ssbingo/samba-solar-track/hardware/RearCircuitBoard_10/vorschau/RearCircuitBoard_10-schraeg.png

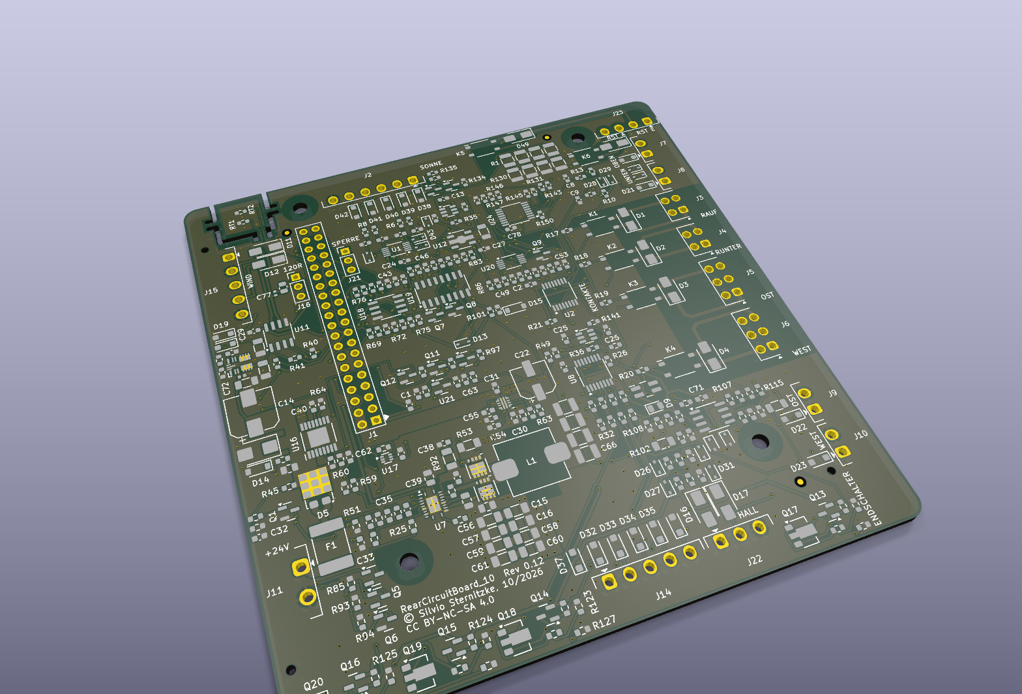
hardware/RearCircuitBoard_10/vorschau/RearCircuitBoard_10-schraeg.png
