ssbingo/samba-solar-track/hardware/HallTapBoard/vorschau/HallTapBoard-unten.png

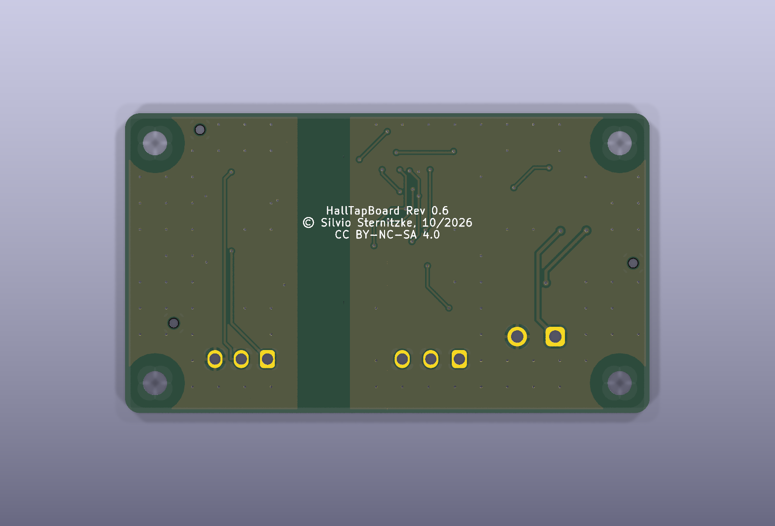
hardware/HallTapBoard/vorschau/HallTapBoard-unten.png
