ssbingo/samba-solar-track/hardware/RearCircuitBoard_10/fertigung/smd/RearCircuitBoard_10-selbst-bestellen.md

# RearCircuitBoard_10 - selbst zu bestellende Teile (Bestückungsvariante smd)

Platine Entwurf 0.12; erzeugt am 09.11.2026 20:07 mit tools/fertigung_export.py. Alles, was JLCPCB in der Variante smd nicht bestückt: Durchsteckteile (aus der Platine gezählt), die Stecker zu jeder Klemme, Steckbrücken, J1 und die Mechanik. JLCPCB liefert keine losen Teile mit; bei LCSC bestellen und mit dem JLCPCB-Auftrag zusammenlegen, oder bei einem Händler mit Lieferung an Privatkunden (Alternative je Zeile; deren Preise brutto, abgerufen am 7.10.2026, wenn nicht anders genannt). Mengen je Platine; bei LCSC gilt die Mindestmenge.

| Bezeichner | Menge je Platine | Typ | Hersteller-Nr. | LCSC-Nr. | Bezugsquelle und Preis | Hinweis |
|---|---|---|---|---|---|---|
| J2 | 1 | Grundleiste (Durchsteckteil) | KF2EDGR-3.5-6P | C441175 | LCSC/JLCPCB 0,1610 USD je Stück (JLCPCB-Teilebibliothek, abgefragt am 05.11.2026 05:26; Bestand 2487, Mindestmenge 2); Alternative: Reichelt MC 6 G 3,5 (Phoenix 1844252), 1,50 € | Nur Variante smd: von Hand einlöten (in der Variante voll lötet JLCPCB). |
| J3, J4 | 2 | Grundleiste (Durchsteckteil) | KF2EDGSR-3.5-2*2P | C2923260 | LCSC/JLCPCB 0,5806 USD je Stück (JLCPCB-Teilebibliothek, abgefragt am 05.11.2026 05:26; Bestand 773, Mindestmenge 2); Alternative: DigiKey DMC 1,5/2-G1-3,5 P20THR (Phoenix 1786837), 1,23 € netto | Nur Variante smd: von Hand einlöten (in der Variante voll lötet JLCPCB). |
| J5, J6 | 2 | Grundleiste (Durchsteckteil) | KF2EDGSR-3.5-2*3P | C2923261 | LCSC/JLCPCB 0,8390 USD je Stück (JLCPCB-Teilebibliothek, abgefragt am 05.11.2026 05:26; Bestand 1289, Mindestmenge 2); Alternative: DigiKey DMC 1,5/3-G1-3,5 P20THR (Phoenix 1786840), 1,91 € (Annahme netto); Bürklin 62P6910, 2,38 € | Nur Variante smd: von Hand einlöten (in der Variante voll lötet JLCPCB). |
| J7, J8, J9, J10 | 4 | Grundleiste (Durchsteckteil) | KF2EDGR-3.5-2P | C441171 | LCSC/JLCPCB 0,0501 USD je Stück (JLCPCB-Teilebibliothek, abgefragt am 05.11.2026 05:26; Bestand 6160, Mindestmenge 2); Alternative: Reichelt MC 2 G 3,5 (Phoenix 1844210), 0,58 € | Nur Variante smd: von Hand einlöten (in der Variante voll lötet JLCPCB). |
| J11 | 1 | Grundleiste (Durchsteckteil) | KF2EDGRC-5.08-2P | C441236 | LCSC/JLCPCB 0,0596 USD je Stück (JLCPCB-Teilebibliothek, abgefragt am 05.11.2026 05:26; Bestand 19010, Mindestmenge 2); Alternative: Reichelt MSTBA 2-G 5,08 (Phoenix 1757242), 0,60 € | Nur Variante smd: von Hand einlöten (in der Variante voll lötet JLCPCB). |
| J14 | 1 | Grundleiste (Durchsteckteil) | KF2EDGR-3.5-5P | C441174 | LCSC/JLCPCB 0,1263 USD je Stück (JLCPCB-Teilebibliothek, abgefragt am 05.11.2026 05:26; Bestand 3099, Mindestmenge 2); Alternative: Reichelt MC 5 G 3,5 (Phoenix 1844249), 1,25 € | Nur Variante smd: von Hand einlöten (in der Variante voll lötet JLCPCB). |
| J15 | 1 | Grundleiste (Durchsteckteil) | KF2EDGR-3.81-5P | C441185 | LCSC/JLCPCB 0,1469 USD je Stück (JLCPCB-Teilebibliothek, abgefragt am 05.11.2026 05:26; Bestand 4801, Mindestmenge 2); Alternative: Reichelt MC 5 G 3,81 (Phoenix MC 1,5/ 5-G-3,81), Preis offen | Nur Variante smd: von Hand einlöten (in der Variante voll lötet JLCPCB). |
| J16, J21 | 2 | Stiftleiste 1 x 3, Raster 2,54 mm | PZ254V-11-03P | C2937625 | LCSC/JLCPCB 0,0198 USD je Stück (JLCPCB-Teilebibliothek, abgefragt am 05.11.2026 05:26; Bestand 716137, Mindestmenge 2); Alternative: Reichelt MPE 087-1-003, 0,09 € | Nur Variante smd: von Hand einlöten (in der Variante voll lötet JLCPCB). |
| J22 | 1 | Grundleiste (Durchsteckteil) | KF2EDGR-3.5-3P | C441172 | LCSC/JLCPCB 0,0756 USD je Stück (LCSC-Produktseite, abgefragt am 09.11.2026 20:05; Bestand 10675, Mindestmenge 5); Alternative: Reichelt MC 3 G 3,5 (Phoenix 1844223), 0,87 € | Nur Variante smd: von Hand einlöten (in der Variante voll lötet JLCPCB). |
| J23 | 1 | Grundleiste (Durchsteckteil) | KF2EDGR-3.5-4P | C441173 | LCSC/JLCPCB 0,1110 USD je Stück (LCSC-Produktseite, abgefragt am 09.11.2026 20:05; Bestand 9055, Mindestmenge 5); Alternative: Reichelt MC 4 G 3,5 (Phoenix 1844236), 0,99 € (abgerufen 09.11.2026) | Nur Variante smd: von Hand einlöten (in der Variante voll lötet JLCPCB). |
| J7, J8, J9, J10 (Stecker) | 4 | Stecker mit Schraubanschluss | KF2EDGK-3.5-2P | C440847 | LCSC/JLCPCB 0,2136 USD je Stück (JLCPCB-Teilebibliothek, abgefragt am 05.11.2026 05:26; Bestand 10380, Mindestmenge 2); Alternative: Reichelt MC 2 ST 3,5 (Phoenix 1840366), 1,40 € | Lose zur Grundleiste KF2EDGR-3.5-2P. |
| J22 (Stecker) | 1 | Stecker mit Schraubanschluss | KF2EDGK-3.5-3P | C440848 | LCSC/JLCPCB 0,2877 USD je Stück (JLCPCB-Teilebibliothek, abgefragt am 05.11.2026 05:26; Bestand 7772, Mindestmenge 2); Alternative: Reichelt MC 3 ST 3,5 (Phoenix 1840379), 1,99 € | Lose zur Grundleiste KF2EDGR-3.5-3P. Gegenstück zum Kabel vom HallTapBoard; ohne Hall-Abgriff bleibt J22 frei. |
| J23 (Stecker) | 1 | Stecker mit Schraubanschluss | KF2EDGK-3.5-4P | C440849 | LCSC/JLCPCB 0,4128 USD je Stück (LCSC-Produktseite, abgefragt am 09.11.2026 20:05; Bestand 14175, Mindestmenge 1); Alternative: Reichelt MC 4 ST 3,5 (Phoenix 1840382), 2,65 € (abgerufen 09.11.2026) | Lose zur Grundleiste KF2EDGR-3.5-4P. |
| J14 (Stecker) | 1 | Stecker mit Schraubanschluss | KF2EDGK-3.5-5P | C440850 | LCSC/JLCPCB 0,4678 USD je Stück (JLCPCB-Teilebibliothek, abgefragt am 05.11.2026 05:26; Bestand 1174, Mindestmenge 5); Alternative: Reichelt MC 5 ST 3,5 (Phoenix 1840395), 3,45 € | Lose zur Grundleiste KF2EDGR-3.5-5P. |
| J2 (Stecker) | 1 | Stecker mit Schraubanschluss | KF2EDGK-3.5-6P | C440851 | LCSC/JLCPCB 0,5364 USD je Stück (JLCPCB-Teilebibliothek, abgefragt am 05.11.2026 05:26; Bestand 845, Mindestmenge 2); Alternative: Reichelt MC 6 ST 3,5 (Phoenix 1840405), 3,99 € | Lose zur Grundleiste KF2EDGR-3.5-6P. |
| J15 (Stecker) | 1 | Stecker mit Schraubanschluss | KF2EDGK-3.81-5P | C440861 | LCSC/JLCPCB 0,3459 USD je Stück (JLCPCB-Teilebibliothek, abgefragt am 05.11.2026 05:26; Bestand 5082, Mindestmenge 2); Alternative: Reichelt MC 5 ST 3,81 (Phoenix MC 1,5/ 5-ST-3,81), Preis offen | Lose zur Grundleiste KF2EDGR-3.81-5P. |
| J11 (Stecker) | 1 | Stecker mit Schraubanschluss | KF2EDGK-5.08-2P-AA | C440880 | LCSC/JLCPCB 0,1561 USD je Stück (JLCPCB-Teilebibliothek, abgefragt am 05.11.2026 05:26; Bestand 53206, Mindestmenge 2); Alternative: Reichelt MSTB 2-ST 5,08 (Phoenix 1757019), 1,40 € | Lose zur Grundleiste KF2EDGRC-5.08-2P. ANNAHME: Stecker KF2EDGK-5.08-2P-AA (C440880) zur Grundleiste KF2EDGRC-5.08-2P von J11 - Paarung laut Datenblatt nicht belegt, am Muster prüfen (P15). |
| J3, J4 (Stecker) | 2 | Stecker mit Federanschluss | KF2EDGKS-3.5-2*2P | C2923215 | LCSC/JLCPCB 0,7883 USD je Stück (JLCPCB-Teilebibliothek, abgefragt am 05.11.2026 05:26; Bestand 44, Mindestmenge 2); Alternative: DigiKey DFMC 1,5/2-ST-3,5 (Phoenix 1790108), 2,68 € (Annahme netto); Bürklin 62P6731, 3,43 € | Lose zur Grundleiste KF2EDGSR-3.5-2*2P. |
| J5, J6 (Stecker) | 2 | Stecker mit Federanschluss | KF2EDGKS-3.5-2*3P | C2923216 | LCSC/JLCPCB 1,1889 USD je Stück (JLCPCB-Teilebibliothek, abgefragt am 05.11.2026 05:26; Bestand 657); Alternative: DigiKey DFMC 1,5/3-ST-3,5 (Phoenix 1790111), 4,18 € (Annahme netto); Bürklin 62P6743, 5,13 € | Lose zur Grundleiste KF2EDGSR-3.5-2*3P. |
| J16, J21 | 2 | Steckbrücke 2,54 mm | – | C5305 | LCSC/JLCPCB 0,0098 USD je Stück (JLCPCB-Teilebibliothek, abgefragt am 05.11.2026 05:26; Bestand 906436, Mindestmenge 2); Alternative: Reichelt JUMPER 2,54 SW, 0,02 € | J16: 1-2 = Abschluss ein, 2-3 = aus; J21: 2-3 = Betrieb, 1-2 = Ladesperre erzwingen. |
| J1 | 1 | Stiftleiste 1 x 40, lange Stifte 21 mm (Steckseite 15,5 mm, Träger 2,5 mm) | BOOMELE 21 mm | C51353 | LCSC/JLCPCB 0,2893 USD je Stück (JLCPCB-Teilebibliothek, abgefragt am 05.11.2026 05:26; Bestand 2430, Mindestmenge 2); Alternative: Reichelt ECON SL40G1F (17,8 mm gesamt, Maß über der Platine nicht belegt), 0,85 € | In 2 x 1 x 20 schneiden. Einstecktiefe in J8 ohne Scheiben auf den Bolzen (13,9 mm) 3,0-3,2 mm, mit einer Scheibe je Bolzen 2,5-2,7 mm (Lage von J8 mit Passprobe geprüft am 06.11.2026, Rechnung; Tiefe von J8 Annahme). Erst nach der Prüfung beim ersten Aufbau einlöten (README). Alternativen 15 mm (C52461) und 17 mm (C44526) siehe README. |
| Wärmeweg NTC-Insel | 1 | Distanzbolzen Messing M3, SW 4,7, Innen-/Innengewinde, 13 mm | Shuntian 13 mm | C551333 | LCSC/JLCPCB 0,0478 USD je Stück (JLCPCB-Teilebibliothek, abgefragt am 05.11.2026 05:26; Bestand 718, Mindestmenge 5); Alternative: Reichelt ECON D3X08I5MT (8 mm, SW 5; für 13 mm kein Ersatz belegt), 0,11 € | Option (E31, Entscheidung beim ersten Aufbau): bei 13,9 mm Spalt mit zwei Pads 0,5 mm, Pressung 10 %; bei 14,9 mm (zwei Scheiben je Bolzen) mit Pads 1,0 + 1,5 mm, Pressung 24 %; bei 8,2-10 mm Spalt 6 mm (C551326) oder 8 mm (C551328). |
| Wärmeweg NTC-Insel (Option) | 1 | Distanzbolzen Messing M3, Innen-/Innengewinde, 12 mm (Annahme wie C551333) | Shuntian M3*12 | C551332 (nur LCSC; Option, nicht in der BOM-Datei für LCSC) | LCSC 0,0447 USD je Stück ab 10 Stück (LCSC-Produktseite, abgefragt am 06.11.2026 10:59 CET; Bestand 370, Mindestmenge 10; nicht in der JLCPCB-Teilebibliothek); Alternative: Reichelt ECON D3X12I5MT (12 mm, Innen/Innen, SW 5), 0,20 €, ab Lager (abgerufen 06.11.2026 11:00 CET) | Option (E31, Entscheidung beim ersten Aufbau): bei 13,9 mm Spalt mit Pads 1,0 + 1,5 mm, Pressung 24 %. Laut LCSC dieselbe Reihe wie C551333 (Hollow PCBA Hex Standoff, Messing); Schlüsselweite 4,7 mm Annahme. |
| Wärmeweg NTC-Insel (Option) | 2 | Wärmeleitpad 6 x 6 x 0,5 mm, Silikon, isolierend | Thermal Grizzly Minus Pad 8 TG-MP8-30-30-05-1R (30 x 30 x 0,5 mm, zuschneiden) | – | Reichelt Art.-Nr. TG-MP8-30-05-1 (Hersteller-Nr. TG-MP8-30-30-05-1R), 3,50 € je Pad 30 x 30 mm, ab Lager (abgerufen 06.11.2026; reicht für alle Platinen) | Kein JLCPCB-Teil (E31). Option: zwei Stück zum Bolzen 13 mm bei 13,9 mm Spalt (Entscheidung beim ersten Aufbau). |
| Wärmeweg NTC-Insel | 1 | Wärmeleitpad 6 x 6 x 1,0 mm, Silikon, isolierend | Thermal Grizzly Minus Pad 8 TG-MP8-30-30-10-1R (30 x 30 x 1,0 mm, zuschneiden) | – | Reichelt Art.-Nr. TG-MP8-30-1-1 (Hersteller-Nr. TG-MP8-30-30-10-1R), 3,35 € je Pad 30 x 30 mm, ab Lager (abgerufen 06.11.2026; reicht für alle Platinen); Alternate 2,90 € | Kein JLCPCB-Teil (E31). Option: zusammen mit dem Pad 1,5 mm zum Bolzen 12 mm bei 13,9 mm Spalt oder zum Bolzen 13 mm bei 14,9 mm (Entscheidung beim ersten Aufbau, README). |
| Wärmeweg NTC-Insel | 1 | Wärmeleitpad 6 x 6 x 1,5 mm, Silikon, isolierend | Thermal Grizzly Minus Pad 8 TG-MP8-30-30-15-1R (30 x 30 x 1,5 mm, zuschneiden) | – | Reichelt Art.-Nr. TG-MP8-30-15-1 (Hersteller-Nr. TG-MP8-30-30-15-1R), 3,45 € je Pad 30 x 30 mm, Lieferzeit 3-5 Werktage (abgerufen 06.11.2026; reicht für alle Platinen) | Kein JLCPCB-Teil (E31). Option: zusammen mit dem Pad 1,0 mm (Entscheidung beim ersten Aufbau, README). |
| Befestigung | 4 | Abstandsbolzen M2,5 Außen-/Innengewinde, Messing, SW 4,6, 12 + 6 mm | XHHD DTTZ4309 | C50377852 | LCSC/JLCPCB 0,0521 USD je Stück (JLCPCB-Teilebibliothek, abgefragt am 05.11.2026 05:26; Bestand 1513, Mindestmenge 2); Alternative: Amazon.de B0C1FY87PY (Messing-Sortiment, 14,99 € am 28.10.2026, Inhalt nicht geprüft) | Mit Mutter M2,5 ohne Scheibe auf dem Außengewinde voll eingedreht: gemessen 13,9 mm Rückwand (außen) bis Platinenunterseite (Nutzer, 05.11.2026); mit 1 bzw. 2 Scheiben 14,4 bzw. 14,9 mm (Entscheidung beim ersten Aufbau). Die Mutter gehört zur Montage am Board, nicht zur Platine (README). Gewindetiefe innen nicht belegt (Annahme: mindestens 3,2 mm; für M2,5 x 6 ohne Scheiben auf den Bolzen etwa 4,2 mm). |
| Befestigung | 4 | Schraube M2,5 x 6, Linsenkopf Kreuzschlitz, Kopf 4,5 mm, Stahl vernickelt | PM2.5X6nie | C357395 | LCSC 0,0022 USD je Stück (LCSC-Produktseite, abgefragt am 05.11.2026 17:22 CET; Bestand 12100, Mindestmenge 100; nicht in der JLCPCB-Teilebibliothek); Alternative: Kessler SZKM2,5X6MM (Beutel 100), 4,29 € (README) | Ersetzt M2,5 x 4 (C357536). Eingriff in den Bolzen 6 - 0,5 - 1,6 = 3,9 mm ohne Scheiben auf den Bolzen, 3,4 mm mit einer, 2,9 mm mit zwei je Bolzen; ohne Scheiben nur bei ausreichender Gewindetiefe (Annahme, beim ersten Aufbau messen), sonst M2,5 x 5 (Nummer offen). |
| Befestigung | 4 | Unterlegscheibe M2,5 DIN 433 (2,7 x 5 x 0,5 mm), unter dem Schraubenkopf | – | – | LCSC offen (in der JLCPCB-Teilebibliothek am 05.11.2026 17:49 CET keine DIN 433 M2,5); belegt nur für Geschäftskunden: Bürklin 16H912 (by.B BYB-3-16H912, DIN 433/ISO 7092, 2,7 x 5 x 0,5 mm, Stahl verzinkt), 0,0202 € netto je Stück, Bestand 5505 (05.11.2026; laut Bürklin nicht an Privatkunden); Alternative mit Lieferung an Privatkunden offen (keine mit Beleg gefunden) | Unter den Schraubenkopf auf der Platine (README, Befestigung); DIN 433 statt DIN 125 (Entscheidung 05.11.2026). |
| Befestigung | 8 | Unterlegscheibe M2,5 DIN 433 (2,7 x 5 x 0,5 mm), zwischen Bolzen und Platinenunterseite | – | – | LCSC offen (in der JLCPCB-Teilebibliothek am 05.11.2026 17:49 CET keine DIN 433 M2,5); belegt nur für Geschäftskunden: Bürklin 16H912 (by.B BYB-3-16H912, DIN 433/ISO 7092, 2,7 x 5 x 0,5 mm, Stahl verzinkt), 0,0202 € netto je Stück, Bestand 5505 (05.11.2026; laut Bürklin nicht an Privatkunden); Alternative mit Lieferung an Privatkunden offen (keine mit Beleg gefunden) | Nur falls nötig (Prüfung beim ersten Aufbau, README): je Bolzen 0, 1 oder 2 Stück oben auf den Bolzen, je Scheibe 0,5 mm höher (13,9 / 14,4 / 14,9 mm); Menge hier höchstens. DIN 433 (außen 5 mm) bleibt auch mit Lochspiel im kupferfreien Kreis 6,5 mm. |

Summe der Zeilen mit belegtem LCSC/JLCPCB-Preis: etwa 11,35 USD je Platine netto (ohne Mindestmengen, Versand und die Zeilen mit Preis „offen“; Schätzung).

Am sichersten passen Stecker und Grundleiste desselben Herstellers; dass Phoenix-Stecker in Kefa-Grundleisten passen, ist eine Annahme (hardware/RearCircuitBoard_10/STECKER-BESTELLLISTE.md, README).

© Silvio Sternitzke, 10/2026 - Samba Solar Track - Lizenz CC BY-NC-SA 4.0: keine kommerzielle Verwendung durch Dritte, privater Nachbau erlaubt
