ssbingo/samba-solar-track/handbuch/Samba-Solar-Track-Handbuch-10Zoll-FR.pdf

© Silvio Sternitzke, 10/2026 · Samba Solar Track · Licence CC BY-NC-SA 4.0 · aucune utilisation commerciale par des tiers

MANUEL · VERSION 10 POUCES · EN PRÉPARATION

# Samba Solar Track

## La commande qui fait suivre le soleil à votre module solaire et le met en sécurité en cas de

tempête.

Waveshare ESP32-P4-WIFI6-Touch-LCD-10.1 avec la carte RearCircuitBoard_10
La variante principale de Samba Solar Track. Ce manuel décrit le montage, la carte, les raccordements, la batterie, le premier chargement du firmware et le contrôle du matériel. Le firmware pour cette carte est commencé et chargé sur une carte de test (il démarre, le Wi-Fi fonctionne), mais n’est pas encore testé sur l’appareil par ailleurs ; la carte existe sous forme de projet 0.12 et n’est ni fabriquée ni mesurée.

© Silvio Sternitzke, 10/2026 · Licence CC BY-NC-SA 4.0 · aucune utilisation commerciale par des tiers

## Samba Solar Track

Manuel · version 10 pouces

DE | EN | FR | ES | NL | PT | PL

SOMMAIRE
1 | Qu’est-ce que Samba Solar Track ? | 2 | La sécurité d’abord
3 | Ce dont vous avez besoin | 4 | Le capteur solaire
5 | La carte RearCircuitBoard_10 | 6 | Raccordement et câblage
7 | La batterie et le blocage de charge | 8 | Logiciel et utilisation (en préparation)
9 | Première mise en service du matériel | 10 | Les termes expliqués simplement
11 | Annexe | 12 | Licence et copyright

### 13 Historique des modifications

En préparation : merci de ne pas encore la reproduire
Tout ce manuel est un projet. La carte RearCircuitBoard_10 (projet 0.12, état du 9 novembre 2026) n’a été vérifiée que sur ordinateur : les contrôles de règles de KiCad ne signalent aucune erreur, les données de fabrication pour JLCPCB sont prêtes. Rien n’a été fabriqué, monté ni mesuré ; toutes les valeurs sont calculées ou reprises des fiches techniques. Les dimensions de la paroi arrière sont des hypothèses tant que l’appareil n’a pas été mesuré. Avant toute commande, il faut effectuer des mesures sur la carte livrée (annexe 11 E). Il n’existe pas encore de firmware permettant à la carte 10,1 pouces de commander un tracker ; il est commencé (chapitre 8).

🧩

# 1 Qu’est-ce que Samba Solar Track ?

Un module solaire fournit le plus de courant lorsque le soleil l’éclaire perpendiculairement. Samba Solar Track fait pivoter et incline le module tout au long de la journée pour que ce soit le cas le plus souvent possible, et le met à plat en cas de tempête.

☀️

Suit le soleil

Un capteur à quatre
cellules de lumière
détecte la position du
soleil. Deux vérins
orientent le module en
conséquence.

️

Protège en cas
de tempête

Un anémomètre
surveille le vent. En
cas de tempête, le
module se met à plat
et y reste jusqu’au
retour du calme.

️

Grand écran

L’écran tactile de 10,1
pouces est l’appareil
principal. Une batterie
intégrée le maintient
en marche en cas de
coupure des 24 V.

️

Ménage la
mécanique

Des fins de course, des
pauses lors des
changements de sens
et une surveillance de
la durée de course
évitent les dommages.

## Les éléments du système

ESP32-P4-WIFI6-Touch-LCD-10.1
Écran, tactile, calculateur de commande, Wi-Fi Batterie 3,7 V avec chargeur sur la carte

Barrette J1 dans le connecteur J8 : I2C, 3,3 V, 5 V, UART

RearCircuitBoard_10

ADS1115
mesure lumière

PCA9538
Entrées/sorties

RS485
Anémomètre

Régulateur
24 V → 5 V

Arrêt charge
10–35 °C

Surveillance
ADS1115 0x49

### 4 contacts

secs (isolés)

Capteur solaire
4 cellules de lumière

### 4 fins de course

signalent la butée

Anémomètre
RS485, Modbus

Alimentation 24 V
Rack : deux séparées

Pilotage vérins
Contrôleur ou relais

Élévation
haut / bas

Azimut
Est / Ouest plus deux voyants : BEREIT (prêt) et FAIL

La carte est fixée à l’extérieur sur la paroi arrière du boîtier métallique ; il n’y a pas de câble vers la carte de l’écran.

Fig. 1 – Vue d’ensemble du système de la version 10 pouces. Jaune : capteurs. Bleu : le calculateur de commande. Vert : tout ce qui déplace le module. Sur le rack, deux alimentations séparées de 24 V alimentent la commande des vérins (HLG-600H-24 sur le rack près du coffret de commande, aussi pour le HallTapBoard) et la carte RearCircuitBoard_10 (petite alimentation près de la tablette) ; la carte alimente la carte de l’écran et sa batterie en 5 V. Une alimentation commune reste admise comme variante (chapitre 6, Fig. 6).

## Les deux axes

Le module se déplace dans deux directions. L’élévation est l’inclinaison : le matin et le soir, le soleil est bas, à midi il est haut. L’azimut est la rotation d’est en ouest, qui suit la course du soleil dans le ciel.

Vue de côté : élévation

Vérin linéaire

PLUS RAIDE

PLUS PLAT

Vue de dessus : azimut

OUEST | EST

Nord

Sud (le module regarde dans cette direction)

Fig. 2 – Schéma de principe des deux axes. Votre mécanique peut être différente. Seul compte : un vérin linéaire par axe, capable de se déplacer dans les deux sens.

# 2 La sécurité d’abord

La commande déplace des pièces lourdes avec des vérins puissants et possède une batterie. Lisez ces points avant de raccorder quoi que ce soit.

Un ou deux axes ?
Samba Solar Track existe en deux modes de fonctionnement : vertical uniquement (un axe, l’élévation) ou tracker complet avec élévation et azimut. Le mode est choisi sur l’écran lors de la première mise en marche (en préparation, voir chapitre 8).

ℹ️

Risque d’écrasement
Un vérin linéaire pousse avec plusieurs centaines de newtons et ne s’arrête pas si une main se trouve sur son chemin. Ne travaillez sur la mécanique que lorsque l’alimentation 24 V est coupée (avec deux alimentations : celle des vérins). L’automatique peut démarrer d’elle-même à tout moment.

⛔

À quoi sert la carte
La carte RearCircuitBoard_10 est une carte d’extension pour Samba Solar Track. Seule, elle n’a aucune fonction. Elle nécessite une carte Waveshare compatible avec écran (pour la carte RearCircuitBoard_10, l’ESP32-P4-WIFI6-Touch-LCD-10.1), une alimentation externe en courant continu 24 V ainsi que des capteurs et des vérins. Ceux-ci ne font pas partie de la carte (non fournis). La carte elle-même n’est alimentée qu’en 24 V. Les vérins peuvent fonctionner en 12 ou 24 V, tant que chaque contact de commutation ne reçoit pas plus de 30 V et 1 A (chapitre 6).

ℹ️

Uniquement très basse tension de sécurité, jamais la tension secteur
La carte RearCircuitBoard_10 est destinée exclusivement à la très basse tension de sécurité (TBTS/SELV) : aucune de ses bornes ne doit recevoir plus de 30 V en courant continu. La commande reçoit 24 V continu, les vérins fonctionnent typiquement en 12 ou 24 V. La tension secteur (230 V) ne doit jamais être reliée à la carte, à ses borniers ou à ses contacts de commutation. Les contacts de commutation (PhotoMOS) ne sont pas des relais secteur : ils commutent des signaux de commande et des bobines de relais jusqu’à 30 V et 1 A, mais aucun moteur ni appareil raccordé au réseau électrique. L’alimentation qui transforme le 230 V en 24 V est un appareil acheté tout fait, avec une sortie homologuée SELV (vérifier dans la fiche technique) ; avec deux alimentations, cela vaut pour les deux. Les travaux sur le 230 V sont réservés à un électricien qualifié.

⛔

Souder et raccorder soi-même : remarque sur la responsabilité
Dans la variante d’assemblage « smd », vous soudez vous-même les borniers, les barrettes J16 et J21 et la barrette J1 ; dans la variante « voll » (complète), seulement J1 (annexe 11 B). Vous raccordez ensuite vous-même l’alimentation, les capteurs et les vérins. Aucune responsabilité n’est assumée pour les dommages dus à un soudage incorrect, une inversion de polarité ou un mauvais raccordement de composants externes, dans la mesure permise par la loi. La responsabilité que la loi ne permet pas d’exclure (par exemple en cas de faute intentionnelle, de négligence grave ou en vertu de la loi sur la responsabilité du fait des produits) n’en est pas affectée. Ceci est une remarque, pas un conseil juridique.

⚠️

Installer un fusible
Placez dans le fil positif de chaque vérin un fusible adapté au vérin (valeur indiquée dans sa fiche technique). Un moteur bloqué consomme plusieurs fois son courant normal. Sur l’alimentation commune, chaque ligne reçoit son propre fusible directement à l’alimentation : 25 A pour les vérins, 2 A pour la commande (chapitre 6).

⚠️

La protection tempête ne remplace pas une construction solide
La commande met le module à plat, mais elle ne peut pas compenser une coupure de courant. Elle détecte un anémomètre qui ne répond plus du tout. Elle ne détecte pas un anémomètre qui fournit des valeurs fausses (par exemple une roue à coupelles bloquée). La mécanique doit résister à une tempête même dans une position défavorable.

⚠️

Ce que la commande sécurise pour vous
À chaque défaut, tous les contacts de commutation s’ouvrent, les vérins s’arrêtent. Un câble de fin de course rompu agit comme une butée atteinte. Si l’anémomètre ne répond plus, l’automatique met le module à plat par précaution. La tempête a priorité sur tout, même sur vos doigts sur l’écran. Le firmware pour la carte 10,1 pouces qui réalise cela est en préparation (chapitre 8).

💡

Batterie uniquement avec un firmware qui contrôle le blocage – à vos risques La carte 10,1 pouces possède une batterie (3,7 V). Son chargeur sur la carte ne contrôle pas la température. La carte RearCircuitBoard_10 bloque donc elle-même la charge lorsqu’il fait plus froid que 10 °C ou plus chaud que 35 °C au niveau de la paroi arrière (chapitre 7). Comme quelques rares défauts de soudure peuvent supprimer ce blocage sans que l’on s’en aperçoive, le firmware contrôle depuis le 3.11.2026 le blocage en permanence et avertit dans l'en-tête (chapitre 8). Avec ce firmware, vous pouvez brancher la batterie (décision du 3.11.2026) ; mais le blocage matériel n'a pas encore été mesuré sur un appareil fabriqué, et le firmware ne peut pas empêcher lui-même la charge. Le risque est le vôtre. Faites d'abord le test au froid et à la chaleur du chapitre 9.

⛔

Alimentation 24 V, jamais durablement au-dessus de 30 V
Utilisez une alimentation de 24 V continu avec un écart de 5 % au maximum (soit 22,8 à 25,2 V) ; réglez une alimentation réglable sur 24,0 V. La carte absorbe les brèves pointes de tension, mais pas une tension durable supérieure à 30 V : la diode de protection D6 conduit alors et est détruite au-delà d’environ 33 V, le plus souvent en court-circuit ; elle protège ainsi le reste de la carte. Le fusible F1 ne se déclenche pas de façon sûre avec une alimentation à limitation de courant. D6 doit ensuite être remplacée.

⚠️

Lieu d’installation sec, pas au-dessus de 3050 m
N’installez la commande que dans un endroit sec où aucune condensation ne peut se former sur la carte, et pas à plus de 3050 m d’altitude. La carte de l’écran elle-même est spécifiée de 0 à 60 °C. Le couvercle du boîtier doit être difficilement inflammable (UL94 V-0).

⚠️

# 3 Ce dont vous avez besoin

L’électronique se compose de la carte d’écran toute faite et de la carte maison RearCircuitBoard_10, fixée sur sa paroi arrière.

ÉLÉMENT | RÔLE | REMARQUE

Waveshare ESP32-P4-
WIFI6-Touch-LCD-10.1

Écran, tactile,
calculateur de
commande, Wi-Fi

Exactement ce modèle (1280 × 800, en boîtier métallique, avec batterie 3,7 V). Rien n’est modifié sur la carte ni sur la batterie.

RearCircuitBoard_10 Alimentation, mesure, sorties de
commutation,
raccordement de
l’anémomètre,
blocage de charge

Carte maison, fabriquée et assemblée par JLCPCB (chapitre 5, nomenclature en annexe).

Capteur solaire | Détecte la position du soleil | Imposé : détecteur de suiveur solaire acheté tout fait, avec quatre sorties analogiques et 3 m de câble. Pas de fabrication maison (chapitre 4).
Anémomètre avec sortie RS485 | Mesure le vent | Imposé : RS485 (Modbus-RTU), vitesse du vent seule ou vitesse et direction du vent. Les autres sorties (impulsion, 0–10 V, 4–20 mA) ne fonctionnent pas.
Vérins linéaires | Déplacent le module | Avec contrôleur et entrée pour boutons ou avec deux relais de puissance par axe (chapitre 6). Obligatoire : fins de course propres dans le circuit moteur.
4 fins de course | Signalent les butées | Avec contact à ouverture (NC)
Alimentations 24 V continu | Seule alimentation de la commande ; sur le rack, une seconde pour les vérins | 24 V ± 5 %. Sur le rack, deux alimentations séparées : Mean Well HLG-600H-24 (IP67, 600 W / 25 A) sur le rack pour la commande synchrone, les vérins et le HallTapBoard, et une petite alimentation (SELV, 2 A ou plus) près de la tablette uniquement pour la commande (chapitre 6). La carte en tire 5 V pour la carte de l’écran et la batterie ; vous n’avez pas besoin de bloc d’alimentation USB. Une alimentation commune pour tout reste autorisée comme variante.
Câbles et fusibles | De l’alimentation aux vérins, à la commande et au HallTapBoard | Pour chaque départ, une ligne propre avec son propre fusible à l’alimentation : vérins à partir de 4 mm² avec 25 A, commande 2 × 1,5 mm² jusqu’à 15 m avec 2 A.
2 voyants pour le boîtier (facultatif) | Indiquent de l’extérieur si tout fonctionne | Une LED verte et une LED RVB à anode commune, toutes deux sans résistance série intégrée.
Boîtier arrière imprimé en 3D | Couvre la carte | Conception maison dans le dossier cover/ du projet, pas plus grand que l’écran, profond de 50 mm ou 40 mm (au choix), avec 6 perçages pour presse-étoupes PG 11 sur la face inférieure.

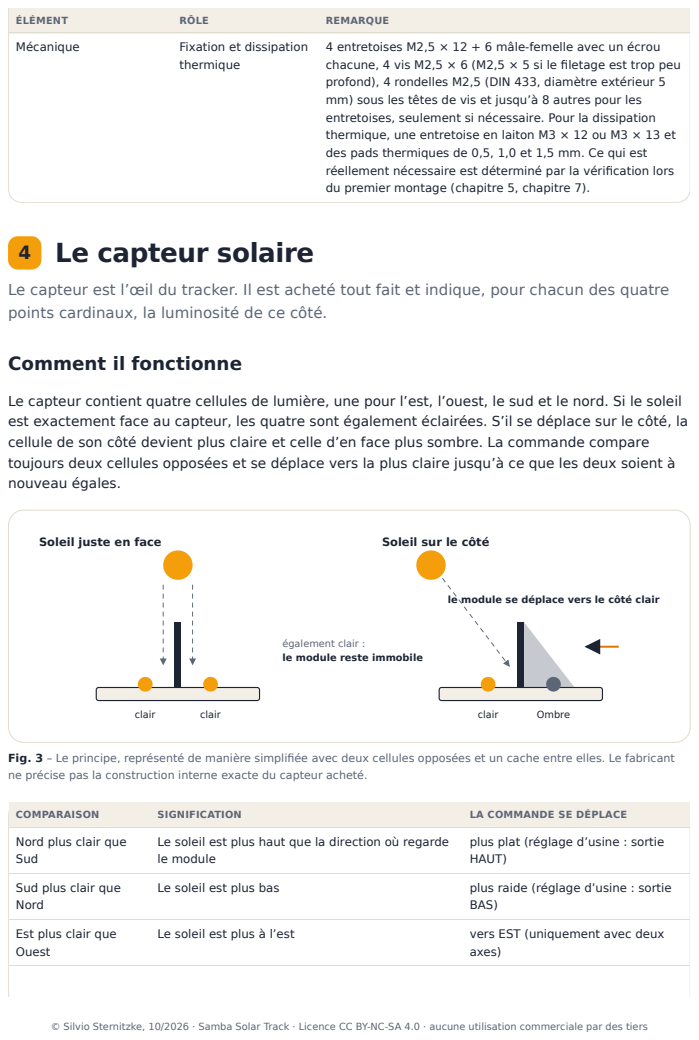
[picture p24: page 8]
ÉLÉMENT; RÔLE; REMARQUE; Mécanique; Fixation et dissipation; thermique; clair; Ombre; COMPARAISON; SIGNIFICATION; LA COMMANDE SE DÉPLACE; Le soleil est plus bas; plus raide (réglage d’usine : sortie; BAS); Le soleil est plus à l’est; vers EST (uniquement avec deux; axes)

4 entretoises M2,5 × 12 + 6 mâle-femelle avec un écrou
chacune, 4 vis M2,5 × 6 (M2,5 × 5 si le filetage est trop peu
profond), 4 rondelles M2,5 (DIN 433, diamètre extérieur 5
mm) sous les têtes de vis et jusqu’à 8 autres pour les
entretoises, seulement si nécessaire. Pour la dissipation
thermique, une entretoise en laiton M3 × 12 ou M3 × 13 et
des pads thermiques de 0,5, 1,0 et 1,5 mm. Ce qui est
réellement nécessaire est déterminé par la vérification lors
du premier montage (chapitre 5, chapitre 7).

4 Le capteur solaire

Le capteur est l’œil du tracker. Il est acheté tout fait et indique, pour chacun des quatre
points cardinaux, la luminosité de ce côté.

Comment il fonctionne

Le capteur contient quatre cellules de lumière, une pour l’est, l’ouest, le sud et le nord. Si le soleil
est exactement face au capteur, les quatre sont également éclairées. S’il se déplace sur le côté, la
cellule de son côté devient plus claire et celle d’en face plus sombre. La commande compare
toujours deux cellules opposées et se déplace vers la plus claire jusqu’à ce que les deux soient à
nouveau égales.

Soleil juste en face

Soleil sur le côté

le module se déplace vers le côté clair

également clair :
le module reste immobile

Fig. 3 – Le principe, représenté de manière simplifiée avec deux cellules opposées et un cache entre elles. Le fabricant
ne précise pas la construction interne exacte du capteur acheté.

Nord plus clair que
Sud

Le soleil est plus haut que la direction où regarde
le module

plus plat (réglage d’usine : sortie
HAUT)

Sud plus clair que
Nord

Est plus clair que
Ouest

Ouest plus clair que
Est
Le soleil est plus à l’ouest | vers OUEST (uniquement avec deux axes)

## Raccordement et couleurs des fils

Le capteur a un câble de trois mètres à cinq fils : un pour l’alimentation et quatre pour les signaux. Il n’y a pas de fil de masse séparé. Le circuit se referme par quatre petites résistances sur la carte RearCircuitBoard_10. L’alimentation passe par un limiteur de courant, afin qu’un court-circuit dans le long câble ne perturbe pas la commande.

Vue de face (comme le soleil voit le capteur)

NORD (haut)

SUD (bas)

OUEST | EST

Câble, 3 m

noir | Alimentation 3,3 V
rouge | EST → AIN0
blanc | OUEST → AIN1
jaune | SUD → AIN2
vert | NORD → AIN3

Fig. 4 – Le capteur solaire et ses cinq fils. AIN0 à AIN3 sont les entrées du composant de mesure sur la carte RearCircuitBoard_10.

## Montage

### Fixer sur le module

Le capteur est fixé solidement au module et regarde exactement dans la même direction que la surface du module. Il se déplace donc avec le module.

1

### Orienter

Le côté NORD est dirigé vers le bord supérieur du module, le côté EST vers l’est.

2

### Vue dégagée

Rien ne doit projeter d’ombre sur le capteur, pas même le cadre du module ou l’anémomètre.

3

### Poser le câble et raccorder

Amener le câble jusqu’à la commande et raccorder les cinq fils selon la Fig. 4 aux borniers de la carte RearCircuitBoard_10.

4

## Support pour profilé 40 × 40

Pour les bâtis en profilé aluminium 40 × 40, il existe un support adapté pour le capteur solaire. Il ne fait pas partie de Samba Solar Track ; il sera proposé plus tard en plusieurs versions dans la boutique, prochainement comme support fini (sans capteur) à 14,99 €. Sur le Samba-Solar-Rack, le capteur solaire se trouve sur le porte-capteur P15 au-dessus de la traverse centrale P11, au milieu du cadre basculant ; position et cheminement du câble : voir le manuel de câblage.

Fig. 4a – Photo : le capteur solaire sur son support.

Encore à vérifier sur l’appareil
Le fabricant ne fournit qu’un croquis de raccordement. Trois points sont donc des hypothèses : que la sortie d’une direction est la plus élevée lorsque le soleil se trouve dans cette direction ; que NORD correspond au bord supérieur du module ; et quel est le niveau des signaux en plein soleil. La mise en service vérifie ces trois points. Si une direction est incorrecte, elle peut être inversée dans les réglages, sans recâbler.

🧩

Prévu par le fabricant pour son propre contrôleur
Le fabricant indique que le capteur convient surtout à son propre contrôleur. Pour les autres systèmes, il indique exactement le câblage qu’utilise Samba Solar Track : alimentation 3,3 V et 200 Ω vers la masse pour chaque sortie.

ℹ️

# 5 La carte RearCircuitBoard_10

La carte 10,1 pouces est logée dans un boîtier métallique. La carte RearCircuitBoard_10 est fixée à l’extérieur sur sa paroi arrière et reliée à la carte de l’écran par une longue barrette à broches.

La barrette J1 à 40 broches se trouve sur la face inférieure de la carte. Elle passe par une fente de la paroi arrière et s’enfiche dans le connecteur femelle J8 de la carte de l’écran. Par elle passent les données (I2C), le 3,3 V venant de la carte de l’écran, le 5 V vers la carte de l’écran et la liaison vers l’anémomètre. Il n’y a pas de câble entre les deux cartes.

Blindage du câble du capteur
Sur la carte RearCircuitBoard_10, le bornier J2 a un sixième pôle pour le blindage du câble de capteur rallongé. Ne raccorder le blindage qu’à cet endroit, côté commande, pas côté capteur.

ℹ️

Fig. 5 – Ébauche 0.12 de la carte RearCircuitBoard_10 vue de dessus (image du projet KiCad, sans corps de composants). Tous les borniers sont au bord, les câbles partent vers l’extérieur : à droite les fins de course de l’élévation, les quatre sorties de commutation et en dessous les fins de course de l’azimut (plus en haut depuis le 3.11.2026), en haut le capteur solaire, en bas les voyants et à leur droite l’entrée d’impulsions HALL (J22, prévue), à gauche l’anémomètre et le 24 V. Depuis le 3.11.2026, la carte mesure 106 × 110 mm (auparavant 100 × 102 mm) : la marge supplémentaire à droite et en bas porte la protection des fins de course et des voyants contre 24 V ; sous le capteur solaire se trouvent ses diodes de protection, en haut à droite les huit résistances de mesure. Depuis l’ébauche 0.12 (9.11.2026), le bornier J23 pour les contacts de reset de la commande synchrone (« RST E », « RST A ») se trouve en haut à droite, à côté du perçage H2. À côté de chaque bornier sauf J14, la sérigraphie indique son rôle.

## Ce qui se trouve sur la carte

SOUS-ENSEMBLE | CE QU’IL FAIT
Entrée 24 V | Bornier J11, fusible réarmable F1, protection contre l’inversion de polarité D5, protection contre les surtensions D6 et un fusible électronique U16. Il coupe en cas de surcharge au bout de 4 ms et réessaie après environ une demi-seconde. Un interrupteur thermique U17 le coupe au-delà de 110 °C.
Convertisseur 5 V | Un convertisseur abaisseur (LM5146 avec deux transistors) transforme le 24 V en environ 5,05 V. Il fournit 4 A en continu, assez pour la carte de l’écran et la charge de la batterie. En cas de court-circuit, il se coupe et se rallume de façon cyclique (hiccup).
Fusible 5 V | Le fusible électronique U15 protège le 5 V vers la carte de l’écran (limite 4,4 à 5,3 A) et ne laisse passer aucun courant en sens inverse vers le convertisseur.
Coupure en cas de surtension | Si, à la suite d’un défaut, le 5 V dépasse environ 6 V, un maintien automatique coupe l’entrée 24 V et la maintient coupée jusqu’à ce que vous coupiez le 24 V pendant au moins 30 secondes.

SOUS-ENSEMBLE | CE QU’IL FAIT
Blocage de charge | Abaisse le 5 V à environ 4 V tant que la charge de la batterie n’est pas autorisée (chapitre 7). Cavalier J21 : 2-3 = fonctionnement, 1-2 = forcer le blocage.
Mesure de la lumière | Composant de mesure ADS1115 (adresse 0x48) avec résistances de mesure et protection contre les surtensions pour les quatre sorties du capteur solaire ; alimentation 3,3 V propre et limitée en courant pour le capteur.
Surveillance | Second ADS1115 (adresse 0x49) : température à la paroi arrière, le 5 V sur la carte de l’écran et l’autorisation ou non de la charge. En lecture seule, il ne commute rien.
Sorties de commutation et fins de course | PCA9538 (0x70) avec quatre contacts PhotoMOS libres de potentiel et quatre entrées de fin de course.
Voyants | Second PCA9538 (0x71) avec les voyants BEREIT et FAIL sur la carte et au bornier J14 ; en plus, les signalisations des limiteurs de courant et les entrées « 24 V présents » et « 5 V présents ».
Anémomètre | Bornier J15 pour les deux capteurs de vent avec les quatre fils : sur le pôle 1, une alimentation propre, limitée en courant, d’environ 11,5 V (régulateur U23 avec diodes de protection D18 et D19), sur les pôles 3 et 4 le composant RS485 THVD2410 avec diodes de protection ; résistance de terminaison via le cavalier J16.
Entrée d’impulsions HALL | Bornier J22 pour deux contacts libres de potentiel (canal A et B), prévu pour le futur HallTapBoard. Par canal : une résistance de pull-up vers 5 V, une diode de protection au bornier, un filtre et un comparateur (U22) avec hystérésis ; il transmet le signal en 3,3 V aux GPIO29 et GPIO30 de la carte de l’écran. Le firmware 10 pouces exploite cette entrée lorsque « Capteur Hall présent » est activé sous RÉGLAGES (chapitre 8 ; uniquement compilé et testé sur ordinateur).
Contacts de reset (à partir de l’ébauche 0.12) | Troisième PCA9538 (adresse 0x72) avec deux autres contacts PhotoMOS libres de potentiel, K5 et K6, sur le bornier J23 : RST élévation et RST azimut. Même construction que les sorties de commutation, avec une diode de protection aux bornes de chaque contact. Le firmware s’en sert pour réinitialiser la commande synchrone après une coupure de courant (chapitre 8).

## Ce que le firmware attend de la carte

Le firmware 10 pouces (en préparation) a besoin de ces indications. Elles figurent ici pour que la carte et le firmware soient compatibles (règle H7).

Sûr par conception
Après la mise sous tension et après chaque redémarrage, toutes les broches du PCA9538 sont un instant « ouvertes » (haute impédance). Tous les contacts sont alors ouverts (les quatre sorties de commutation et, à partir de l’ébauche 0.12, les deux contacts de reset sur J23) et les voyants éteints jusqu’à ce que le firmware les commute. Si la carte de l’écran est éteinte par son interrupteur à glissière, les contacts restent également ouverts.

💡

COMPOSANT | ADRESSE | ATTENDU
ADS1115 (capteur solaire) | 0x48 | AIN0 Est, AIN1 Ouest, AIN2 Sud, AIN3 Nord, chacun 200 Ω (2 × 100 Ω) vers GND, 22 kΩ en série, diode de protection au bornier et diode d’écrêtage à l’entrée.
ADS1115 (surveillance) | 0x49 | Alimenté par l’alimentation 3,3 V propre de la carte ; sans 5 V (par exemple en fonctionnement sur batterie), il n’est pas joignable, la commande émet alors seulement un avertissement. AIN0 sonde de température RT2, AIN1 moitié du 3,3 V, AIN2 moitié de la tension sur l’embase J8 de la carte de l’écran, AIN3 autorisation du blocage de charge. Le firmware mesure les quatre entrées l’une après l’autre, un cycle toutes les 0,8 secondes, et contrôle ainsi le blocage de charge (chapitre 8).
PCA9538 (sorties de commutation) | 0x70 | IO0–IO3 contacts HAUT, BAS, EST, OUEST (LOW = contact fermé), IO4–IO7 fins de course (LOW = fermé = déplacement autorisé). Après un reset, toutes les broches sont des entrées.
PCA9538 (voyants) | 0x71 | IO0 BEREIT, IO1–IO3 FAIL rouge, vert, bleu (LOW = allumé) ; IO4/IO5 défaut des limiteurs de courant (LOW = défaut) ; IO6 « 24 V présents » (LOW = présents), IO7 « 5 V présents » (HIGH = présents, même pendant le blocage de charge). Utiliser IO6 et IO7 uniquement en entrée, jamais en sortie HIGH.
PCA9538 (contacts de reset, à partir de l’ébauche 0.12) | 0x72 | IO0 contact RST élévation (J23 pôles 1–2), IO1 contact RST azimut (J23 pôles 3– 4), LOW = contact fermé. Après un reset ou la mise sous tension, toutes les broches sont des entrées, donc les deux contacts sont ouverts. IO2–IO7 ne sont pas utilisées, ont chacune 10 kΩ vers GND sur la carte, et le firmware les règle en sortie LOW. L’entrée RESET a sa propre résistance de 10 kΩ vers 3,3 V (R150). Si 0x72 ne répond pas (carte 0.11), seul le reset via J23 est « non disponible » ; ce n’est pas une erreur, tout le reste continue de fonctionner.
Entrée d’impulsions J22 (U22) | – (pas d’I2C) | GPIO29 = canal A (J1.19), GPIO30 = canal B (J1.21), comme entrées du compteur d’impulsions (PCNT) de l’ESP32-P4. Son pilote active la résistance de pull-up interne ; cela ne gêne pas, car la carte a 10 kΩ vers 3,3 V et le comparateur pilote la ligne. Contact fermé = HIGH (signal Hall HIGH), ouvert ou sans connecteur = LOW ; un niveau constant ne compte rien. Sans conséquence après un reset. Chaque front des deux canaux est compté (quadrature), filtre anti-parasites 5 µs, attendu 200 à 400, au maximum environ 1 000 impulsions par seconde et par canal (hypothèse). Exploité uniquement si « Capteur Hall présent » est activé.
Accès à distance | – | L’interrupteur « COMMANDE DISTANTE BLOQUÉE » fait partie du firmware (chapitre 8) ; la carte n’y change rien.

## Fixation

Monter avec précaution l’îlot de cuivre en haut à gauche
Le petit îlot de cuivre portant la sonde de température est séparé du reste de la carte par des fentes, afin que la chaleur de celle-ci l’atteigne à peine. Il est relié par un doigt (1,9 × 2,5 mm) et soutenu à gauche et à droite par une étroite languette de matériau de circuit imprimé (réalisé le 11.10.2026 : deux languettes). Malgré tout : tenir la carte par le bord, l’abaisser bien droite et ne pas appuyer sur l’îlot. Ne presser que légèrement les pads thermiques. Si l’îlot se casse malgré tout, la sonde ne mesure plus et le blocage de charge de la batterie n’agit pas comme prévu ; la carte ne doit alors pas être utilisée avec la batterie branchée.

⚠️

### Remplacer les vis

Dévisser l’une après l’autre les quatre vis qui maintiennent le circuit imprimé de la carte de l’écran depuis l’extérieur à travers la paroi arrière, et remplacer chacune par une entretoise M2,5 mâle-femelle. Le filetage mâle ne doit pas être plus long que l’ancienne vis. Pour l’entretoise M2,5 × 12 + 6, on met un écrou M2,5 sur le filetage mâle, sans rondelle : ainsi elle se visse à fond, et l’écrou repose sur la paroi arrière. Mesurer ensuite avec la jauge de profondeur du pied à coulisse la profondeur du filetage femelle d’une entretoise et noter la valeur (elle détermine la longueur des vis à la dernière étape). Résultat attendu : les quatre entretoises maintiennent le circuit imprimé aussi fermement que les vis auparavant. De l’extérieur de la paroi arrière au sommet des entretoises, il y a 13,9 mm (mesuré sur l’appareil, 05.11.2026).

1

### Vérification lors du premier montage : présenter d’abord J1 sans rondelles

Ne pas encore souder la barrette J1. L’enficher par le dessous dans la carte, de sorte que son support en plastique repose contre la face inférieure (la maintenir en haut, par exemple avec du ruban adhésif). Laisser de côté l’entretoise en laiton et les pads pour cette étape. Poser la carte sans rondelles sur les entretoises, en n’appuyant que directement au-dessus de J1, et ne visser que légèrement les vis, chacune avec une rondelle sous la tête. Mesurer ensuite la distance g entre la face inférieure du support et le bord supérieur de J8 ; les broches s’enfoncent de e = 15,5 mm − g dans J8. Résultat attendu : la carte repose à plat sur les quatre entretoises, J1 est enfichée bien droite et sans contrainte dans J8, et g vaut 12,3 à 12,5 mm, les broches s’enfoncent donc de 3,0 à 3,2 mm (calcul ; plage admise 2,5 à 4,0 mm, soit g de 11,5 à 13,0 mm).

2

### Rondelles sur les entretoises seulement si nécessaire

Si J1 bute contre le fond de J8 (la carte ne repose alors pas sur les entretoises) ou si les broches s’enfoncent de plus de 3,7 mm, poser sur chaque entretoise une rondelle M2,5 selon DIN 433 (0,5 mm d’épaisseur, 5 mm de diamètre extérieur) et répéter l’étape précédente. Deux rondelles par entretoise, c’est trop : les broches ne s’enfoncent alors que de 2,0 à 2,2 mm. La petite forme DIN 433 est choisie parce qu’elle reste, même déplacée, à l’intérieur de l’anneau sans cuivre autour du trou (6,5 mm) ; une rondelle ordinaire de 6 mm pourrait atteindre des pistes de la face inférieure. Résultat attendu : les broches s’enfoncent de 2,5 à 4,0 mm ; toutes les entretoises portent le même nombre de rondelles (aucune ou une).

3

### Souder J1

Ce n’est qu’alors que l’on retire la carte et que l’on soude J1 bien droite, le support reposant contre la face inférieure. Résultat attendu : toutes les broches dépassent d’autant sous la carte ; le support repose sans jeu.

4

### Poser le pad thermique et l’entretoise

Poser un pad thermique (6 × 6 mm) sur la paroi arrière sous l’îlot de cuivre en haut à gauche de la carte, poser dessus l’entretoise en laiton M3, puis le second pad. La combinaison retenue est elle aussi décidée lors du premier montage. Avec 13,9 mm entre la carte et la paroi arrière (boîtier 50 mm, sans rondelles sur les entretoises), conviennent soit l’entretoise de 12 mm avec un pad de 1,0 mm et un de 1,5 mm (les pads sont comprimés d’environ 24 %), soit l’entretoise de 13 mm avec deux pads de 0,5 mm (environ 10 %, à la limite inférieure). Avec une rondelle par entretoise (14,4 mm), conviennent par exemple l’entretoise de 12 mm avec deux pads de 1,5 mm (20 %) ou l’entretoise de 13 mm avec deux pads de 1,0 mm (30 %). Avec 9 mm (boîtier 40 mm), conviennent l’entretoise de 6 mm et deux pads de 1,5 mm ; pour une autre distance, le choix dépend de la distance mesurée (chapitre 7). Résultat attendu : l’entretoise est verticale sous les quatre traits de la sérigraphie de la face inférieure.

5

### Saisir la carte par le bord et l’aligner

Tenir la carte, composants vers l’extérieur, uniquement par le bord, pas dans la zone de l’îlot de cuivre en haut à gauche. La tenir au-dessus de la paroi arrière et vérifier de côté que l’entretoise se trouve exactement sous les quatre traits. Résultat attendu : aucun doigt ni outil ne touche l’îlot ; l’entretoise est sous les traits.

6

### Enficher la carte

Pousser la longue barrette J1 bien droite et sans la coincer à travers la fente de la paroi arrière dans le connecteur femelle J8 ; n’appuyer que directement au-dessus de J1, jamais sur l’îlot. Les pads ne sont alors que légèrement comprimés. Résultat attendu : les quatre trous de la carte sont au-dessus des entretoises, la carte repose sur les entretoises (ou les rondelles) et sur le pad ; aucune rondelle n’a glissé.

7

RONDELLES PAR
ENTRETOISE

DISTANCE PAROI
ARRIÈRE–CARTE

BROCHES
DANS J8

RÉSERVE
JUSQU’AU FOND
DE J8

PRISE DE LA
VIS M2,5 ×
6

ÉVALUATION

aucune | 13,9 mm (mesuré) | 3,0–3,2 mm 1,0–1,2 mm | 3,9 mm | probablement adapté d’après l’essai d’ajustement
une | 14,4 mm | 2,5–2,7 mm 1,5–1,7 mm | 3,4 mm | à la limite inférieure

### Visser

Visser la carte sur les entretoises avec quatre vis M2,5 × 6, chacune avec une rondelle sous la tête, sans forcer (le filetage des entretoises est en laiton). Sans rondelles sur les entretoises, la vis pénètre d’environ 3,9 mm dans l’entretoise, avec une rondelle par entretoise d’environ 3,4 mm. Cela ne convient que si le filetage femelle est assez profond (mesuré à la première étape : sans rondelles au moins environ 4,2 mm, avec une environ 3,7 mm ; hypothèse, la profondeur n’est indiquée nulle part). S’il est moins profond, prendre des vis M2,5 × 5 ; sans rondelles, elles pénètrent d’environ 2,9 mm. La tête de vis et la rondelle ne doivent pas dépasser 7 mm de diamètre ; on utilise ici aussi la rondelle M2,5 selon DIN 433 de 5 mm, sur laquelle la tête (4,5 mm) repose entièrement. Résultat attendu : la carte repose à plat sur les quatre entretoises et ne bouge pas ; la barrette est enfichée sans contrainte dans l’embase J8 de la carte de l’écran ; l’entretoise est bien serrée entre les pads et ne glisse pas.

8

À partir de l’ébauche 0.12 : perçage H2 seulement avec le connecteur J23 débranché
Le bornier J23 se trouve en haut à droite, tout près du perçage H2 ; ses pistes passent à un peu moins de 5 mm du centre du perçage. Ne vissez ou dévissez donc la vis de H2 que lorsque le connecteur de J23 est débranché.

⚠️

Mesuré, vérifié par essai d’ajustement et encore ouvert
Les broches de la barrette J1 doivent s’enfoncer de 2,5 à 4,0 mm dans le connecteur femelle J8. Mesuré sur l’appareil (05.11.2026) : les entretoises avec écrou, sans rondelle, donnent 13,9 mm de l’extérieur de la paroi arrière à la face inférieure de la carte. Position J1/J8 vérifiée sur l’appareil par essai d’ajustement (06.11.2026) : une maquette imprimée de la carte reposait sans rondelles sur les entretoises ; son bloc au-dessus de J1 se trouvait exactement au-dessus de J8. Il en est calculé (pas mesuré au pied à coulisse) : J8 se trouve environ 0,9 à 1,1 mm sous l’extérieur de la paroi arrière, à environ 0,2 mm près (précision dimensionnelle de l’impression). Les broches dépassent de 18 mm sous la carte. Hypothèses : la profondeur utile de J8 (environ 4,2 mm selon le modèle 3D de Waveshare) et la profondeur du filetage femelle des entretoises (à mesurer avant de visser). La pose de rondelles sur les entretoises et le choix de la dissipation thermique ne seront décidés que lors du premier montage sur la carte fabriquée. Les quatre trous préparés de la paroi arrière (« reserved mounting holes ») se trouvent sous la carte et restent libres.

🧩

RONDELLES PAR
ENTRETOISE

DISTANCE PAROI
ARRIÈRE–CARTE

BROCHES
DANS J8

RÉSERVE
JUSQU’AU FOND
DE J8

PRISE DE LA
VIS M2,5 ×
6

ÉVALUATION

deux | 14,9 mm | 2,0–2,2 mm 2,0–2,2 mm | 2,9 mm | trop juste, ne pas utiliser

Boîtier arrière
Le boîtier pour la face arrière est une conception maison pour l’impression 3D (dossier cover/ ) : aussi grand que la paroi arrière de l’écran (245,2 × 164 mm). Il existe deux profondeurs au choix ; chacune a ses propres fichiers avec _50mm ou _40mm dans le nom :

### 50 mm de profondeur : la carte se trouve à 13,9 à 14,9 mm au-dessus de la

paroi arrière de l’écran (barrette J1 21 mm, entretoises M2,5 × 12 + 6 avec écrou, rondelles dessus seulement si nécessaire) ; selon le calcul, il reste 9,6 à 10,6 mm d’air jusqu’au fond du boîtier ; dans cet espace passent les câbles vers les presse-étoupes. Les presse-étoupes sont placés au milieu de la face latérale.

### 40 mm de profondeur : la carte se trouve à 9 mm au-dessus de la paroi arrière

(barrette J1 15 mm, C52461). Il faut pour cela des entretoises M2,5 × 6 + 6 avec écrou et rondelle sur le filetage mâle (mesuré par l’utilisateur : 8,9 mm de distance) ; une référence JLCPCB pour ces entretoises est ouverte. Les presse-étoupes sont au milieu de la hauteur de la paroi. Avec 13,9 à 14,9 mm de distance, la carte n’entre pas dans ce boîtier (selon le calcul, il reste au plus 0,6 mm d’air jusqu’au fond ; à 14,9 mm, J11 y pénètre de 0,4 mm).

Attention, ne pas intervertir les barrettes : la longue barrette de 21 mm (C51353) ne va qu’avec la distance de 13,9 à 14,9 mm (boîtier 50 mm). À 9 mm de distance, ses broches entreraient d’environ 9 mm dans le connecteur femelle J8 au lieu de 3 mm (calculé avec une paroi arrière de 1,5 mm, hypothèse) et endommageraient J8 de la carte. Pour 9 mm, utiliser uniquement la barrette de 15 mm (C52461).
Les câbles entrent par le bas à travers six presse-étoupes PG 11 (perçage 18,9 mm). Le boîtier est conçu pour que l’image soit à l’endroit lorsque les presse-étoupes sont en bas et les trous de serrure en haut (état au 28.10.2026 ; avec le boîtier précédent, l’image était à l’envers ; hypothèse jusqu’au montage dans le nouveau boîtier). Il est fixé par des vis M2,5 aux huit trous de bordure de la paroi arrière ; au mur, il est suspendu par deux trous de serrure cachés (vis Ø 4 mm). Il s’imprime fond vers le bas. Pour la Creality K2 Plus avec Hyper PETG-CF, des projets d’impression prêts à l’emploi sont fournis, pour chaque profondeur un pour la buse de 0,4 mm et un pour celle de 0,6
mm (par exemple Rueckgehaeuse_ESP32-P4_10.1_50mm_K2Plus_HyperPETG-CF_0.4mm.3mf , de
même _40mm_… et …_0.6mm.3mf ) : 5 parois, 6 couches supérieures et 6 inférieures, remplissage gyroïde, supports uniquement à partir du plateau. Les trous de serrure s’impriment sans supports. Les perçages des presse-étoupes ne reçoivent pas de support et peuvent légèrement s’affaisser en haut ; les aléser alors. Avant l’impression, vérifier l’aperçu dans le logiciel d’impression (hypothèse : non vérifié dans le logiciel d’impression). D’après le calcul, la carte y trouve sa place ; seul un essai d’ajustement montrera si les écrous des presse-étoupes ont assez d’espace à l’intérieur par rapport aux connecteurs de la carte (hypothèse).

ℹ️

# 6 Raccordement et câblage

Tous les borniers de la carte sont enfichables : les fils vont dans un connecteur détachable, le connecteur sur la carte. On peut ainsi remplacer la carte sans détacher de fils.

Le câblage complet sur le Samba-Solar-Rack avec deux vérins, la commande synchrone BST-KZQ-15A-2 et le HallTapBoard est décrit pas à pas dans le manuel de câblage (verkabelung.html, PDF Samba-Solar-Track-Verkabelung-10Zoll.pdf ). Ce chapitre explique les borniers de la carte et les circuits qui se trouvent derrière.

## Les borniers de la carte

BORNIER | SÉRIGRAPHIE | AFFECTATION (POSITION DU PÔLE 1 POUR LA VUE DE LA CARTE COMME SUR LA
FIG. 5)
J2 | SONNE | Pôle 1 à droite. 1 = 3,3 V (noir), 2 = Est (rouge), 3 = Ouest (blanc), 4 = Sud (jaune), 5 = Nord (vert), 6 = blindage. Chaque conducteur supporte 12 V en permanence ; 24 V sur un conducteur de mesure (2 à 5) détruisent deux résistances de la carte (avertissement ci-dessous).
J3, J4 | RAUF, RUNTER | Sorties de commutation de l’élévation : deux rangées de 2 × 2 broches, un contact libre de potentiel entre deux broches diagonalement opposées (Fig. 12)
J5, J6 | OST, WEST | Sorties de commutation de l’azimut : deux rangées de 2 × 3 broches, contact entre les deux broches extérieures diagonalement opposées (Fig. 12)
J7, J8 | OBEN, UNTEN | Fins de course de l’élévation (bord droit, en haut) : 1 = signal, 2 = GND. Depuis le 3.11.2026, chaque conducteur supporte 24 V en permanence.
J9, J10 | OST, WEST | Fins de course de l’azimut (bord droit, en bas, sous la sortie de commutation WEST ; jusqu’au 3.11.2026 en haut à côté de J2) : 1 = signal, 2 = GND. Chaque conducteur supporte 24 V en permanence.
J11 | +24V | Pôle 1 en haut. 1 = +24 V, 2 = moins (connecteur plus grand, pas de 5,08 mm)
J14 | (pas de sérigraphie ; repère « J14 », à gauche de HALL) | Pôle 1 à gauche. 1 = plus des deux voyants, 2 = rouge, 3 = vert, 4 = bleu (FAIL), 5 = moins du voyant BEREIT. Depuis le 3.11.2026, chaque pôle supporte 24 V en permanence ; chaque voyant est commuté par un puits de courant (7 à 8 mA, aussi pour des voyants verts, bleus et blancs jusqu’à 3,3 V de tension directe).
J15 | WIND | Pôle 1 en haut. Capteurs de vent (pas de 3,81 mm) : 1 = +12 V (rouge, environ 11,5 V fournis par la carte), 2 = GND (noir), 3 = A (jaune), 4 = B (vert), 5 = blindage

Réglages à l’écran
Lorsque ce chapitre mentionne des réglages à l’écran (par exemple sous RÉGLAGES), ils sont présents dans le firmware pour la carte 10,1 pouces, mais pas encore testés sur l’appareil (chapitre 8).

🧩

BORNIER | SÉRIGRAPHIE | AFFECTATION (POSITION DU PÔLE 1 POUR LA VUE DE LA CARTE COMME SUR LA
FIG. 5)
J16 | 120R | Cavalier de résistance de terminaison : 1-2 = activée, 2-3 = désactivée
J21 | SPERRE | Cavalier du blocage de charge : 2-3 = fonctionnement, 1-2 = forcer le blocage (uniquement pour contrôle)
J22 | HALL | Pôle 1 à gauche. Entrée d’impulsions pour le HallTapBoard (voir ci-dessous) : 1 = canal A, 2 = canal B, 3 = GND et blindage ; uniquement des contacts libres de potentiel, pas d’alimentation
J23 | RST E, RST A | À partir de l’ébauche 0.12. Pôle 1 à droite. 1–2 = contact RST élévation, 3–4 = contact RST azimut ; chacun libre de potentiel, 30 V et 1 A au maximum. Vers les bornes RST et COM de la commande synchrone (voir ci-dessous). À équiper seulement si vous raccordez le reset via J23.

Enficher les connecteurs avec une précision extrême, sans décalage
Chaque connecteur va exactement sur son bornier, à fleur, avec toutes les broches dans le connecteur et sans décalage d’une broche. En particulier à l’extrémité supérieure de J7, à l’extrémité de J10 et aux deux extrémités de J14, un connecteur à plus de pôles peut dépasser du bornier sans que cela se remarque. Des fils se retrouvent alors sur de mauvaises broches : un connecteur à trois pôles sur J7 peut mettre une entrée de fin de course dans un état indéfini, le connecteur à six pôles du capteur à l’extrémité de J14 relie un fil du capteur au pôle positif des voyants. La carte n’a plus de protection propre contre cela ; seul votre soin compte.
Procédez donc toujours ainsi : mettre les vérins hors tension avant d’enficher ou de retirer un connecteur. Étiqueter chaque connecteur exactement comme son bornier. Enficher d’abord J2, J14 et J15, les connecteurs des sorties de commutation en dernier. Avant la première mise sous tension et après chaque changement de connecteur, effectuer l’étape de contrôle du chapitre 9 (étape 3).

⛔

Contre quoi les connecteurs sont tout de même protégés
Le connecteur du 24 V est plus grand (pas de 5,08 mm) et ne s’adapte à aucun autre bornier ; le bornier J11 a des parois d’extrémité, il ne peut donc pas non plus être enfiché décalé. Les connecteurs des sorties de commutation sont à deux rangées et ne s’adaptent à aucun bornier à une rangée. Si un connecteur à une rangée est enfiché dans une rangée de J3 à J6, il touche au plus une broche de contact et ne commute rien. Des connecteurs inversés de HAUT et BAS ou de EST et OUEST ne commutent rien non plus : le vérin ne bouge pas. Tout cela est déduit des dessins du fabricant et sera vérifié sur le prototype.

ℹ️

## Alimentation : deux alimentations sur le rack, une commune comme variante

La commande n’a besoin que d’une source de courant : 24 V continu au bornier J11. La carte en tire 5 V et les transmet à la carte de l’écran par la barrette J1. Vous n’avez pas besoin de câble vers la carte de l’écran.

Depuis le 3.11.2026, pour l’installation sur le Samba-Solar-Rack : deux alimentations séparées. Une Mean Well HLG-600H-24 (IP67, sortie fixe 24 V ± 1 %) est couchée sur le pied droit du rack, à l’intérieur, contre les supports du coffret de commande (E1) et du coffret 2 (E1b), et n’alimente que la commande synchrone BST-KZQ-15A-2, les vérins et le HallTapBoard. Avec deux vérins, le point étoile (bornes de répartition), les fusibles et le HallTapBoard se trouvent dans le coffret 2

Ces confusions restent possibles
Les connecteurs à deux pôles des fins de course (J7 à J10) sont identiques entre eux : s’ils sont inversés, un vérin dépasse la butée jusqu’à ce que la durée de course maximale l’arrête. Les connecteurs à deux pôles s’adaptent aussi sur J2, J14 et J15, le connecteur de l’anémomètre aussi sur J2 et J14, le connecteur des voyants aussi sur J2. Le capteur solaire fournit alors des valeurs fausses, les voyants affichent n’importe quoi ou l’anémomètre est considéré comme en panne. Le bornier J15 (WIND) est le seul au pas de 3,81 mm au lieu de 3,5 mm : son connecteur ne s’adapte sur aucun autre bornier, et aucun autre connecteur de la commande ne s’adapte sur J15. Ainsi, aucun capteur ni aucun voyant ne reçoit par erreur les 11,5 V de J15.1 (hypothèse jusqu’à l’essai d’enfichage sur le prototype). Les connecteurs à deux pôles s’adaptent aussi sur J22 (HALL).
J23 (à partir de l’ébauche 0.12) n’est pas protégé contre les inversions : c’est certes le seul bornier à quatre pôles, mais son connecteur s’enfiche en dépassant sur J2 et J14, et un connecteur à deux pôles des fins de course s’enfiche sur J23. Repérez donc clairement le connecteur avec « J23 RST » et vérifiez-le à l’aide de l’image avant la première mise sous tension.

⚠️

Capteur solaire J2 : jamais 24 V, câble posé à part
Depuis le 3.11.2026, les fins de course (J7 à J10), les voyants (J14), l’anémomètre (J15) et l’entrée d’impulsions (J22) supportent 24 V en permanence sur chaque conducteur, par exemple à cause d’un conducteur inversé dans le câble. Le capteur solaire sur J2 seulement en partie : chaque conducteur de J2 supporte en permanence 12 V, par exemple en cas de confusion avec l’alimentation des capteurs de vent sur J15. 24 V sur un conducteur de mesure (pôles 2 à 5) détruisent les deux résistances de mesure de ce conducteur sur la carte (R1 à R4 et R130 à R133), rien d’autre ; cette voie fournit alors des valeurs fausses jusqu’au remplacement des deux résistances. 24 V sur le pôle 1 (3,3 V) ou le pôle 6 (blindage) ne font pas de dégâts. Posez malgré tout le câble du capteur à l’écart de toutes les lignes 24 V (actionneurs, alimentation), ne raccordez jamais un conducteur 24 V sur J2 et vérifiez chaque conducteur sur J2 d’après le tableau ci-dessus avant la première mise sous tension.

⛔

(E1b), la commande synchrone dans le coffret de commande (E1) (manuel de montage Rack 2-E Plus à partir de V3.0.0). La ligne vers le HallTapBoard (L2) est protégée dans le coffret 2 par un fusible propre : borne porte-fusible Phoenix Contact UK 6-FSI/C-LED24 avec un fusible plat automobile de 1 A dans le fil positif, directement au point étoile (depuis V3.1.1, chapitre 13.3). Le fusible réarmable F1 sur le HallTapBoard ne protège que la carte, pas la ligne. Une petite alimentation 24 V (SELV, 2 A ou plus) près de la tablette n’alimente que le bornier J11. Les capteurs de vent sont alimentés par la carte elle-même via J15 (12 V du régulateur U23). Les pôles négatifs des deux alimentations ne sont jamais reliés : les impulsions Hall passent par des optocoupleurs, les contacts de commutation sont libres de potentiel. Le câblage complet sur le Samba-Solar-Rack avec deux vérins, la commande synchrone BST-KZQ-15A-2 et le HallTapBoard est décrit pas à pas dans le manuel de câblage (verkabelung.html, PDF Samba-Solar-
Track-Verkabelung-10Zoll.pdf ).

Variante avec alimentation commune (décision du 12.10.2026, toujours admise, Fig. 6) : une alimentation puissante de 24 V près des vérins, sur le rack au coffret de commande. De là, chaque consommateur reçoit sa propre ligne avec son propre fusible (câblage en étoile) : les vérins une ligne courte et épaisse, la commande une plus fine jusqu’à 15 m de long, le HallTapBoard une petite. Ainsi, le courant des moteurs ne passe jamais par la ligne de la commande, et sa tension reste stable au démarrage des vérins. Le fusible de 0,5 à 1 A pour le HallTapBoard n’appartient qu’à cette variante.

Variante : une alimentation commune

230 V : uniquement par un
électricien qualifié

Alimentation 24 V
600 W / 25 A, IP67
Sortie 24,0 V
près des vérins

### 25 A

(a) courte, à partir de 4 mm²

jusqu’à env. 24 A

Coffret de commande

BST-KZQ
Commande sync.

Vérins 1 + 2
typ. 12–14 A

### 2 A

(b) jusqu’à 15 m, 2 × 1,5 mm²

environ 1 A, perd 0,35 V

Commande, bornier J11
RearCircuitBoard_10 avec carte et batterie les capteurs de vent sont sur J15
et sont alimentés par la carte

0,5–1 A

(c) petite ligne propre

0,5–1,5 mm², au maximum 16 mA (calculé)

HallTapBoard
Bornier J1

A/B sur J22,
isolation
galvanique

Chaque trait est une ligne avec un fil positif et un fil négatif ; le fusible se trouve dans le fil positif, directement à l’alimentation. Tous les fils négatifs se rejoignent à la borne négative de l’alimentation. Les sections et valeurs sont calculées.

Fig. 6 – Variante avec alimentation commune (décision du 12.10.2026, toujours admise) : une alimentation de 24 V près des vérins, câblée en étoile. (a) vérins et commande synchrone par une ligne courte et épaisse, (b) la commande par une ligne propre jusqu’à 15 m, (c) le HallTapBoard par une petite ligne propre avec fusible de 0,5 à 1 A. L’installation sur le rack avec deux alimentations séparées (depuis le 3.11.2026) est dessinée dans le manuel de câblage.

### Tout laisser hors tension

Les alimentations restent éteintes jusqu’à ce que toutes les étapes suivantes soient terminées. Le côté 230 V est raccordé par un électricien qualifié. Résultat attendu : aucune tension à la sortie de l’alimentation.

1

POINT | CE QUI S’APPLIQUE
Alimentations | 24 V continu, sortie homologuée SELV. Sur le rack : pour les vérins la Mean Well HLG- 600H-24 (IP67, 600 W / 25 A, sortie fixe 24 V ± 1 %) sur le rack ; pour le Samba-Solar- Rack 2.0-E Plus avec la commande synchrone BST-KZQ-15A-2, les vérins consomment ensemble typiquement 12 à 14 A, au maximum environ 24 A (limite de surintensité de la commande synchrone réglée en usine, spécification de commande du rack ; jusqu’à 15 A par vérin). Pour la commande, une petite alimentation de 2 A ou plus près de la tablette ; elle consomme environ 1 A (avec charge de la batterie). Dans la variante avec alimentation commune, un appareil de 600 W / 25 A pour tout.

### Régler la tension de sortie

Après le raccordement par l’électricien qualifié, mettre l’alimentation une fois en marche sans consommateur et mesurer la tension de sortie au multimètre. Si elle a un réglage, la régler sur 24,0 V. Puis l’éteindre à nouveau. Résultat attendu : 22,8 à 25,2 V ; régler une alimentation réglable sur 24,0 V (une alimentation à sortie fixe comme la HLG-600H-24 fournit 24 V ± 1 % selon la fiche technique ; la carte est conçue pour 24 V ± 5 %).

2

### Mettre en place les fusibles

Sur le rack (deux alimentations) : directement à l’alimentation des vérins, insérer un porte-fusible de 25 A dans le fil positif vers la commande synchrone (pour les racks à un seul vérin, la valeur de son manuel de montage) ; la ligne vers le HallTapBoard reçoit au point étoile son propre fusible de 1 A (borne porte-fusible Phoenix Contact UK 6-FSI/C-LED24 avec fusible plat automobile de 1 A, manuel de montage Rack 2-E Plus V3.1.2, chapitre 13.3 ; F1 sur le HallTapBoard ne protège que la carte, pas la ligne). Sur le Samba-Solar-Rack 2-E Plus, le fusible de 25 A est lui aussi une telle borne porte-fusible dans le coffret 2 (E1b). Dans la variante avec alimentation commune, trois porte-fusibles dans les fils positifs : 25 A pour les vérins, 2 A pour la commande, 0,5 à 1 A (temporisé, proposition) pour le HallTapBoard. Résultat attendu : chaque ligne qui a besoin d’un fusible a le sien ; aucune ligne fine ne se trouve derrière le fusible de 25 A.

3

### Poser la ligne vers la commande

Deux fils de 1,5 mm² (0,75 mm² ou plus possible) de l’alimentation de la commande au bornier J11 : sur le rack depuis la petite alimentation près de la tablette (court), dans la variante avec alimentation commune jusqu’à 15 m. Repérer le plus et le moins aux deux extrémités. Ne pas dériver sur une borne commune avec la ligne des vérins. Résultat attendu : la ligne commence aux bornes de l’alimentation et se termine au connecteur de J11.

4

### Fils dans le connecteur de J11

Plus sur le contact 1, moins sur le contact 2. Visser les fils dans le connecteur retiré, puis seulement l’enficher. Résultat attendu : les deux fils sont bien serrés, aucun métal nu ne dépasse.

5

### Enficher le connecteur

Enfoncer le connecteur à fond dans J11. Résultat attendu : il est bien maintenu entre les parois d’extrémité.

6

POINT | CE QUI S’APPLIQUE
Comportement en surcharge | Variante avec alimentation commune : une alimentation de seulement 500 W n’entre en ligne de compte que si, en surcharge, elle limite le courant et continue de fournir (limitation de courant, CV+CC). Un appareil qui se coupe et redémarre en cas de surcharge (hiccup) coupe aussi le courant de la commande à chaque pointe de démarrage ; la carte de l’écran fonctionne alors sur batterie.
Tension | Sortie fixe 24 V ± 1 % (HLG-600H-24) ; ne régler sur 24,0 V qu’un appareil réglable. La carte est conçue pour 24 V ± 5 % (22,8 à 25,2 V) ; après 15 m de ligne, il arrive environ 23,65 V à J11, sans charge les 24,0 V complets. Jamais durablement au-dessus de 30
V. Avec seulement 20 V, le fusible F1 ne suffit pas, à chaud, pour le courant complet.
Lignes de détection | Si l’alimentation a des bornes pour lignes de détection (remote sense), elles restent à l’alimentation, comme décrit dans la fiche technique. Ne jamais les amener jusqu’aux vérins : l’alimentation compenserait alors la perte de la ligne moteur et ferait monter trop haut la tension à J11.
Lieu d’installation | À l’ombre. Pour le Samba-Solar-Rack 2-E Plus, couchée à l’intérieur contre les supports du coffret de commande (E1) et du coffret 2 (E1b) sur le pied droit, position et orientation selon son manuel de montage (à partir de V3.0.0) ; sinon à la verticale, câbles vers le bas. À la chaleur, une alimentation fournit moins (déclassement, courbe dans la fiche technique).
Fusible F1 | Se réarme tout seul. S’il a déclenché, couper le 24 V, supprimer la cause et attendre environ une minute.
Après une coupure pour surtension | Couper le 24 V pendant au moins 30 secondes, puis le rétablir. Si la carte se coupe à nouveau ensuite, elle est défectueuse.
PC sur la prise « UART » | Le PC alimente aussi la carte de l’écran par l’USB. En dessous de 10 °C, ne branchez pas de câble USB : la batterie serait alors chargée malgré le blocage de charge (chapitre 7).
Anémomètre | Ne se raccorde ni à l’alimentation ni à un bornier de répartition. Les deux capteurs de vent se raccordent avec les quatre fils à J15 de la commande ; la carte les alimente elle-même (Anémomètre sur RS485). Leur courant passe par la ligne vers la commande.
Vérins | Aucun courant moteur ne passe par la carte. Les vérins et la commande synchrone reçoivent leur propre ligne courte depuis l’alimentation, avec le fusible de 25 A : sur le rack depuis la HLG-600H-24 (point étoile et fusible de 25 A dans le coffret 2 (E1b)), dans la variante avec alimentation commune depuis celle-ci.

Chute de tension sur la ligne des vérins (calculée avec fil aller et retour, cuivre). À titre indicatif, il ne devrait pas se perdre plus d’environ 1 V à plein courant (hypothèse, le fabricant n’indique pas de valeur). C’est pourquoi l’alimentation est placée près des vérins : la longue ligne vers la commande ne transporte qu’environ 1 A.

SECTION ET LONGUEUR | À 14 A | À 20 A
4 mm², 2 m | 0,25 V | 0,35 V
4 mm², 3 m | 0,37 V | 0,53 V
4 mm², 5 m | 0,61 V | 0,88 V
6 mm², 5 m | 0,41 V | 0,58 V
6 mm², 10 m | 0,82 V | 1,17 V

SECTION ET LONGUEUR | À 14 A | À 20 A
4 mm², 15 m (pour comparaison : alimentation éloignée) | 1,84 V | 2,62 V

## Capteur solaire sur l’ADS1115

Chacune des quatre sorties du capteur solaire fournit un signal qui augmente avec la luminosité. Une résistance de 200 Ω vers la masse, imposée par le fabricant du capteur, le transforme en tension. Le composant de mesure ADS1115 la mesure : plus c’est clair, plus elle est élevée.

Deux alimentations, deux masses – le HallTapBoard reste toujours isolé
Sur le rack, les pôles négatifs des deux alimentations ne sont jamais reliés entre eux, pas même par un blindage de câble : les impulsions Hall passent par des optocoupleurs, les contacts de commutation sont libres de potentiel. Dans la variante avec alimentation commune, les fils négatifs de toutes les lignes se rejoignent à la borne négative de l’alimentation. Entre la masse de la commande et la masse de la commande synchrone, il n’y a alors qu’une faible différence : au maximum environ 0,2 V sur le fil négatif de la commande et environ 0,26 V sur le fil négatif des vérins (3 m, 4 mm², 20 A), valeurs calculées. Mais elle saute à chaque démarrage des moteurs. C’est pourquoi le HallTapBoard continue de séparer les deux côtés par des optocoupleurs. N’établissez pas de seconde liaison entre la masse de la commande et le coffret de commande, par exemple par un blindage de câble.

ℹ️

Ce que la commande sait des alimentations
L’entrée « 24 V présents » de la carte mesure la tension à J11. Sur le rack (deux alimentations), elle ne signale donc que l’alimentation de la commande. Si l’alimentation des vérins est en panne, si le fusible des vérins a déclenché ou si la ligne vers la commande synchrone est interrompue, elle ne l’indique pas ; c’est ce que doit détecter le capteur Hall (HallTapBoard sur J22, en cours). Dans la variante avec alimentation commune, elle indique aussi une panne de l’alimentation (ou de la ligne vers la commande ou de son fusible). Le firmware lit l’entrée, affiche une panne dans l’en-tête (« 24 V ABSENT / VÉRIFIER L’ALIM. », chapitre 8) et dans le navigateur et la signale dans le journal ; elle n’agit pas sur la commande.

⚠️

Si une alimentation tombe en panne
Si l’alimentation de la commande tombe en panne, la carte de l’écran continue de fonctionner sur sa batterie (chapitre 7) ; les vérins s’arrêtent si leur alimentation tombe en panne (dans la variante avec alimentation commune, les deux à la fois). Les contacts de commutation continuent de commuter et ne déplacent rien. Sans fins de course, le firmware peut alors mémoriser une fausse butée et une fausse inclinaison ; en cas de tempête, de panne de l’anémomètre et de stationnement, il se remet donc à plat (chapitre 8). Si l’alimentation tombe en panne pendant une tempête, le module reste là où il se trouve. Aucune commande ne peut compenser cela.

⚠️

3,3 V

noir

limité en courant Capteur solaire 1 des 4 sorties

2 × 100 Ω

### 22 kΩ

4,7 nF
GND

ADS1115
AIN0 … AIN3

Adresse 0x48

SDA → GPIO 7

SCL → GPIO 8

Ce circuit existe quatre fois, une fois par sortie.

Fig. 7 – Une sortie du capteur solaire sur le composant de mesure. Le petit condensateur lisse les perturbations sur le long câble. La Fig. 4 montre quel fil va sur quelle entrée.

## Les quatre sorties de commutation

La carte RearCircuitBoard_10 émet les ordres de déplacement par quatre contacts de commutation : HAUT, BAS, EST et OUEST. Chaque contact est libre de potentiel, c’est-à-dire un simple interrupteur à deux bornes, sans liaison avec le reste de l’électronique. Il supporte jusqu’à 30 V et 1 A ; au-dessus de 33 V, la diode de protection aux bornes du contact conduit. Cela suffit pour des signaux de commande et des bobines de relais, pas pour un moteur. Le courant moteur ne passe donc jamais par la carte.

Le raccordement des contacts dépend du vérin. Il existe deux variantes, et vous pouvez choisir séparément pour chaque axe celle que vous utilisez :

️

Variante A :
contrôleur avec
entrée pour
boutons

Le vérin a son propre
boîtier de commande
avec des bornes pour
deux boutons. Les
contacts de la carte
remplacent les
boutons. Exemple :
contrôleur de
synchronisation pour
deux vérins (Fig. 10).

🔁

Variante B :
relais de
puissance
externes

Le vérin n’a que deux
fils moteur. Les
contacts de la carte
commutent deux relais
de puissance qui
inversent la polarité du
moteur (Fig. 8).
AXE | CONTACTS DE LA
CARTE
VARIANTE A | VARIANTE B

Élévation HAUT (IO0), BAS
(IO1)

HAUT sur UP et COM, BAS sur
DOWN et COM

HAUT commute le relais 1, BAS commute le relais 2

💡

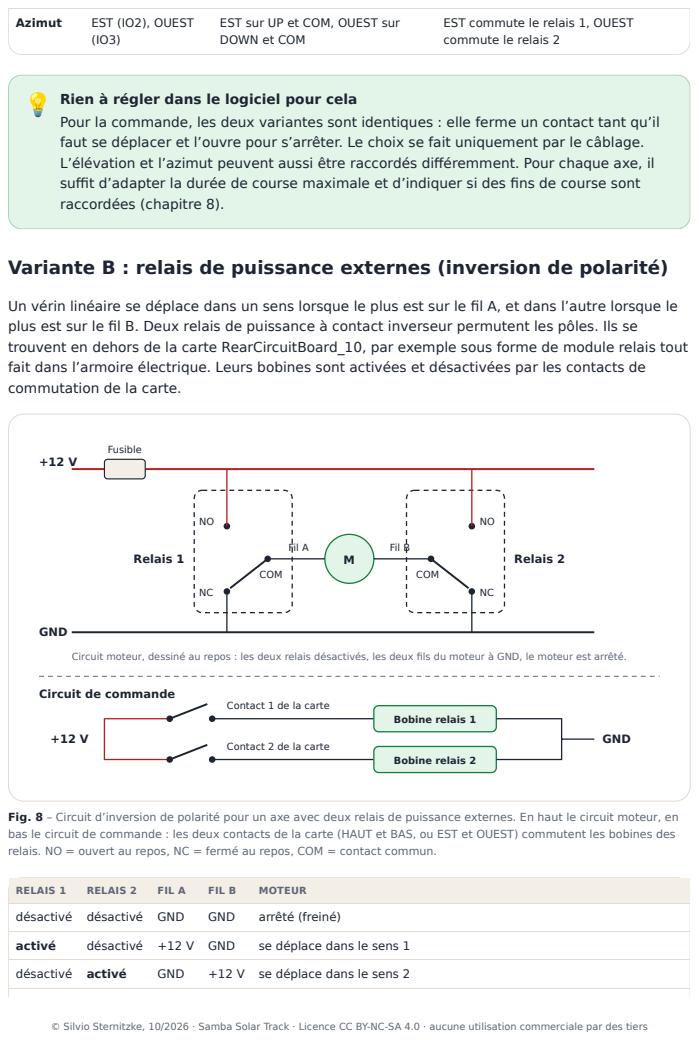
[picture p25: page 27]
Azimut; EST (IO2), OUEST; Fusible; GND; Relais 1; COM; Relais 2; Fil A; Fil B; Bobine relais 1; Bobine relais 2; RELAIS 1; RELAIS 2; FIL A; FIL B; MOTEUR; désactivé désactivé GND; arrêté (freiné); activé; désactivé +12 V GND; se déplace dans le sens 1; désactivé activé; +12 V se déplace dans le sens 2

EST sur UP et COM, OUEST sur
DOWN et COM

EST commute le relais 1, OUEST
commute le relais 2

Rien à régler dans le logiciel pour cela
Pour la commande, les deux variantes sont identiques : elle ferme un contact tant qu’il
faut se déplacer et l’ouvre pour s’arrêter. Le choix se fait uniquement par le câblage.
L’élévation et l’azimut peuvent aussi être raccordés différemment. Pour chaque axe, il
suffit d’adapter la durée de course maximale et d’indiquer si des fins de course sont
raccordées (chapitre 8).

Variante B : relais de puissance externes (inversion de polarité)

Un vérin linéaire se déplace dans un sens lorsque le plus est sur le fil A, et dans l’autre lorsque le
plus est sur le fil B. Deux relais de puissance à contact inverseur permutent les pôles. Ils se
trouvent en dehors de la carte RearCircuitBoard_10, par exemple sous forme de module relais tout
fait dans l’armoire électrique. Leurs bobines sont activées et désactivées par les contacts de
commutation de la carte.

Circuit moteur, dessiné au repos : les deux relais désactivés, les deux fils du moteur à GND, le moteur est arrêté.

Circuit de commande

Contact 1 de la carte

Contact 2 de la carte

Fig. 8 – Circuit d’inversion de polarité pour un axe avec deux relais de puissance externes. En haut le circuit moteur, en
bas le circuit de commande : les deux contacts de la carte (HAUT et BAS, ou EST et OUEST) commutent les bobines des
relais. NO = ouvert au repos, NC = fermé au repos, COM = contact commun.

💡

⚠️

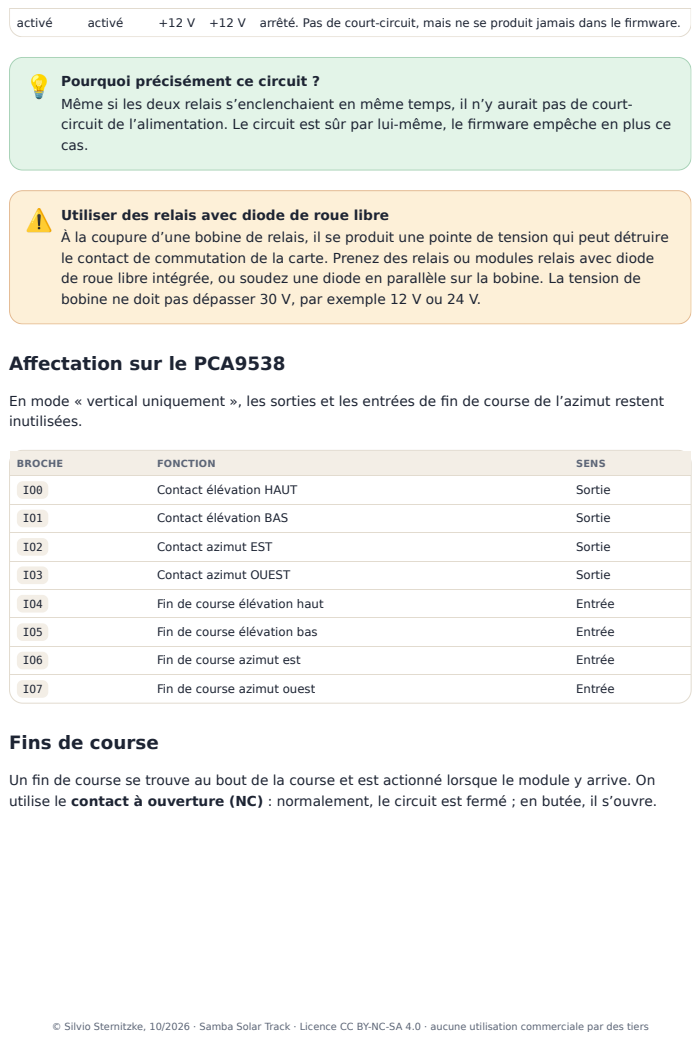
[picture p26: page 28]
activé; +12 V +12 V arrêté. Pas de court-circuit, mais ne se produit jamais dans le firmware.; BROCHE; FONCTION; SENS; Contact élévation HAUT; Sortie; Contact élévation BAS; Contact azimut EST; Contact azimut OUEST; Fin de course élévation haut; Entrée; Fin de course élévation bas; Fin de course azimut est; Fin de course azimut ouest

Pourquoi précisément ce circuit ?
Même si les deux relais s’enclenchaient en même temps, il n’y aurait pas de court-
circuit de l’alimentation. Le circuit est sûr par lui-même, le firmware empêche en plus ce
cas.

Utiliser des relais avec diode de roue libre
À la coupure d’une bobine de relais, il se produit une pointe de tension qui peut détruire
le contact de commutation de la carte. Prenez des relais ou modules relais avec diode
de roue libre intégrée, ou soudez une diode en parallèle sur la bobine. La tension de
bobine ne doit pas dépasser 30 V, par exemple 12 V ou 24 V.

Affectation sur le PCA9538

En mode « vertical uniquement », les sorties et les entrées de fin de course de l’azimut restent
inutilisées.

Fins de course

Un fin de course se trouve au bout de la course et est actionné lorsque le module y arrive. On
utilise le contact à ouverture (NC) : normalement, le circuit est fermé ; en butée, il s’ouvre.

3,3 V

2,2 kΩ via diode

### 22 kΩ

4,7 nF

PCA9538
IO4 … IO7

GND

Fins de course

Contact à ouverture (NC), ici fermé

Fig. 9 – Une entrée de fin de course. Fermée, l’entrée est à GND (LOW) : déplacement autorisé. Si l’interrupteur s’ouvre ou si le câble se rompt, la résistance tire l’entrée à HIGH : déplacement bloqué.

## Variante A : contrôleur avec entrée pour boutons

Certains vérins sont livrés avec leur propre boîtier de commande, auquel on peut raccorder deux boutons. L’exemple le plus important est le contrôleur de synchronisation. Un grand module est souvent soulevé par deux vérins linéaires à la fois. Pour qu’il ne se coince pas, les deux doivent avancer exactement à la même vitesse. C’est le rôle d’un contrôleur de synchronisation : il alimente les deux vérins et les ajuste en permanence. Pour l’élévation, un tel kit avec deux vérins de 3500 N est prévu selon toute vraisemblance.

Le contrôleur a une entrée pour deux boutons, MONTÉE et DESCENTE (bornier C1 avec les fils UP, DOWN et COM). Samba Solar Track « appuie » sur ces boutons avec deux contacts de commutation de la carte RearCircuitBoard_10. Le courant moteur ne passe alors que par le contrôleur.

Les parasites ne peuvent pas annuler une butée
Sur une longue ligne, un parasite peut faire paraître l’entrée « fermée » un court instant. La commande réagit donc de façon asymétrique : si l’interrupteur s’ouvre, elle bloque immédiatement. Le sens n’est à nouveau autorisé que lorsque l’interrupteur est resté fermé sans interruption pendant un dixième de seconde.

💡

Vérin avec fin de course intégré ?
De nombreux vérins linéaires s’arrêtent d’eux-mêmes en fin de course. Vous pouvez alors renoncer aux fins de course externes et régler, à l’écran sous RÉGLAGES, « Fin de course … installé » sur NON pour cet axe. La commande considère alors que la butée est atteinte une fois la durée de course maximale écoulée.

ℹ️

RearCircuitBoard_10

Contact HAUT (IO0)

Contact BAS (IO1)

Contact à fermeture,
ici ouvert

Contrôleur synchro

UP

DOWN

COM

Bornier C1

C2

C3

DC

Vérin 1

Vérin 2

Alimentation

UP

DOWN

COM

Contact HAUT fermé : les deux vérins sortent. Les deux contacts ouverts : arrêt.

Fig. 10 – Raccordement au contrôleur de synchronisation. Deux contacts de commutation de la carte remplacent les boutons MONTÉE et DESCENTE. Ils ne commutent qu’un signal de commande.

Le même câblage s’applique à l’azimut lorsqu’un contrôleur avec entrée pour boutons y est aussi utilisé : les contacts EST (IO2) et OUEST (IO3) vont alors sur son entrée pour boutons.

POINT | CE QU’IL FAUT FAIRE
Contacts | Les contacts de commutation de la carte sont déjà des contacts à fermeture libres de potentiel. Contact HAUT (IO0) sur UP et COM, contact BAS (IO1) sur DOWN et COM.
Durée de course | Recalculer la « Durée max. élévation » et la régler sous RÉGLAGES : course divisée par la vitesse, plus 20 %. Exemple : 300 mm de course à 5 mm/s font 60 secondes, on règle 72 secondes.
Fins de course | Les vérins s’arrêtent d’eux-mêmes en fin de course. Sans fins de course supplémentaires, réglez sous RÉGLAGES « Fin de course élévation installé » sur NON.
Sens de déplacement | Si le module descend avec HAUT, inverser les fils UP et DOWN.
Télécommande | La télécommande radio et la poignée de commande du contrôleur agissent en contournant Samba Solar Track. Les utiliser peut perturber la protection tempête. Il vaut mieux ne les utiliser que pour l’installation.

Commander uniquement en mode impulsionnel
Le contrôleur existe en deux versions. Pour Samba Solar Track, il doit s’agir du mode impulsionnel (mode momentané) : les vérins ne se déplacent que tant que le contact est fermé. En mode verrouillé (maintien automatique), une brève impulsion suffit et les vérins vont jusqu’au bout. Si la commande tombe alors en panne, plus personne ne les arrête. Le firmware ne prend pas en charge cette version. Cela vaut pour tout contrôleur avec entrée pour boutons, à l’élévation comme à l’azimut.

⛔

## Reset de la commande synchrone : J23 ou J5

La commande synchrone des Samba-Solar-Racks (BST-KZQ-15A-2) possède un bornier de commande à quatre bornes : COM · RST · DN · UP. UP et DN agissent comme les touches HAUT et BAS, RST comme la touche Reset. Chaque entrée est commutée contre COM, et uniquement avec des contacts libres de potentiel, sans tension extérieure. Il existe deux voies pour le reset :

VOIE | QUAND | CONTACT SUR RST ET COM | RÉGLAGE (CHAPITRE 8)
J23 | Carte à partir de l’ébauche 0.12 ;
en « vertical seul » et en « vertical
+ horizontal »

Élévation : J23 pôle 1 (RST) et pôle 2 (COM) ; azimut : J23 pôle 3 (RST) et pôle 4 (COM) sur la commande synchrone de l’azimut

Reset commande
synchrone élévation
ou azimut = J23

J5 seulement en « vertical seul » : la sortie EST de l’azimut est alors libre. J23 n’a pas besoin d’être équipé.

le contact de J5 (EST, les deux broches extérieures diagonalement opposées, Fig. 12)

Reset commande
synchrone élévation
= J5

Sur le rack avec quatre fils : le câble vers la commande synchrone n’a besoin que de quatre fils pour le déplacement et le reset : UP, DN, RST et COM. COM n’est amené qu’une fois et ponté côté commande sur J3, J4 et J23 pôle 2 ; les trois contacts sont libres de potentiel, ils peuvent donc avoir un côté en commun. Ainsi, HAUT (J3) va avec UP et COM, BAS (J4) avec DN et COM, RST E (J23 pôles 1 et 2) avec RST et COM. Sans J23, en « vertical seul », RST va sur J5 au lieu de J23, et le pont de COM se fait alors sur J5. Comment mettre les fils dans les connecteurs pas à pas est décrit dans le manuel de câblage (verkabelung.html, chapitre 9).

Encore à vérifier sur l’appareil
Trois points ne ressortent pas de la description du produit et sont donc des hypothèses : si le contrôleur a besoin, après une coupure de courant, d’une course de réinitialisation via la poignée de commande ; comment il réagit à deux contacts fermés simultanément (le firmware n’en ferme jamais deux) ; et quelle tension est présente au bornier C1.

🧩

Obligatoire : fins de course dans le circuit moteur
Un composant de la sortie de commutation peut vieillir au fil des années au point que le contact ne s’ouvre plus complètement. La commande ne s’en aperçoit pas. Les vérins doivent donc avoir leurs propres fins de course dans le circuit moteur, qui coupent eux-mêmes le courant moteur en fin de course. Avec la variante B, il faut en plus un fusible dans le circuit des bobines des relais.

⛔

RearCircuitBoard_10

J3 HAUT (IO0)

J4 BAS (IO1)

J23 RST E (0x72)

Pôle 2 | Pôle 1

COM ponté

UP

DN

RST

COM

Commande sync.
BST-KZQ-15A-2, bornier

UP

DN

RST

COM

Contacts ouverts : arrêt. RST relié brièvement à COM : reset, puis la commande se rentre.

Fig. 10a – Déplacement et reset avec quatre fils : J3 (HAUT) sur UP, J4 (BAS) sur DN, J23 pôle 1 (RST E) sur RST ; le second côté des trois contacts (au pôle 2 de J23) est ponté côté commande et va vers COM par un seul fil. En « vertical seul » sans J23, le contact J5 (EST) joue le rôle de J23.

## Anémomètre sur RS485

L’anémomètre se raccorde avec les quatre fils au bornier J15 de la carte (1 = +12 V, 2 = GND, 3 = A, 4 = B, 5 = blindage). C’est la carte qui porte le composant RS485, la carte de l’écran n’en a pas. La carte alimente aussi elle-même les capteurs : J15.1 fournit environ 11,5 V issus d’un régulateur propre, limité en courant (U23). Vous n’avez besoin ni d’une alimentation séparée ni d’une dérivation sur l’alimentation. Sont prévus les capteurs d’ACOVMELST : le capteur de vitesse du vent (adresse 3 en usine) et, pour le type avec direction du vent, en plus le capteur de direction du vent (adresse 4 en usine). Les deux sont raccordés côte à côte au même bornier.

Repérer le connecteur de J23
J23 n’est pas protégé contre les inversions (voir ci-dessus). Repérez le connecteur avec « J23 RST ». N’appliquez jamais de tension sur une borne RST : la commande synchrone attend un contact libre de potentiel, et le contact de la carte supporte au maximum 30 V.

⚠️

Encore à vérifier sur l’appareil
Le fabricant n’indique pas combien de temps RST doit être relié à COM. Le firmware ferme le contact pendant 5 secondes (hypothèse, à vérifier lors du premier montage sur le rack). La carte ébauche 0.12 n’est pas fabriquée ; J23 n’est vérifié que sur ordinateur.

🧩

POINT | CE QU’IL FAUT FAIRE
Fils | Selon la fiche technique : rouge = plus, noir = moins, jaune = A, vert = B.
Alimentation | Rouge (plus) sur J15.1, noir (moins) sur J15.2. La carte fournit sur J15.1 environ 11,5 V, limités en courant ; ensemble, les capteurs peuvent consommer en permanence 0,3 A au maximum (deux capteurs ont besoin d’environ 0,12 A, hypothèse). Un court-circuit dans le câble n’endommage rien ; l’anémomètre est alors considéré comme en panne.
A et B | Jaune (A) sur J15.3, vert (B) sur J15.4. Pour le type avec direction du vent, les fils des deux capteurs vont en parallèle sur les mêmes contacts : rouge avec rouge, noir avec noir, A avec A et B avec B. Une inversion n’endommage rien, l’anémomètre ne répond simplement pas. Même si, dans le câble, le 24 V ou les 11,5 V de J15.1 arrivent sur A ou B, le composant n’est pas endommagé.
Blindage | Le blindage du câble sur J15.5, uniquement côté commande.
Câbler le connecteur | Dénuder chaque fil sur 7 à 8 mm (fiche technique du connecteur KF2EDGK-3.81-5P, pas de 3,81 mm : conducteurs AWG 28 à 16, jusqu’à 1,5 mm², vis M2 avec 0,2 N·m au maximum). Pour le type avec direction du vent, deux fils vont dans le connecteur par contact, de préférence dans un embout de câblage double (hypothèse, non essayé). Résultat attendu : chaque fil tient fermement ; aucun fil nu ne dépasse d’un point de serrage.
Résistance de terminaison | Cavalier J16 sur 1-2 (activée) si la commande se trouve en bout de ligne, sinon 2-3. L’autre extrémité de la ligne reçoit, au dernier capteur, une résistance de 120 Ω entre A et B (recommandation du fabricant). Sur la carte, un condensateur est placé en série avec la résistance : si un fil 24 V arrive par erreur sur A ou B, la terminaison n’est pas endommagée. Un ohmmètre n’affiche donc pas 120 Ω entre A et B.
Montage | La flèche au pied du capteur de direction du vent pointe vers le nord.

## Support pendulaire pour l’anémomètre

Un anémomètre ne mesure correctement que s’il est vertical ; or, sur une table basculante, tout ce qui est fixé au support du module bouge avec. Il existe pour cela un support pendulaire qui maintient l’anémomètre vertical quelle que soit l’inclinaison de la table. Il ne fait pas partie de Samba Solar Track. Prochainement dans la boutique (pas encore disponible) : notice de construction en PDF pour l’autoconstruction 19,99 €, jeu de pièces imprimées 69,99 €, kit complet 129,99 €.

Sur le Samba-Solar-Rack, deux profilés de capteur de vent (40 × 40, 410 mm) se trouvent sur le côté gauche du rack, à 15 cm à gauche et à droite du P5 gauche ; ils butent contre la face arrière de P6, y sont vissés et affleurent en haut. Sur chaque profilé, un capteur de vent pend dans son pendule vers l’extérieur ; vous choisissez quel capteur va sur quel profilé. À 0°, il reste environ 3 cm jusqu’au sol, à 60° le rack mesure environ 2,2 m de haut, et il faut environ 0,63 m de place en plus derrière le rack. La boîte de raccordement E6 se trouve sous le P6 arrière du cadre basculant ;

Ne raccorder que hors tension
Le fabricant avertit : si l’anémomètre est câblé sous tension, il peut griller. Éteignez d’abord la commande (débranchez le connecteur J11), puis câblez et enfichez le connecteur de J15. Selon le fabricant, les capteurs supportent 5 à 12 V (dans son tableau, 5 à 24 V) ; la carte fournit environ 11,5 V.

⛔

E6 et tous les câbles passent uniquement par les faces inférieures. Chaque câble de capteur de vent doit mesurer au moins 1,9 m. Le cheminement des câbles est décrit dans le manuel de câblage.

Fig. 10a – Le principe, vu de côté dans la direction de l’axe de basculement (schématique, pas à l’échelle). À gauche la table à 0°, à droite basculée à 50° : le pendule avec l’anémomètre pend verticalement dans les deux cas.

## Voyants dans le boîtier

La carte porte les voyants BEREIT (vert) et FAIL (tricolore). Pour un second voyant à l’extérieur du boîtier, les deux sont reliés au bornier à cinq pôles J14 : le pôle 1 est le pôle positif commun des deux voyants (le plus simple est de les souder ensemble dans le boîtier et d’amener un fil au pôle 1), les pôles 2 à 4 sont le rouge, le vert et le bleu du voyant FAIL, le pôle 5 le pôle négatif du voyant BEREIT.

POINT | CE QU’IL FAUT FAIRE
Quels voyants | Des LED ordinaires sans résistance série intégrée ; pour FAIL, une LED RVB à anode commune. Les résistances série se trouvent sur la carte.
Longueur de câble | Uniquement des câbles courts dans le boîtier.
Court-circuit | Sans dommage : l’alimentation des voyants est limitée à environ 135 mA.
Pendant le blocage de charge | Il n’y a qu’environ 4 V ; les voyants peuvent alors être un peu plus sombres (hypothèse).

## Entrée d’impulsions HALL (J22)

Qu’est-ce que c’est ? J22 est un bornier enfichable à trois pôles sur le bord inférieur de la carte, à droite du bornier des voyants (J14, sans sérigraphie), sérigraphie « HALL ». Il reçoit deux contacts libres de potentiel : des interrupteurs sans tension propre, par exemple la sortie d’un optocoupleur. L’entrée est prévue pour le HallTapBoard planifié. Cette petite carte doit prélever sur la commande synchrone (BST-KZQ-15A-2) les impulsions du capteur Hall du vérin 1 et les transmettre par optocoupleurs, avec isolation galvanique, sous forme de deux contacts (canaux A et B). La commande compte combien de fois ces contacts se ferment et s’ouvrent et en déduit si et de combien le vérin se déplace (chapitre 8).

Ce que la carte fait pour cela : elle applique elle-même à chaque fil une petite tension de contrôle (5 V à travers 4,7 kΩ) et détecte si le contact est ouvert ou fermé. Une diode de protection au bornier, un filtre et un comparateur avec hystérésis rendent l’entrée insensible aux perturbations sur les longues lignes. Elle est conçue pour 15 m de câble et jusqu’à 5 000 impulsions par seconde et par canal (hypothèse, la fréquence d’impulsions des vérins n’est pas encore mesurée).

PÔLE DE
J22
| SIGNAL | VA VERS
1 | Canal A (contact par rapport au pôle 3) | GPIO29 de la carte de l’écran (J1 broche 19)
2 | Canal B (contact par rapport au pôle 3) | GPIO30 de la carte de l’écran (J1 broche 21)
3 | GND : retour commun des deux contacts et blindage | Masse de la carte

Projet, uniquement vérifié sur ordinateur
Le firmware 10 pouces exploite J22 lorsque « Capteur Hall présent » est activé sous RÉGLAGES (inclinaison avec capteur Hall) ; cela n’est que compilé et testé sur ordinateur. Le HallTapBoard prévu à cet effet n’est encore qu’un projet (voir ci-dessous). Sans HallTapBoard, J22 reste libre et le capteur Hall désactivé. Le circuit n’est vérifié que sur ordinateur, ni fabriqué ni mesuré.

🧩

Ne jamais raccorder directement les capteurs Hall à J22
Ne jamais relier directement les signaux Hall des vérins de la commande synchrone à J22. La ligne de capteur des vérins n’est prévue que pour 4 m, sa masse est reliée au fil négatif des vérins et saute avec le courant moteur (décalage de masse, même avec l’alimentation commune), et un comptage erroné pourrait plus tard entraîner une torsion du cadre. La liaison se fait uniquement par le HallTapBoard et ses optocoupleurs.

⛔

Voici comment raccorder le câble du HallTapBoard à J22, dès que le HallTapBoard existera :

Pas de tension sur J22
J22 ne doit recevoir aucune tension d’alimentation ni aucun capteur qui attend du courant de cette borne ; la carte n’y fournit pas d’alimentation. Si, par erreur, un fil à 24 V arrive sur le pôle 1 ou 2, la carte le supporte même durablement, à condition que la carte de l'écran soit branchée et allumée. Sur le pôle 3 (retour), en revanche, elle court-circuite la source de tension étrangère.

⚠️

### Mettre la commande hors tension

Couper l’alimentation 24 V (ou retirer le fusible de la ligne vers la commande). Résultat attendu : le voyant BEREIT est éteint, l’écran est sombre ou en fonctionnement sur batterie. Même en fonctionnement sur batterie, vous pouvez continuer à travailler sans danger, car J22 ne reçoit pas plus de 5 V.

1

### Préparer le câble

Prendre un câble blindé à trois fils (par exemple LiYCY 3 × 0,25 mm²), de 15 m au maximum. Dénuder les fils de façon que l’extrémité nue disparaisse entièrement dans la borne du connecteur (environ 6 à 7 mm, hypothèse, à vérifier sur le connecteur), torsader le blindage. Résultat attendu : trois extrémités de fil nues et une extrémité de blindage torsadée, aucun fil entaillé.

2

### Câbler le connecteur

Connecteur KF2EDGK-3.5-3P : pôle 1 = canal A, pôle 2 = canal B, pôle 3 = retour commun et blindage. Le pôle 1 est marqué d’un triangle sur la carte ; dans la vue de la fig. 5, il est à gauche ; sur l’appareil installé (tourné de 180°, presse-étoupes en bas), vu de l’arrière, à droite. Serrer fermement chaque vis et étiqueter le connecteur « J22 HALL ». Résultat attendu : chaque fil est bien serré, aucun brin de cuivre ne dépasse.

3

### Raccorder l’autre extrémité

Sur le HallTapBoard, même affectation : A, B et le retour commun. Ne pas y raccorder le blindage. Résultat attendu : le blindage n’est relié qu’à J22 pôle 3.

4

### Enficher le connecteur dans J22

Dans le bornier portant la sérigraphie « HALL » ; c’est le seul bornier à trois pôles. Résultat attendu : le connecteur est à fleur sur l’embase, aucune broche n’est libre.

5

### Exclure un court-circuit

Toujours sans tension, mesurer au multimètre (résistance) entre le pôle 1 et le pôle 3 ainsi qu’entre le pôle 2 et le pôle 3. Résultat attendu : pas de court-circuit (aucune valeur proche de 0 Ω). Un optocoupleur ne conduit que si le HallTapBoard est lui-même alimenté ; sans tension, le multimètre affiche donc généralement une résistance élevée.

6

### Mettre sous tension et mesurer

Remettre l’alimentation 24 V en marche, les vérins sont à l’arrêt. Mesurer la tension continue entre le pôle 1 et le pôle 3, puis entre le pôle 2 et le pôle 3. Résultat attendu : environ 5 V contact ouvert, environ 1 V contact fermé (le HallTapBoard a 1 kΩ en série avec le contact). Selon la position du vérin, chacune des deux valeurs peut apparaître. Pendant un déplacement, la valeur change trop vite pour le multimètre ; il affiche alors une valeur quelconque entre les deux.

7

Pas de montage d’essai sans carte de l’écran avec 24 V sur l’entrée d’impulsions
Si la carte est posée sur la table sans la carte de l’écran enfichée et qu’un fil de J22 reçoit 24 V (par exemple un raccordement inversé au HallTapBoard), un courant passe par les résistances de rappel R102/R103 dans le rail 5 V de la carte. Sans la carte de l’écran comme charge, il monte d’après le calcul à environ 11 V. Cela met en danger les régulateurs U12, U5 et U9. Ne raccorder donc l’entrée d’impulsions au HallTapBoard qu’avec la carte de l’écran enfichée.

⚠️

Faire passer le câble séparément
Ne pas faire passer le câble avec les lignes moteur dans un même câble, là où on peut les séparer. Ne relier le blindage qu’à J22 pôle 3.

ℹ️

Encore ouvert
La fréquence d’impulsions des vérins, le temps de commutation des optocoupleurs du HallTapBoard et la capacité du câble sont des hypothèses jusqu’à ce qu’ils soient mesurés. Avec les optocoupleurs du HallTapBoard (projet 0.6), le calcul montre que cela suffit sûrement pour quelques centaines d’impulsions par seconde ; 1 000 ne sont garanties qu’une fois le temps de commutation mesuré sur le prototype, et les 5 000 pour lesquelles J22 lui-même est conçu ne sont pas atteintes. Le prototype permettra de vérifier si le connecteur et la sortie du câble en bas à côté de J14 entrent dans le boîtier (il reste environ 9 mm en bas).

🧩

## Le HallTapBoard sur le rack (projet 0.6, en préparation)

Qu’est-ce que c’est ? Une petite carte (70 × 40 mm) pour un coffret sur le rack, près de la commande synchrone BST-KZQ-15A-2 ; sur le Samba-Solar-Rack 2-E Plus, elle se trouve dans le coffret 2 (E1b), à côté du coffret de commande (E1). Elle « écoute » les fils Hall du vérin 1, juste avant son connecteur CH1, sans les perturber, et les transmet par deux optocoupleurs sous forme de deux contacts libres de potentiel (A et B) à J22 de la carte RearCircuitBoard_10. Les deux côtés de la carte sont isolés galvaniquement : à gauche se trouve tout ce qui appartient à la commande synchrone et au côté 24 V des vérins, à droite uniquement les deux contacts vers la commande. Entre les deux se trouve une bande de 7 mm sans cuivre, la distance d’isolement (sérigraphie « TRENNUNG »). Les trois borniers sont sur un seul bord, le bord inférieur ; c’est là que les trois câbles entrent dans le boîtier par trois presse-étoupes. En haut à gauche se trouvent deux LED côte à côte : à gauche la jaune D9 avec la sérigraphie « 24V », à droite la verte D4 avec « 5V OK ». La jaune s’allume dès que le 24 V arrive sur la carte avec la bonne polarité. La verte ne s’allume que si, en plus, le régulateur de tension de la carte fournit son 5 V ; ce n’est qu’alors que le prélèvement fonctionne. Si seule la jaune s’allume, le 24 V est présent, mais quelque chose ne va pas sur la carte (tableau « Ce que montrent les voyants » ci-dessous). Depuis le projet 0.6, les deux brillent à peu près autant (calculé ; auparavant, la jaune était environ dix fois plus sombre).

Sûr en cas de défaut : depuis le projet 0.4, l’alimentation est conçue de sorte qu’un seul composant défectueux ou une alimentation mal raccordée (jusqu’à 30 V en permanence, brèves pointes de tension) ne surcharge aucun autre composant. Soit la carte continue de fonctionner, soit le fusible réarmable F1 la coupe. Pour cela, elle a un régulateur de tension qui supporte jusqu’à 40 V, une diode de protection sur le 5 V et deux résistances en série devant chaque voyant. Depuis le projet 0.5, il y a en outre deux résistances (20 kΩ au total) devant chacune des deux diodes de protection sur J2 : si l’une de ces diodes claque, le signal Hall est conservé sur la commande synchrone au lieu d’être court-circuité. Nouveau dans le projet 0.6 : un second fusible réarmable F2 se trouve entre le pôle 3 de J2 (GND de la commande synchrone) et la masse de la carte. Jusqu’au projet 0.5, les deux étaient reliés directement : si J1 était raccordé avec la polarité inversée alors que J2 était enfiché, le 24 V arrivait sur le GND de J2, ou, si le fil négatif de la commande synchrone se détachait, le courant de l’alimentation (jusqu’à environ 25 A) passait sans fusible par la carte et le fin fil Hall. Désormais, F2 limite le courant et coupe. Autre nouveauté

Projet : ne pas encore construire
Le HallTapBoard existe sous forme de projet 0.6 du 11 novembre 2026 (révisé après un contrôle le même jour), avec un boîtier imprimé en 3D. Le schéma, la carte, les données de fabrication et le boîtier n’ont été vérifiés que sur ordinateur : les contrôles de règles de KiCad ne signalent aucune erreur, l’outil du boîtier vérifie ses dimensions. Rien n’a été fabriqué, imprimé, mesuré ni essayé sur le rack ; toutes les valeurs sont calculées ou lues dans les fiches techniques. Avant la commande viennent les points 1 à 4 du plan de contrôle dans le README : mesures sur le rack à la commande synchrone BST-KZQ-15A-2 (tension et niveau de son raccordement Hall, vitesse d’arrivée des impulsions, tolérance du prélèvement, pointes de tension et tension minimale de l’alimentation). C’est l’utilisateur qui décide si un prototype est commandé sans ces mesures. Le firmware 10 pouces exploite J22 (chapitre 8), mais cela aussi n’est que compilé et testé sur ordinateur.

🧩

: si J2 est débranché ou si un fil Hall est rompu, le canal signale à coup sûr « contact ouvert » au lieu d’une valeur aléatoire. Tout cela est calculé, pas éprouvé (tableau des défauts dans le README).

Fig. 11 – Projet 0.6 du HallTapBoard vu de dessus (image du projet KiCad, sans corps des borniers). En bas, de gauche à droite : J1 pour le 24 V (+24V, 0V), J2 pour les signaux Hall du vérin 1 (H1, H2, GND) et à droite, derrière la distance d’isolement, J3 vers le câble allant à J22 (A, B, GND). En haut à gauche les deux voyants « 24V » (à gauche) et « 5V OK » (à droite), au milieu les deux optocoupleurs au-dessus de la distance d’isolement.

Tension entre les deux masses (à mesurer sur le rack)
F2 se trouve entre la masse de la carte (négatif sur J1, depuis le point en étoile) et le GND de la commande synchrone (pôle 3 de J2). À l’extérieur de la carte, les deux se rejoignent par les fils négatifs au point en étoile. Si une petite tension chute sur le fil négatif de la commande synchrone pendant la course, un faible courant traverse donc F2 : en dessous d’environ 0,18 V, rien de notable ; à partir d’environ 0,54 V, F2 coupe pendant la course et se réenclenche à l’arrêt (calculé). Ce n’est pas dommageable ; la différence se trouve alors sur l’entrée Hall, et le prélèvement continue de fonctionner tant qu’elle reste en dessous d’environ 1,7 à 2,0 V (calculé, hypothèse jusqu’à la mesure). Raccordez donc le fil négatif de la ligne vers J1 au point en étoile, et non derrière la commande synchrone. La mesure se fait sur le rack : tension continue entre J2 pôle 3 et J1 pôle 2 pendant que les deux vérins sont en course ; objectif nettement inférieur à 1 V (plan de contrôle du README, point 7).

⚠️

BORNIER | PÔLE | SÉRIGRAPHIE | RACCORDER À

J1 (pas de
5,08 mm)
| 1 | +24V | +24 V par une petite ligne propre depuis l’alimentation des vérins (sur le
rack HLG-600H-24, via la borne porte-fusible de 1 A au point étoile dans le coffret 2 (E1b) – F1 sur le HallTapBoard ne protège que la carte, pas la ligne ; dans la variante avec alimentation commune, avec son propre fusible de 0,5 à 1 A). Vérifier la polarité au multimètre avant d’enficher J2.
| 2 | 0V | Moins de l’alimentation

J2 (pas de
3,81 mm)
| 1 | H1 | Hall1 (Ch.A), fil jaune, par une borne de connexion à levier avant le
connecteur CH1 (vérin 1)
| 2 | H2 | Hall2, fil vert, de même
| 3 | GND | GND, fil noir, de même (relié à la masse sur la carte par le fusible F2)

J3 (pas de
3,5 mm)
| 1 | A | Câble vers J22 pôle 1 de la carte RearCircuitBoard_10
| 2 | B | Câble vers J22 pôle 2
| 3 | GND | Câble vers J22 pôle 3 (retour commun ; le blindage uniquement à J22)

Le boîtier

Le HallTapBoard reçoit son propre petit boîtier imprimé en 3D (boîtier version 0.6 du 12.11.2026, modifié après une impression d’essai de la version 0.5 ; il convient sans modification à la carte projet 0.6, car les perçages, borniers et voyants sont au même endroit) : 104 × 82 × 44 mm à l’extérieur sans les pattes ; avec les quatre pattes de fixation, le fond mesure 128 mm de large. Il a la forme d’un boîtier industriel courant : à l’extérieur un rectangle aux arêtes uniformément arrondies, sans colonnes rapportées, et le couvercle a exactement la même taille que le fond. Il se compose de deux parties, le fond et le couvercle. Dans le fond se trouvent huit inserts filetés en laiton : quatre dans les dômes sur lesquels repose la carte, et quatre dans les coins renforcés pour les vis du couvercle : à l’intérieur, les coins sont largement arrondis, et la matière entre cet arrondi et le coin extérieur porte la vis. À l’intérieur, il n’y a pas de colonnes. Dans la paroi avant se trouvent trois presse-étoupes PG 11, un pour la ligne 24 V, un pour la ligne Hall du vérin 1 et un pour le câble vers la commande. Au-dessus des deux voyants, le couvercle a chacun un petit trou avec un puits de lumière ; à côté, leur signification figure en relief sur le couvercle : « 24V » sous le gauche, « 5V OK » à droite du droit. Dans chaque puits, vous insérez un guide de lumière : un morceau de tige ronde en verre acrylique (PMMA) de 3 mm de diamètre et 30 mm de long. Il affleure en haut avec le couvercle et se termine en bas environ 1,5 mm au-dessus du voyant ; la lumière est ainsi bien visible sur le dessus du couvercle, et le puits est fermé. Vous voyez ainsi, couvercle fermé, si la carte est alimentée et si son régulateur fonctionne. Entre le fond et le couvercle se trouve un cordon rond Ø 1,5 mm servant de joint : le bord supérieur du fond porte à l’intérieur une collerette avec une rainure dans laquelle vient le cordon ; le couvercle le comprime. La rainure fait le tour de l’intérieur en une boucle lisse avec quatre angles largement arrondis, en passant à l’intérieur des vis, de sorte que le cordon n’a nulle part à suivre une courbe serrée. En haut, la rainure est plus étroite que le cordon : vous enfoncez le cordon par l’ouverture étroite, derrière la rainure est plus large, et le cordon ne retombe pas. Les vis du couvercle se trouvent dans les coins, à l’extérieur du joint. La fermeture se fait avec quatre vis à tête fraisée M3 × 10, dont les têtes affleurent dans les quatre coins du couvercle. Les fichiers d’impression se trouvent dans hardware/HallTapBoard/gehaeuse/ : trois projets d’impression prêts à l’emploi (3MF)

pour la Creality K2 Plus avec Hyper PETG-CF – un avec les deux pièces, un avec le fond seul et un avec le couvercle seul –, ainsi que des STL pour imprimer avec d’autres imprimantes et des STEP pour modifier.

Fig. 11a – Le boîtier fermé (image de l’outil tools/halltap_gehaeuse.py , non imprimé). À l’avant les trois presse-étoupes ; sur le couvercle, au-dessus d’eux, figurent en relief « 24V », « HALL » et « J22 », à l’arrière à gauche les deux trous des voyants avec « 24V » et « 5V OK ». Le fond et le couvercle ont la même taille et les mêmes arêtes arrondies sur tout le pourtour ; dans les quatre coins du couvercle, les vis à tête fraisée affleurent. À gauche et à droite en bas, les pattes avec trou oblong pour la fixation.

Fig. 11b – Le boîtier ouvert avec la carte en place. La carte, les connecteurs, les composants, les presse-étoupes et les câbles ne sont dessinés que sous forme de volumes simples. Les connecteurs sont tournés vers la paroi des presse-étoupes ; dans les quatre coins renforcés, en haut, les trous pour les vis du couvercle. En haut du bord, à l’intérieur, la collerette étroite avec la rainure du cordon d’étanchéité ; elle fait le tour en une boucle lisse avec quatre angles largement arrondis, en passant à l’intérieur des vis. À l’intérieur, rien ne gêne, la carte se pose verticalement.

Fig. 11c – Coupe du boîtier au niveau du voyant « 24V » (à gauche la paroi des câbles ; le voyant « 5V OK » a le même puits 8 mm à côté). La carte repose sur les dômes à 7 mm au-dessus du fond ; le puits de lumière descend du couvercle jusqu’à 2,4 mm au-dessus de la carte, avec à l’intérieur le guide de lumière (bleu clair, 30 mm) jusqu’à environ 1,5 mm au-dessus du voyant. Le connecteur de J1 (vert) est la partie la plus haute ; au-dessus, il reste environ 10 mm jusqu’au couvercle (calculé). En haut à droite et à gauche, la collerette avec la rainure pour le cordon d’étanchéité (1,2 mm de profondeur, 1,9 mm de large en bas, plus étroite que le cordon en haut) et, en dessous, le chanfrein qui permet d’imprimer la collerette sans supports.

Voici à quoi ressemblait le premier prototype imprimé (photos du 15.10.2026, filament noir, encore sans carte). C’est la version antérieure au 11.11.2026 : encore sans joint, 4 mm moins haute, avec texte gravé, vis à tête cylindrique au couvercle et les quatre colonnes à l’intérieur des coins (depuis la version 0.6, les vis se trouvent dans les coins renforcés). Il n’est pas encore mesuré ni éprouvé.

Fig. 11d – Photo : à gauche le fond avec les huit inserts filetés et les trois presse-étoupes PG 11, à droite les pattes de fixation ; à côté, le couvercle vu de l’intérieur avec les deux guides de lumière en haut à droite.

Fig. 11e – Photo : le fond vu de dessus (ancienne version). À l’intérieur des coins les quatre colonnes pour les vis du couvercle (depuis la version 0.6, des coins renforcés au lieu des colonnes), à l’intérieur les quatre dômes bas pour la carte, à l’avant les contre-écrous des presse-étoupes.

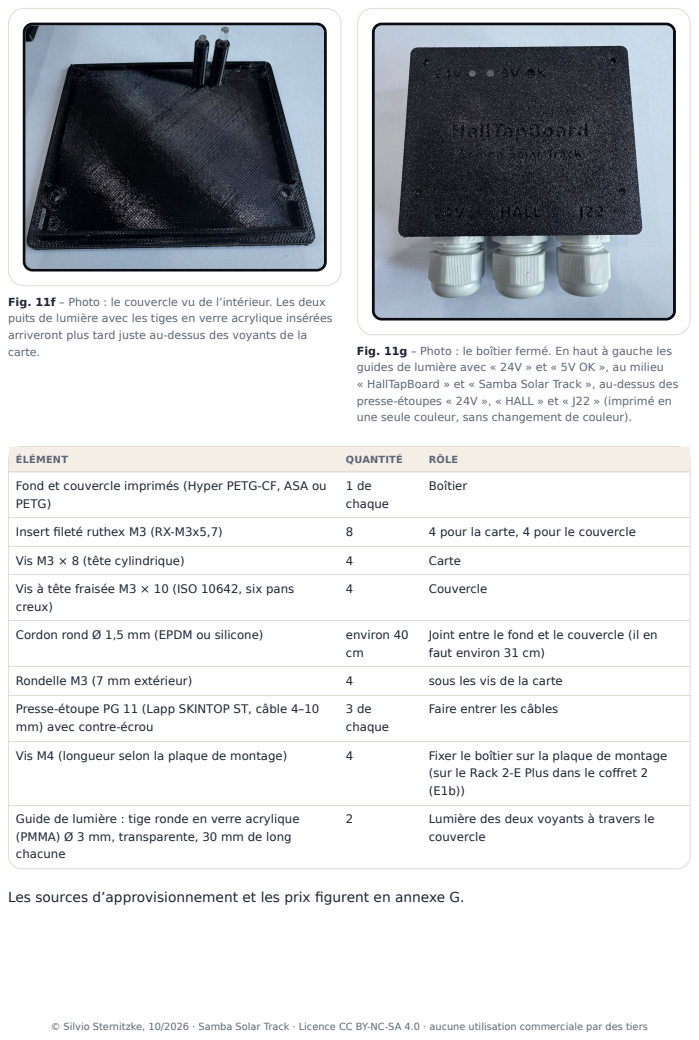
[picture p27: page 44]
carte.; Fig. 11g – Photo : le boîtier fermé. En haut à gauche les; ÉLÉMENT; QUANTITÉ; RÔLE; 1 de chaque; Boîtier; Insert fileté ruthex M3 (RX-M3x5,7); 4 pour la carte, 4 pour le couvercle; Vis M3 × 8 (tête cylindrique); Carte; Couvercle; Cordon rond Ø 1,5 mm (EPDM ou silicone); environ 40; Rondelle M3 (7 mm extérieur); sous les vis de la carte; 3 de chaque; Vis M4 (longueur selon la plaque de montage); Fixer le boîtier sur la plaque de montage; Lumière des deux voyants à travers le; couvercle

Fig. 11f – Photo : le couvercle vu de l’intérieur. Les deux
puits de lumière avec les tiges en verre acrylique insérées
arriveront plus tard juste au-dessus des voyants de la

guides de lumière avec « 24V » et « 5V OK », au milieu
« HallTapBoard » et « Samba Solar Track », au-dessus des
presse-étoupes « 24V », « HALL » et « J22 » (imprimé en
une seule couleur, sans changement de couleur).

Fond et couvercle imprimés (Hyper PETG-CF, ASA ou
PETG)

Vis à tête fraisée M3 × 10 (ISO 10642, six pans
creux)

Joint entre le fond et le couvercle (il en
faut environ 31 cm)

Presse-étoupe PG 11 (Lapp SKINTOP ST, câble 4–10
mm) avec contre-écrou

Faire entrer les câbles

(sur le Rack 2-E Plus dans le coffret 2

Guide de lumière : tige ronde en verre acrylique
(PMMA) Ø 3 mm, transparente, 30 mm de long
chacune

Les sources d’approvisionnement et les prix figurent en annexe G.

Contrôler la carte sur table (contrôle de réception)

Avant d’installer une carte livrée, vous la contrôlez sur table, sans rack et sans commande synchrone. Un composant monté à l’envers est ainsi repéré avant d’être relié à la ligne Hall des vérins ou à la commande. Il vous faut un multimètre, une alimentation de laboratoire avec limitation de courant réglable (24 V), une seconde source de tension de 5 V (par exemple un bloc secteur 5 V aux fils dénudés) et une résistance de 1 kΩ. Les valeurs attendues sont calculées, pas mesurées sur un prototype.

Câble pas trop fin
Un presse-étoupe PG 11 assure l’étanchéité pour des câbles de 4 à 10 mm de diamètre extérieur. Il ne maintient pas des fils isolés ou des câbles très fins (par exemple 3 × 0,14 mm²). Pour la ligne Hall, prenez un câble gainé, par exemple LiYY 3 × 0,25 mm² ou 3 × 0,5 mm², et mesurez le diamètre extérieur avant l’achat (les diamètres de câble indiqués ici sont des hypothèses).

⚠️

Ne remplace pas le coffret sur le rack
Le boîtier imprimé protège la carte contre le contact, la poussière et les projections dans le coffret. Le cordon d’étanchéité arrête en plus l’humidité et la poussière ; le boîtier n’a toutefois pas été testé pour un indice de protection. Il doit donc être placé dans un coffret fermé (sur le Rack 2-E Plus le coffret 2 (E1b)), pas en plein air.

ℹ️

Ne jamais raccorder J1 avec la polarité inversée lorsque J2 est enfiché
La carte ne supporte une inversion de polarité sur J1 que tant que rien n’est enfiché sur J2 et J3. Si J2 est enfiché sur la commande synchrone, une inversion de J1 met le 24 V, par la masse de la carte, sur le GND de la commande synchrone ; le fusible F2 doit alors couper. Vous ne faites donc l’essai d’inversion de polarité qu’ici, sur table, et avant le montage vous vérifiez toujours la polarité de J1 au multimètre avant d’enficher J2.

⛔

### Examiner

Examiner la carte à la loupe et comparer l’orientation des composants polarisés avec la
liste dans hardware/HallTapBoard/fertigung/smd/HINWEIS.txt (section « Vor dem Bezahlen
prüfen », c’est-à-dire « à vérifier avant de payer ») : D2 et D10 avec le trait côté cathode comme sur la sérigraphie, U1 avec la large languette de refroidissement vers le bord des voyants, U2 avec le repère sur la broche 1, U3 et U4 avec l’encoche au milieu du bord supérieur (broche 1 à sa gauche), D4 et D9 avec la cathode à l’angle de la sérigraphie. Résultat attendu : toutes les pièces sont placées comme sur la sérigraphie, aucun pont de soudure, aucune pièce manquante ou de travers.

1

### Mesurer la résistance hors tension

Multimètre en position résistance. Mesurer entre J1 pôle 1 et J1 pôle 2. Résultat attendu : aucune valeur proche de 0 Ω ; la valeur augmente lentement, car un condensateur se charge. Mesurer ensuite chaque pôle de J3 par rapport à J1 pôle 2 et à J2 pôle 3. Résultat attendu : ouvert (plus de 20 MΩ ou « OL »), car la distance d’isolement se trouve entre eux. Enfin J2 pôle 3 par rapport à J1 pôle 2. Résultat attendu : quelques ohms (le fusible F2, environ 3,6 Ω à froid selon la description du composant ; soustraire la valeur des pointes de mesure tenues ensemble).

2

### Mettre sous 24 V

Régler l’alimentation de laboratoire sur 24 V et une limitation de courant de 50 mA, sortie coupée. Plus sur J1 pôle 1, moins sur J1 pôle 2 (rien n’est enfiché sur J2 et J3). Activer la sortie. Résultat attendu : les deux voyants s’allument, « 24V » en jaune et « 5V OK » en vert, à peu près aussi lumineux. L’alimentation affiche un courant de quelques mA à environ 16 mA (calculé sans signal Hall : environ 4 à 6 mA). Entre le condensateur C2 (ou la cathode de D10) et J1 pôle 2, vous mesurez 4,85 à 5,15 V. Si l’alimentation limite immédiatement à 50 mA ou si rien ne s’allume : couper, ne pas installer la carte.

3

### Contrôler le canal A

Le 24 V reste appliqué. Appliquer la source 5 V via la résistance de 1 kΩ sur J2 pôle 1 (H1), son moins sur J2 pôle 3. Régler le multimètre sur test de diode (la position avec le symbole d’une diode), pointe rouge sur J3 pôle 1, noire sur J3 pôle 3. Résultat attendu : avec 5 V sur H1, le multimètre affiche une valeur (le contact est fermé) ; sans le 5 V, il affiche « OL » (le contact est ouvert). La valeur exacte affichée dépend du multimètre (hypothèse).

4

### Contrôler le canal B

De même avec J2 pôle 2 (H2) et J3 pôle 2. Résultat attendu : comme pour le canal A. Si c’est le mauvais canal qui réagit ou aucun, la carte est mal équipée : ne pas l’installer.

5

### Essai d’inversion de polarité (uniquement ici)

Sortie coupée, retirer la source 5 V ; rien n’est enfiché sur J2 et J3. Inverser plus et moins sur J1 (plus sur le pôle 2), limitation de courant toujours à 50 mA, sortie activée. Résultat attendu : les deux voyants restent éteints, l’alimentation n’affiche que quelques µA (presque 0 mA). Ensuite, couper la sortie et rebrancher dans le bon sens. Résultat attendu : les deux voyants se rallument.

6

Imprimer et préparer le boîtier

### Choisir le matériau

Pour le projet d’impression prêt à l’emploi, Creality Hyper PETG-CF. Le filament à fibres de carbone use la buse ; l’imprimante a besoin d’une buse trempée. Possible aussi : l’ASA, qui reste indéformable même par forte chaleur dans le coffret, ou le PETG, si la température dans le coffret reste sûrement inférieure à environ 60 °C (hypothèse ; valeurs des matériaux non vérifiées). Résultat attendu : vous avez assez de matériau pour environ 115 g (estimation).

1

### Ouvrir le projet d’impression

Avec la Creality K2 Plus et une buse de 0,4 mm, ouvrir dans Creality Print le fichier
HallTapBoard-gehaeuse_K2Plus_HyperPETG-CF_0.4mm.3mf . Les deux pièces y sont correctement
orientées sur un même plateau. Pour imprimer les pièces séparément, prenez
HallTapBoard-gehaeuse-unterteil_K2Plus_HyperPETG-CF_0.4mm.3mf (le fond seul) et HallTapBoard-gehaeuse-deckel_K2Plus_HyperPETG-CF_0.4mm.3mf (le couvercle seul) ; la pièce y
est chaque fois au centre du plateau, les réglages sont les mêmes. L’orientation : le fond sur sa base, ouverture vers le haut, le couvercle avec la face extérieure vers le haut (texte en haut). Sont réglés l’imprimante, le filament Hyper PETG-CF et le processus « 0.20mm Standard », ainsi que, sur l’objet, 5 lignes de paroi, 6 couches inférieures et 6 supérieures, remplissage gyroïde 30 % et supports arborescents : pour le fond, supports aussi sur le modèle (ils n’apparaissent que dans les trois grands trous ronds de la paroi, car ils y reposent sur le bord inférieur du trou), pour le couvercle, supports
uniquement depuis le plateau. Avec une autre imprimante, charger les deux fichiers STL ; ils sont déjà dans cette position. Réglez alors les supports de la même manière : avec « supports uniquement depuis le plateau » pour le fond, les trois trous ne reçoivent pas de supports. Résultat attendu : l’aperçu ne montre des supports pour le fond que dans les trois grands trous ronds de la paroi ; pour le couvercle, des supports partent du plateau sous toute la face intérieure, seuls les deux puits de lumière reposent eux-mêmes sur le plateau.

2

### Texte

Le texte du couvercle est en gras et en relief de 0,8 mm ; comme le couvercle est posé face extérieure vers le haut, il est imprimé librement en dernières couches et reste net. Pour un texte bicolore, régler dans le logiciel d’impression, pour le couvercle, un changement de couleur au niveau de la face supérieure de la plaque du couvercle (là où commencent les lettres) et changer de filament. Résultat attendu : les lettres se détachent nettement de la surface et sont lisibles à un mètre de distance.

3

### Face inférieure du couvercle

La face intérieure du couvercle est imprimée sur des supports. C’est là que le couvercle reposera plus tard sur le cordon d’étanchéité. Retirer les supports avec précaution et entièrement, puis poncer à plat avec du papier abrasif (grain 240) la surface au-dessus de la rainure, c’est-à-dire le bord sur tout le pourtour. Résultat attendu : le bord est sans restes de supports et repose sans jour sur un support plan. On n’a pas encore vérifié si la surface ainsi obtenue est vraiment étanche (voir « Encore ouvert » ci-dessous).

4

### Imprimer et contrôler

Imprimer les deux pièces et les laisser refroidir. Casser les supports des trois grands trous et lisser le bord avec un ébavureur ou un couteau. Poser le couvercle à l’essai sans cordon d’étanchéité. Résultat attendu : le bord de guidage du couvercle glisse avec un léger jeu à l’intérieur contre la collerette du fond, le couvercle et le fond affleurent sur tout le pourtour, les quatre fraisures sont exactement au-dessus des trous dans les coins. Le presse-étoupe s’insère de l’extérieur dans son trou ; s’il entre trop difficilement, retoucher prudemment le trou avec un foret étagé (cote nominale 18,9 mm).

5

Fer à souder chaud
Pour poser les inserts filetés, le fer à souder devient aussi chaud que pour souder, et l’insert reste chaud encore un moment après. Ne pas toucher la panne ni l’insert avec les doigts, poser le fond sur un support stable et résistant à la chaleur, et toujours reposer le fer à souder dans son support.

⛔

### Poser les inserts filetés

Régler le fer à souder, muni d’une panne d’insertion, à peu près à la température d’impression du matériau (hypothèse, aucune indication du fabricant consultée). Placer un insert, côté étroit vers le bas, sur un trou, y introduire le fer à souder et laisser l’insert s’enfoncer verticalement sans pression jusqu’à ce qu’il affleure avec le bord supérieur. Retirer ensuite le fer bien droit. Procéder ainsi pour les huit : quatre dans les dômes au fond, quatre en haut dans les coins renforcés. Résultat attendu : chaque insert est droit et à fleur ; une vis M3 se visse facilement à la main après refroidissement.

6

### Poser les presse-étoupes

Commencer par le presse-étoupe du milieu : entre deux presse-étoupes déjà posés, il reste à peine de place à l’extérieur pour la clé. Passer le presse-étoupe de l’extérieur dans son trou, visser le contre-écrou à la main à l’intérieur. Puis maintenir le contre-écrou à l’intérieur et serrer le presse-étoupe à l’extérieur avec une clé de 22 (Lapp indique 4,0 Nm, donc fermement à la main, sans forcer). Une clé plate de 24 se place difficilement à l’intérieur sous le bord et à côté des voisins ; maintenez alors le contre-écrou avec une pince ou avec les doigts. Ensuite, les deux presse-étoupes extérieurs de la même manière. Laisser encore l’écrou chapeau extérieur desserré. Résultat attendu : les trois presse-étoupes sont bien fixés et ne tournent plus.

7

### Contrôler la carte avant de la monter

Contrôlez d’abord sur table chaque carte livrée, comme décrit plus haut sous « Contrôler la carte sur table ». Résultat attendu : toutes les étapes de contrôle de cette section sont réussies.

8
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
