ssbingo/samba-solar-track/handbuch/Samba-Solar-Track-Handbuch-10Zoll-NL.pdf

© Silvio Sternitzke, 10/2026 · Samba Solar Track · Licentie CC BY-NC-SA 4.0 · geen commercieel gebruik door derden

HANDLEIDING · 10-INCH-VERSIE · IN VOORBEREIDING

# Samba Solar Track

## De besturing die je zonnepaneel de zon laat

volgen en het bij storm in veiligheid brengt.

Waveshare ESP32-P4-WIFI6-Touch-LCD-10.1 met de printplaat RearCircuitBoard_10
De hoofdvariant van Samba Solar Track. Deze handleiding beschrijft de opbouw, de printplaat, de aansluitingen, de accu, het eerste flashen van de firmware en de controle van de hardware. De firmware voor dit board is begonnen en op een testboard geflasht (ze start, de wifi werkt), maar verder nog niet op het apparaat getest; de printplaat bestaat als ontwerp 0.12 en is nog niet gefabriceerd of
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
