ssbingo/samba-solar-track/handbuch/img/HallTapBoard-gehaeuse-foto-4.jpg

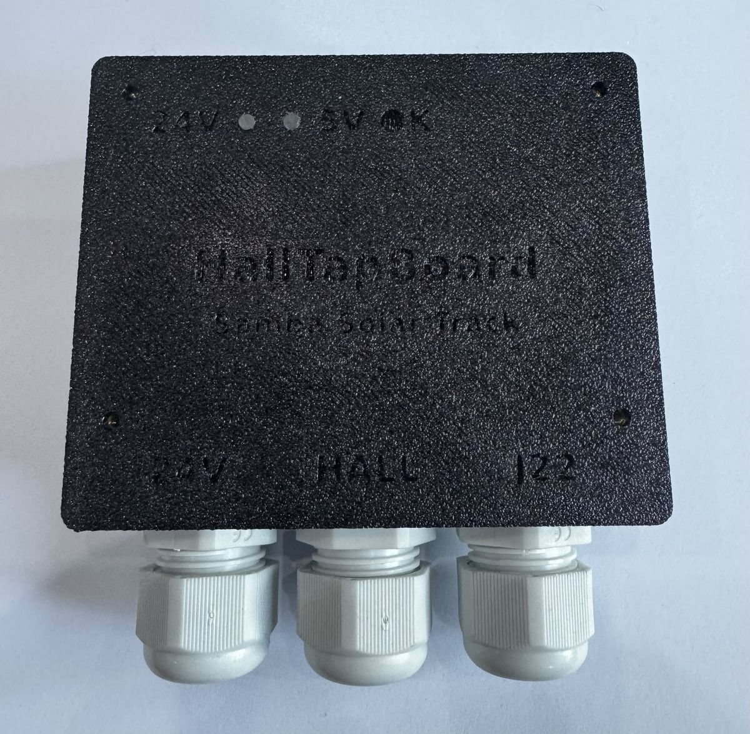
handbuch/img/HallTapBoard-gehaeuse-foto-4.jpg
