ssbingo/samba-solar-track/handbuch/img/HallTapBoard-gehaeuse-schnitt.png

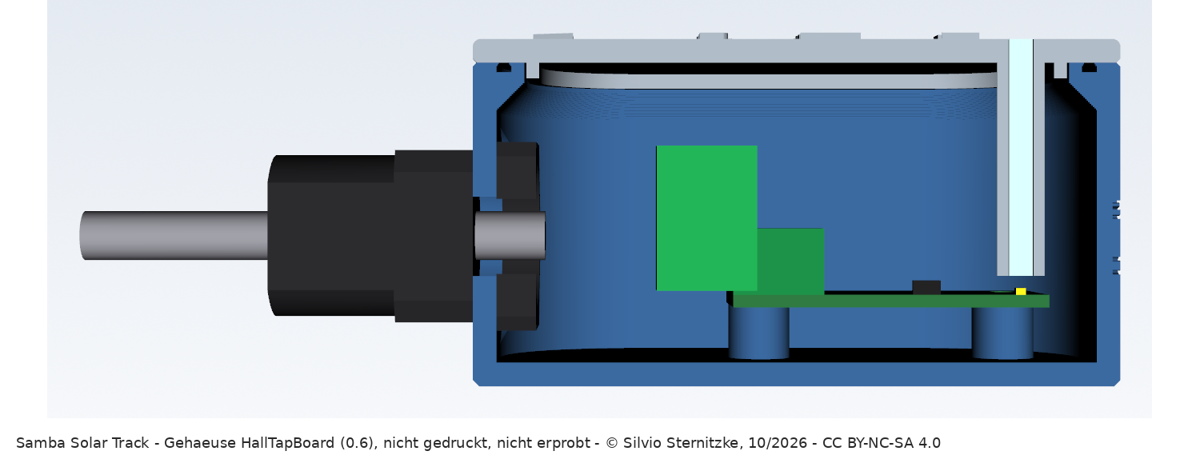
handbuch/img/HallTapBoard-gehaeuse-schnitt.png
