ssbingo/samba-solar-track/handbuch/img/screens10/b02_akku_laedt.png

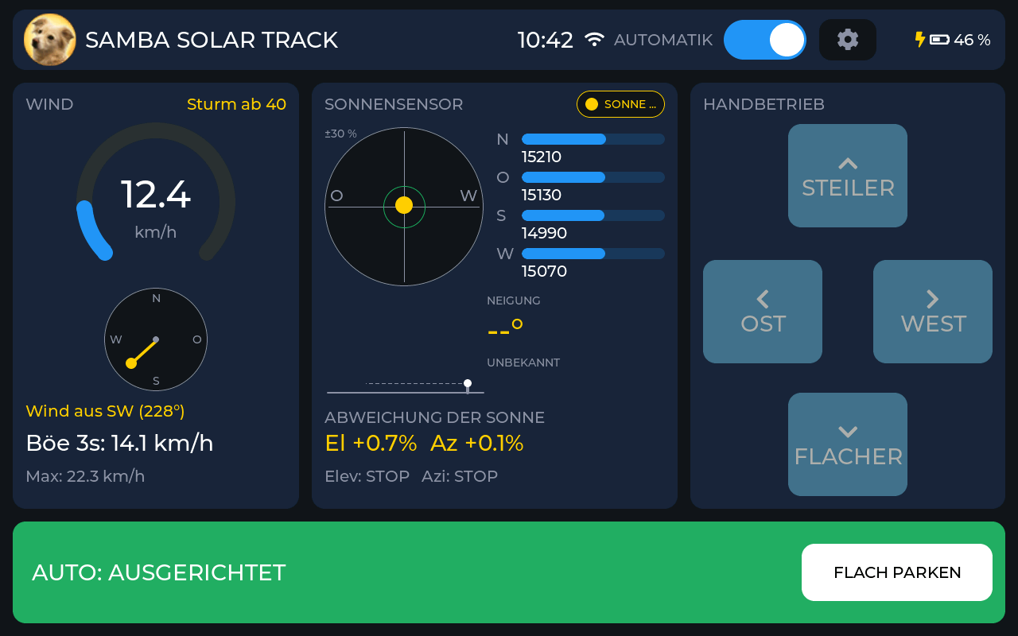
handbuch/img/screens10/b02_akku_laedt.png
