ssbingo/samba-solar-track/handbuch/img/screens10/n01_neigung_karte_unbekannt.png

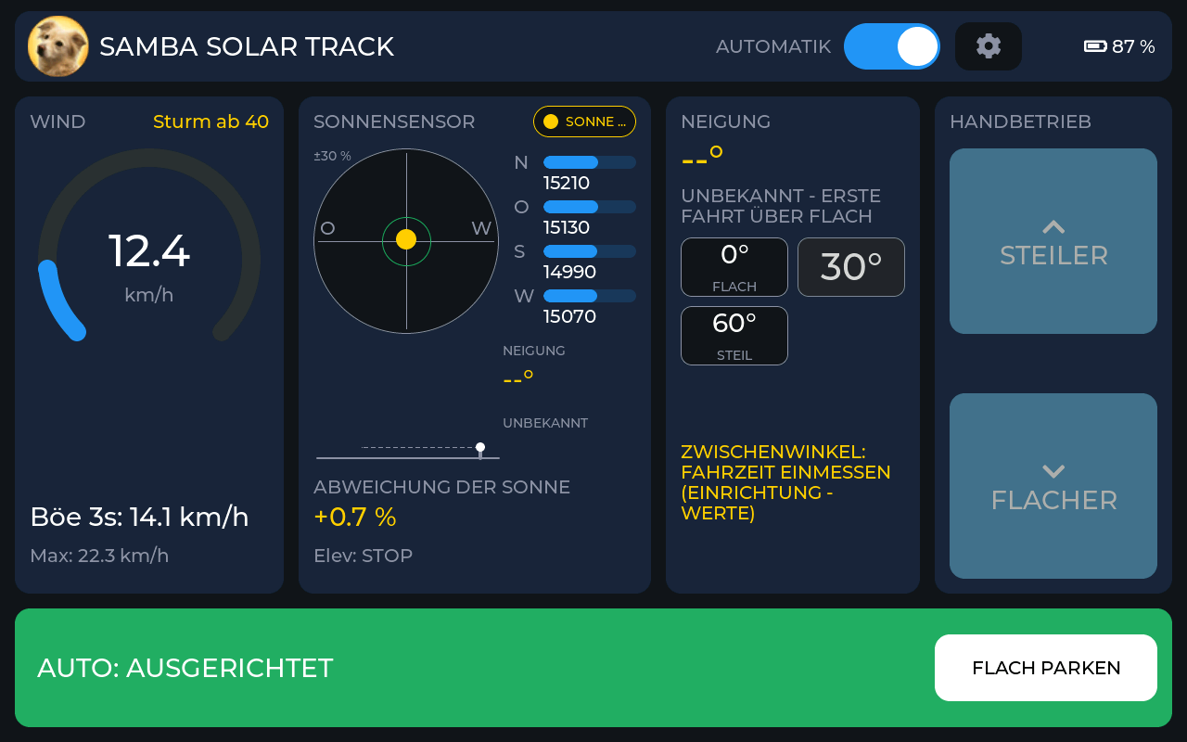
handbuch/img/screens10/n01_neigung_karte_unbekannt.png
