ssbingo/samba-solar-track/handbuch/img/screens10/n07_neigung_pause_einschaltdauer.png

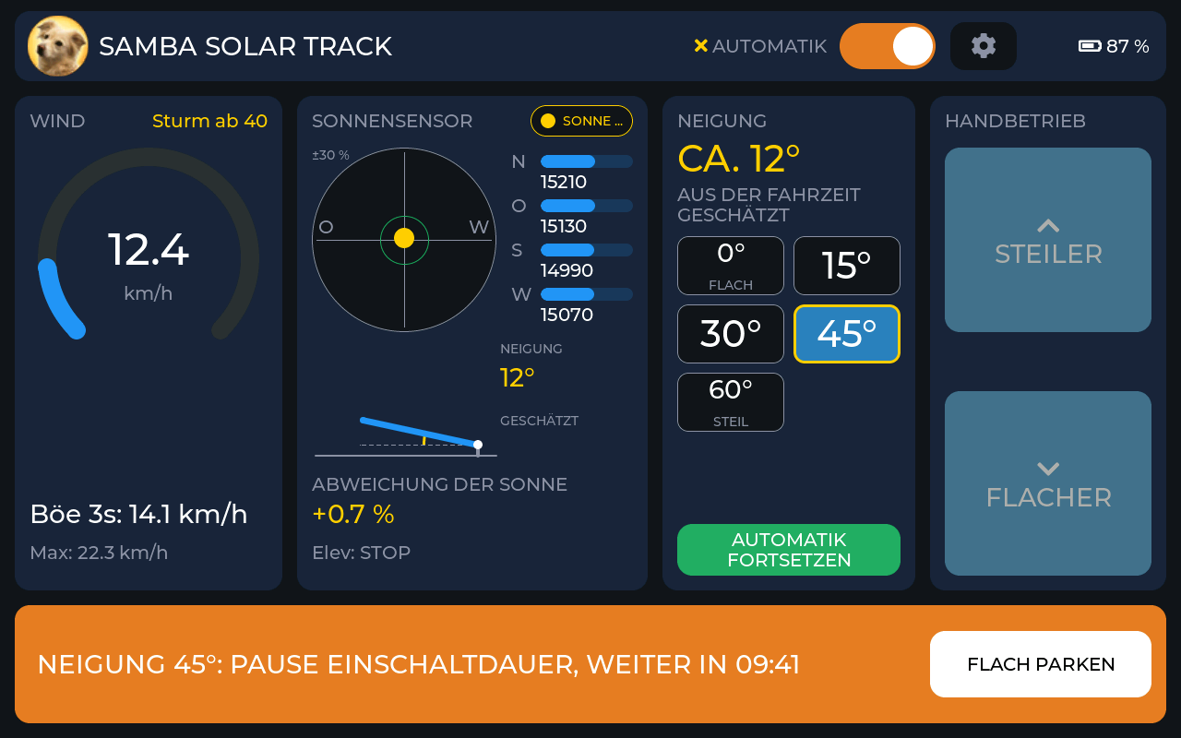
handbuch/img/screens10/n07_neigung_pause_einschaltdauer.png
