ssbingo/samba-solar-track/handbuch/img/screens10/n25_einmessen_misst_auf.png

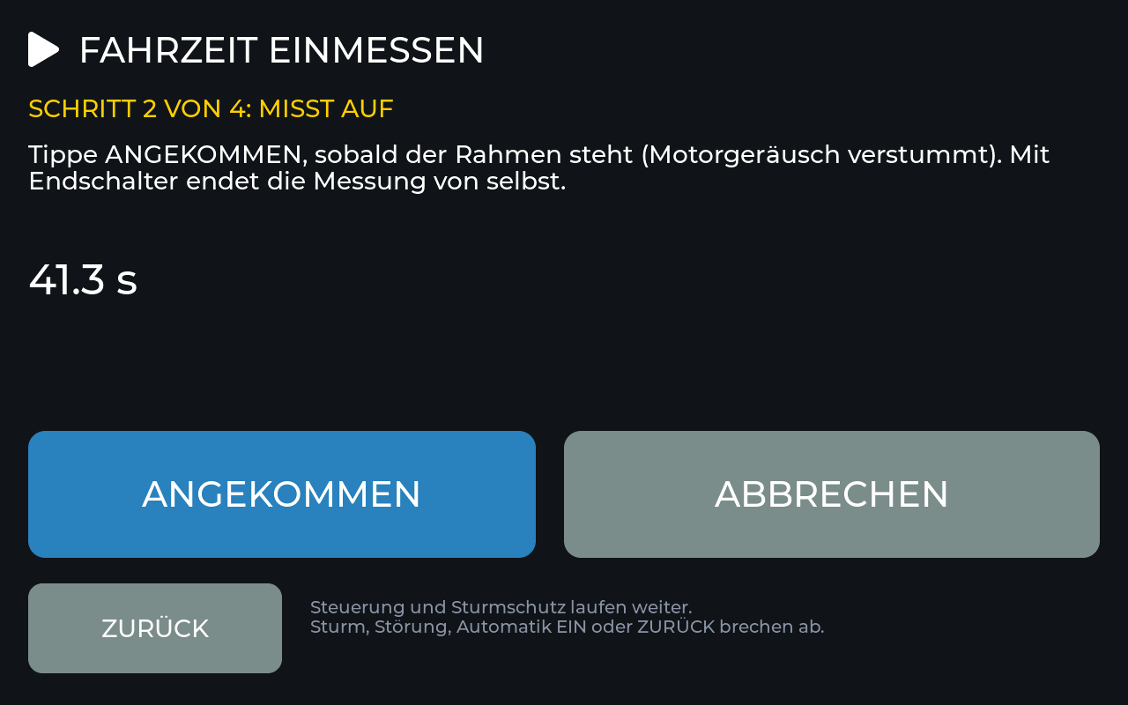
handbuch/img/screens10/n25_einmessen_misst_auf.png
