ssbingo/samba-solar-track/handbuch/img/screens10/n26_einmessen_auf_gemessen.png

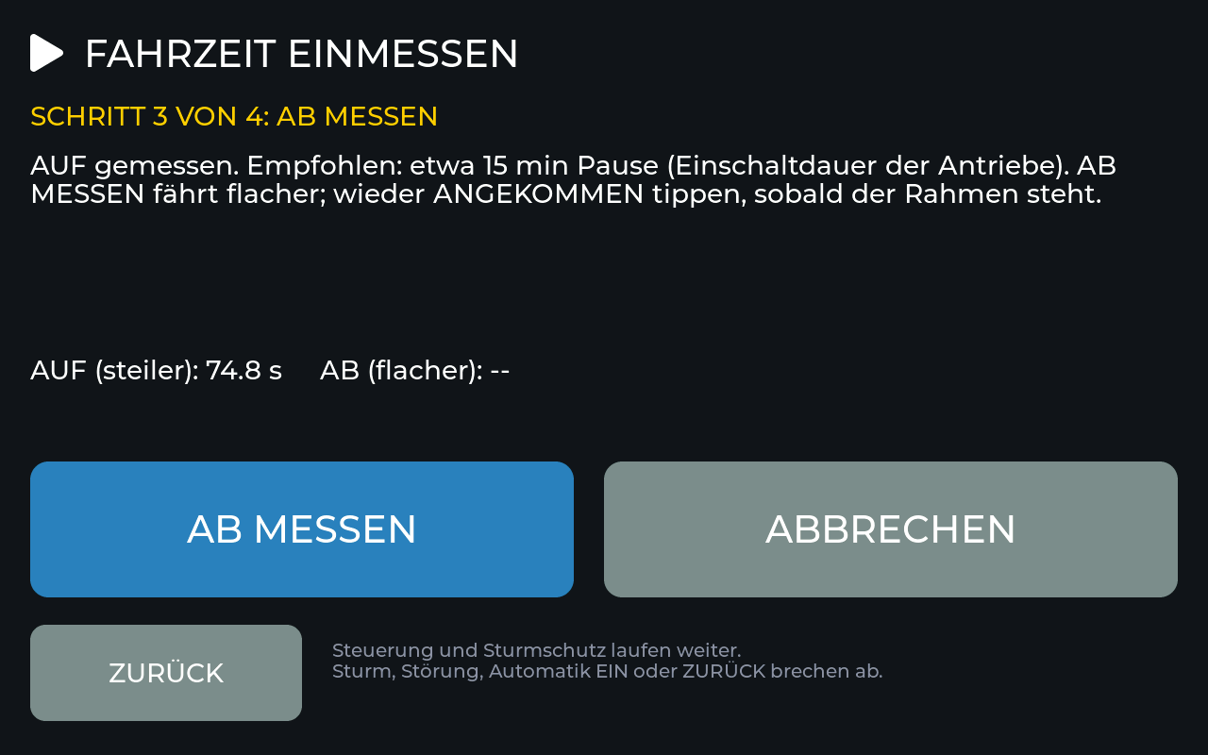
handbuch/img/screens10/n26_einmessen_auf_gemessen.png
