ssbingo/samba-solar-track/handbuch/img/screens10/p05_werte.png

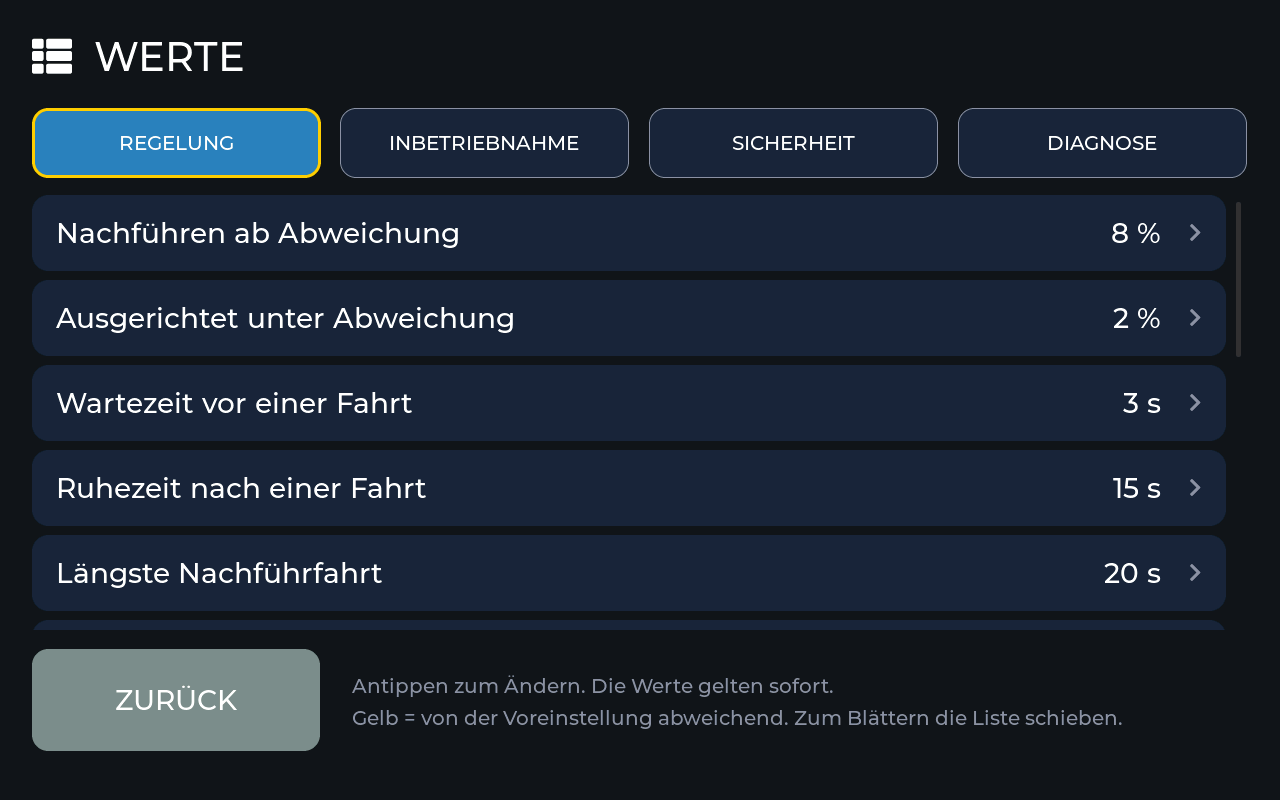
handbuch/img/screens10/p05_werte.png
