ssbingo/samba-solar-track/handbuch/img/screens10/p06_design.png

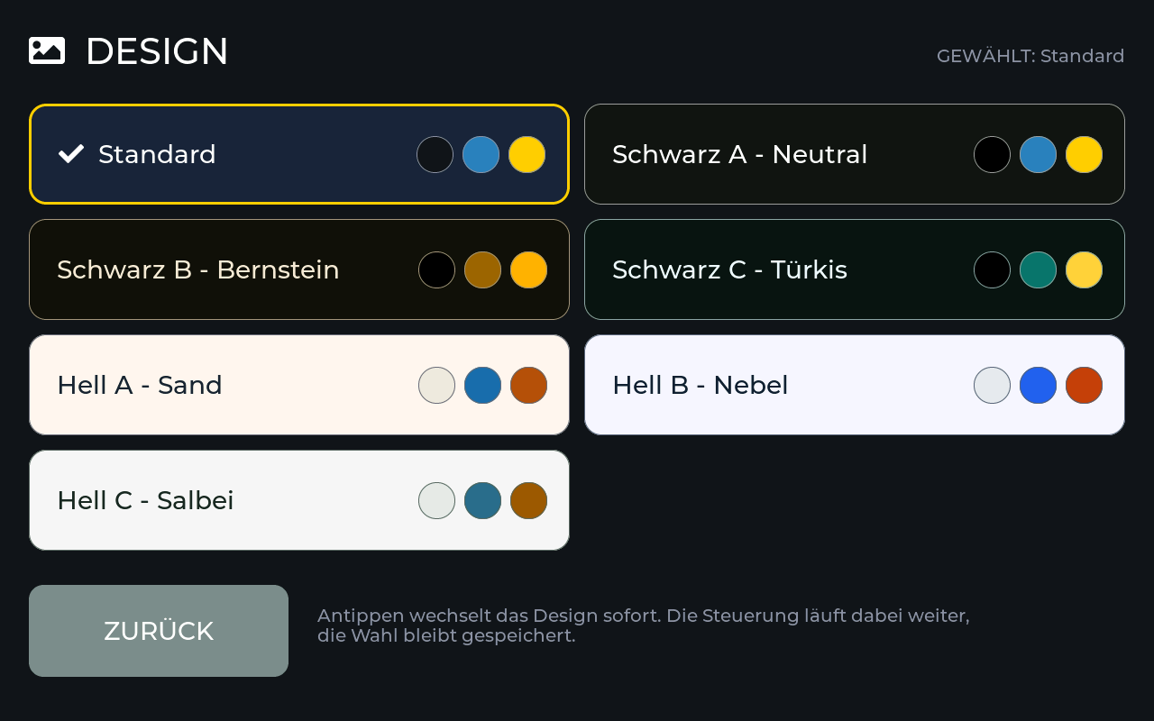
handbuch/img/screens10/p06_design.png
