ssbingo/samba-solar-track/handbuch/img/screens10/p07_firmware.png

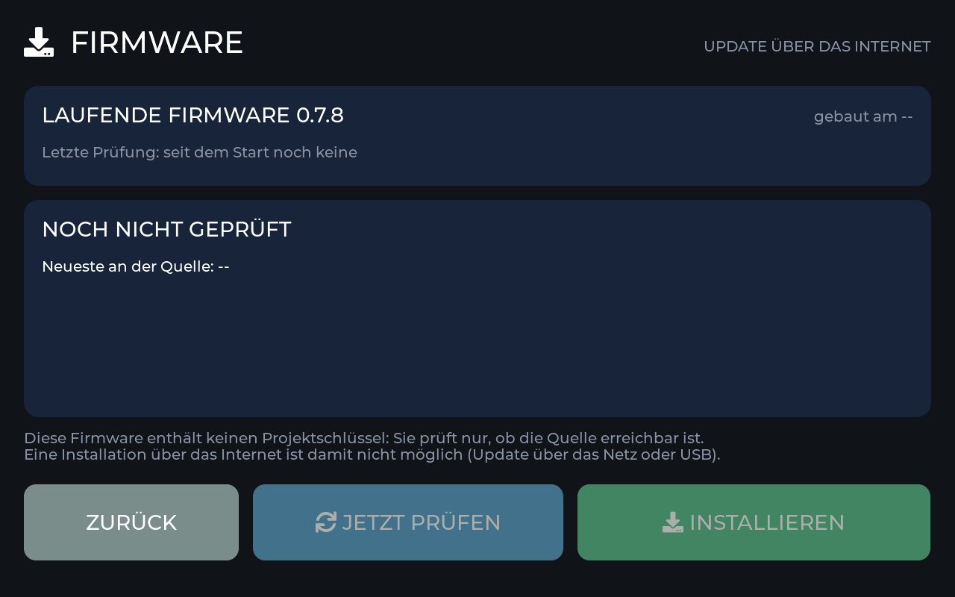
handbuch/img/screens10/p07_firmware.png
