ssbingo/samba-solar-track/handbuch/img/screens10/p08_ton.png

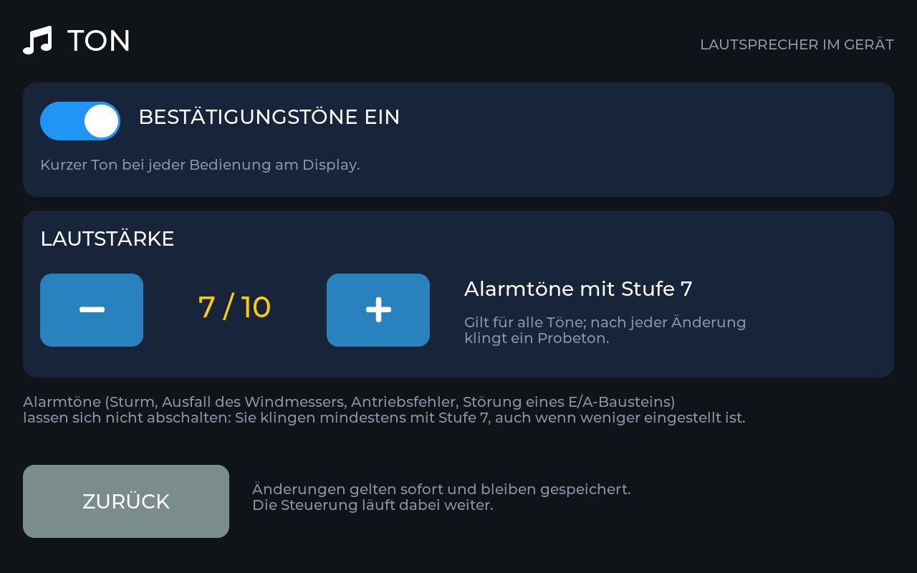
handbuch/img/screens10/p08_ton.png
