ssbingo/samba-solar-track/handbuch/img/screens10/p11_bildschirm.png

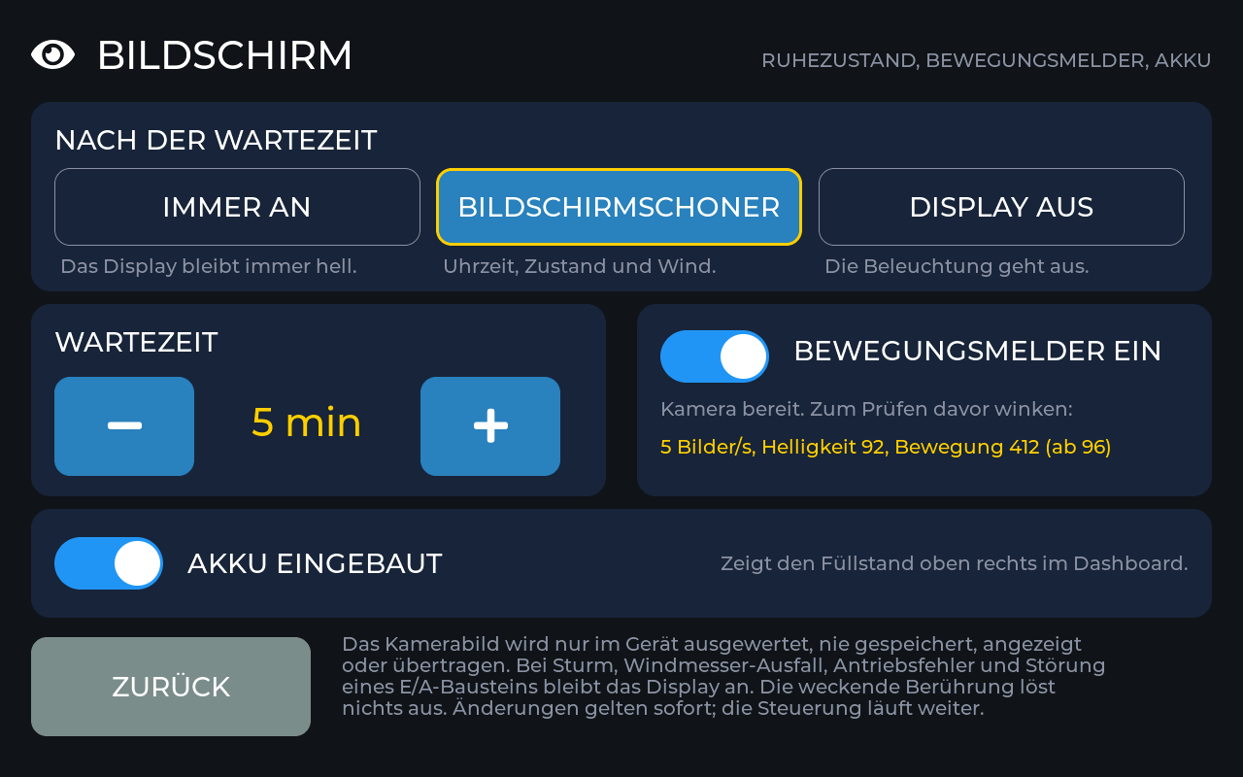
handbuch/img/screens10/p11_bildschirm.png
