ssbingo/samba-solar-track/handbuch/img/screens10/r01_werte_reset_zeile.png

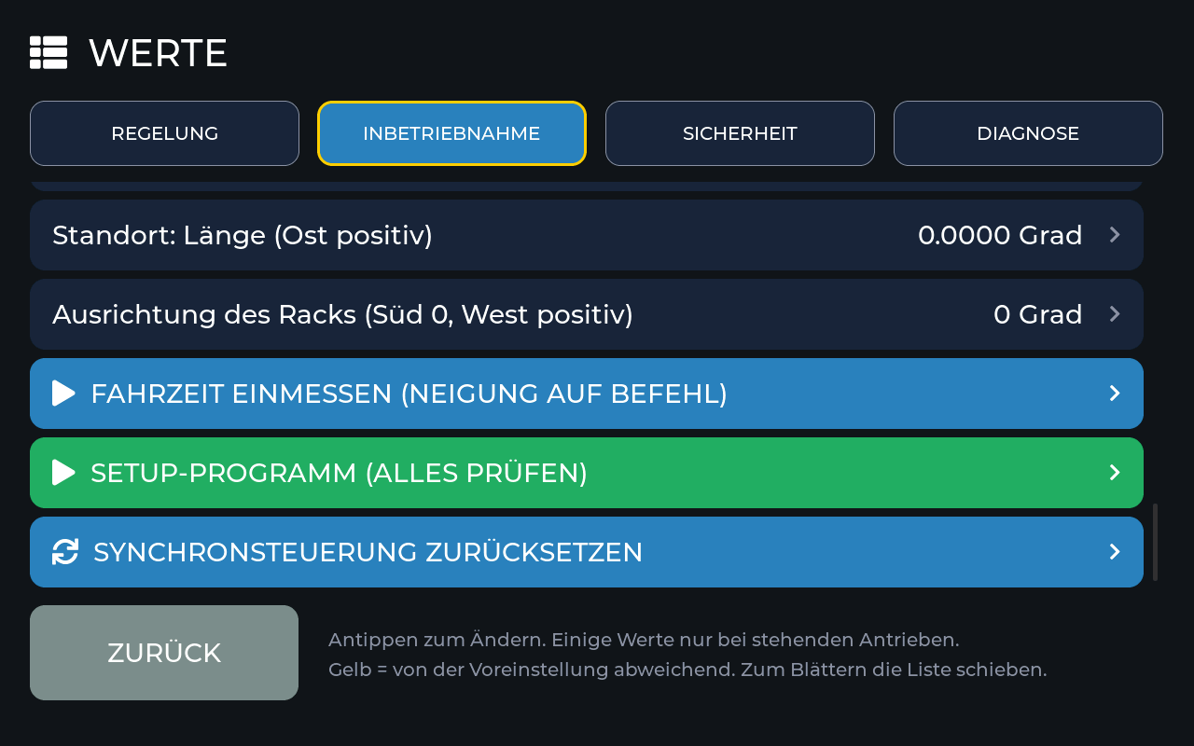
handbuch/img/screens10/r01_werte_reset_zeile.png
