ssbingo/samba-solar-track/handbuch/img/screens10/r06_reset_rueckfrage_2achsen.png

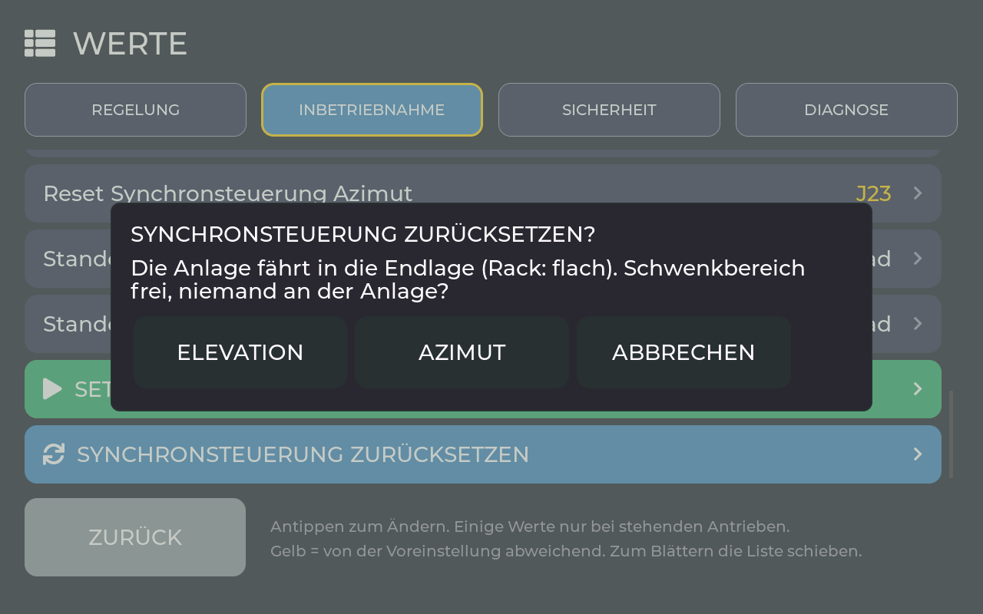
handbuch/img/screens10/r06_reset_rueckfrage_2achsen.png
