ssbingo/samba-solar-track/handbuch/img/screens10/r12_band_phase3_einfahren.png

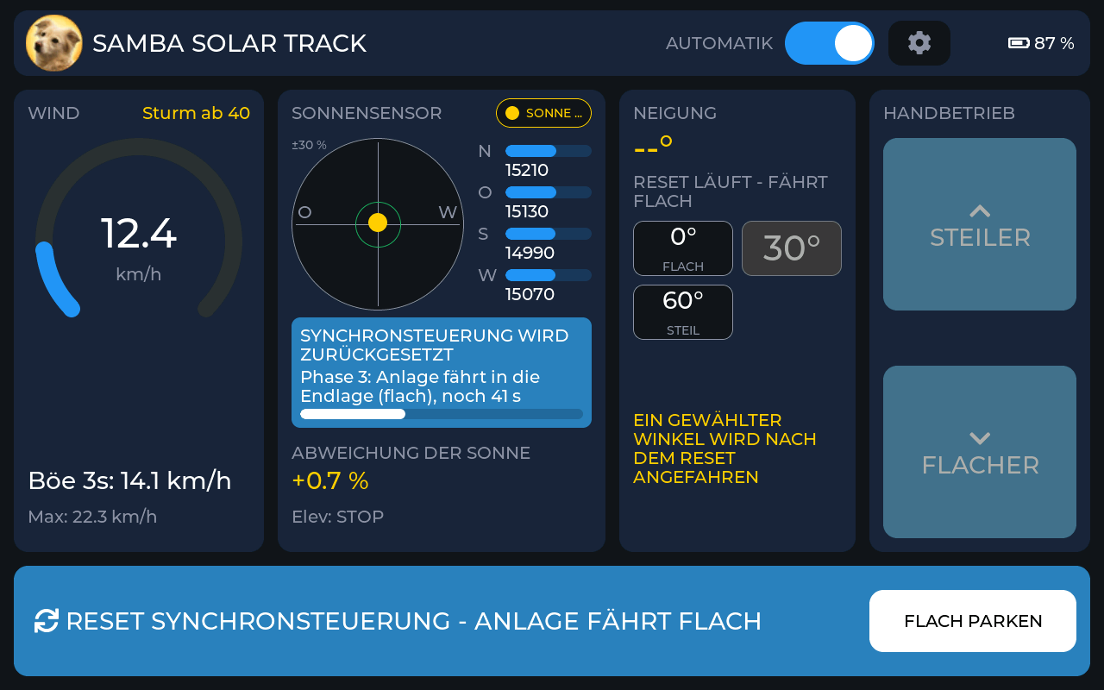
handbuch/img/screens10/r12_band_phase3_einfahren.png
