ssbingo/samba-solar-track/handbuch/img/screens10/v05_wandler_aus.png

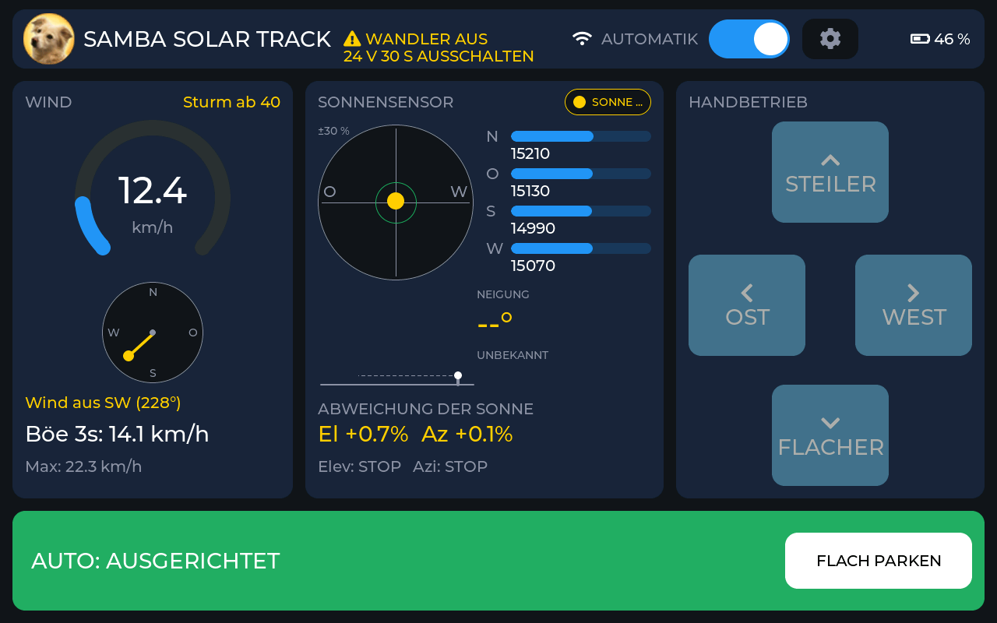
handbuch/img/screens10/v05_wandler_aus.png
