ssbingo/samba-solar-track/handbuch/img/screens10/x08_ausrichtung.png

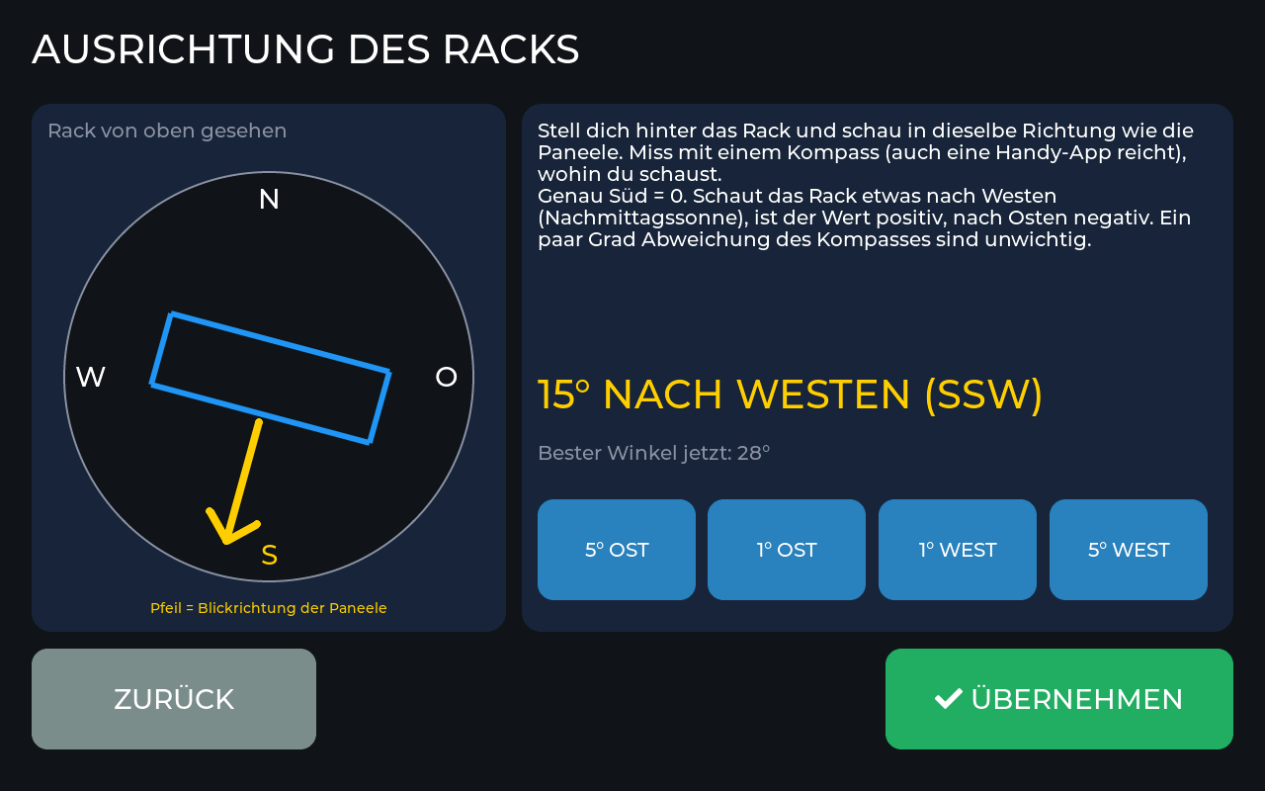
handbuch/img/screens10/x08_ausrichtung.png
