ssbingo/samba-solar-track/handbuch/img/screens10/x09_dashboard_sonne_fehlt.png

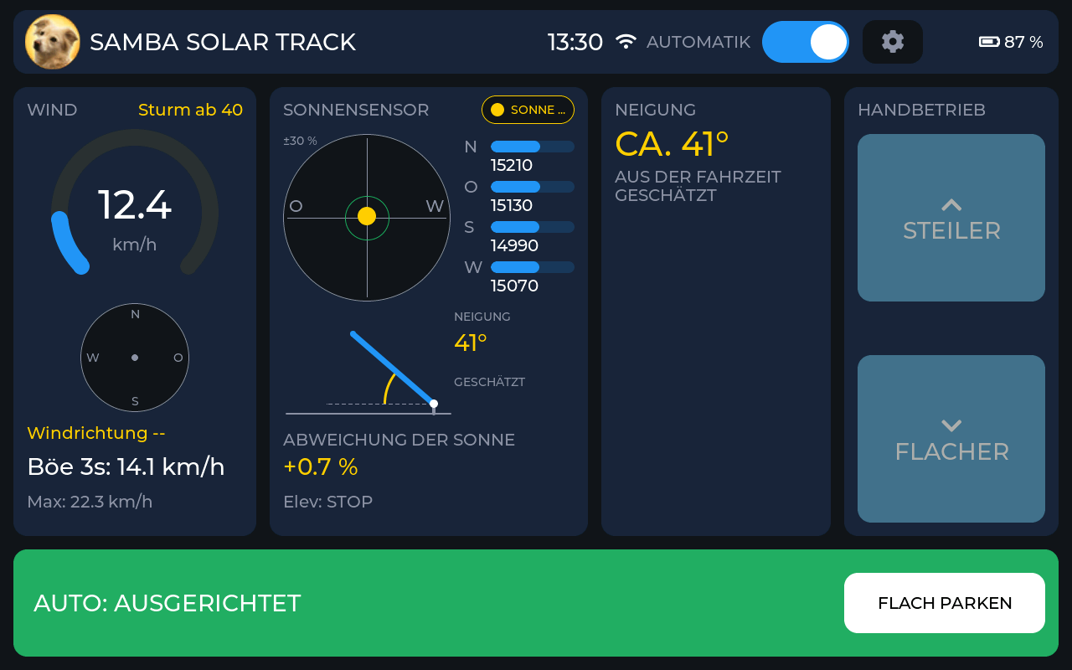
handbuch/img/screens10/x09_dashboard_sonne_fehlt.png
