ssbingo/samba-solar-track/handbuch/img/screens10/y1_03_platine_fehler.png

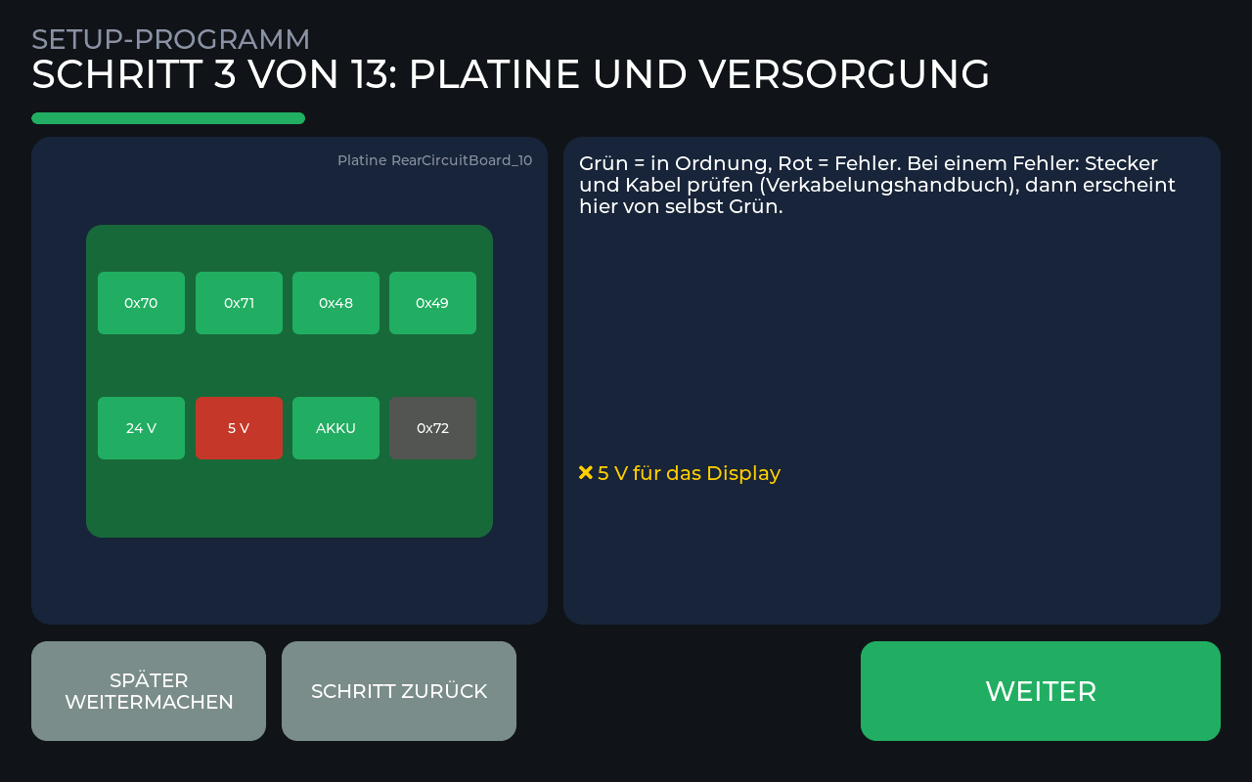
handbuch/img/screens10/y1_03_platine_fehler.png
