ssbingo/samba-solar-track/handbuch/img/screens10/y1_05_windmesser.png

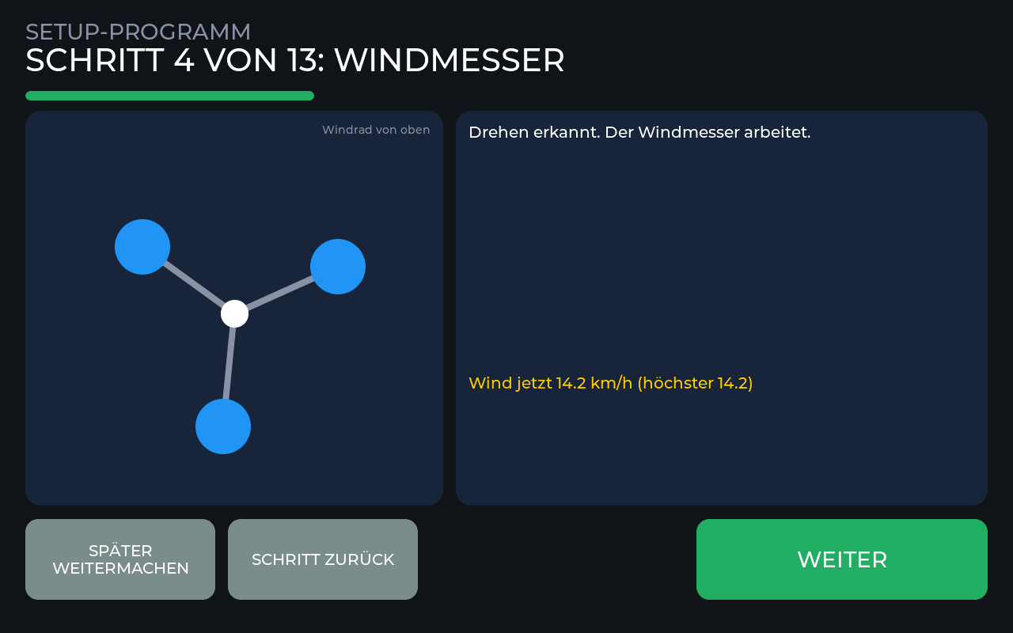
handbuch/img/screens10/y1_05_windmesser.png
