ssbingo/samba-solar-track/handbuch/img/screens10/y1_07_flach_probefahrt.png

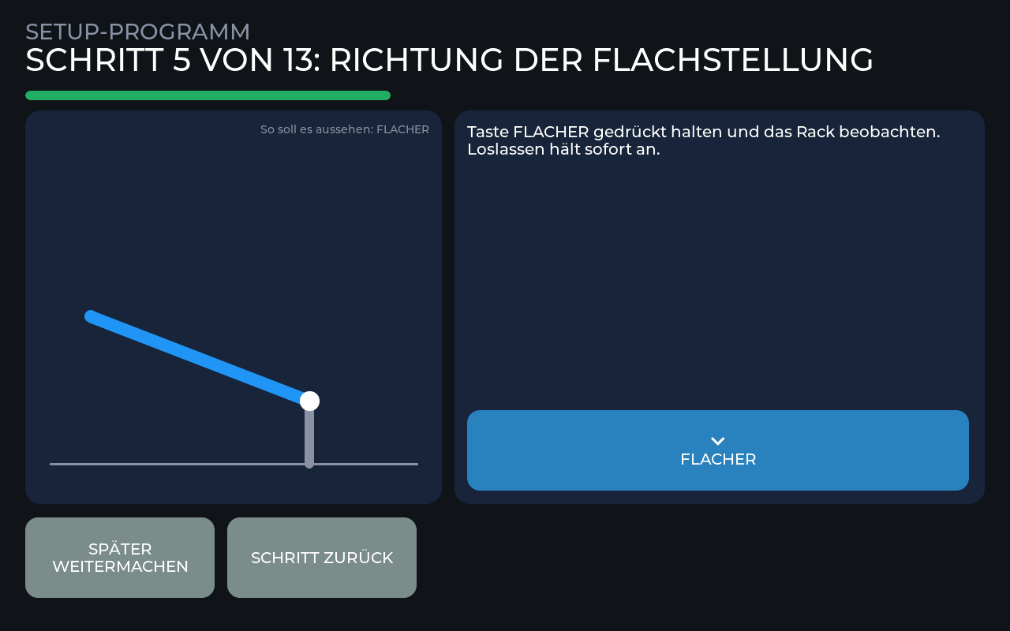
handbuch/img/screens10/y1_07_flach_probefahrt.png
