ssbingo/samba-solar-track/handbuch/img/screens10/y1_08_flach_frage.png

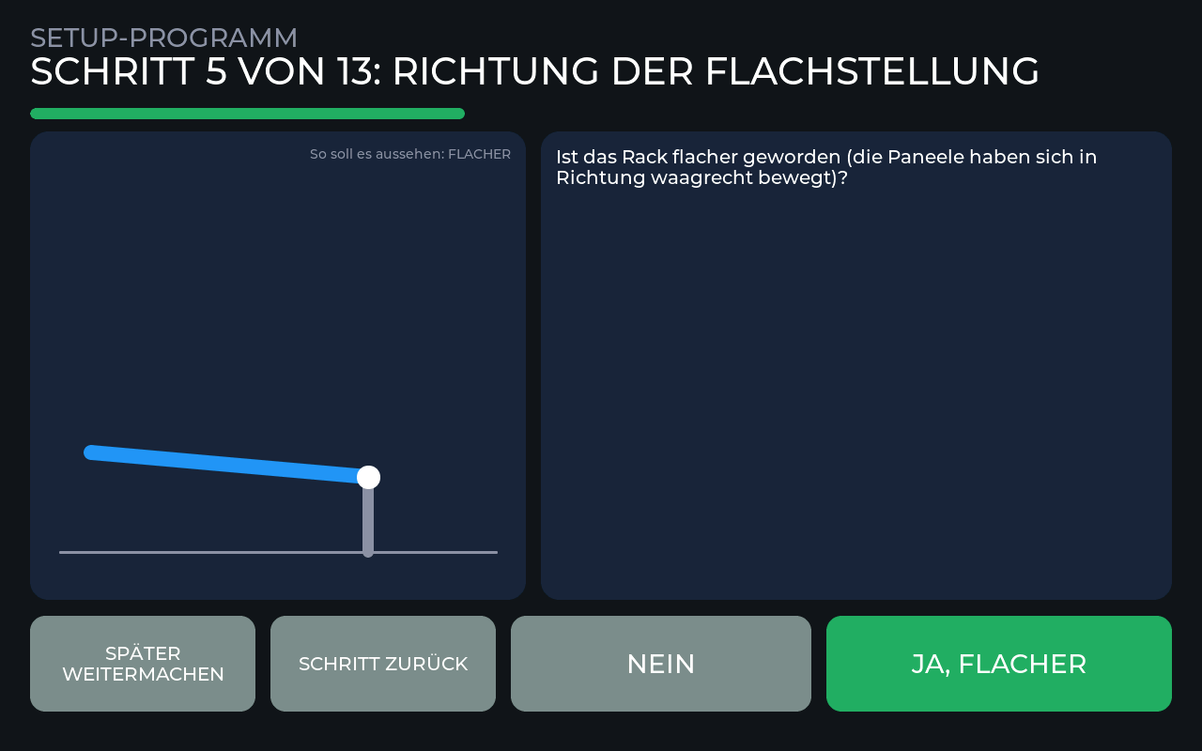
handbuch/img/screens10/y1_08_flach_frage.png
