ssbingo/samba-solar-track/handbuch/img/screens10/y1_09_flach_fahrt.png

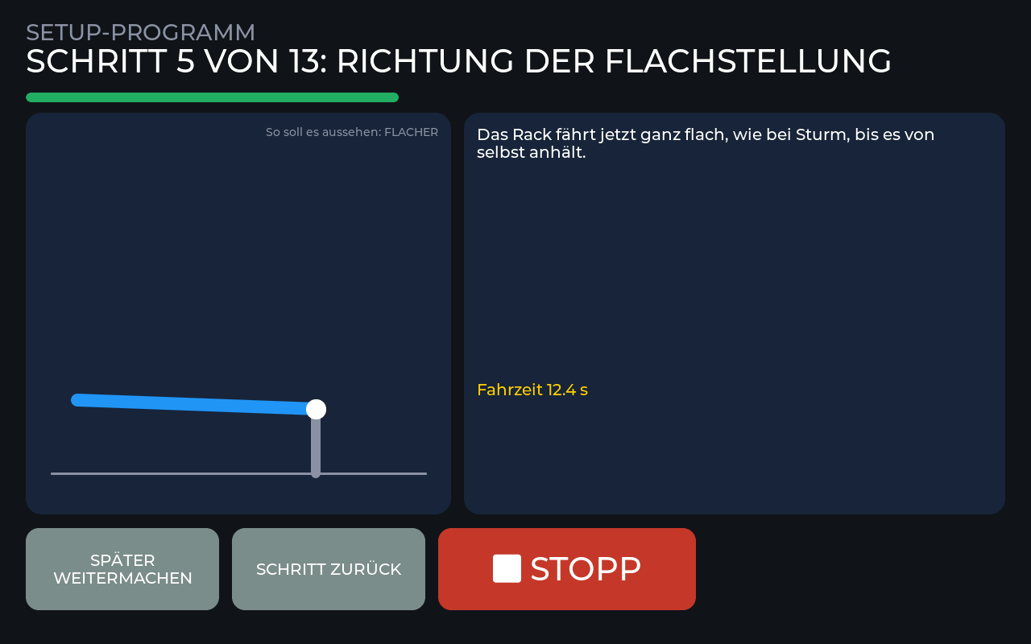
handbuch/img/screens10/y1_09_flach_fahrt.png
