ssbingo/samba-solar-track/handbuch/img/screens10/y1_12_winkel_ablesen.png

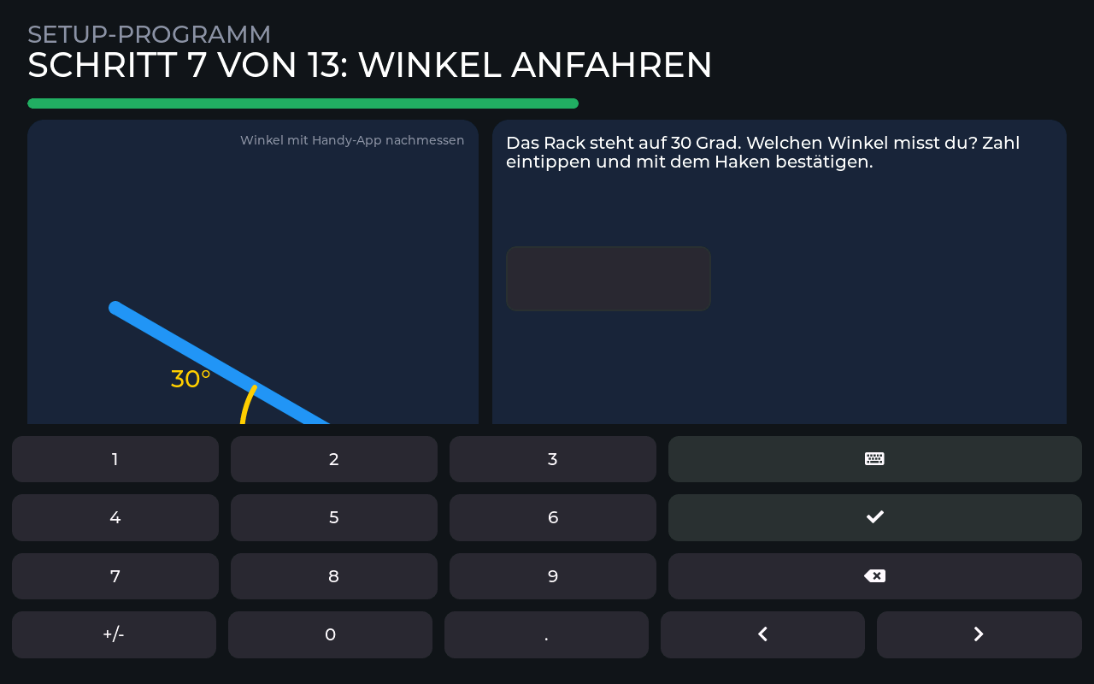
handbuch/img/screens10/y1_12_winkel_ablesen.png
