ssbingo/samba-solar-track/handbuch/img/screens10/y1_22_bewegung.png

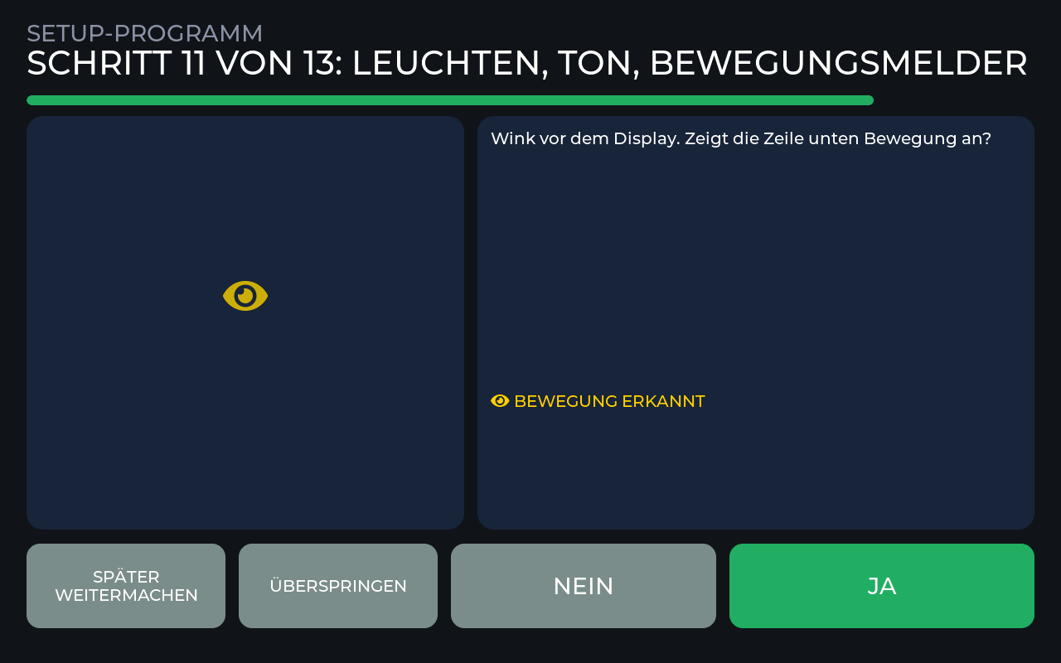
handbuch/img/screens10/y1_22_bewegung.png
