ssbingo/samba-solar-track/handbuch/img/screens10/y1_23_probelauf.png

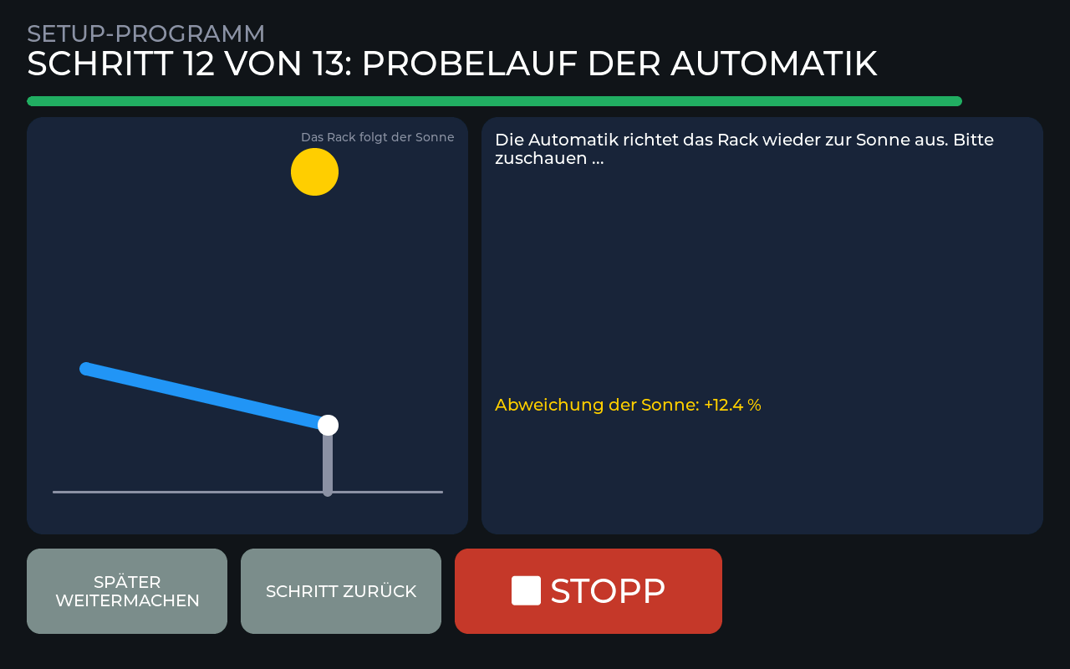
handbuch/img/screens10/y1_23_probelauf.png
