ssbingo/samba-solar-track/handbuch/img/screens10_en/n08_neigung_45_gehalten.png

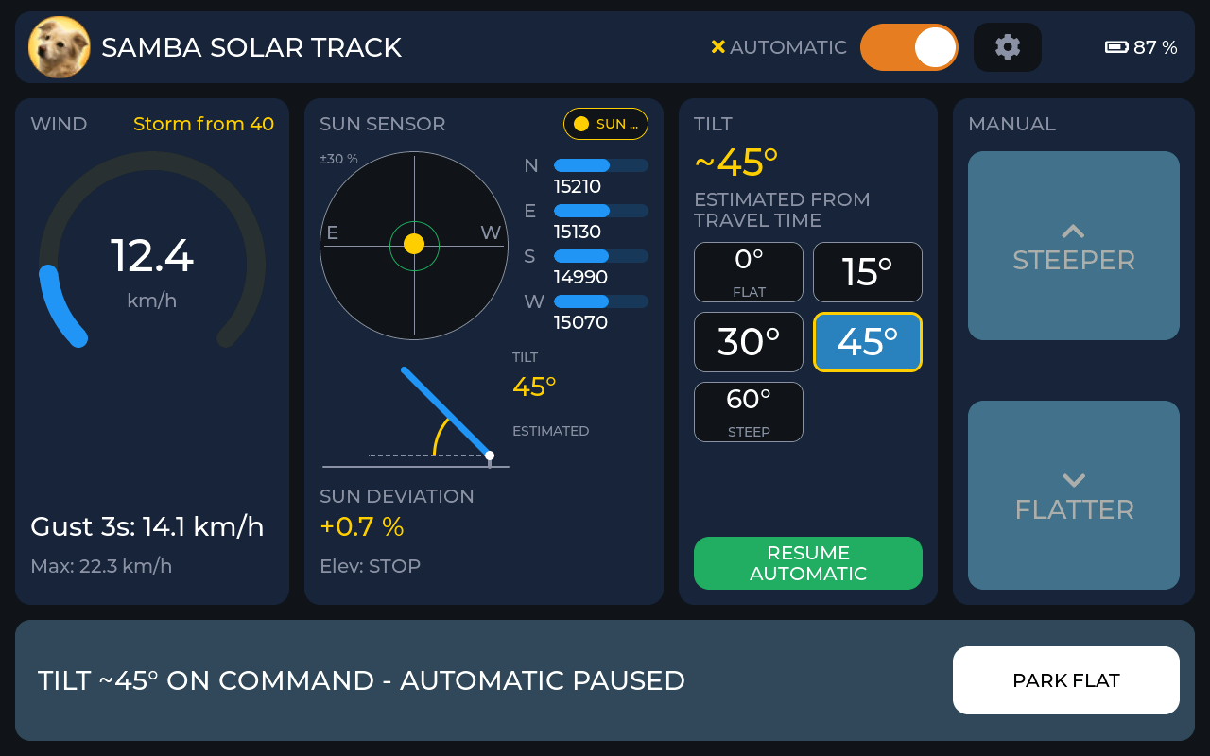
handbuch/img/screens10_en/n08_neigung_45_gehalten.png
