ssbingo/samba-solar-track/handbuch/img/screens10_en/n11_neigung_nicht_eingemessen.png

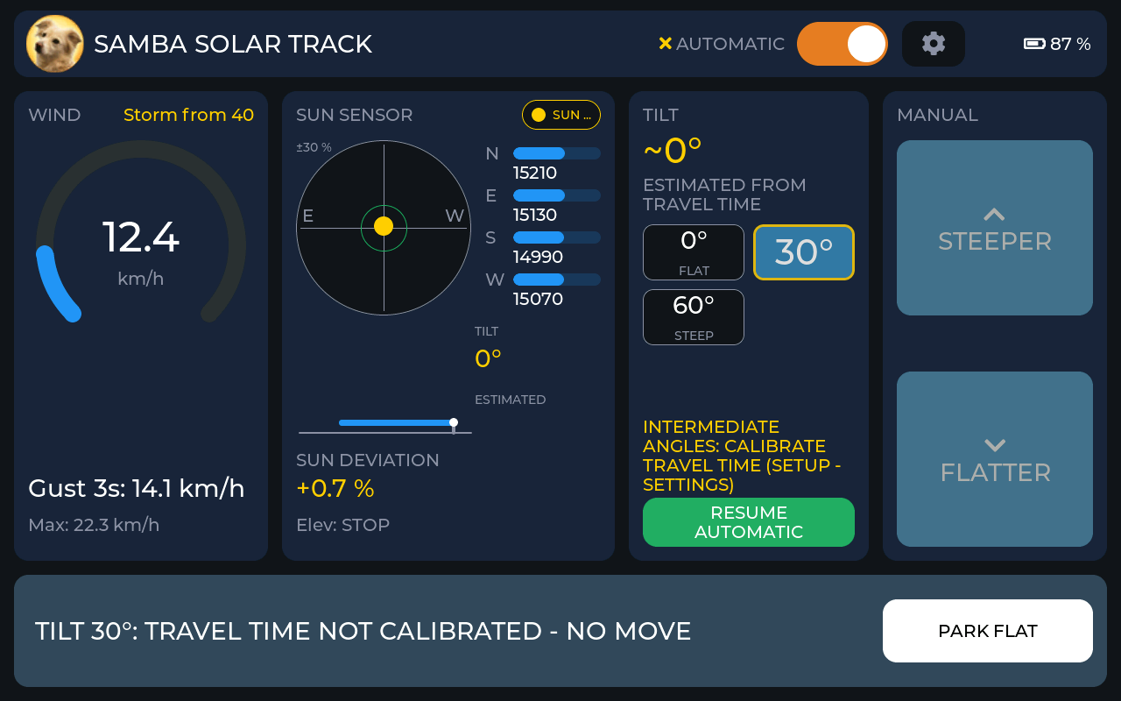
handbuch/img/screens10_en/n11_neigung_nicht_eingemessen.png
