ssbingo/samba-solar-track/handbuch/img/screens10_en/n21_werte_fahrzeiten.png

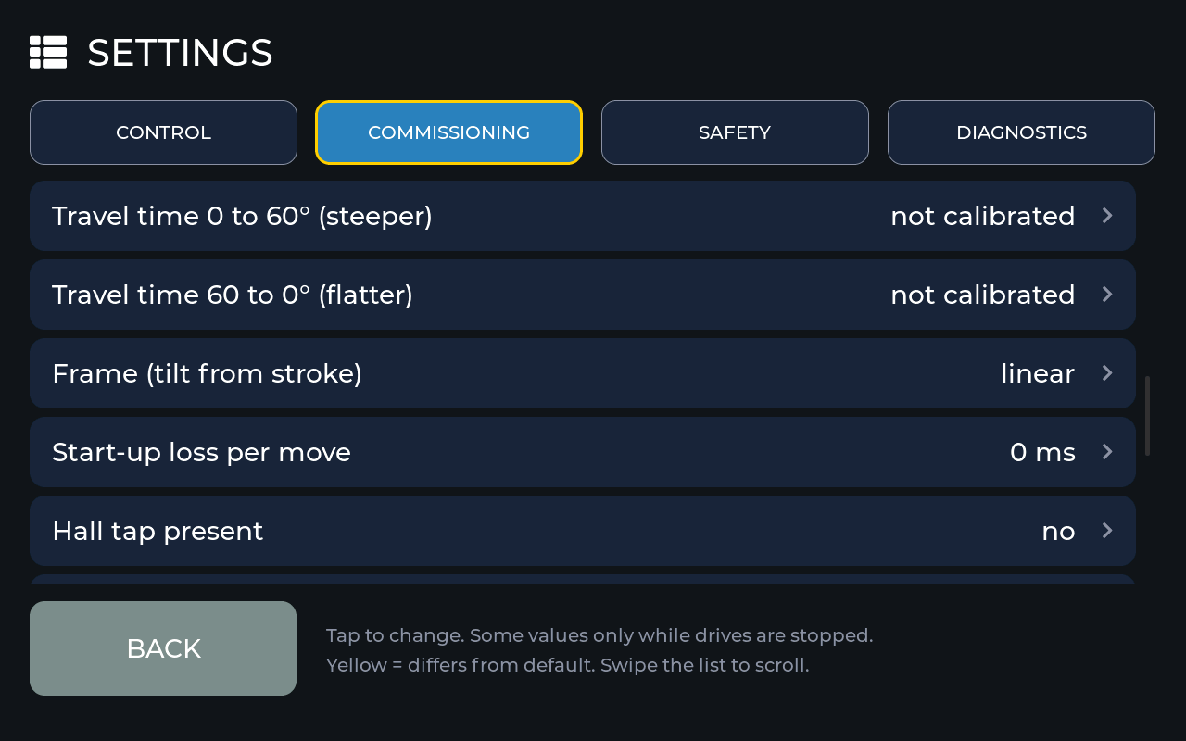
handbuch/img/screens10_en/n21_werte_fahrzeiten.png
