ssbingo/samba-solar-track/handbuch/img/screens10_en/n28_einmessen_ergebnis.png

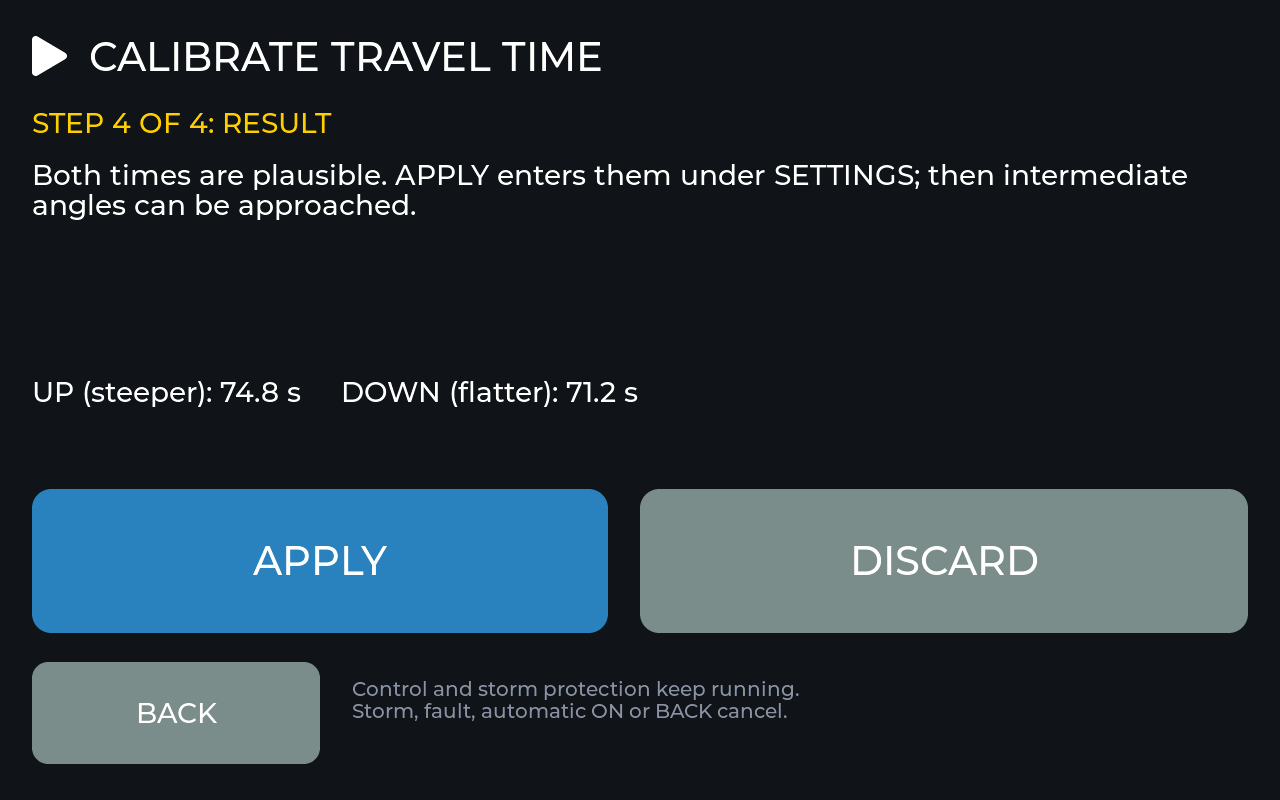
handbuch/img/screens10_en/n28_einmessen_ergebnis.png
