ssbingo/samba-solar-track/handbuch/img/screens10_en/p12_sprache.png

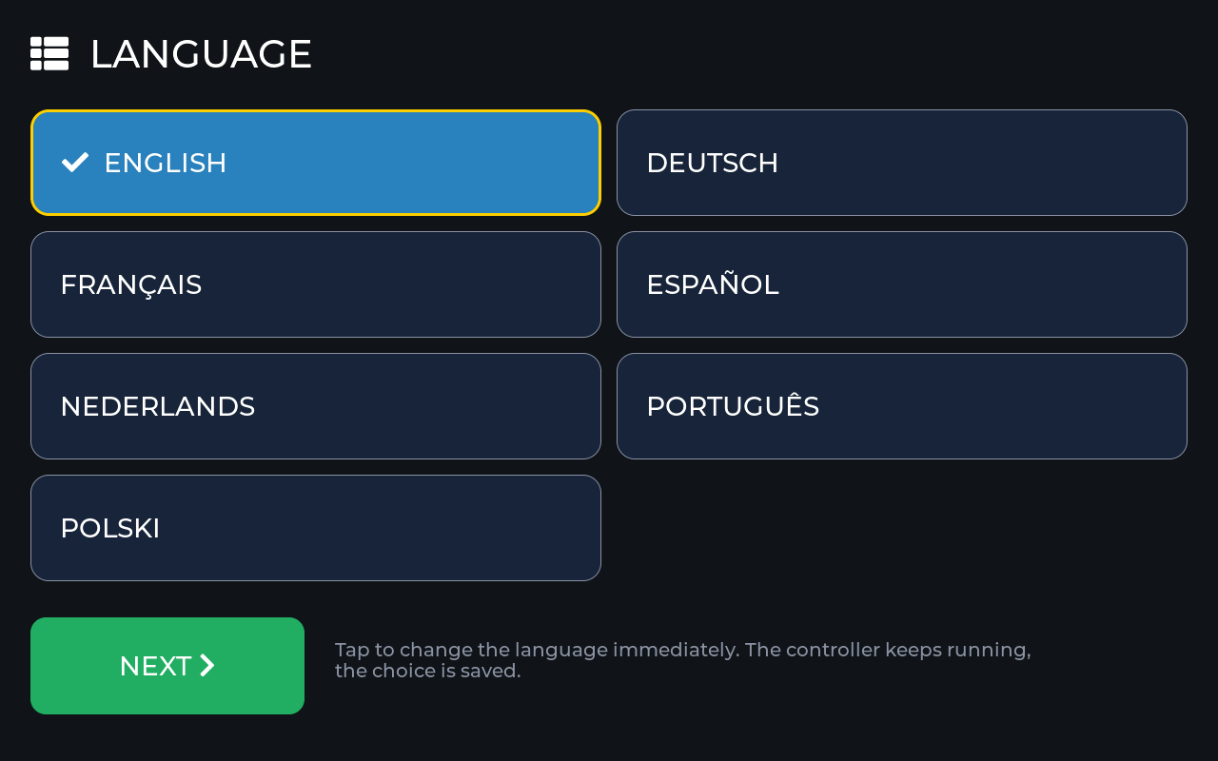
handbuch/img/screens10_en/p12_sprache.png
