ssbingo/samba-solar-track/handbuch/img/screens10_en/x03_sonne_animation.png

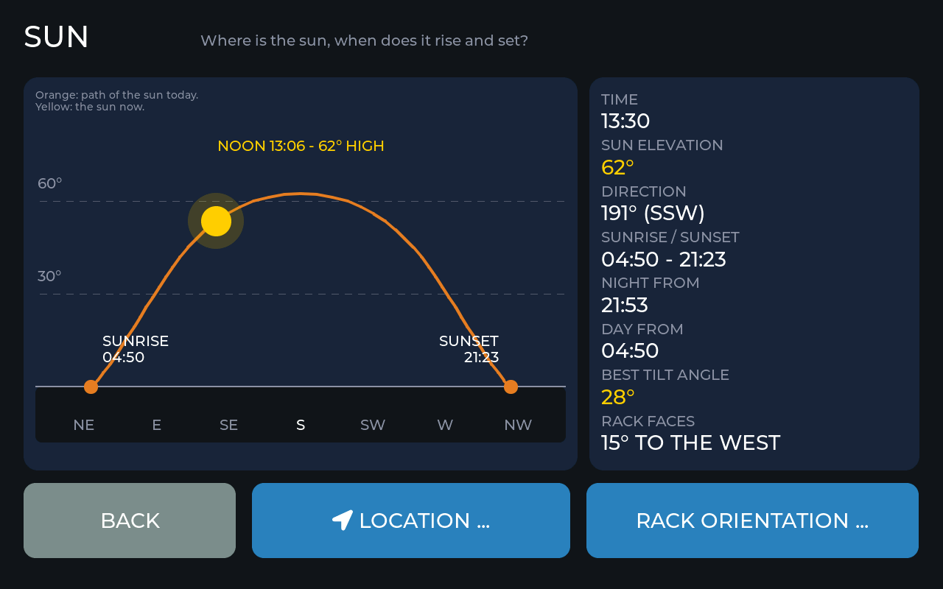
handbuch/img/screens10_en/x03_sonne_animation.png
