ssbingo/samba-solar-track/handbuch/img/screens10_en/x04_sonne_fehlt.png

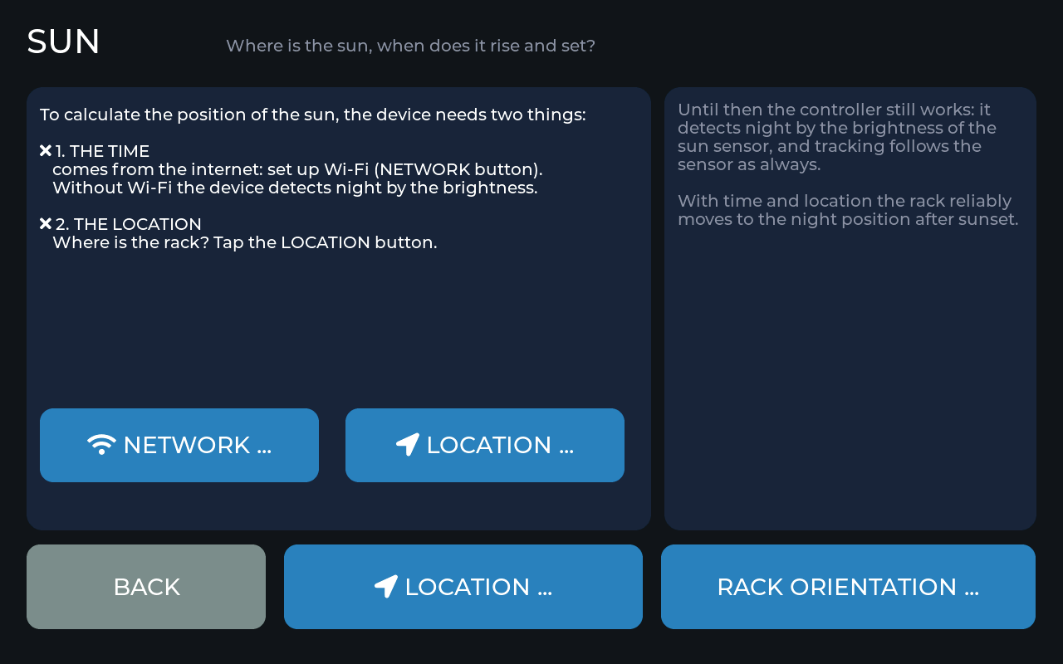
handbuch/img/screens10_en/x04_sonne_fehlt.png
