ssbingo/samba-solar-track/handbuch/img/screens10_en/x11_dashboard_sonne_2achsen.png

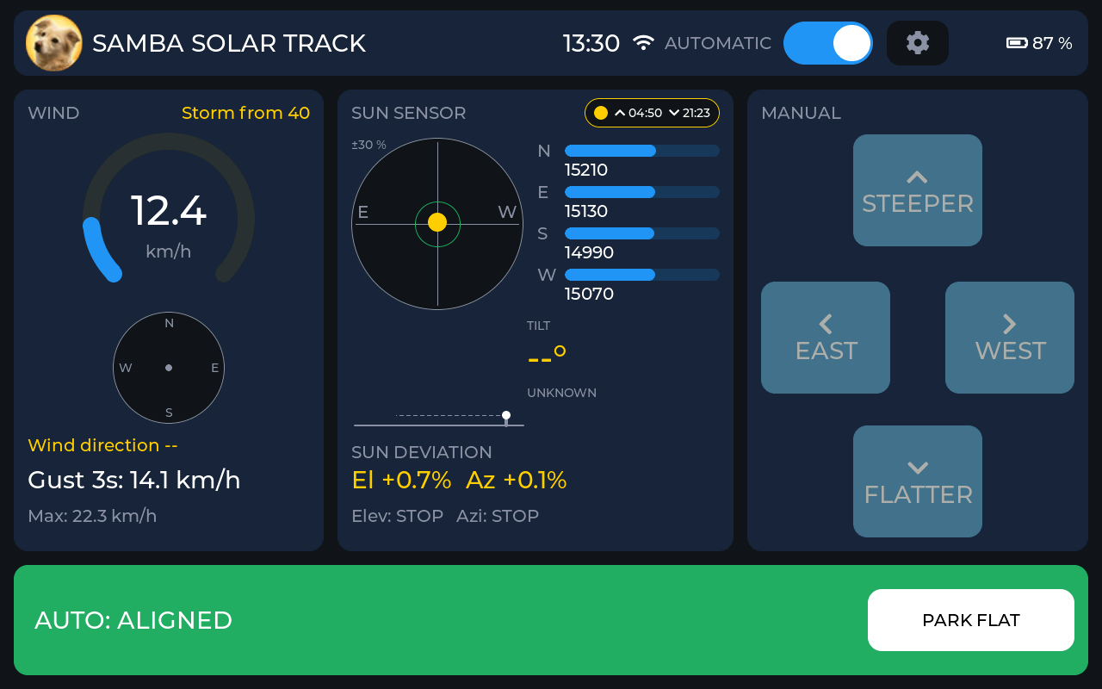
handbuch/img/screens10_en/x11_dashboard_sonne_2achsen.png
