ssbingo/samba-solar-track/handbuch/img/screens10_en/y1_10_fahrzeit_einmessen.png

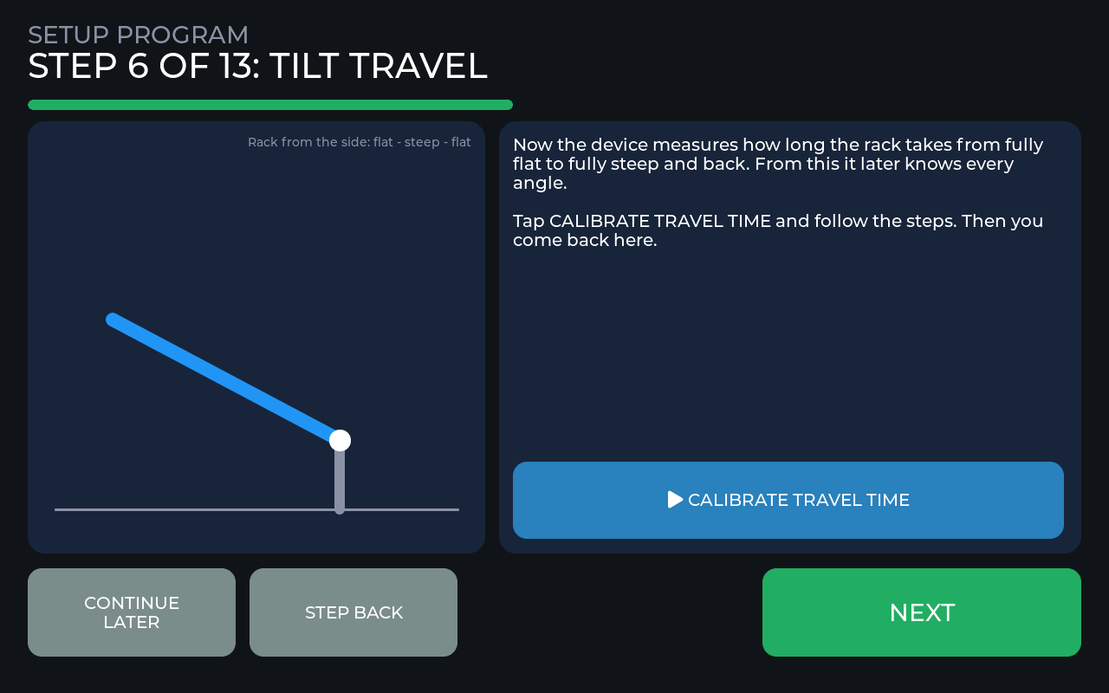
handbuch/img/screens10_en/y1_10_fahrzeit_einmessen.png
