ssbingo/samba-solar-track/handbuch/img/screens10_en/y1_19_standort.png

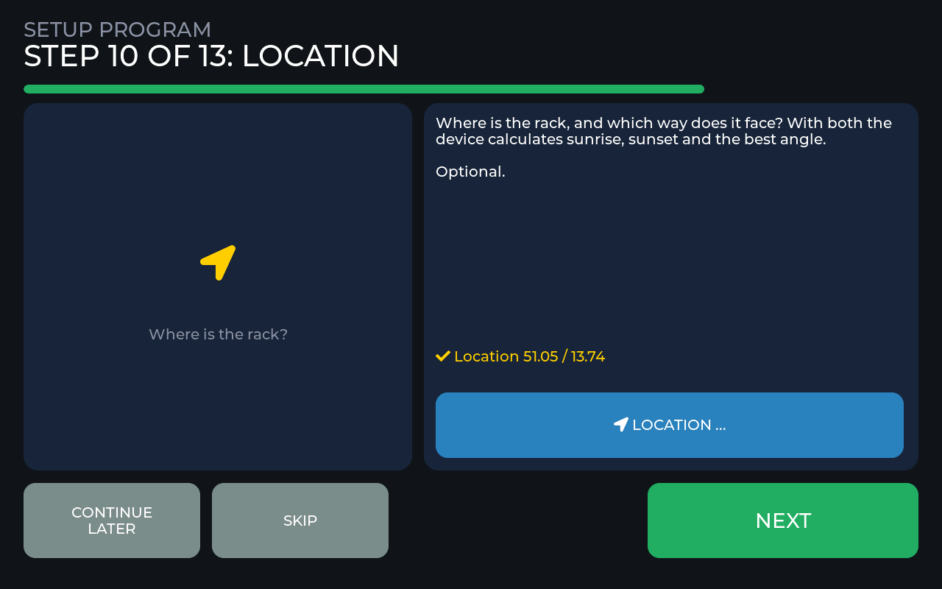
handbuch/img/screens10_en/y1_19_standort.png
