ssbingo/samba-solar-track/handbuch/img/screens10_en/y1_20_leuchten.png

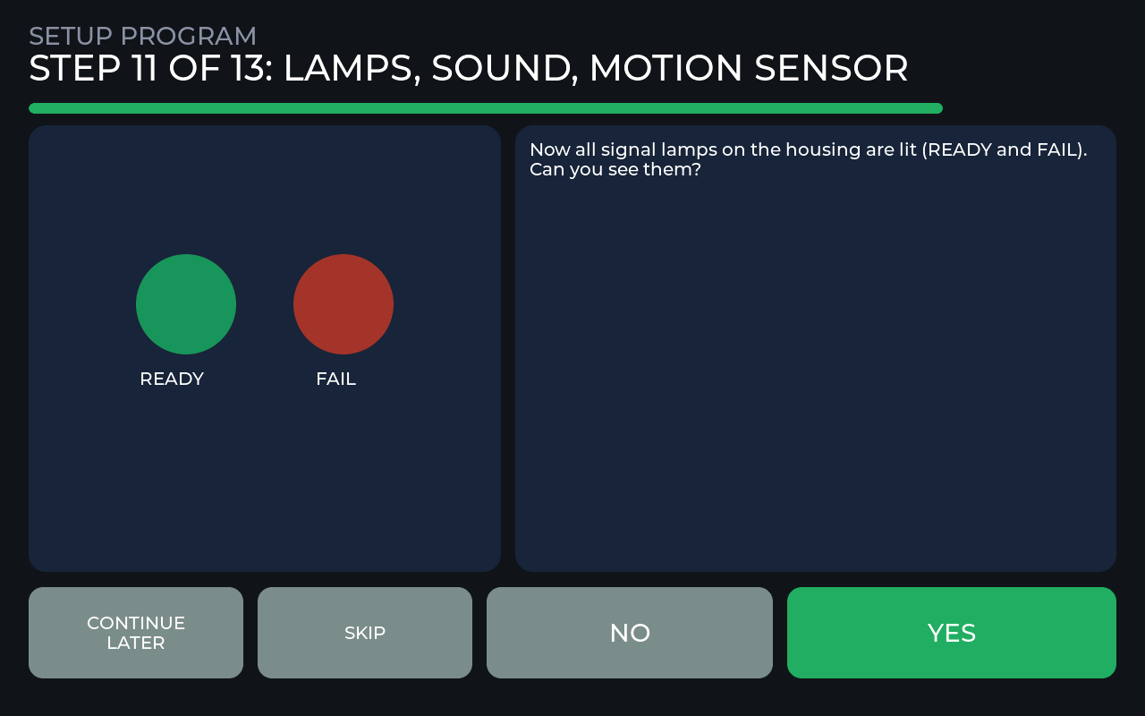
handbuch/img/screens10_en/y1_20_leuchten.png
