ssbingo/samba-solar-track/handbuch/img/screens10_en/y1_21_ton.png

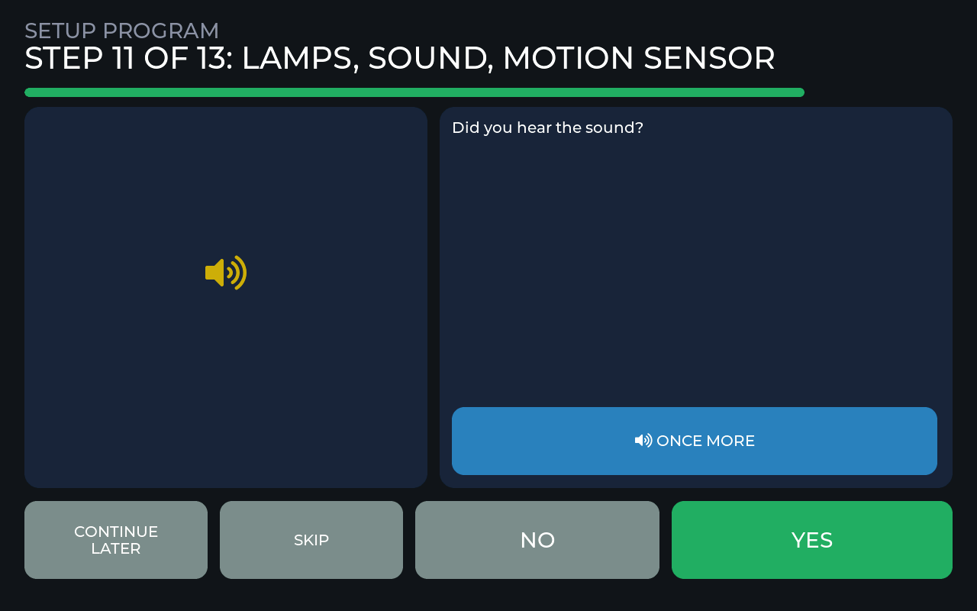
handbuch/img/screens10_en/y1_21_ton.png
