ssbingo/samba-solar-track/handbuch/img/screens10_en/y1_26_fertig.png

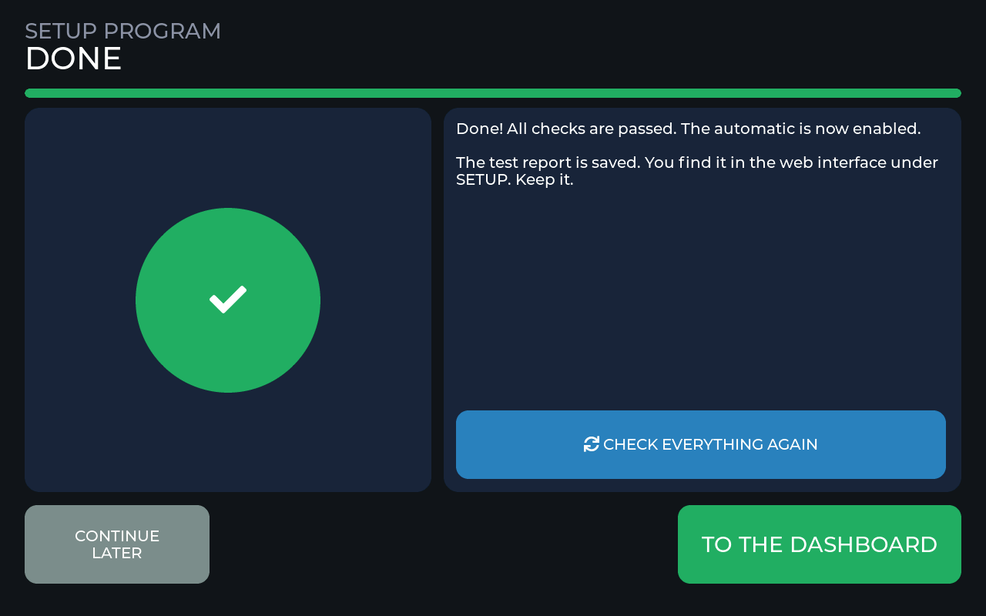
handbuch/img/screens10_en/y1_26_fertig.png
