ssbingo/samba-solar-track/handbuch/img/screens10_en/y2_02_anlage.png

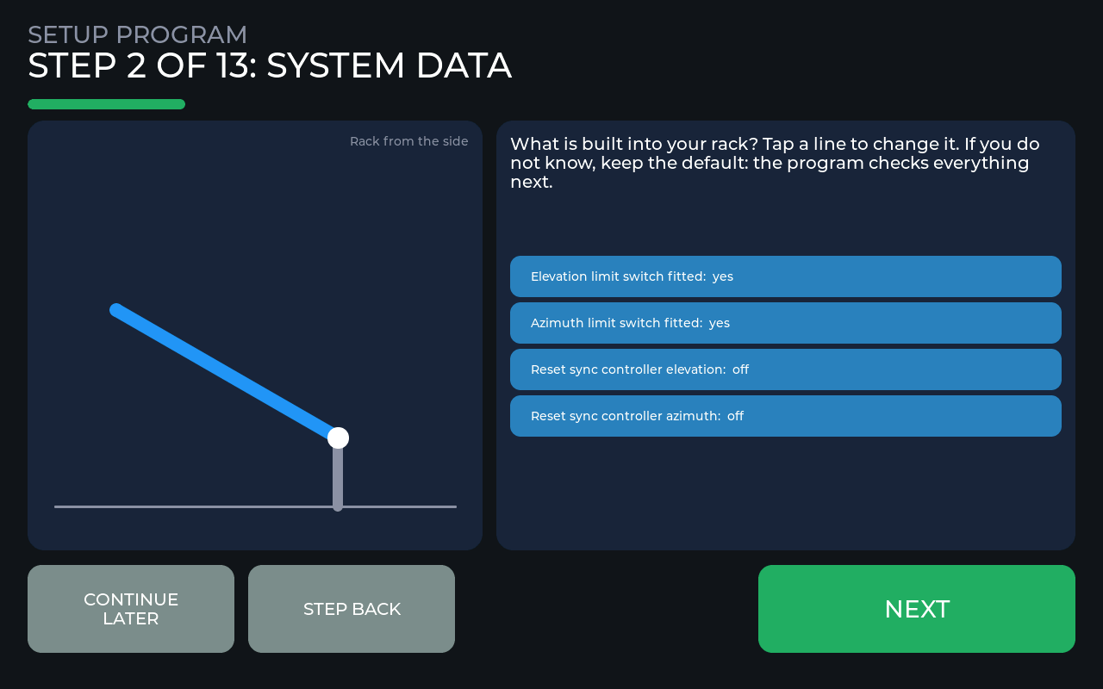
handbuch/img/screens10_en/y2_02_anlage.png
