ssbingo/samba-solar-track/handbuch/img/screens10_en/y2_16_sensor_start.png

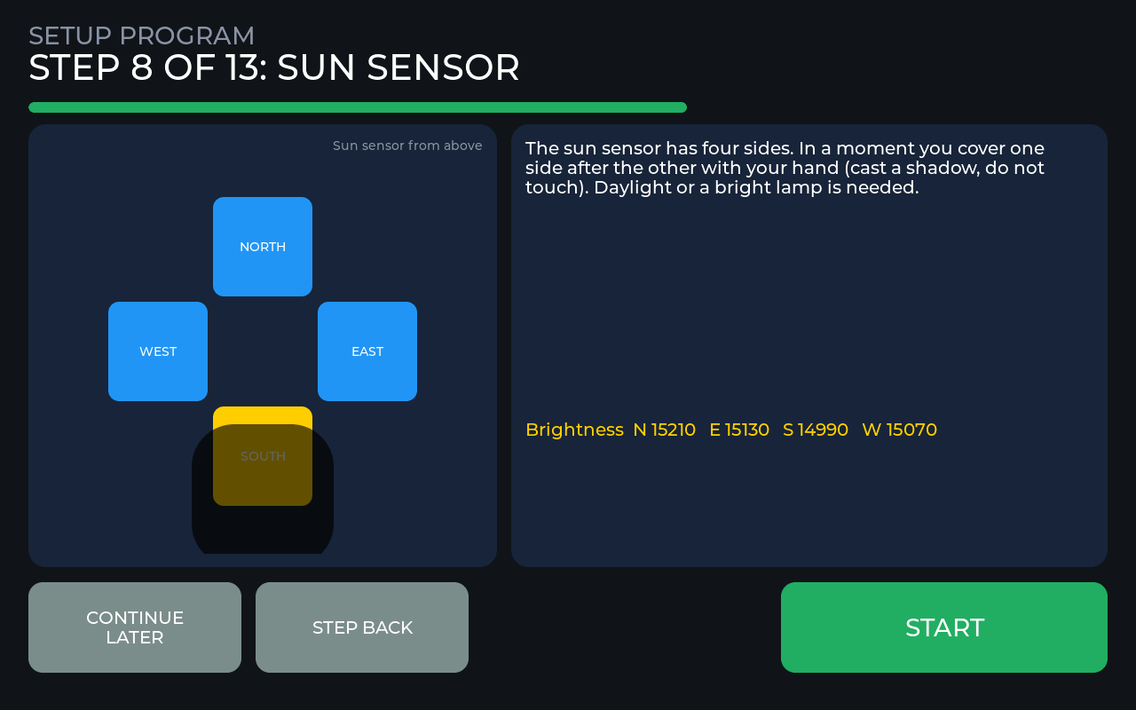
handbuch/img/screens10_en/y2_16_sensor_start.png
