ssbingo/samba-solar-track/handbuch/img/screens10_es/n22_werte_gestell.png

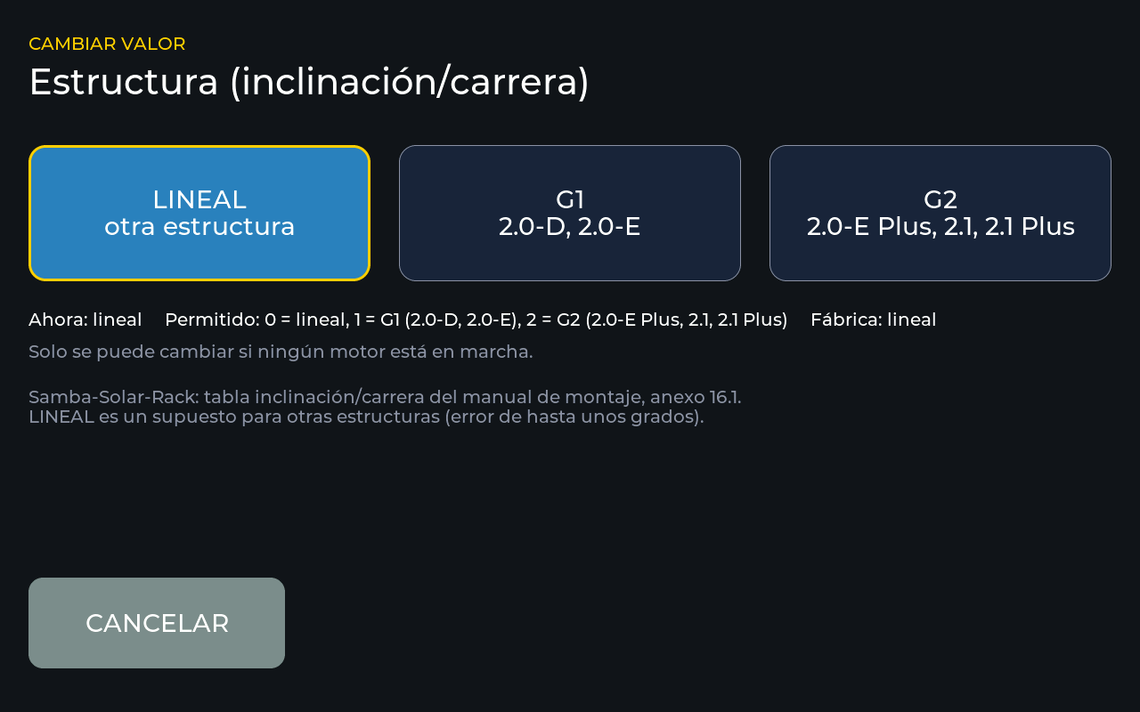
handbuch/img/screens10_es/n22_werte_gestell.png
