ssbingo/samba-solar-track/handbuch/img/screens10_es/p03_uhrzeit.png

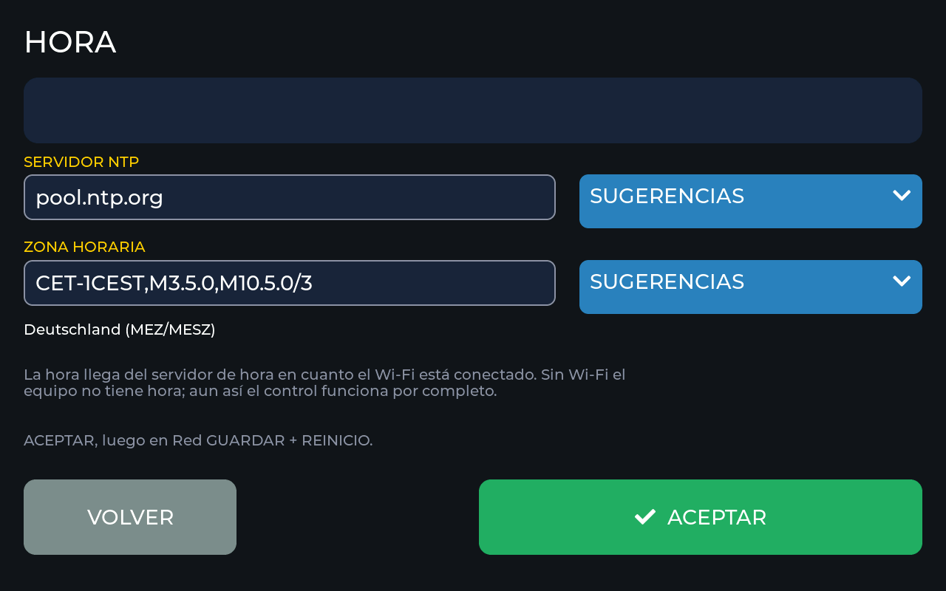
handbuch/img/screens10_es/p03_uhrzeit.png
