ssbingo/samba-solar-track/handbuch/img/screens10_es/p08_ton.png

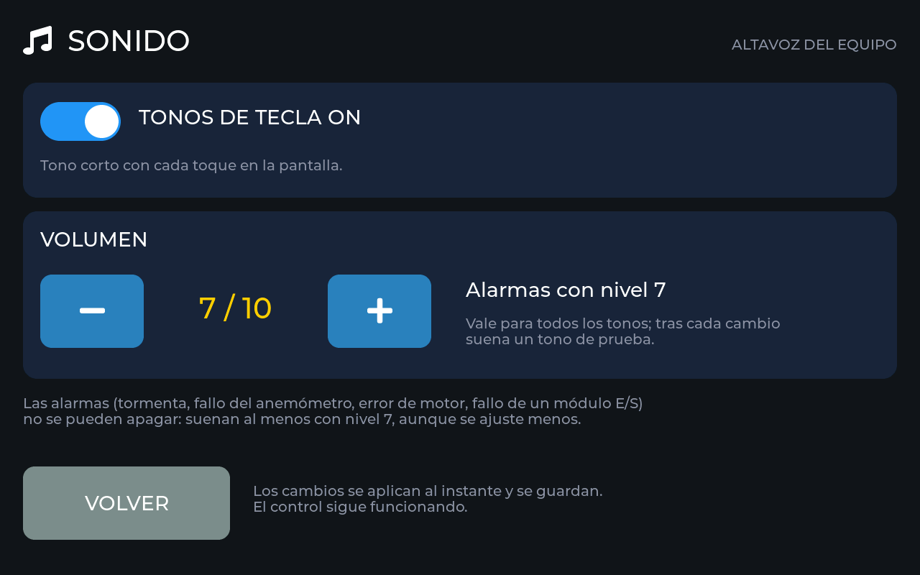
handbuch/img/screens10_es/p08_ton.png
