ssbingo/samba-solar-track/handbuch/img/screens10_es/r05_reset_nicht_verfuegbar.png

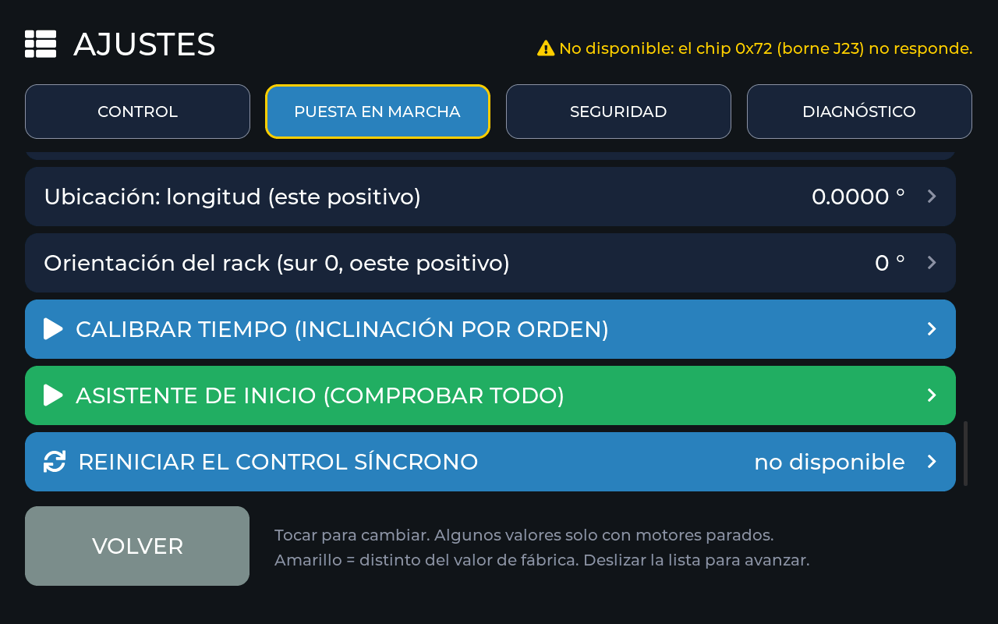
handbuch/img/screens10_es/r05_reset_nicht_verfuegbar.png
