ssbingo/samba-solar-track/handbuch/img/screens10_es/x02_sonne_1achse.png

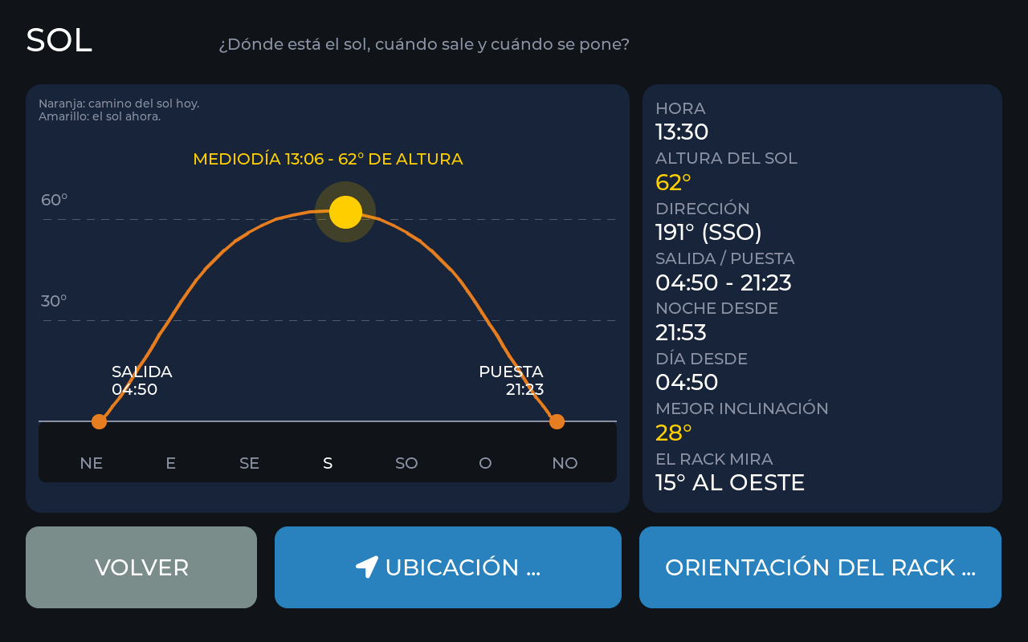
handbuch/img/screens10_es/x02_sonne_1achse.png
