ssbingo/samba-solar-track/handbuch/img/screens10_es/x06_standort_suche.png

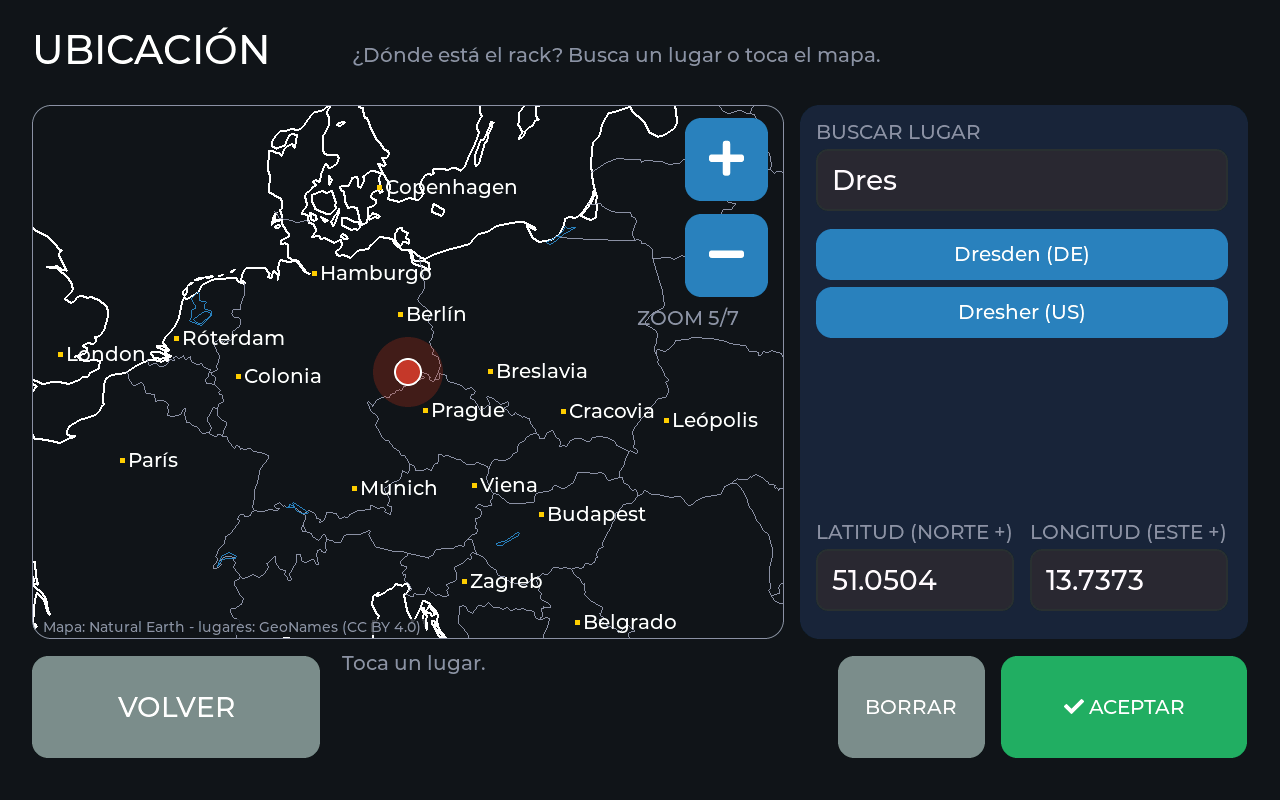
handbuch/img/screens10_es/x06_standort_suche.png
