ssbingo/samba-solar-track/handbuch/img/screens10_es/y1_05_windmesser.png

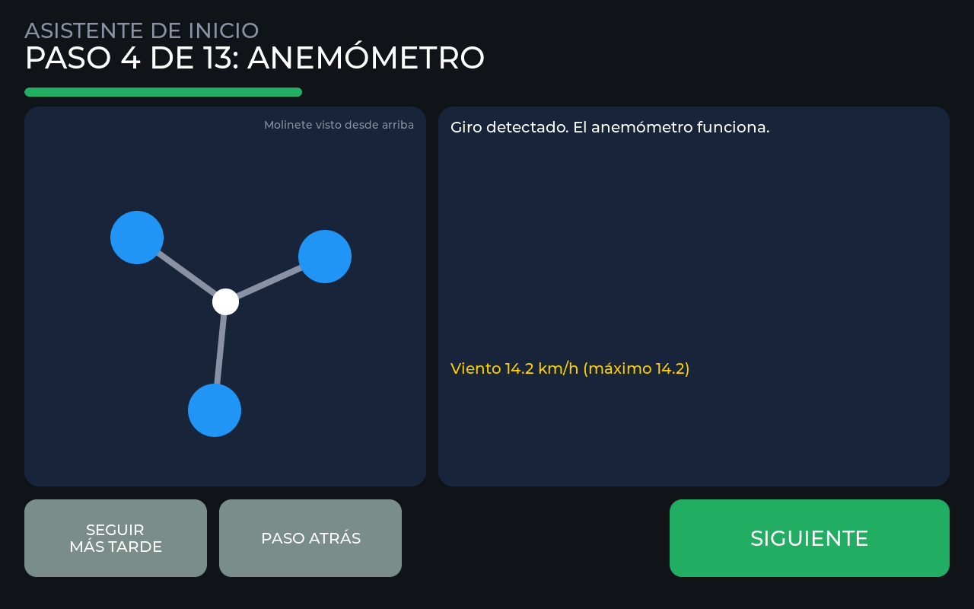
handbuch/img/screens10_es/y1_05_windmesser.png
