ssbingo/samba-solar-track/handbuch/img/screens10_es/y1_22_bewegung.png

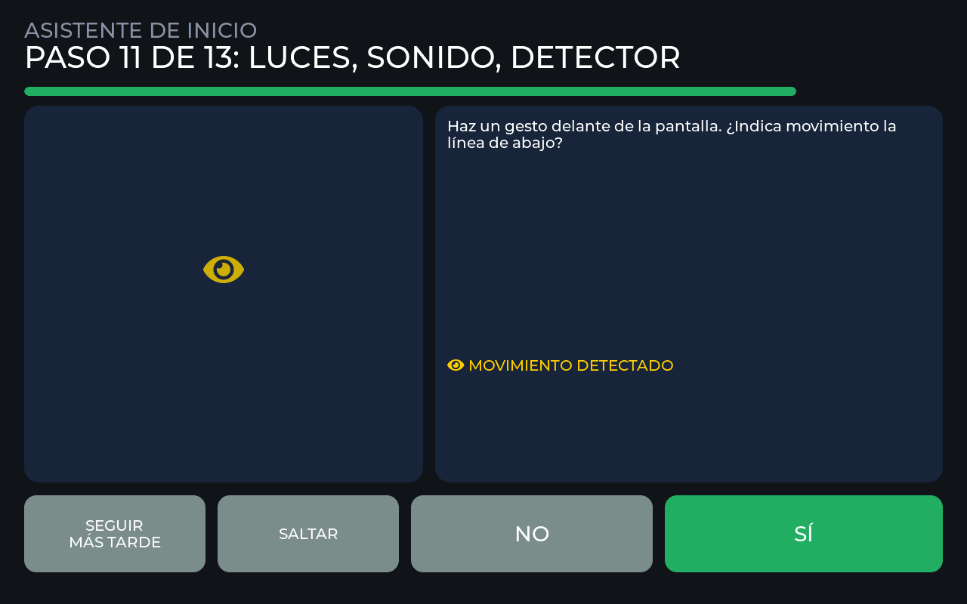
handbuch/img/screens10_es/y1_22_bewegung.png
