ssbingo/samba-solar-track/handbuch/img/screens10_es/y2_11_fahrweg_frage.png

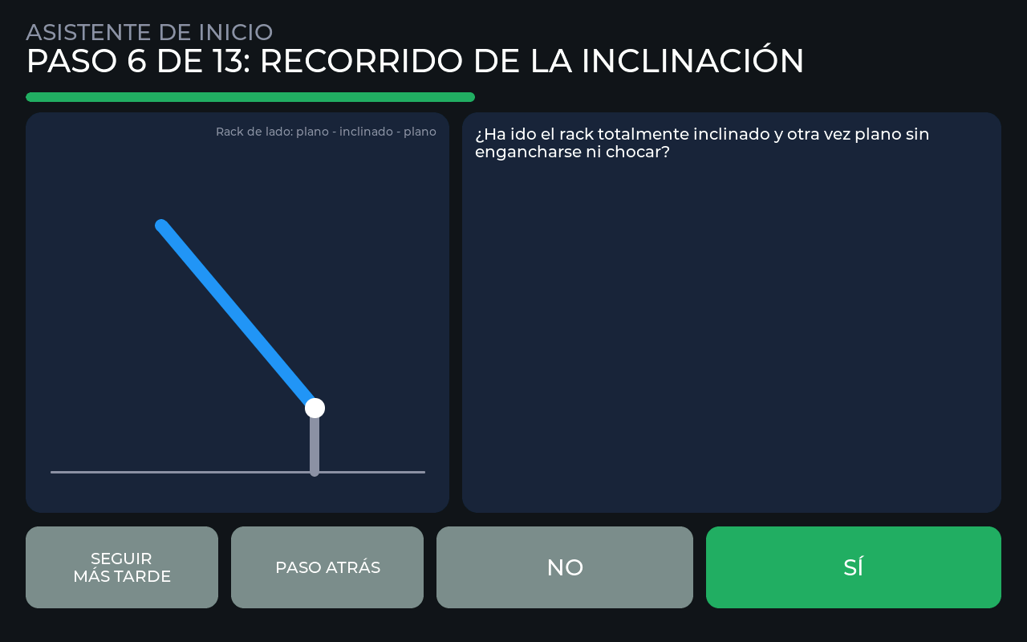
handbuch/img/screens10_es/y2_11_fahrweg_frage.png
