ssbingo/samba-solar-track/handbuch/img/screens10_es/y2_13_azimut_frage.png

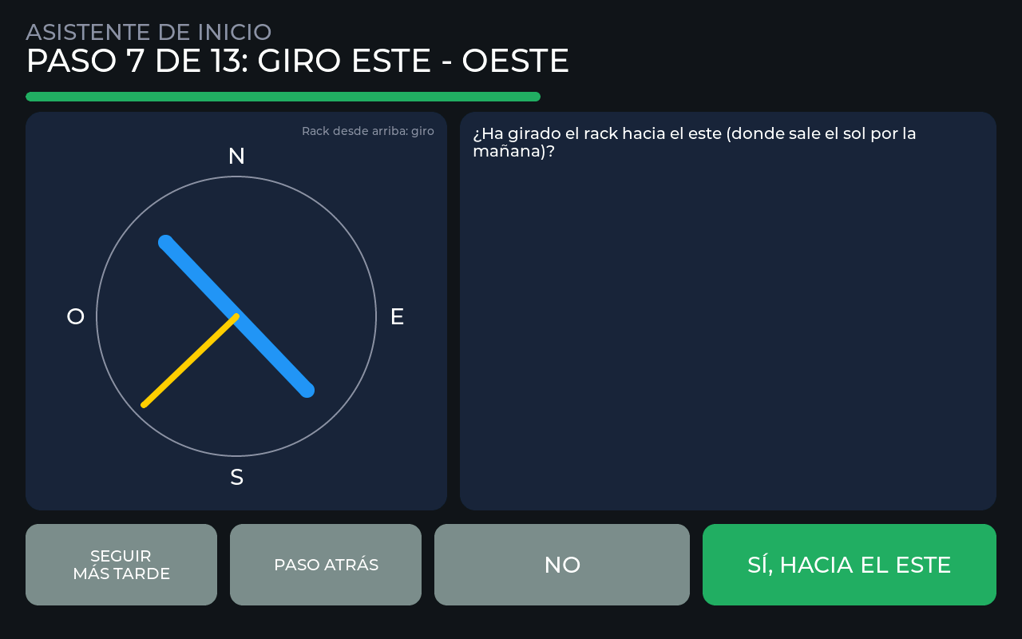
handbuch/img/screens10_es/y2_13_azimut_frage.png
