ssbingo/samba-solar-track/handbuch/img/screens10_es/y2_17_sensor_sued.png

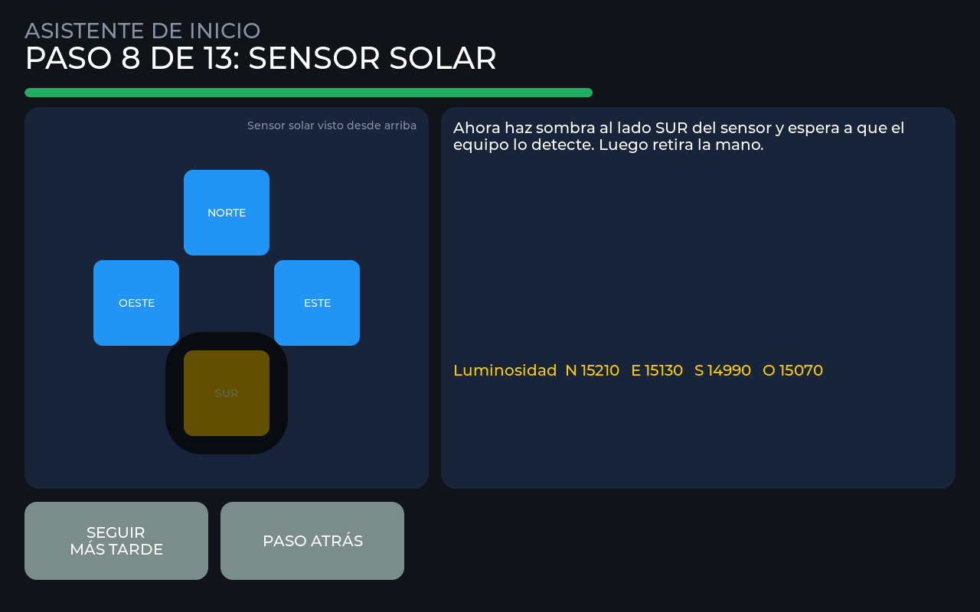
handbuch/img/screens10_es/y2_17_sensor_sued.png
