ssbingo/samba-solar-track/handbuch/img/screens10_fr/n12_neigung_sturm_hat_vorrang.png

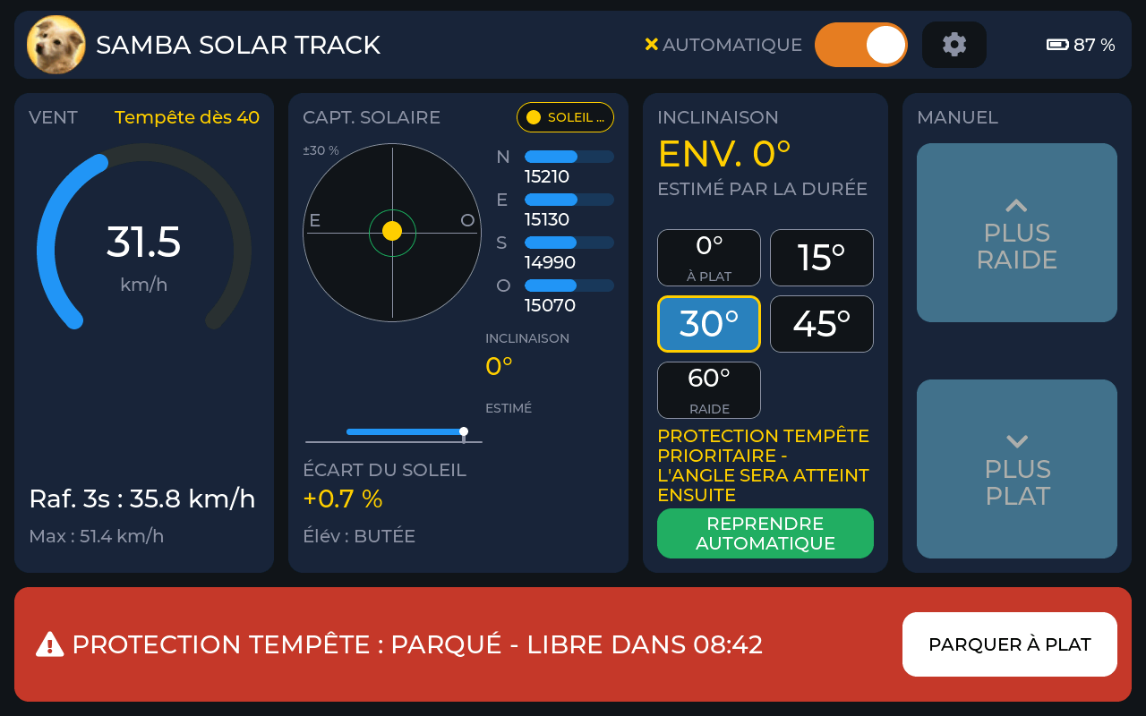
handbuch/img/screens10_fr/n12_neigung_sturm_hat_vorrang.png
