ssbingo/samba-solar-track/handbuch/img/screens10_fr/n14_neigung_hall_karte.png

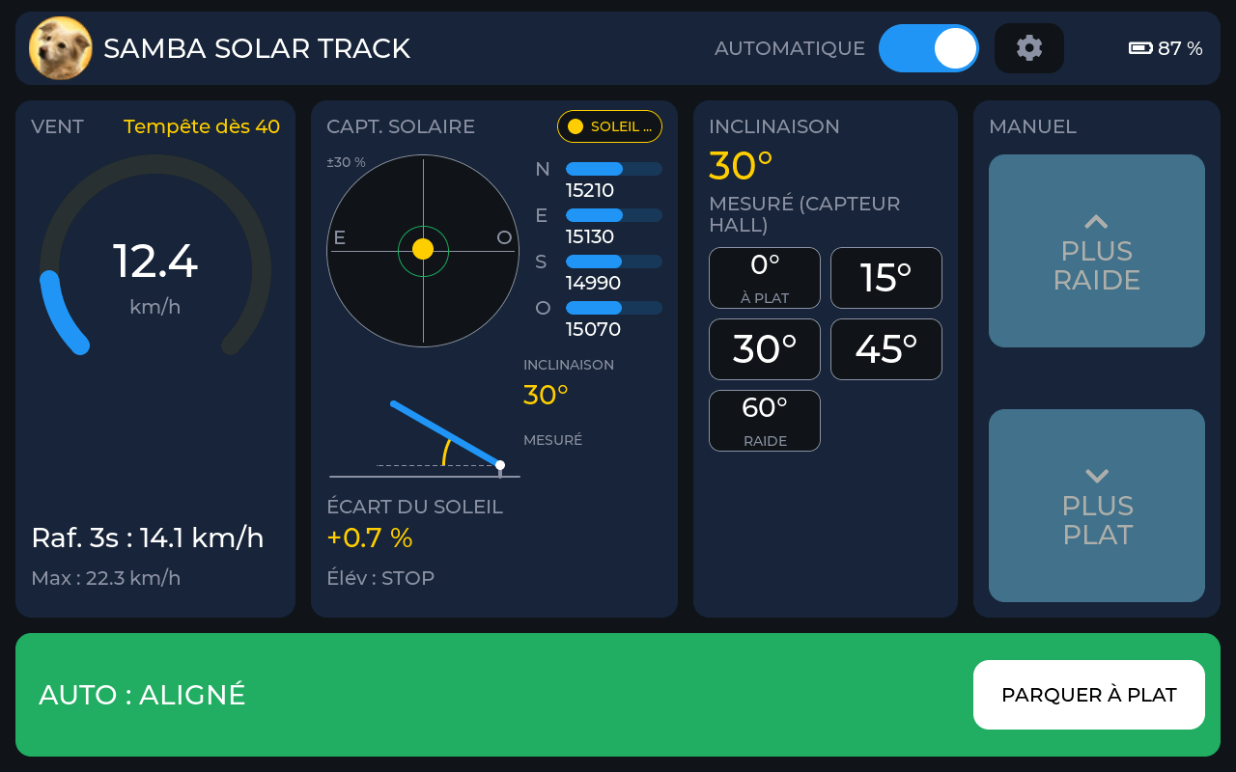
handbuch/img/screens10_fr/n14_neigung_hall_karte.png
