ssbingo/samba-solar-track/handbuch/img/screens10_fr/n27_einmessen_pause.png

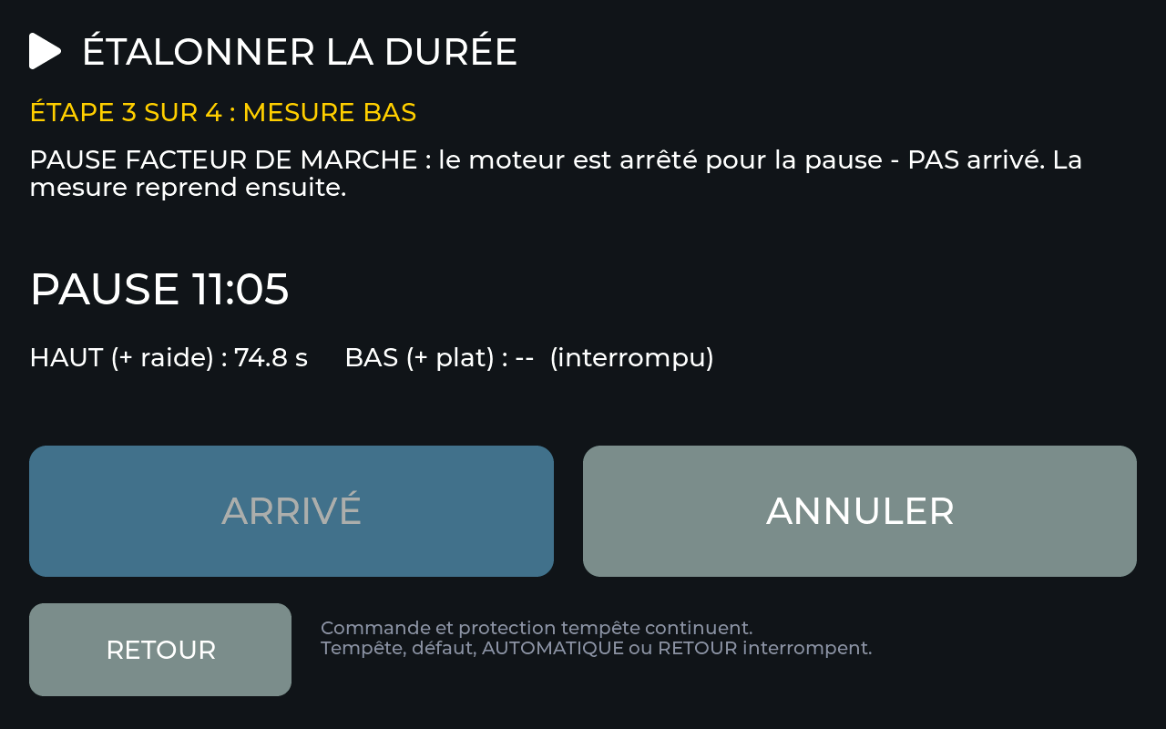
handbuch/img/screens10_fr/n27_einmessen_pause.png
