ssbingo/samba-solar-track/handbuch/img/screens10_fr/n32_einmessen_hall_ergebnis.png

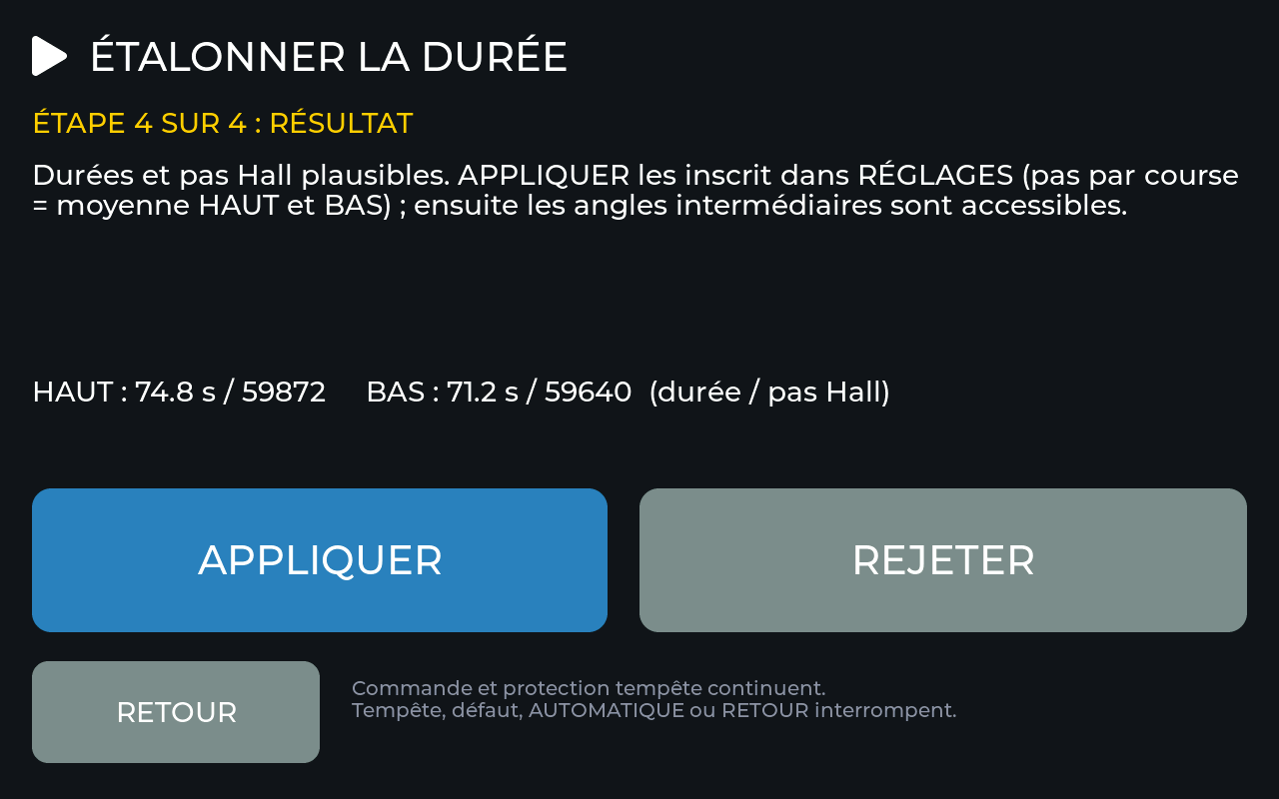
handbuch/img/screens10_fr/n32_einmessen_hall_ergebnis.png
