ssbingo/samba-solar-track/handbuch/img/screens10_fr/p05_werte.png

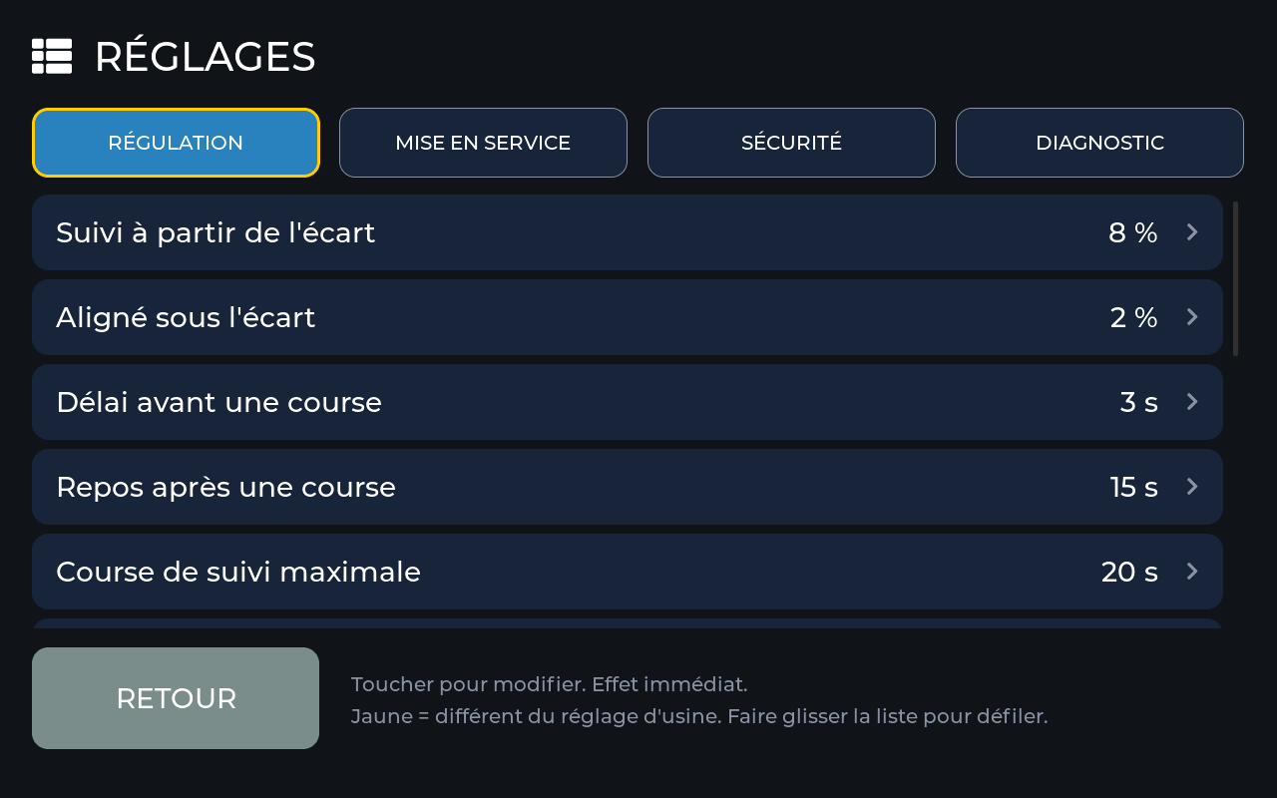
handbuch/img/screens10_fr/p05_werte.png
