ssbingo/samba-solar-track/handbuch/img/screens10_fr/r20_rueckfrage_auswahl_nicht_gespeichert.png

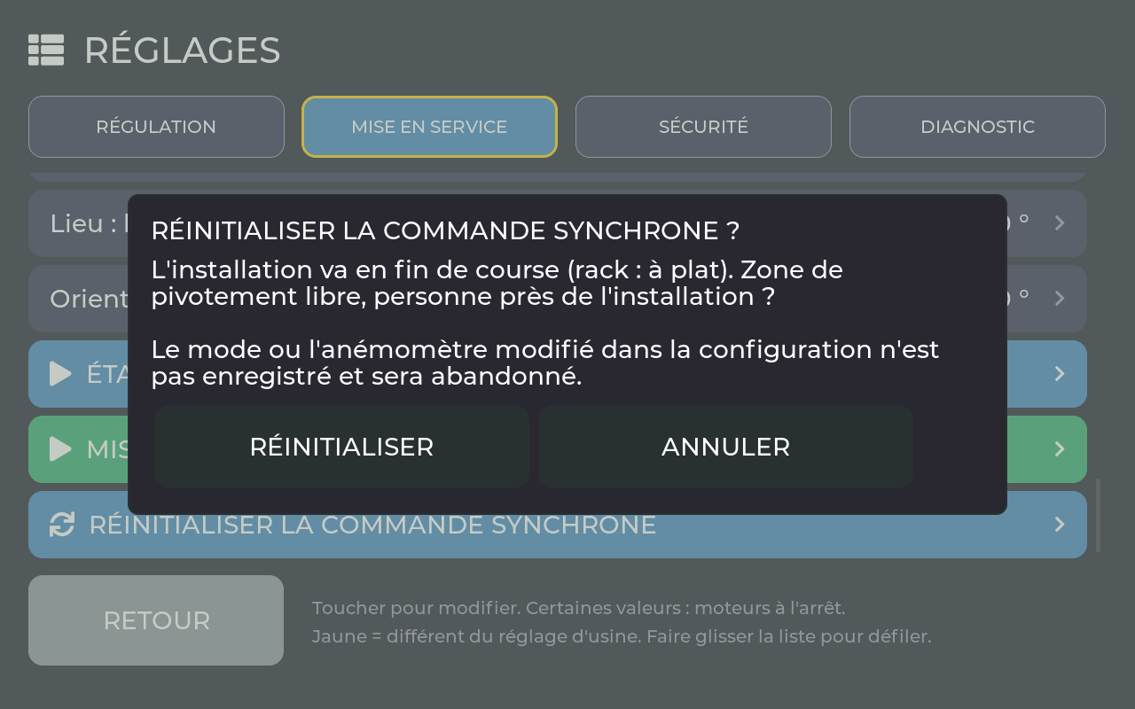
handbuch/img/screens10_fr/r20_rueckfrage_auswahl_nicht_gespeichert.png
