ssbingo/samba-solar-track/handbuch/img/screens10_fr/s01_bildschirmschoner.png

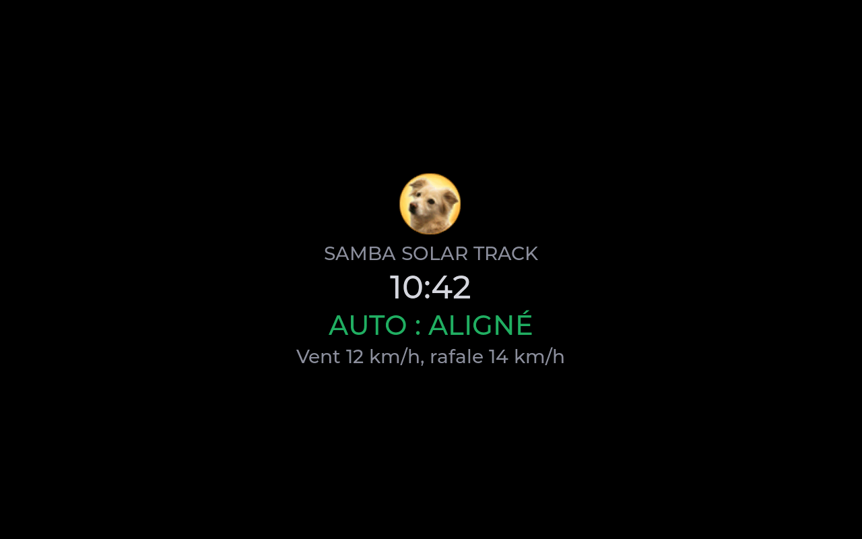
handbuch/img/screens10_fr/s01_bildschirmschoner.png
