ssbingo/samba-solar-track/handbuch/img/screens10_fr/y1_18_wlan.png

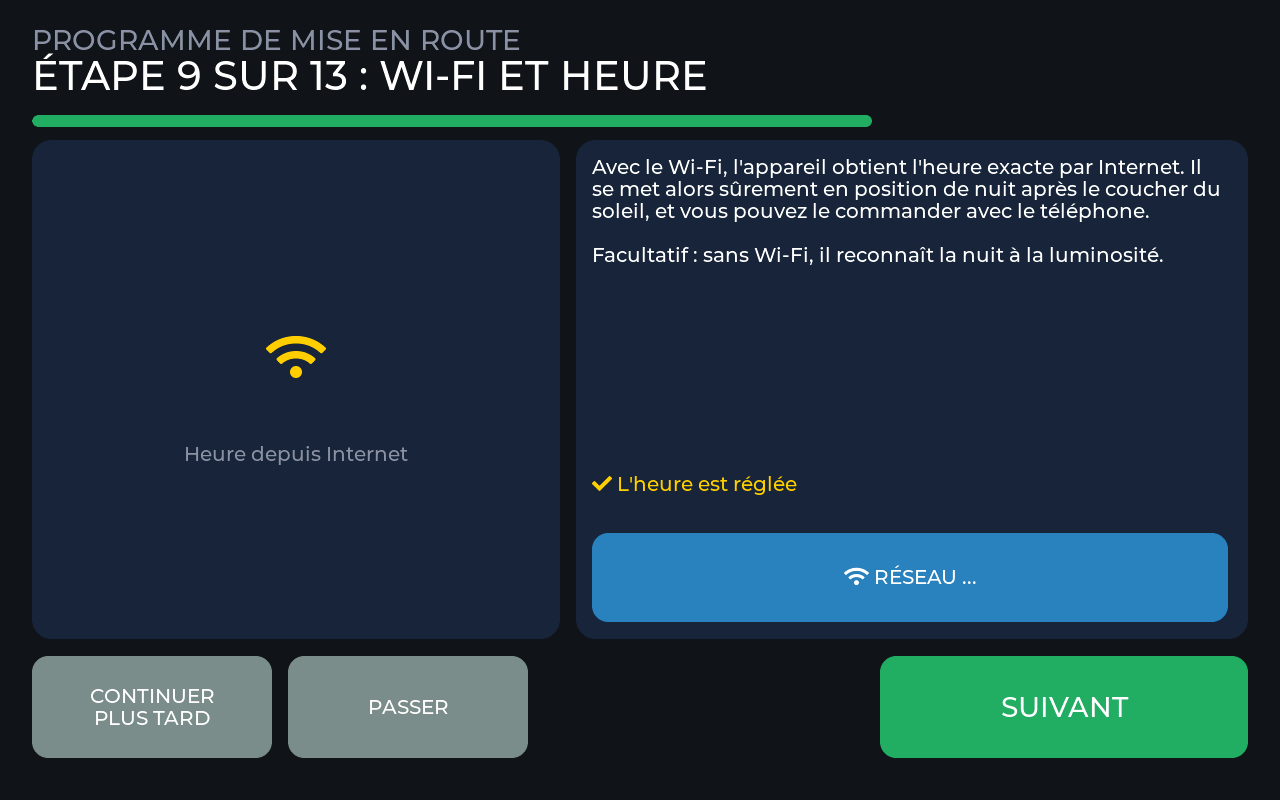
handbuch/img/screens10_fr/y1_18_wlan.png
