ssbingo/samba-solar-track/handbuch/img/screens10_nl/n23_einmessen_automatik_ein.png

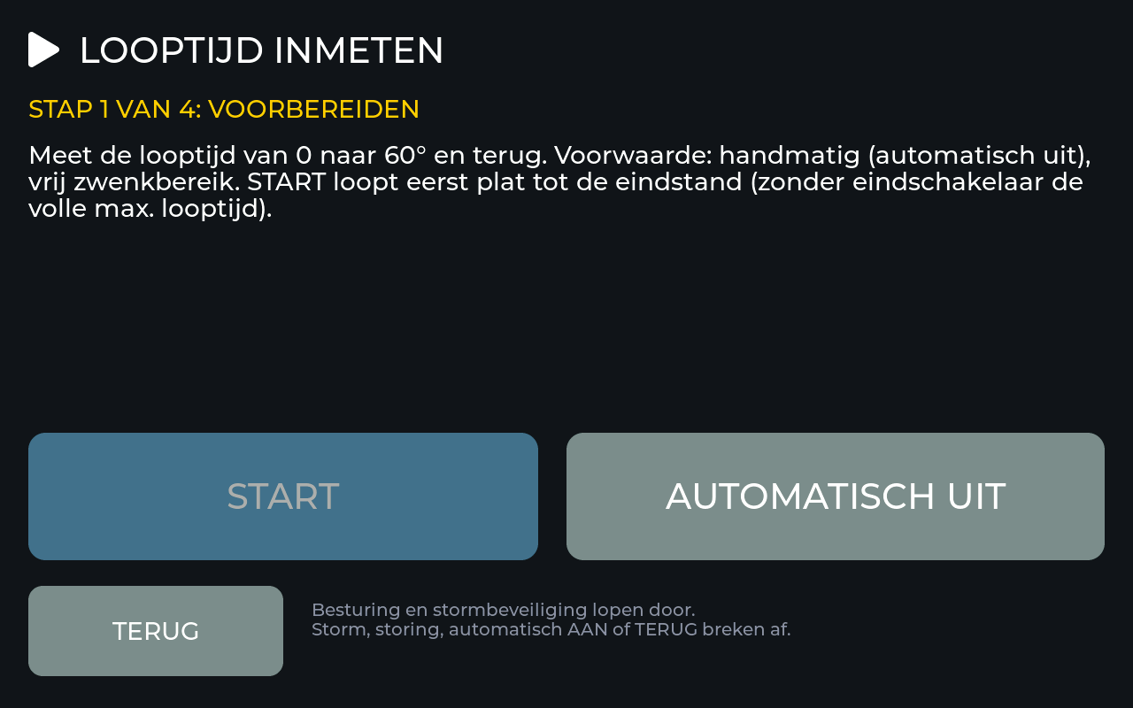
handbuch/img/screens10_nl/n23_einmessen_automatik_ein.png
