ssbingo/samba-solar-track/handbuch/img/screens10_nl/n29_einmessen_abgebrochen.png

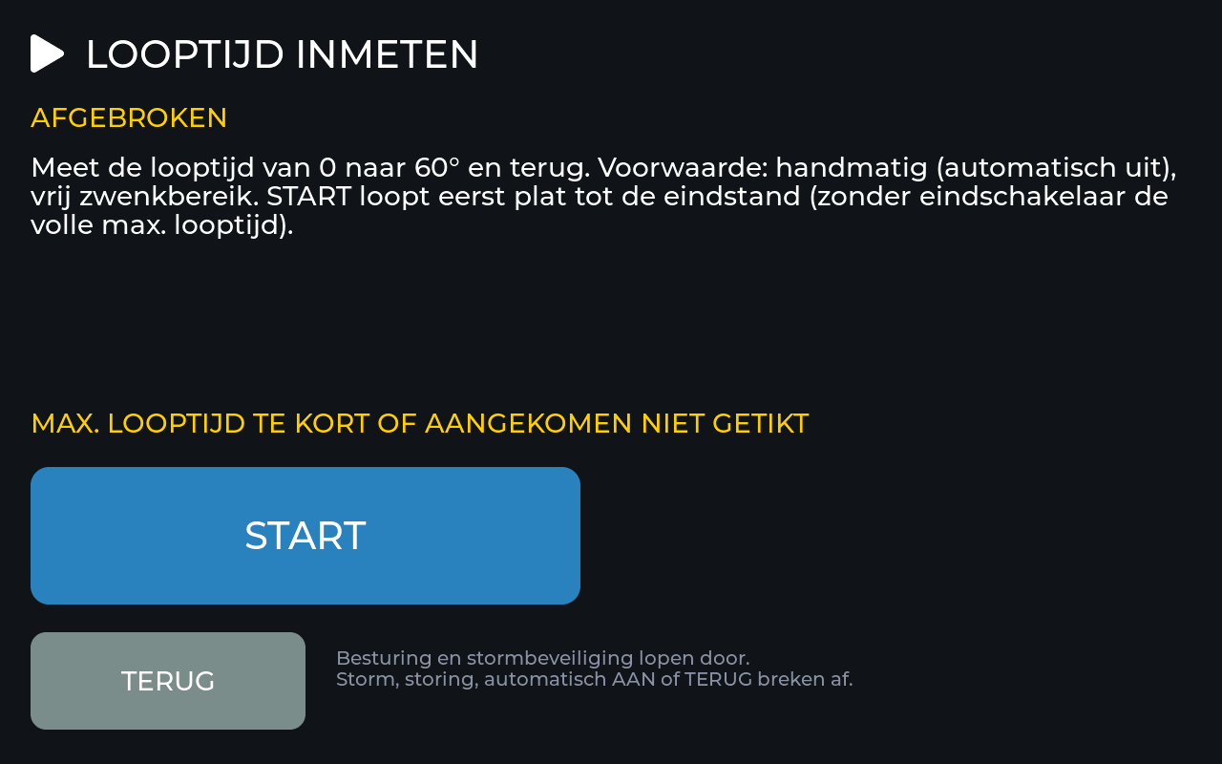
handbuch/img/screens10_nl/n29_einmessen_abgebrochen.png
