ssbingo/samba-solar-track/handbuch/img/screens10_nl/n31_einmessen_hall_misst_auf.png

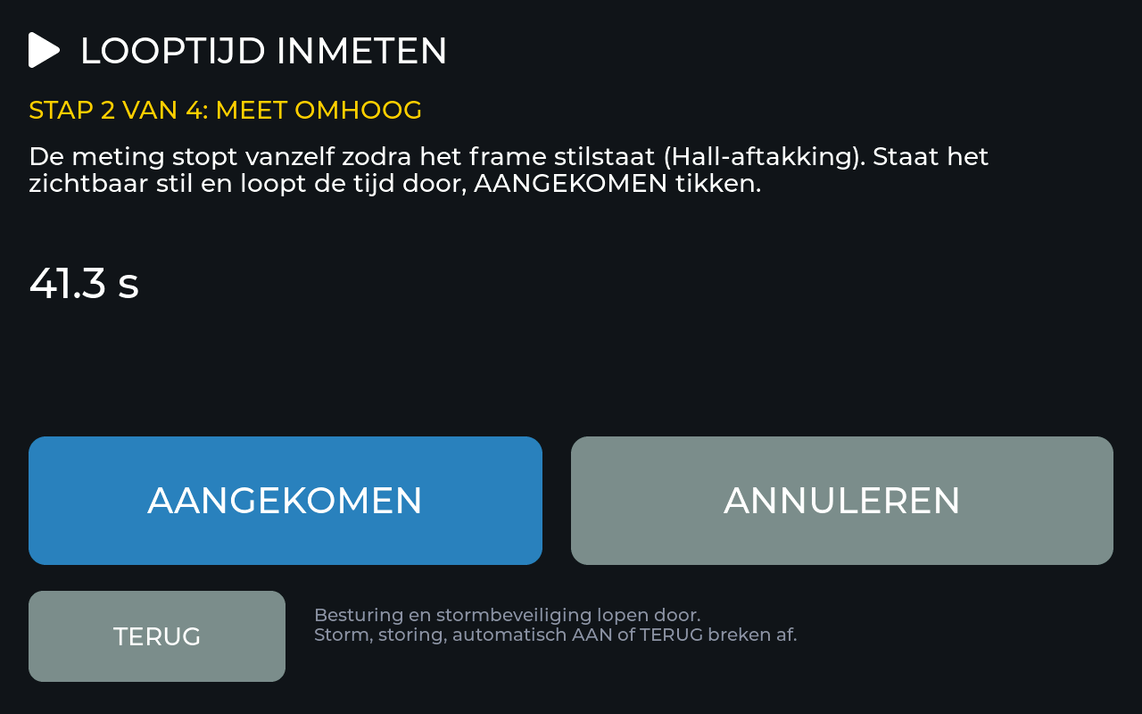
handbuch/img/screens10_nl/n31_einmessen_hall_misst_auf.png
