ssbingo/samba-solar-track/handbuch/img/screens10_nl/p02_netzwerk.png

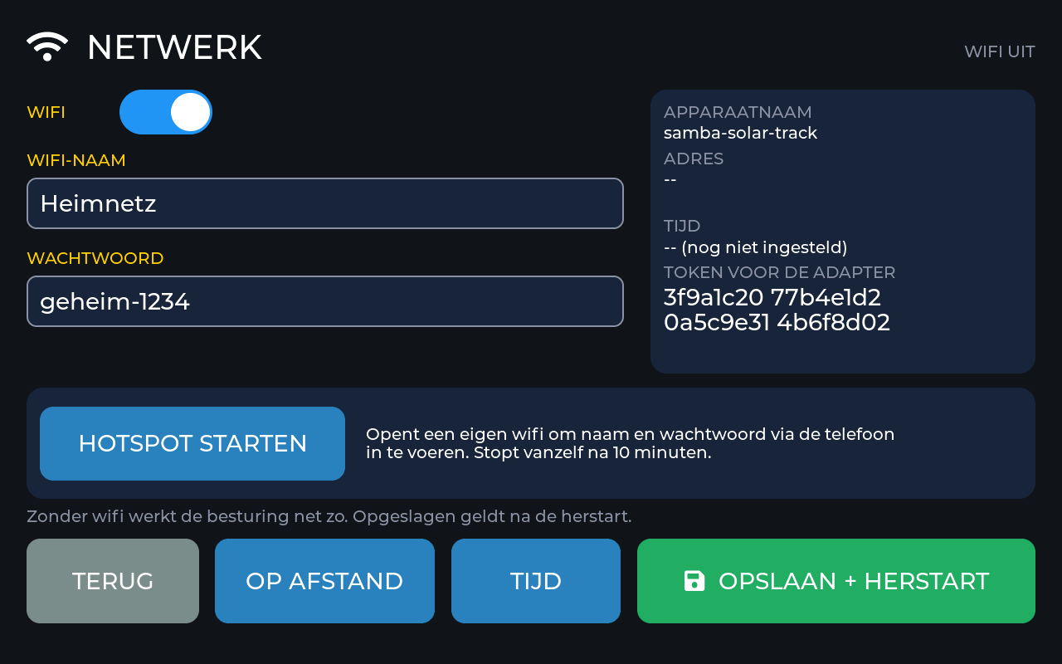
handbuch/img/screens10_nl/p02_netzwerk.png
