ssbingo/samba-solar-track/handbuch/img/screens10_nl/r16_band_2achsen.png

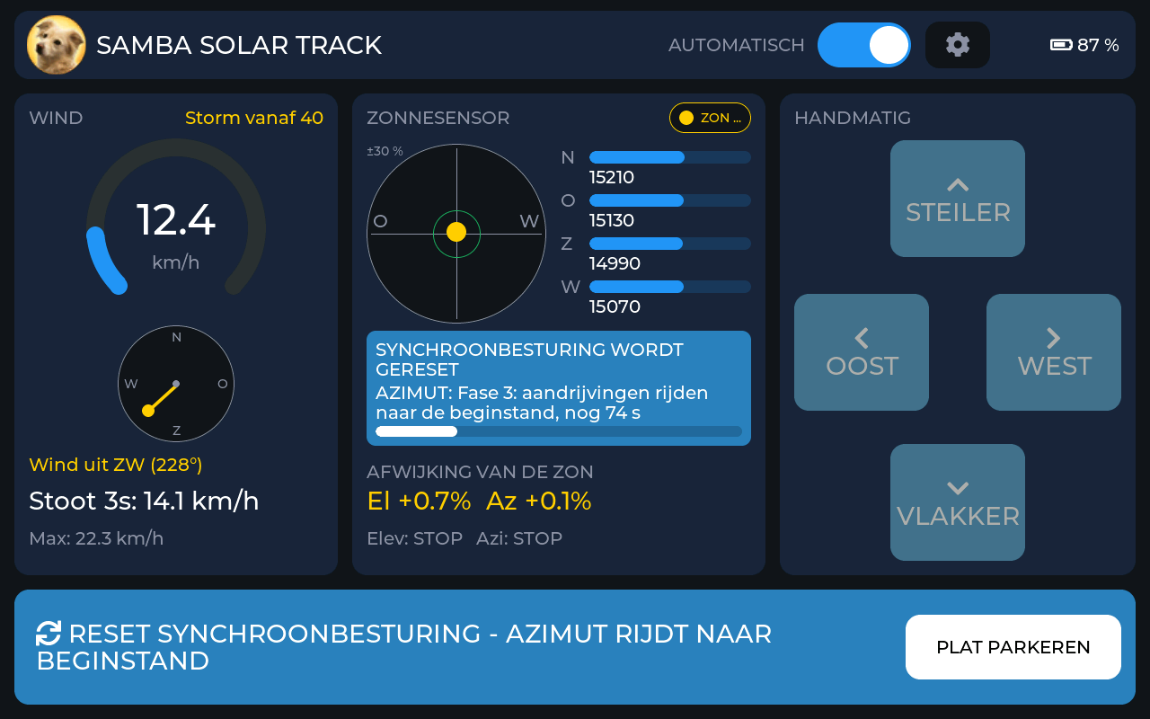
handbuch/img/screens10_nl/r16_band_2achsen.png
