ssbingo/samba-solar-track/handbuch/img/screens10_nl/y1_11_winkel_30.png

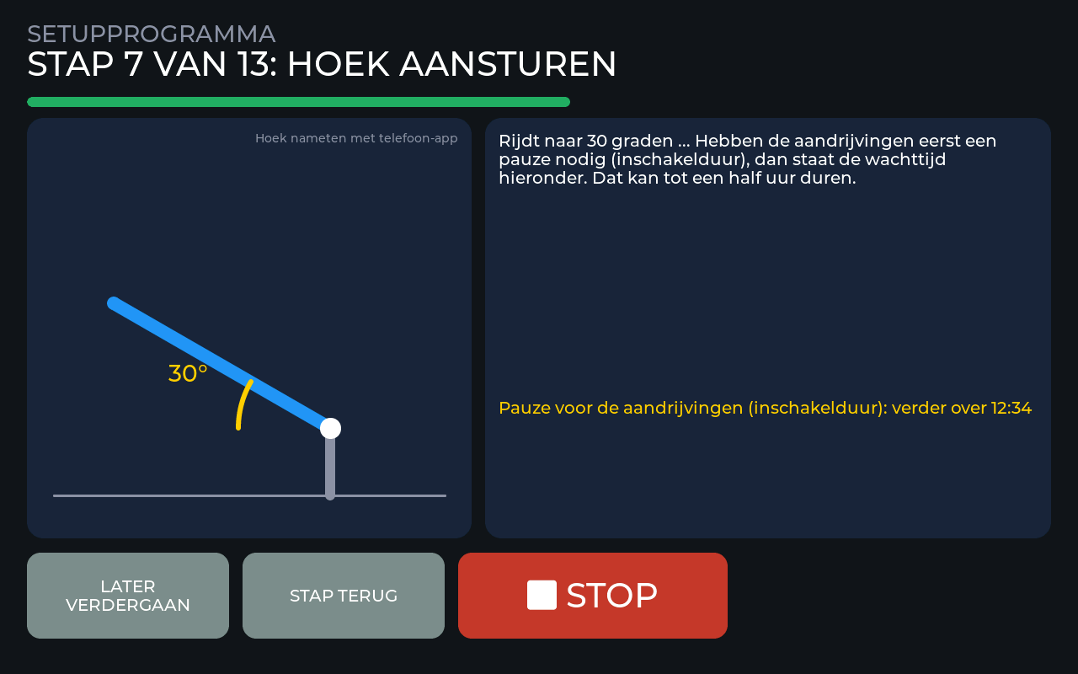
handbuch/img/screens10_nl/y1_11_winkel_30.png
