ssbingo/samba-solar-track/handbuch/img/screens10_nl/y1_21_ton.png

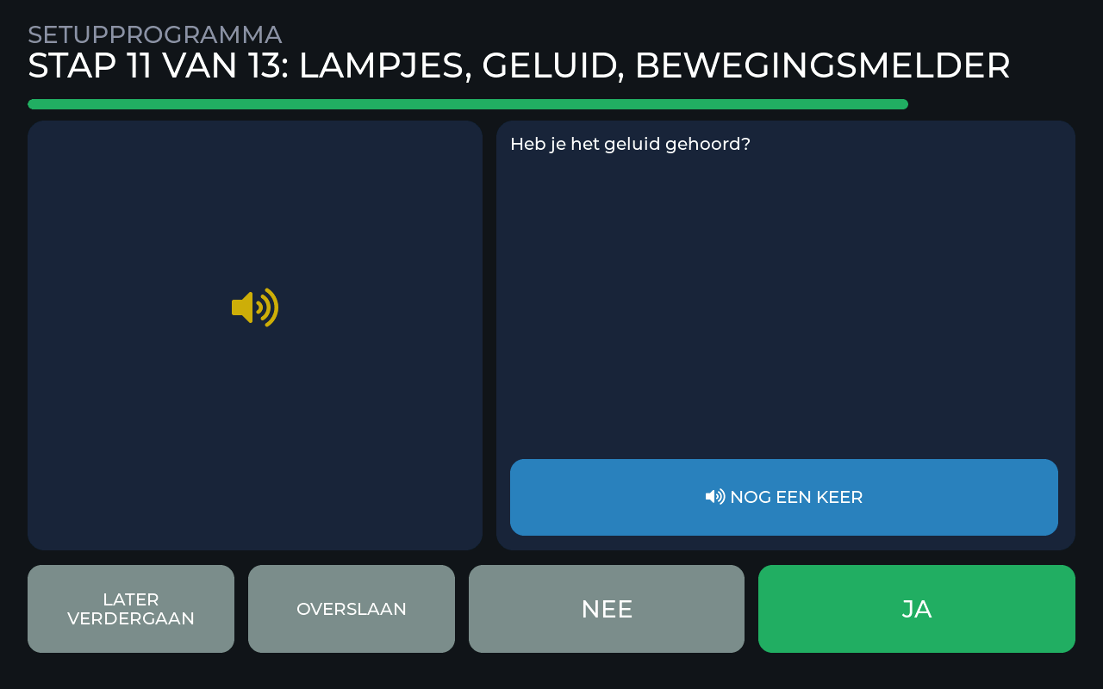
handbuch/img/screens10_nl/y1_21_ton.png
