ssbingo/samba-solar-track/handbuch/img/screens10_nl/y2_12_azimut_probefahrt.png

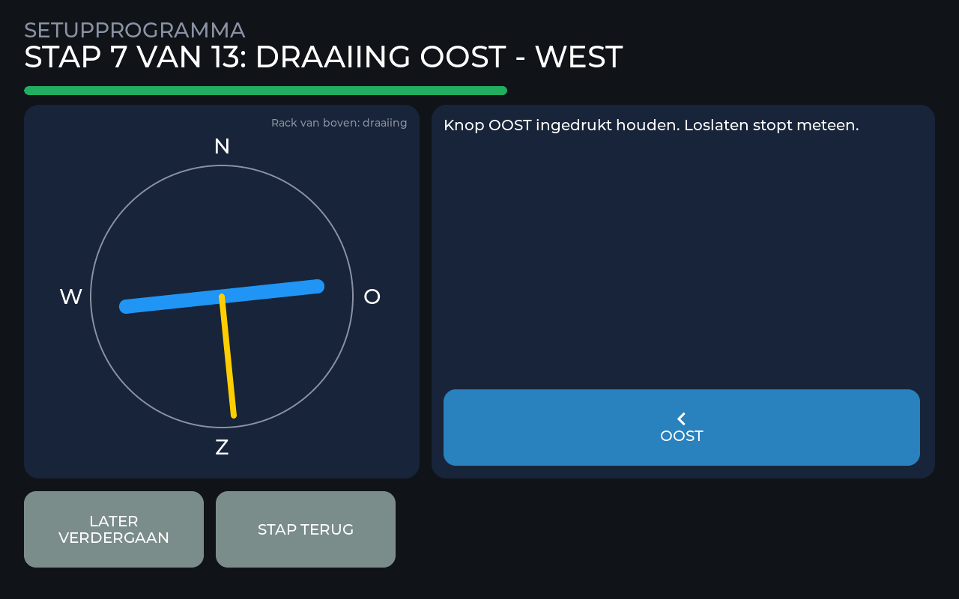
handbuch/img/screens10_nl/y2_12_azimut_probefahrt.png
