ssbingo/samba-solar-track/handbuch/img/screens10_pl/n11_neigung_nicht_eingemessen.png

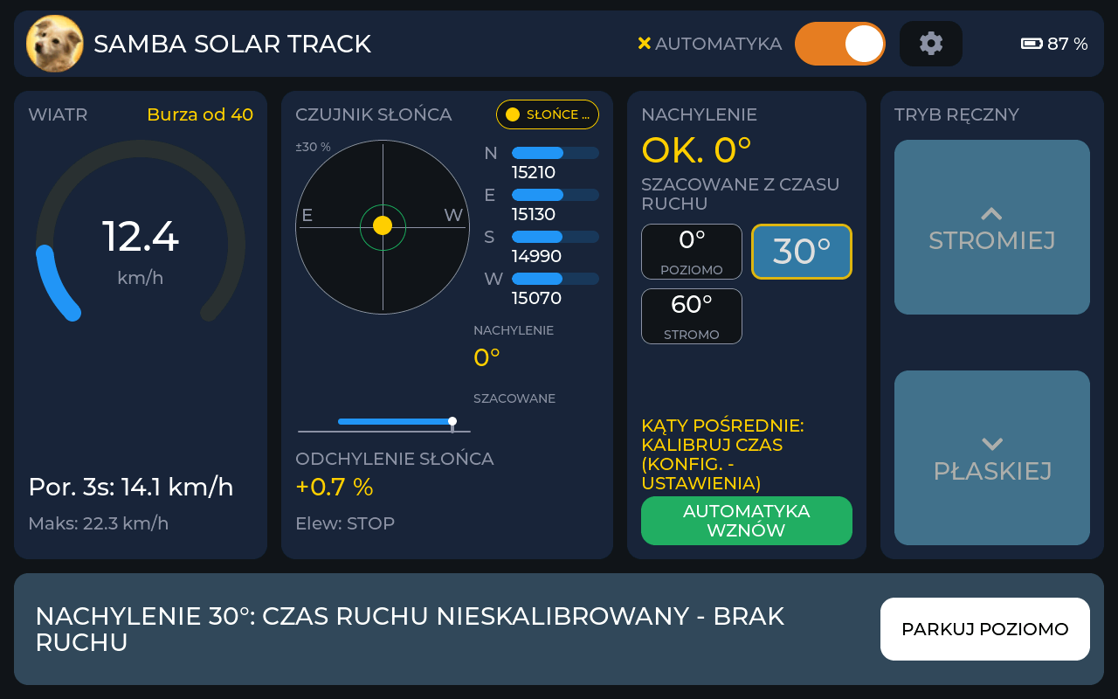
handbuch/img/screens10_pl/n11_neigung_nicht_eingemessen.png
