ssbingo/samba-solar-track/handbuch/img/screens10_pl/n12_neigung_sturm_hat_vorrang.png

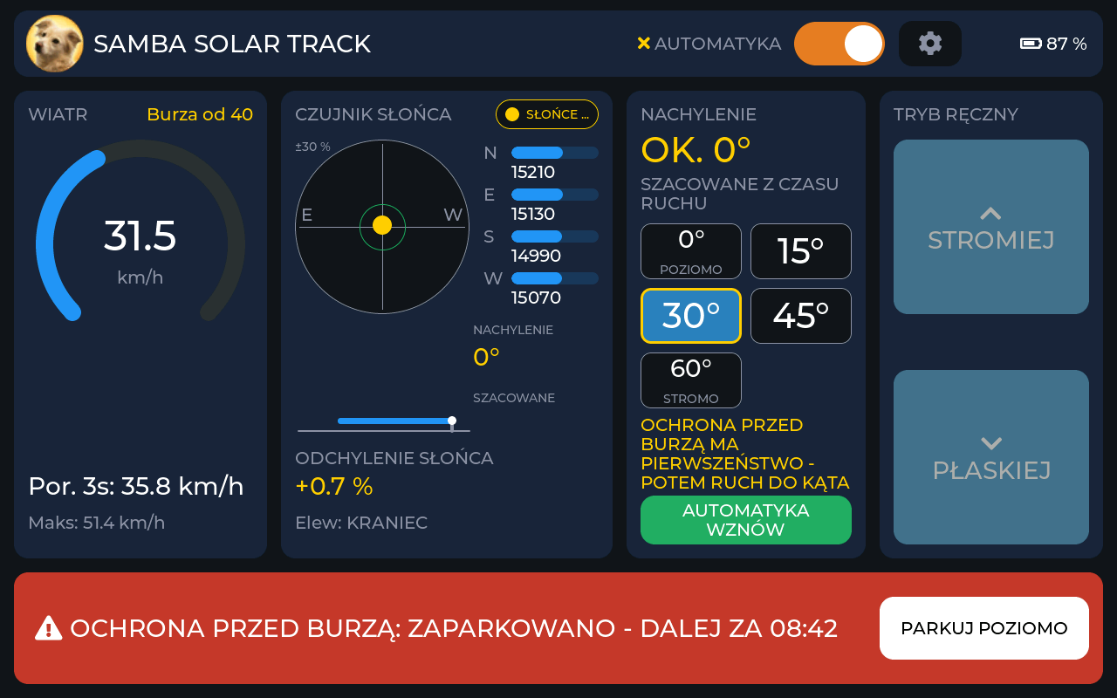
handbuch/img/screens10_pl/n12_neigung_sturm_hat_vorrang.png
