ssbingo/samba-solar-track/handbuch/img/screens10_pl/n21_werte_fahrzeiten.png

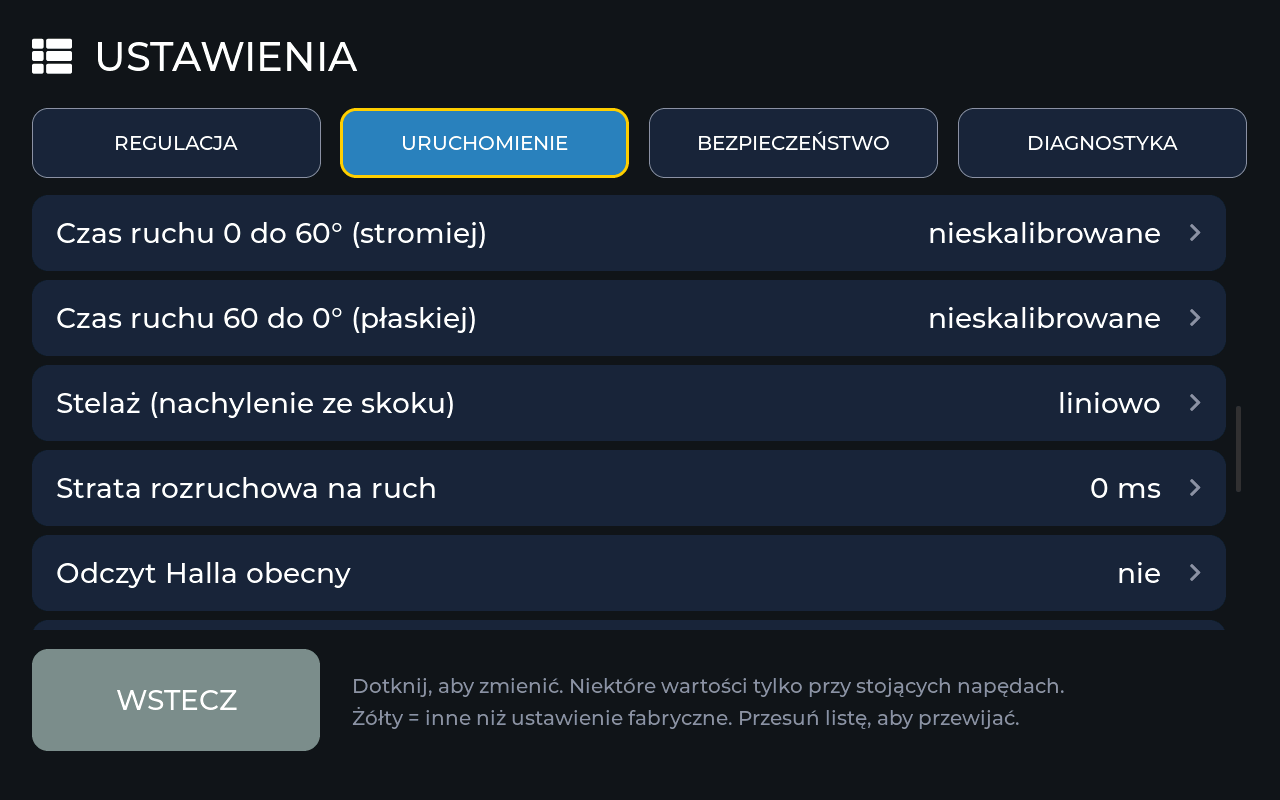
handbuch/img/screens10_pl/n21_werte_fahrzeiten.png
