ssbingo/samba-solar-track/handbuch/img/screens10_pl/n24_einmessen_bezugsfahrt.png

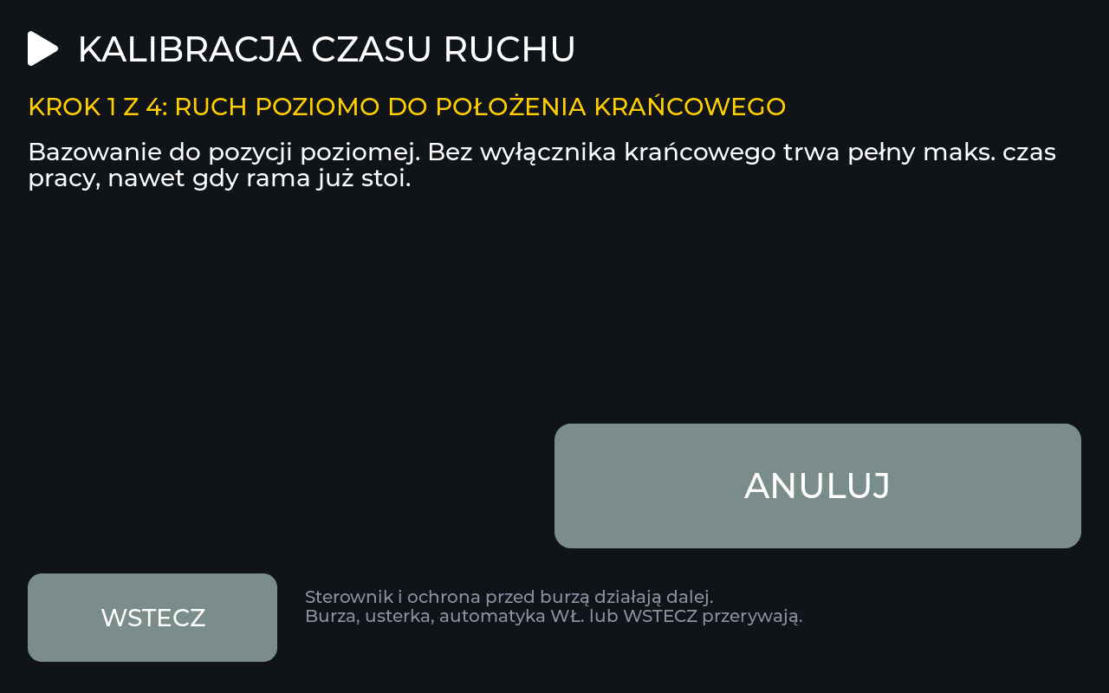
handbuch/img/screens10_pl/n24_einmessen_bezugsfahrt.png
