ssbingo/samba-solar-track/handbuch/img/screens10_pl/n28_einmessen_ergebnis.png

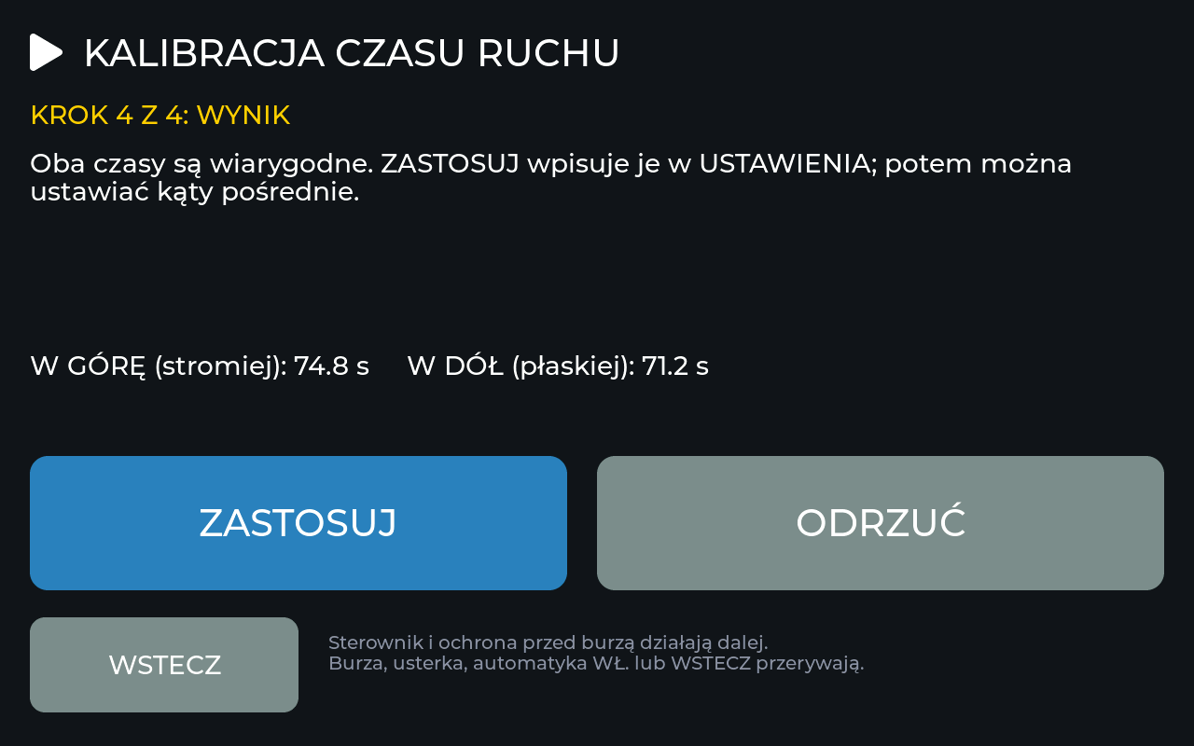
handbuch/img/screens10_pl/n28_einmessen_ergebnis.png
