ssbingo/samba-solar-track/handbuch/img/screens10_pl/p01_einrichtung.png

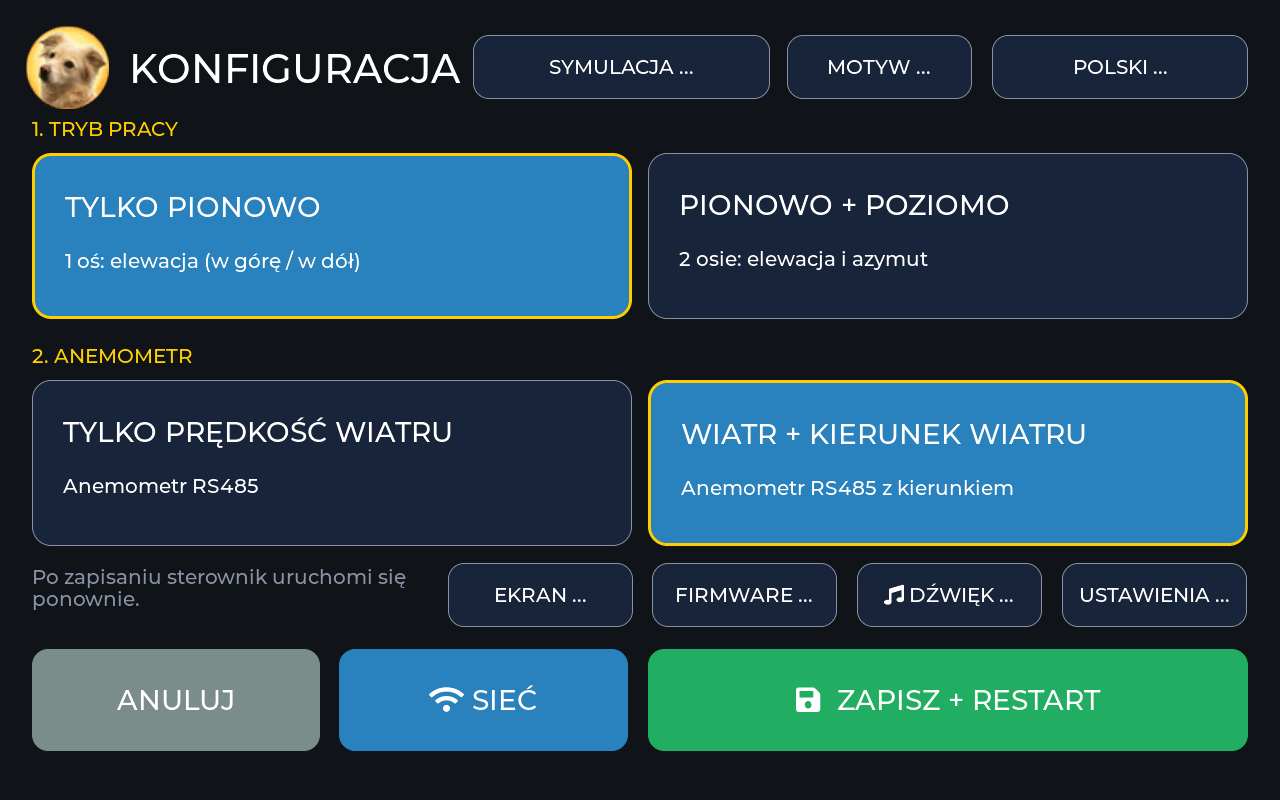
handbuch/img/screens10_pl/p01_einrichtung.png
