ssbingo/samba-solar-track/handbuch/img/screens10_pl/p08_ton.png

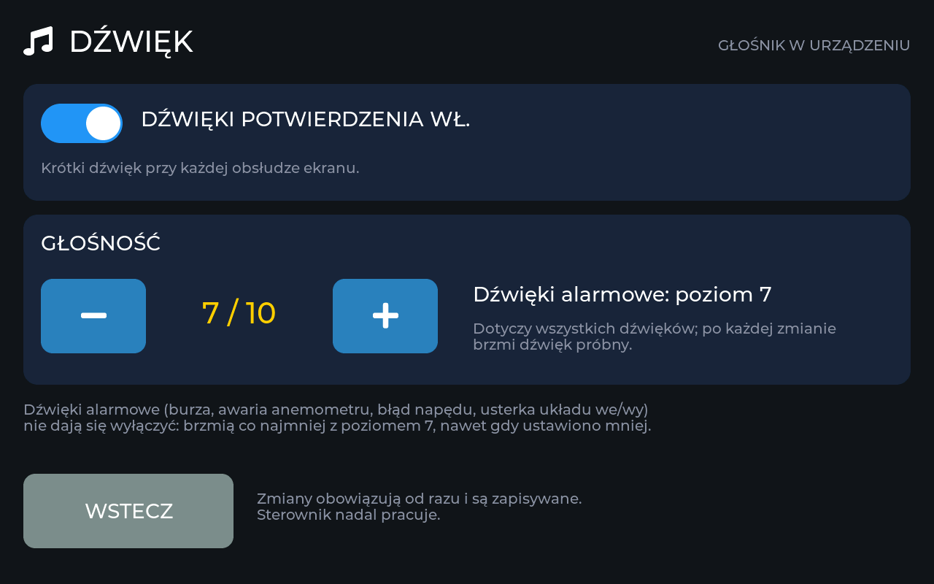
handbuch/img/screens10_pl/p08_ton.png
