ssbingo/samba-solar-track/handbuch/img/screens10_pl/p11_bildschirm.png

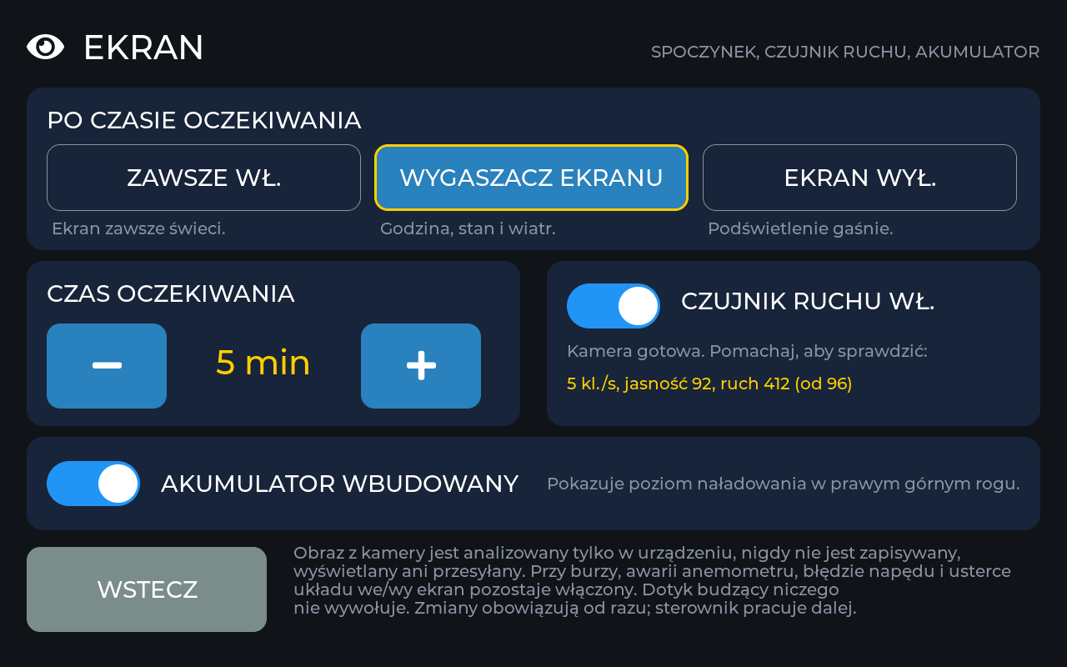
handbuch/img/screens10_pl/p11_bildschirm.png
