ssbingo/samba-solar-track/handbuch/img/screens10_pl/y1_06_windrichtung.png

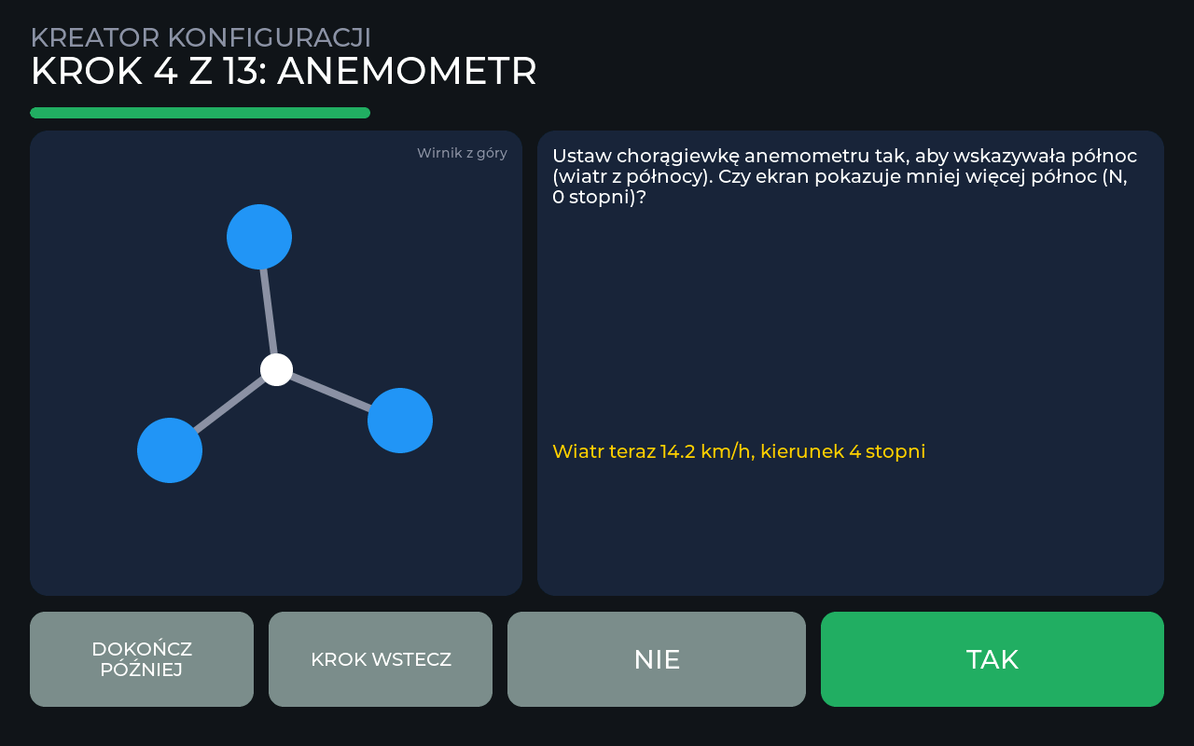
handbuch/img/screens10_pl/y1_06_windrichtung.png
