ssbingo/samba-solar-track/handbuch/img/screens10_pl/y1_24_probelauf_frage.png

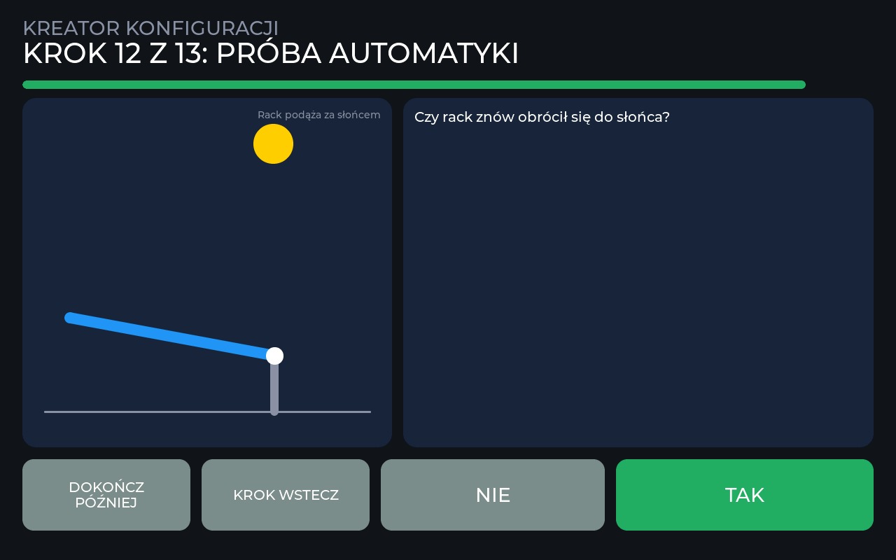
handbuch/img/screens10_pl/y1_24_probelauf_frage.png
