ssbingo/samba-solar-track/handbuch/img/screens10_pl/y1_25_abbruch_sturm.png

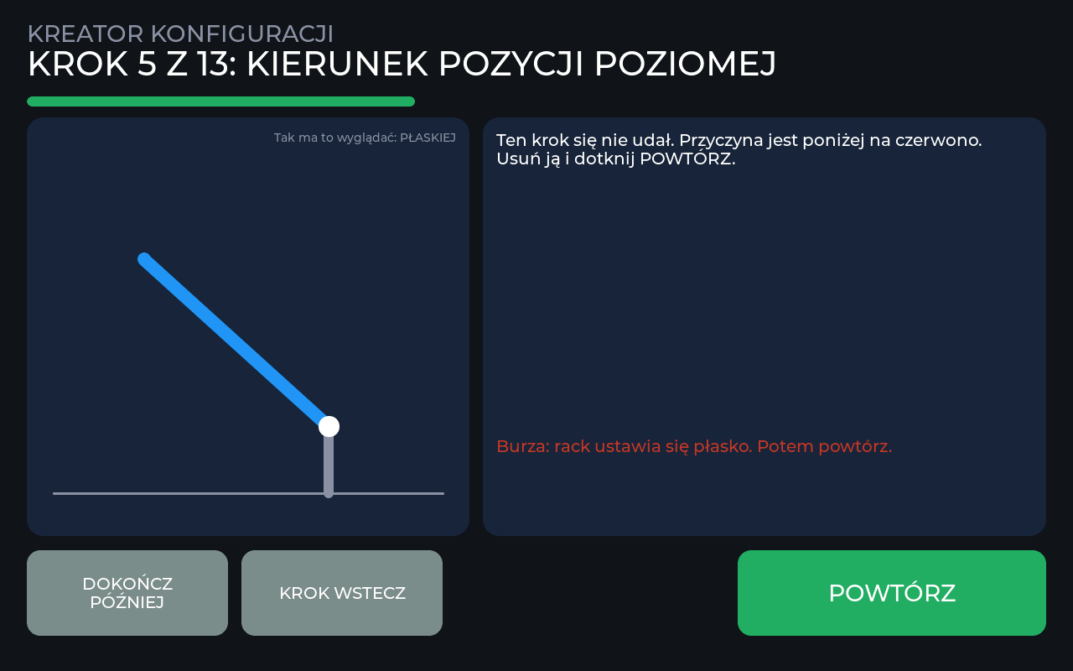
handbuch/img/screens10_pl/y1_25_abbruch_sturm.png
