ssbingo/samba-solar-track/handbuch/img/screens10_pl/y2_11_fahrweg_frage.png

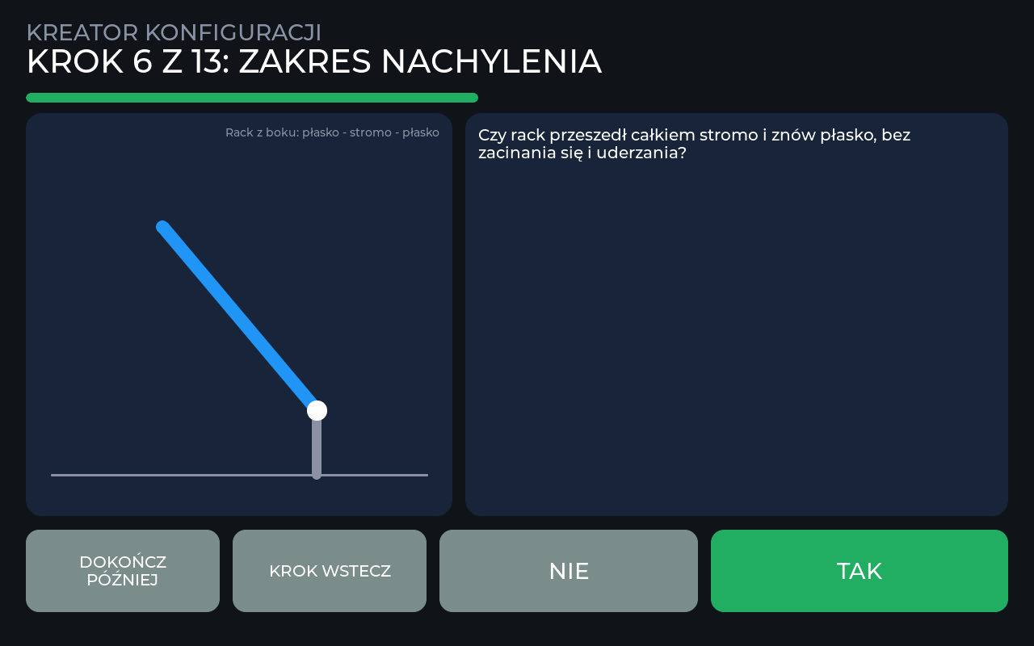
handbuch/img/screens10_pl/y2_11_fahrweg_frage.png
