ssbingo/samba-solar-track/handbuch/img/screens10_pl/y2_14_azimut_tauschen.png

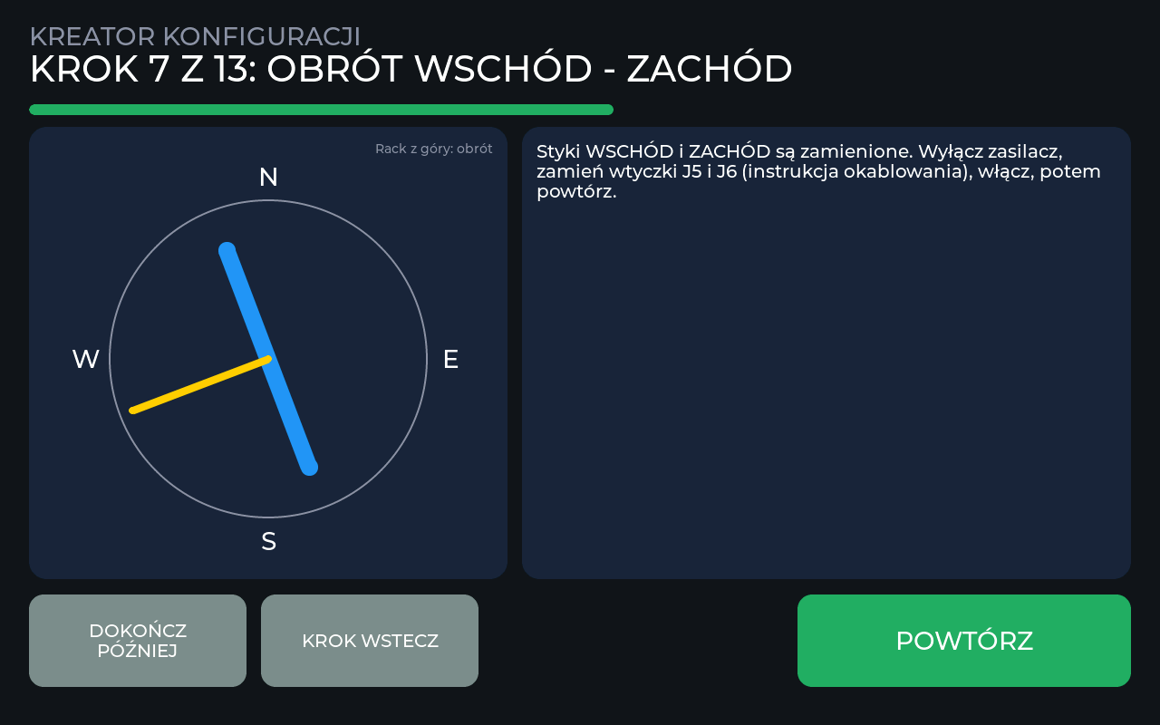
handbuch/img/screens10_pl/y2_14_azimut_tauschen.png
