ssbingo/samba-solar-track/handbuch/img/screens10_pt/n03_neigung_30_gehalten.png

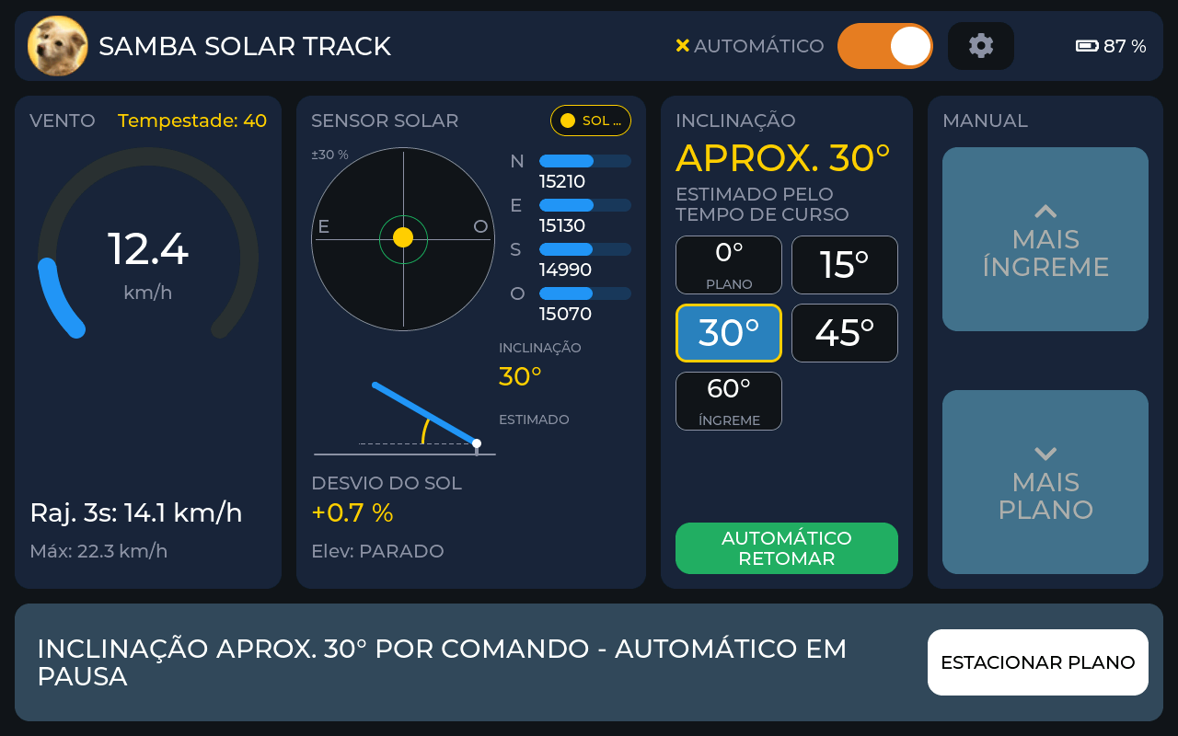
handbuch/img/screens10_pt/n03_neigung_30_gehalten.png
