ssbingo/samba-solar-track/handbuch/img/screens10_pt/n06_neigung_fahrt_steiler.png

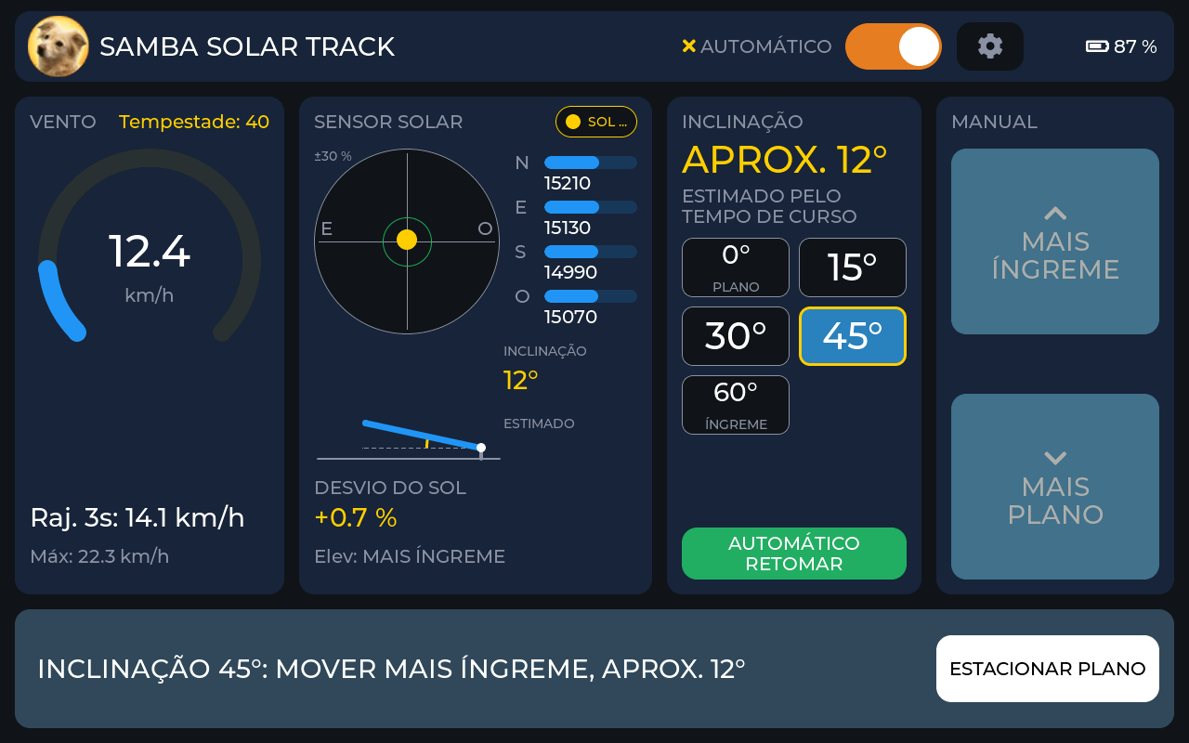
handbuch/img/screens10_pt/n06_neigung_fahrt_steiler.png
