ssbingo/samba-solar-track/handbuch/img/screens10_pt/n16_neigung_hall_gestoert.png

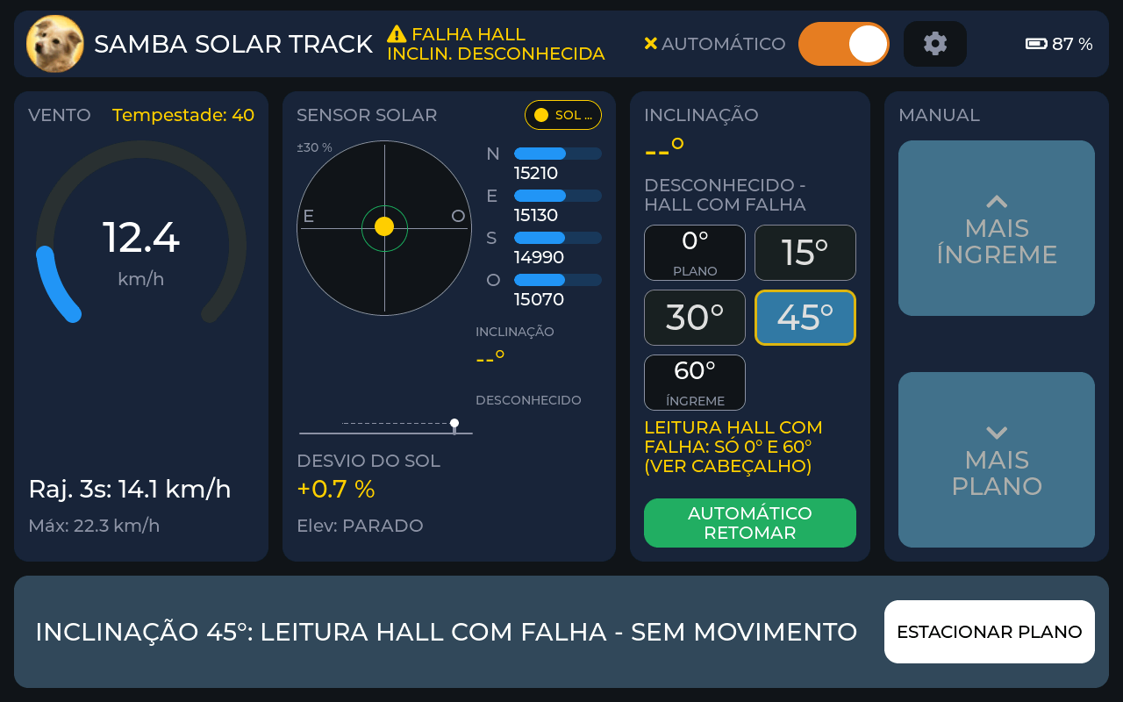
handbuch/img/screens10_pt/n16_neigung_hall_gestoert.png
