ssbingo/samba-solar-track/handbuch/img/screens10_pt/n28_einmessen_ergebnis.png

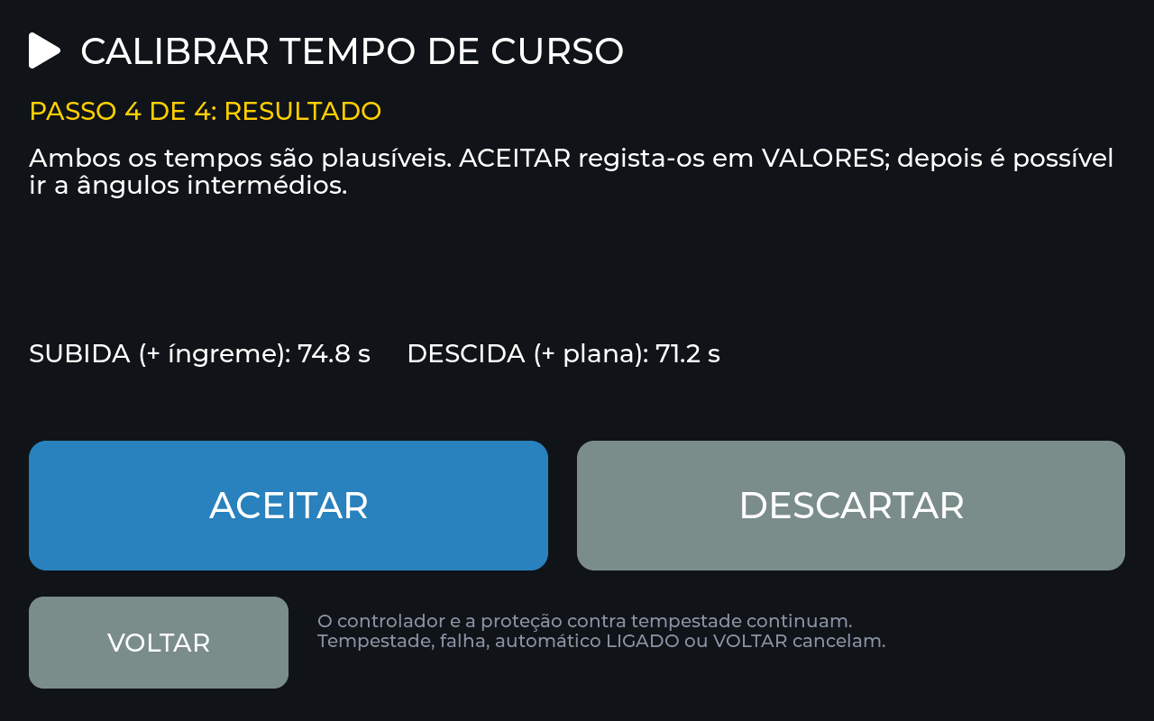
handbuch/img/screens10_pt/n28_einmessen_ergebnis.png
