ssbingo/samba-solar-track/handbuch/img/screens10_pt/p11_bildschirm.png

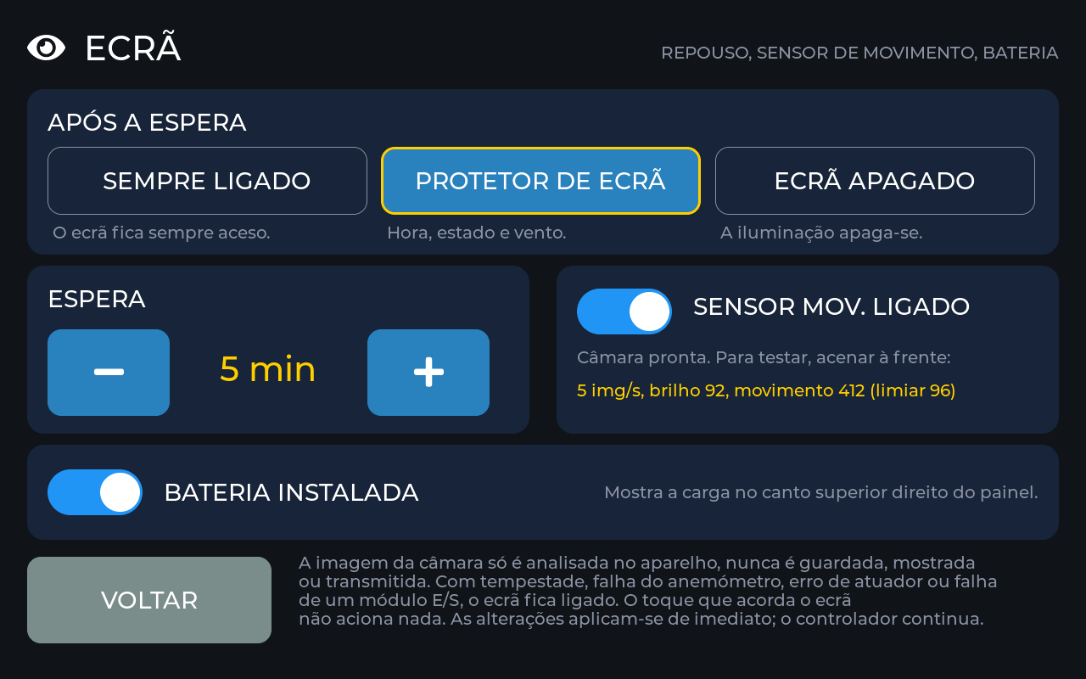
handbuch/img/screens10_pt/p11_bildschirm.png
