ssbingo/samba-solar-track/handbuch/img/screens10_pt/r02_werte_reset_anschluss.png

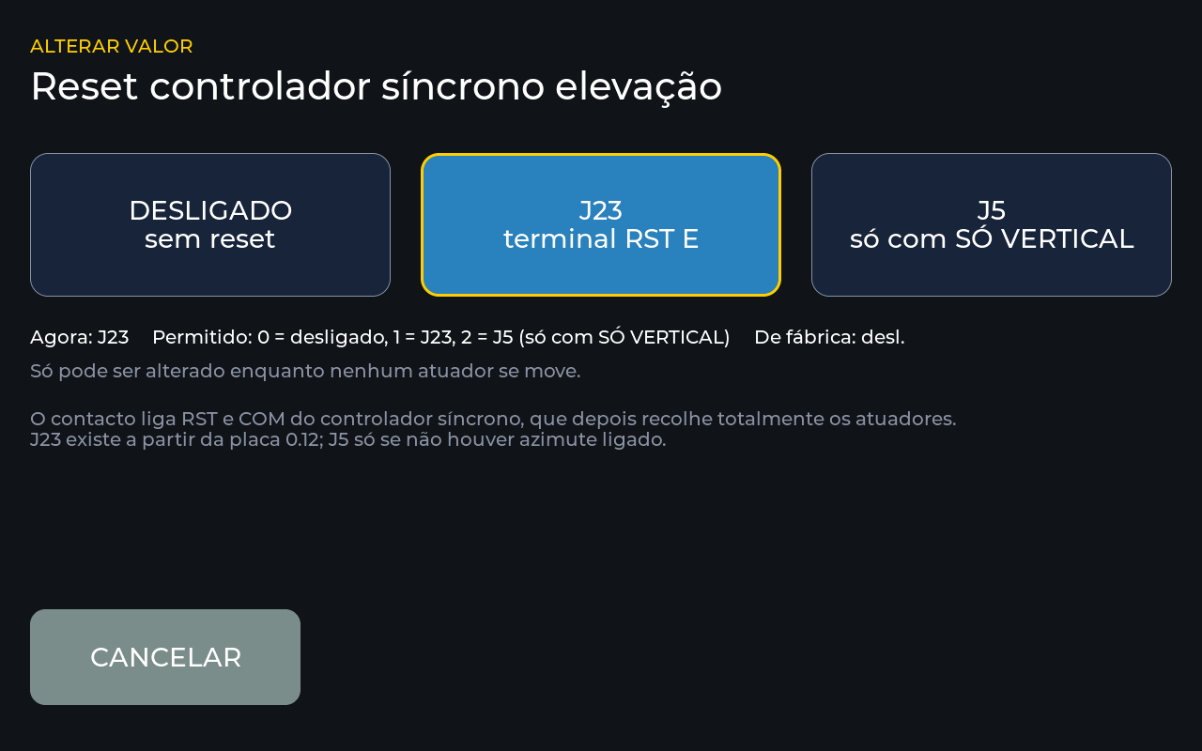
handbuch/img/screens10_pt/r02_werte_reset_anschluss.png
