ssbingo/samba-solar-track/handbuch/img/screens10_pt/r12_band_phase3_einfahren.png

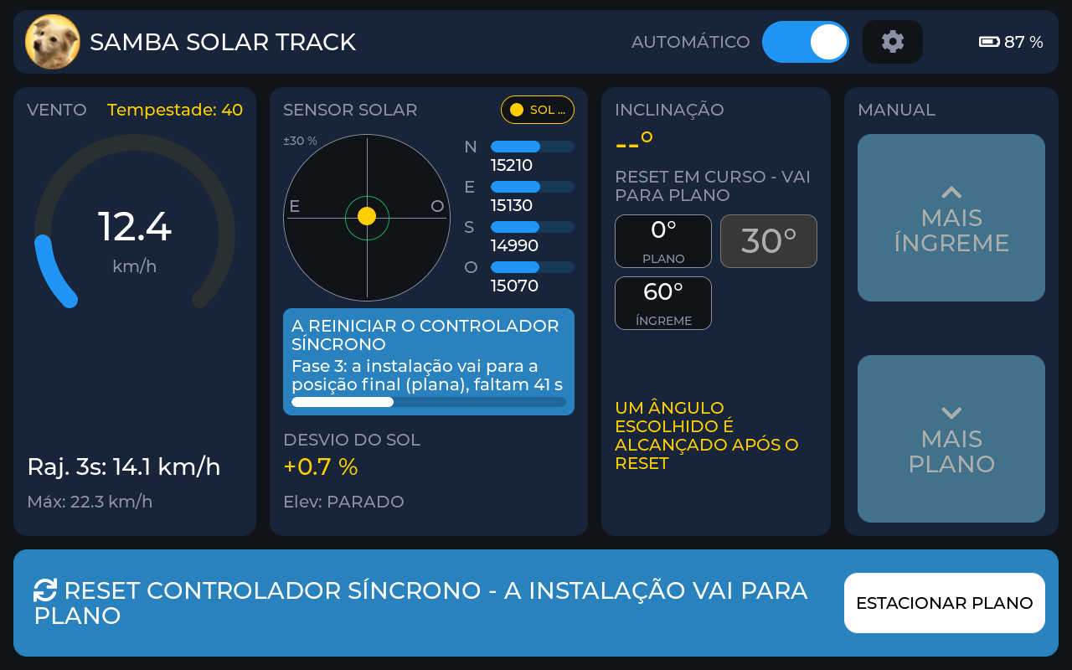
handbuch/img/screens10_pt/r12_band_phase3_einfahren.png
