ssbingo/samba-solar-track/handbuch/img/screens10_pt/y1_04_platine_gut.png

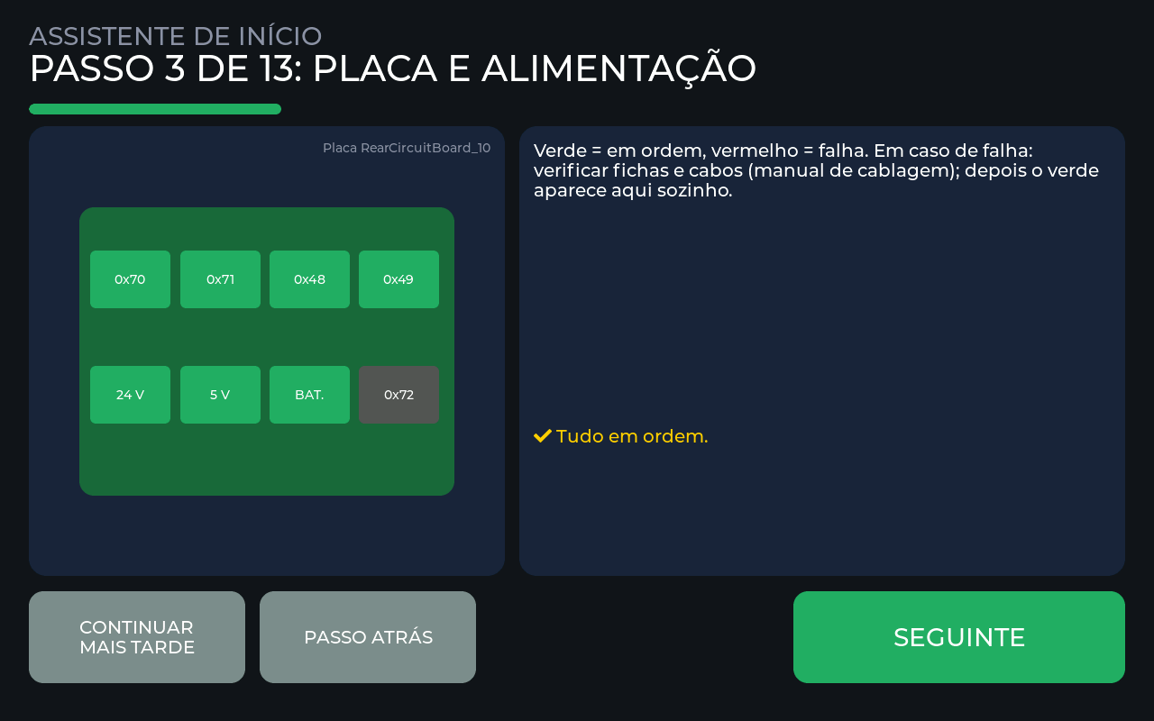
handbuch/img/screens10_pt/y1_04_platine_gut.png
