ssbingo/samba-solar-track/handbuch/img/screens10_pt/y2_10_fahrweg_steiler.png

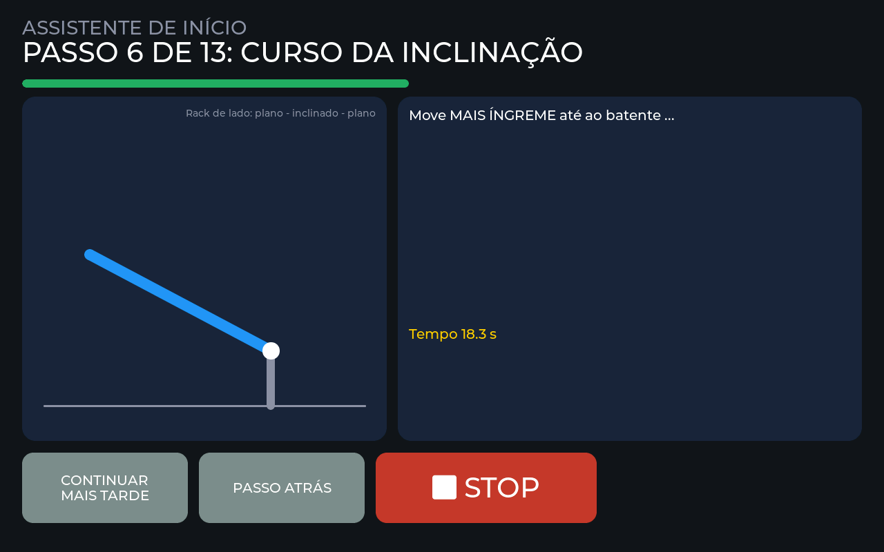
handbuch/img/screens10_pt/y2_10_fahrweg_steiler.png
