ssbingo/samba-solar-track/handbuch/img/screens10_pt/y2_15_azimut_west.png

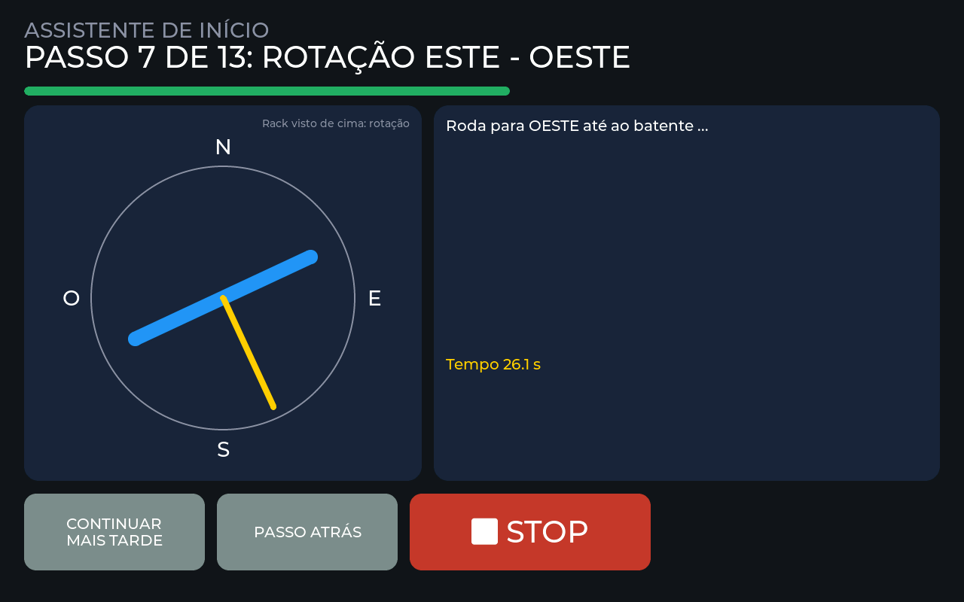
handbuch/img/screens10_pt/y2_15_azimut_west.png
