ssbingo/samba-solar-track/handbuch/img/screens10_pt/y2_15b_reset.png

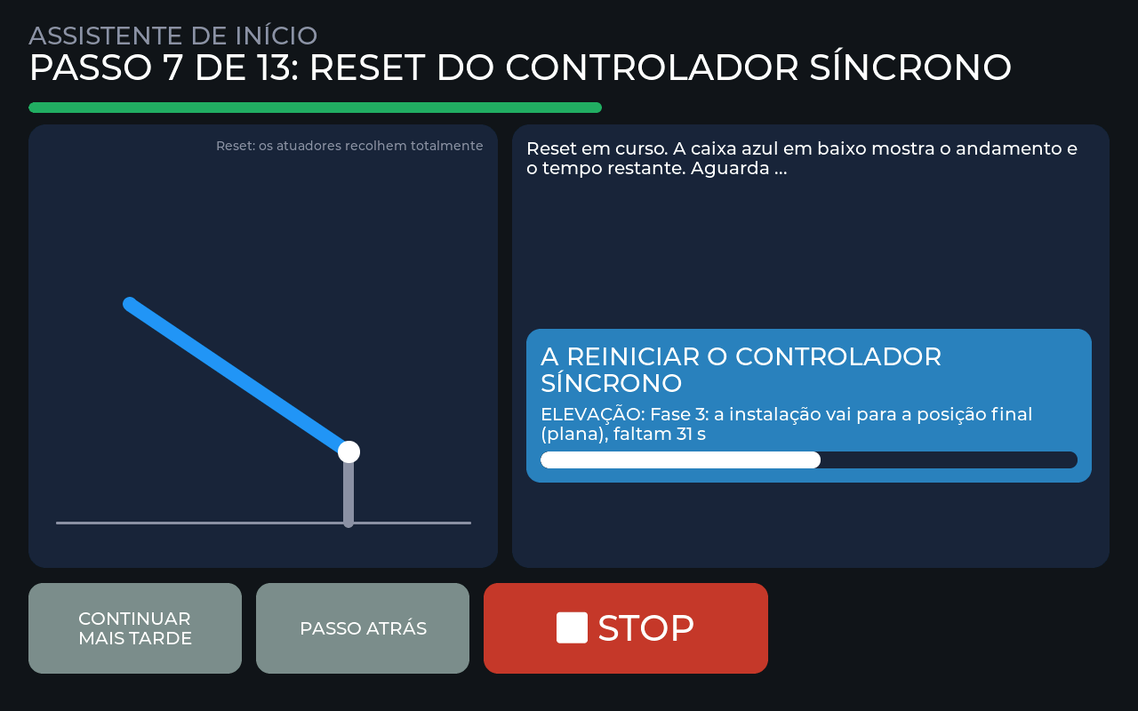
handbuch/img/screens10_pt/y2_15b_reset.png
