ssbingo/samba-solar-track/handbuch/img/sonnensensor-halter-foto-4.jpg

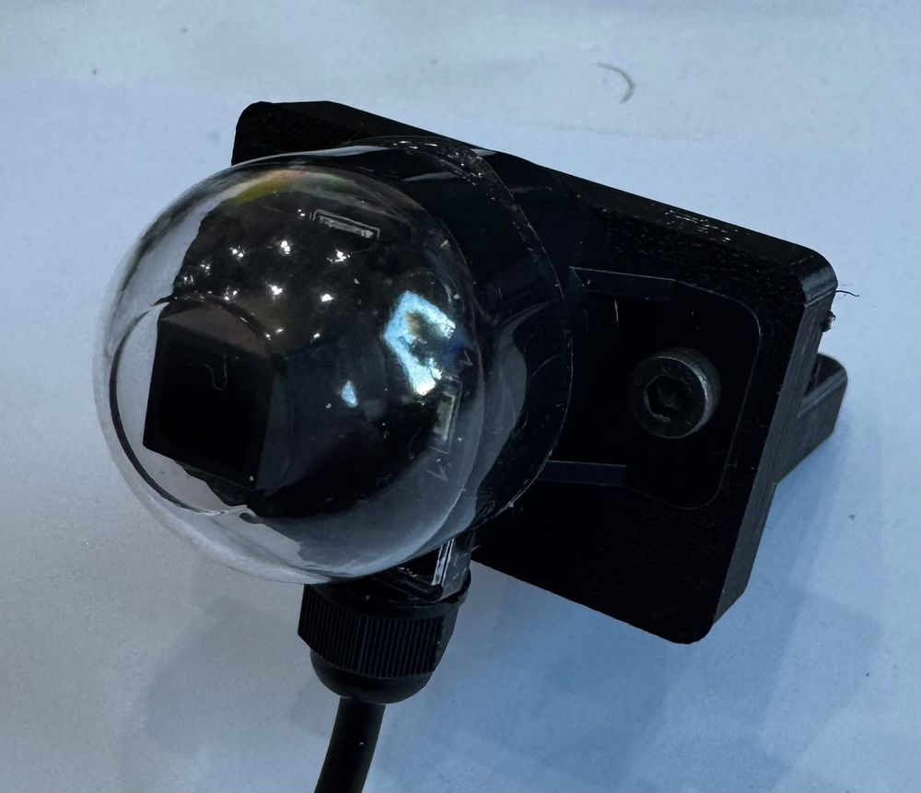
handbuch/img/sonnensensor-halter-foto-4.jpg
