ssbingo/samba-solar-track/handbuch/img/web/bericht_dunkel.png

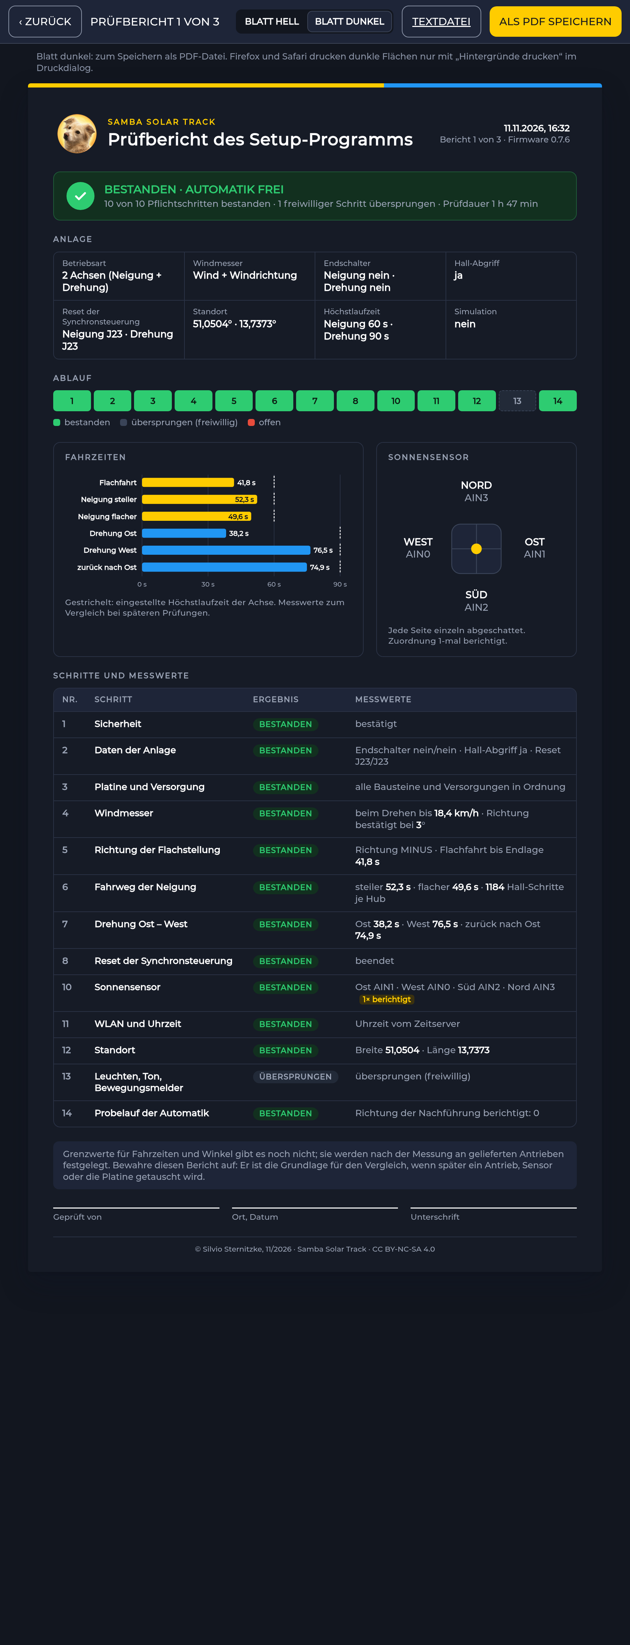
handbuch/img/web/bericht_dunkel.png
