ssbingo/samba-solar-track/handbuch/img/web/bericht_hell.png

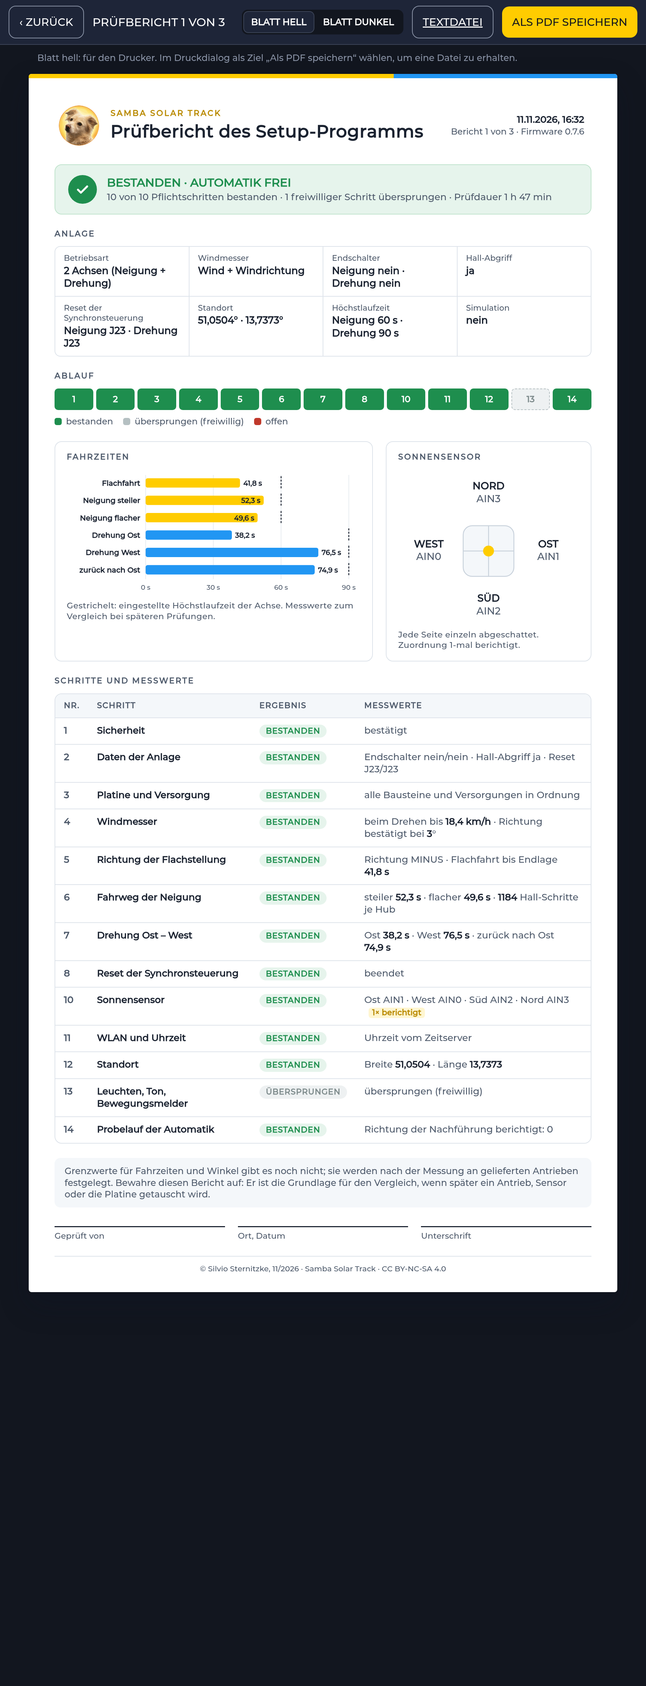
handbuch/img/web/bericht_hell.png
