ssbingo/samba-solar-track/handbuch/img/web/einrichtung_karte.png

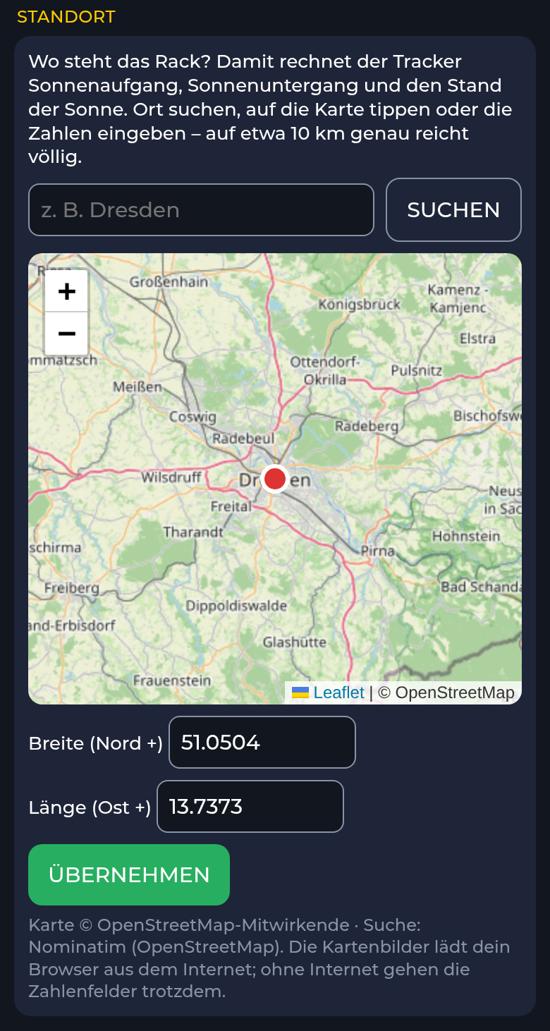
handbuch/img/web/einrichtung_karte.png
