ssbingo/samba-solar-track/handbuch/img/web/gesperrt.png

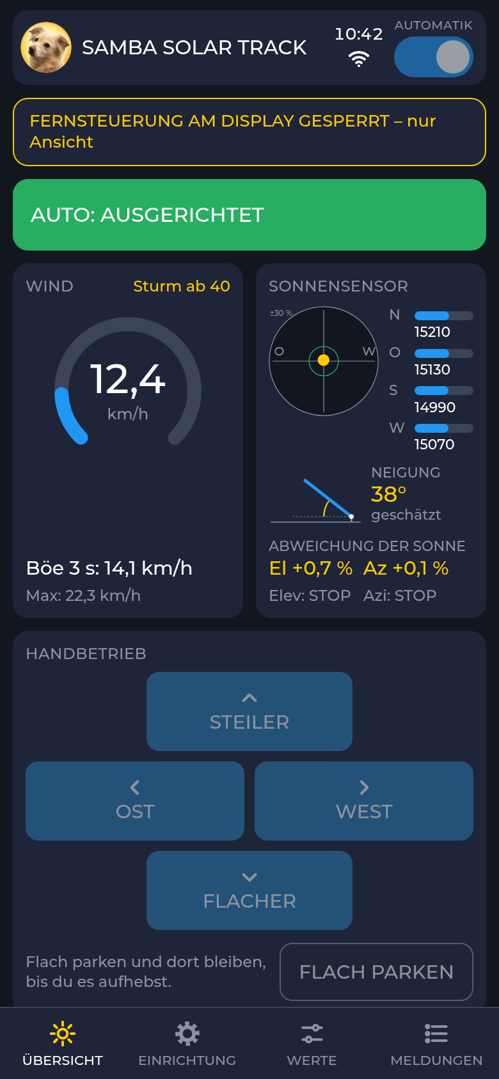
handbuch/img/web/gesperrt.png
