ssbingo/samba-solar-track/handbuch/img/web_en/bericht_dunkel.png

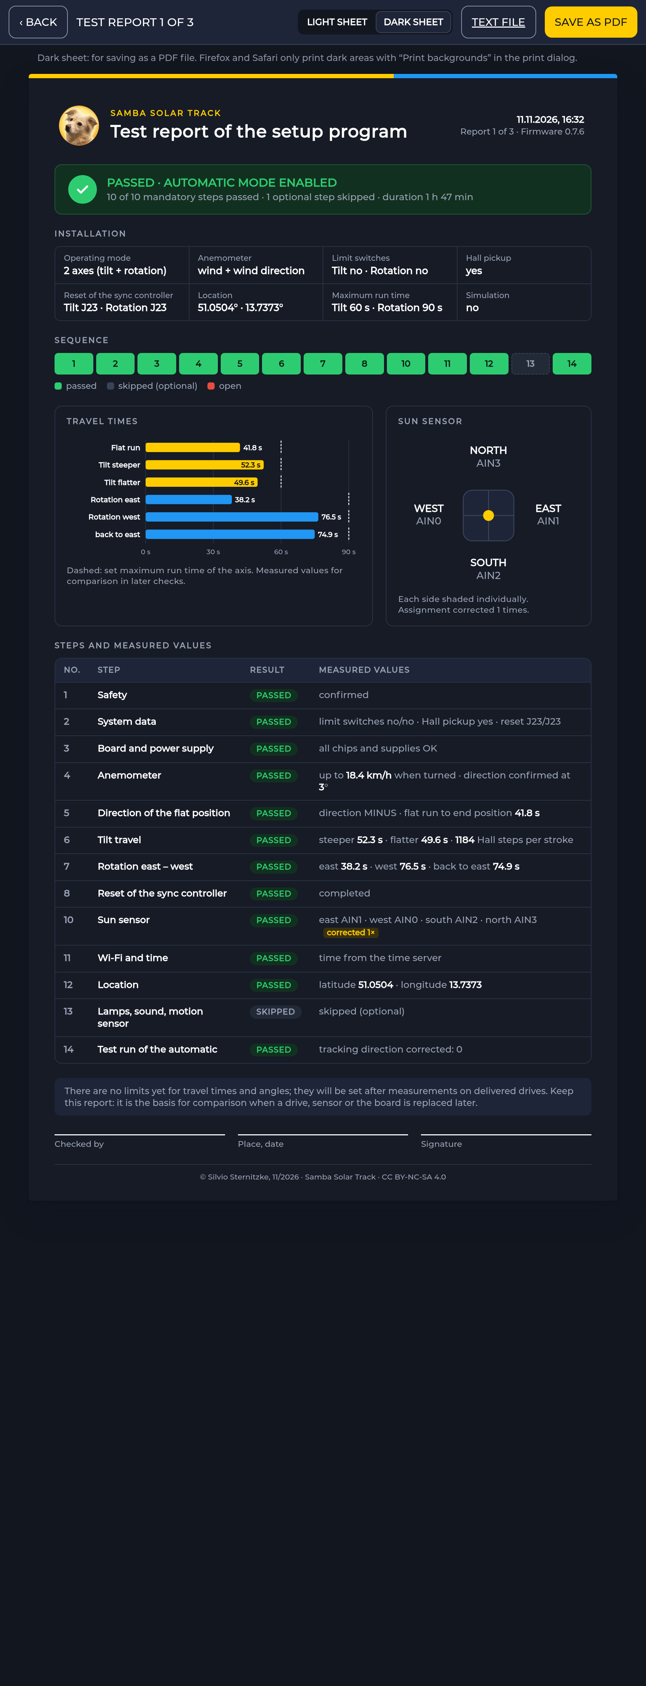
handbuch/img/web_en/bericht_dunkel.png
