ssbingo/samba-solar-track/handbuch/img/web_en/bericht_hell.png

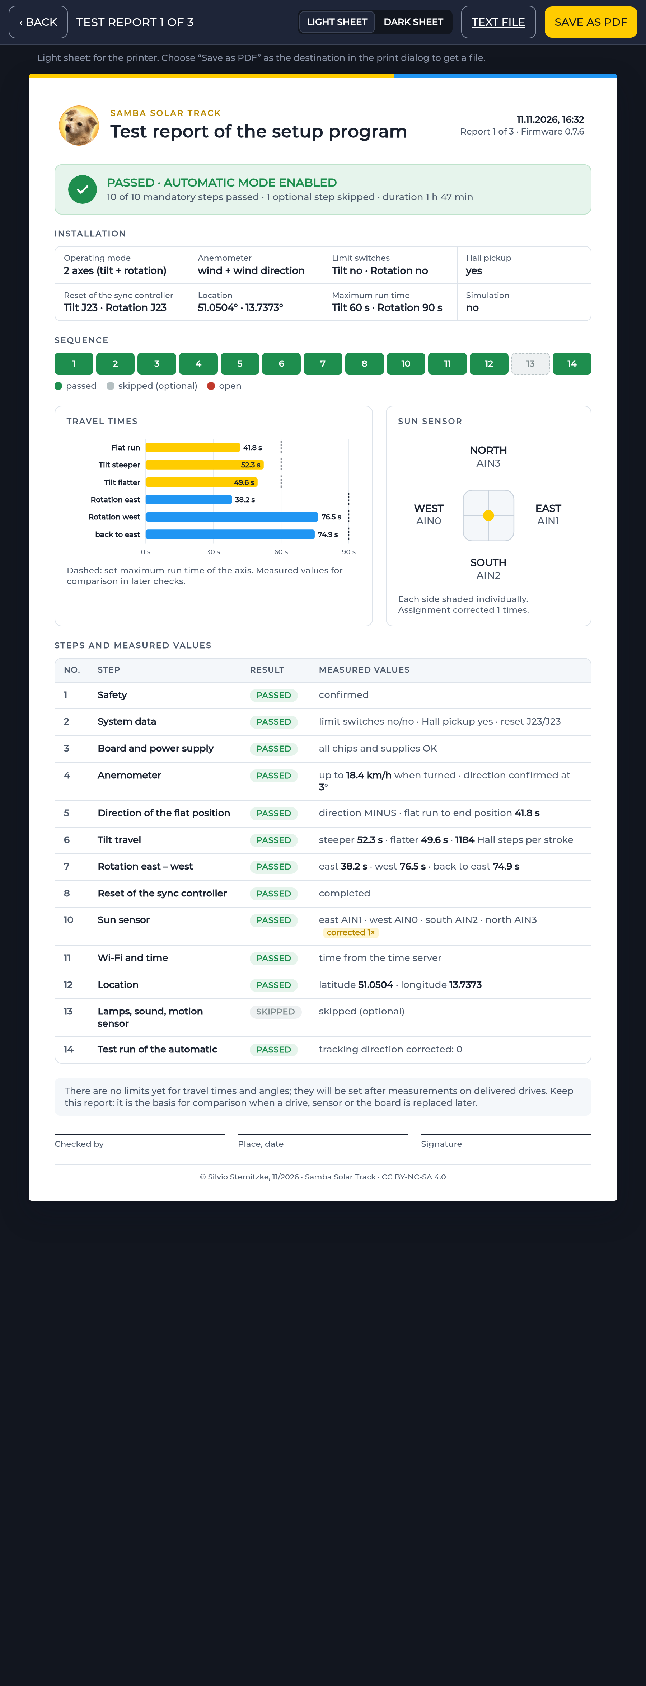
handbuch/img/web_en/bericht_hell.png
