ssbingo/samba-solar-track/handbuch/img/web_en/einrichtung_karte.png

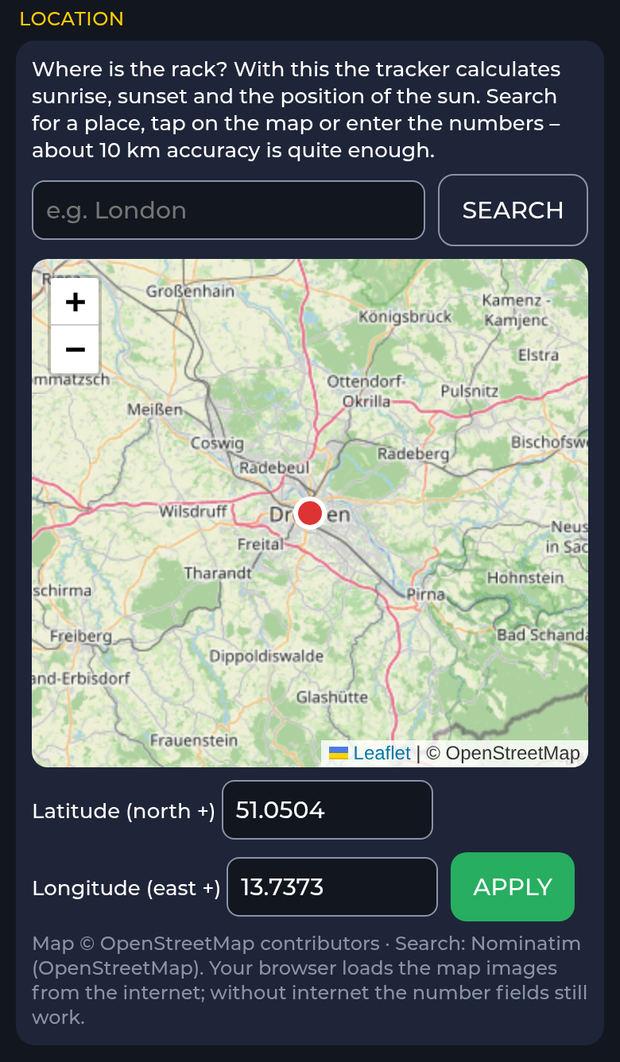
handbuch/img/web_en/einrichtung_karte.png
