ssbingo/samba-solar-track/handbuch/img/web_en/zehnzoll_zwei_achsen.png

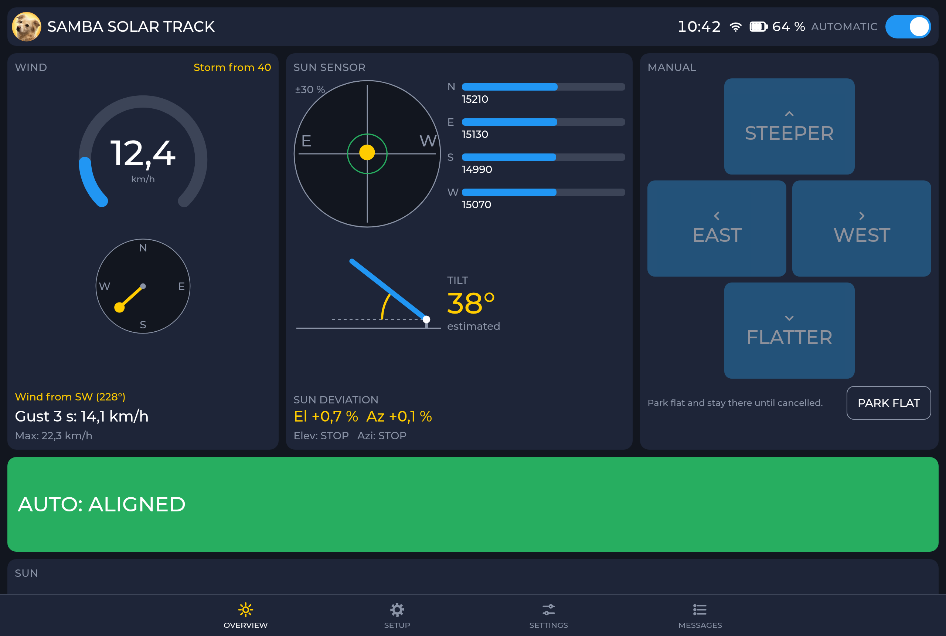
handbuch/img/web_en/zehnzoll_zwei_achsen.png
