ssbingo/samba-solar-track/handbuch/img/web_es/anmelden.png

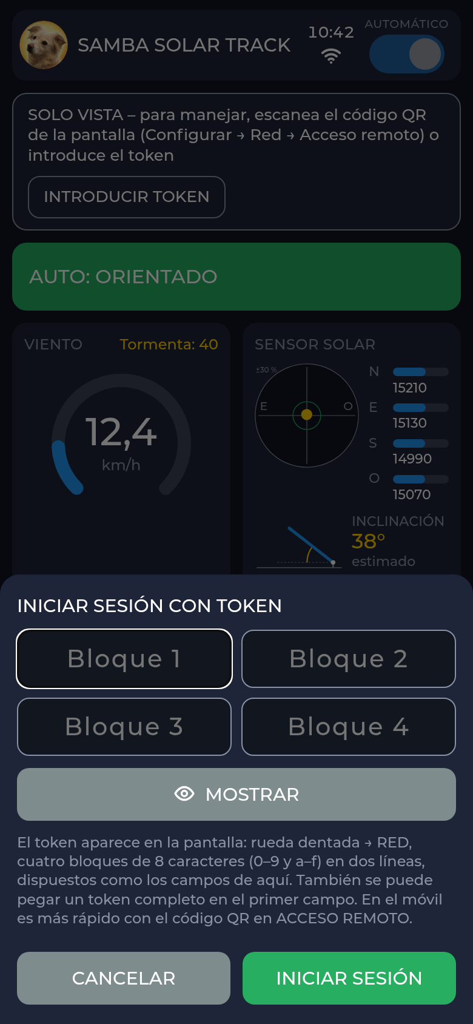
handbuch/img/web_es/anmelden.png
