ssbingo/samba-solar-track/handbuch/img/web_es/bericht_dunkel.png

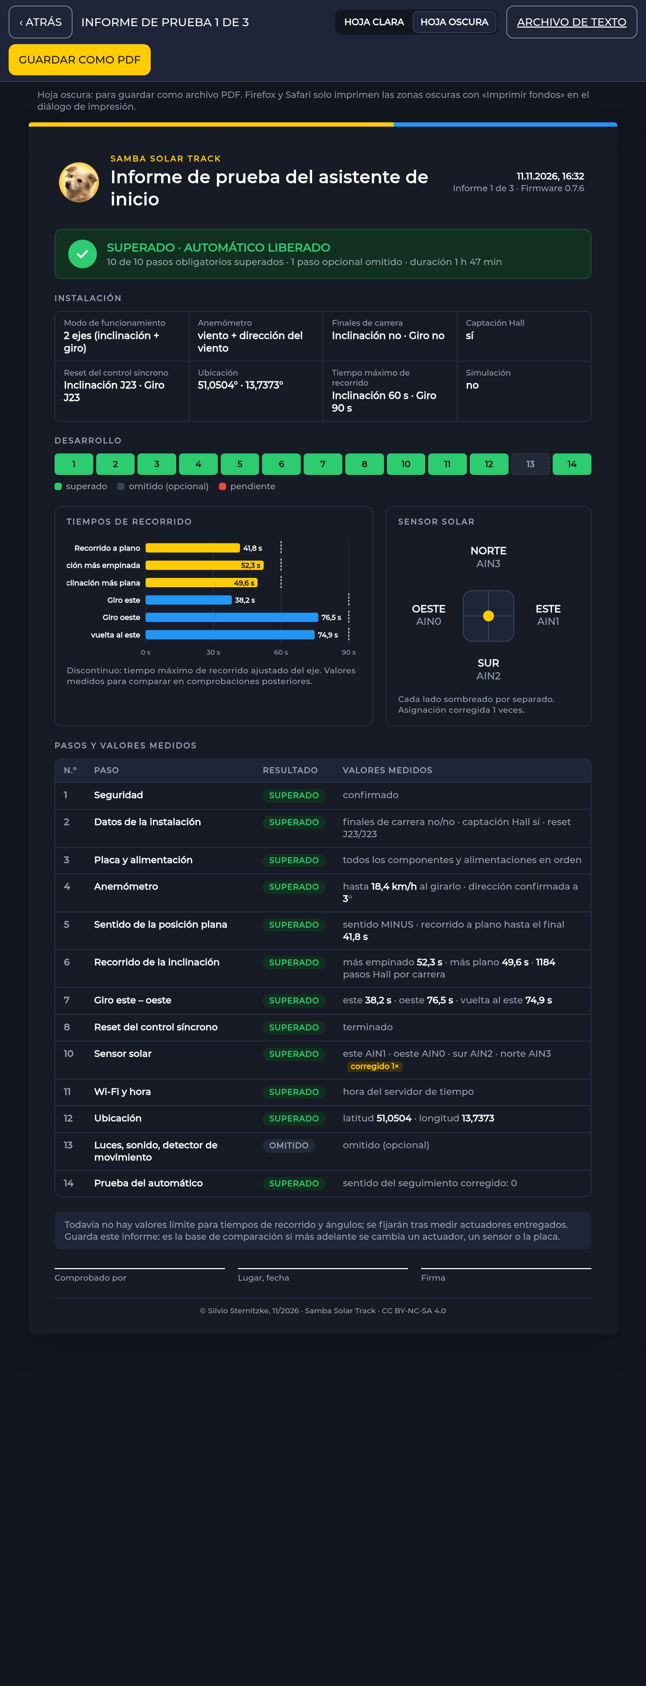
handbuch/img/web_es/bericht_dunkel.png
