ssbingo/samba-solar-track/handbuch/img/web_es/bericht_hell.png

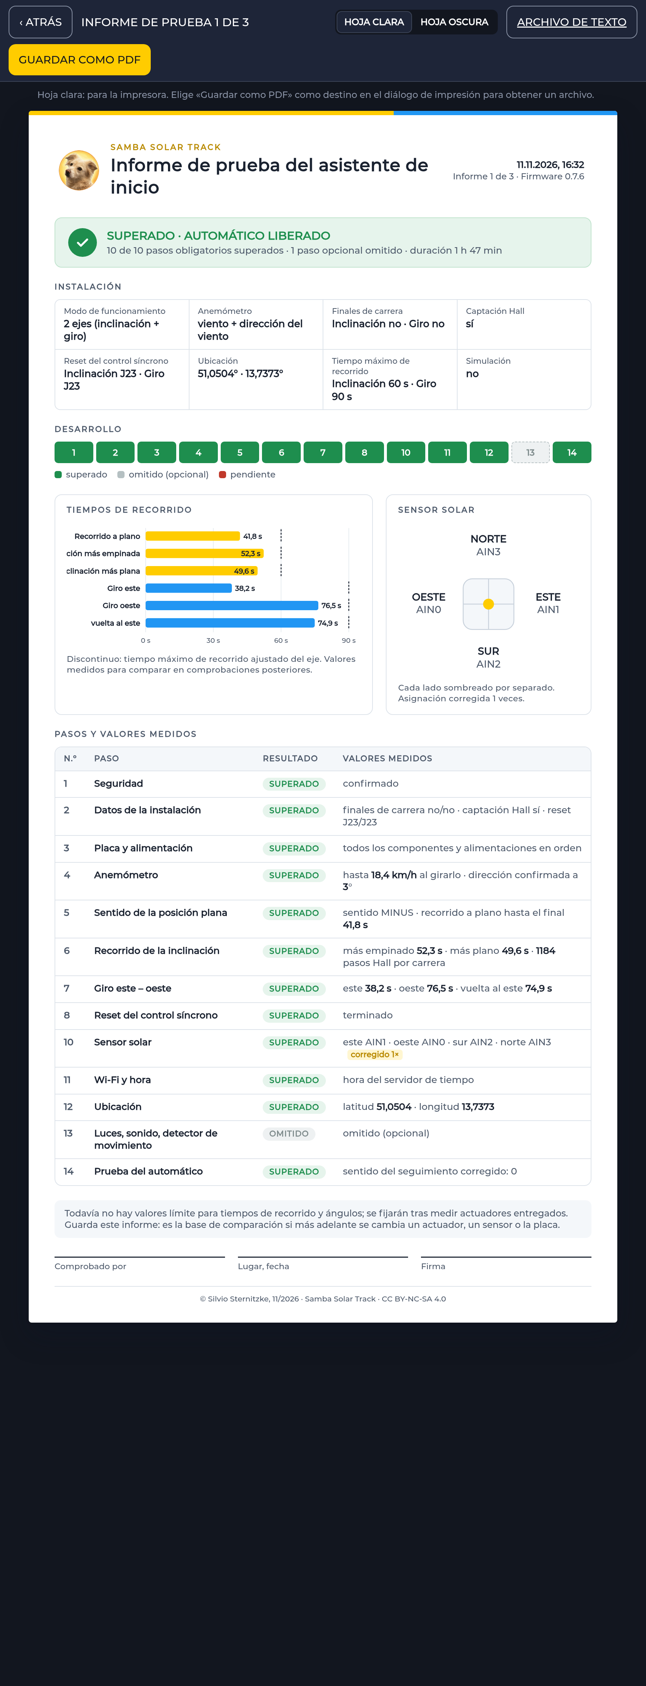
handbuch/img/web_es/bericht_hell.png
