ssbingo/samba-solar-track/handbuch/img/web_fr/bericht_hell.png

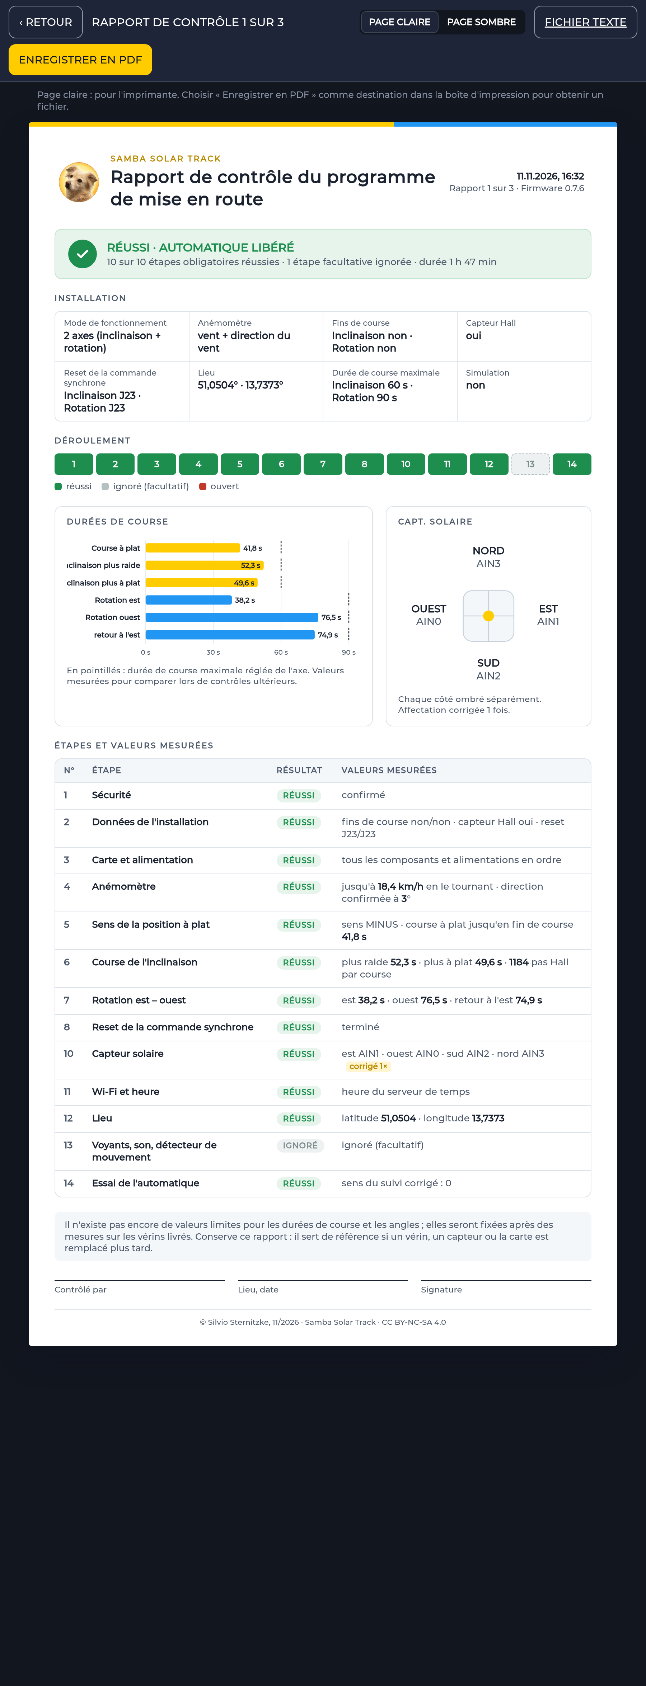
handbuch/img/web_fr/bericht_hell.png
