ssbingo/samba-solar-track/handbuch/img/web_fr/sonne_zwei_achsen.png

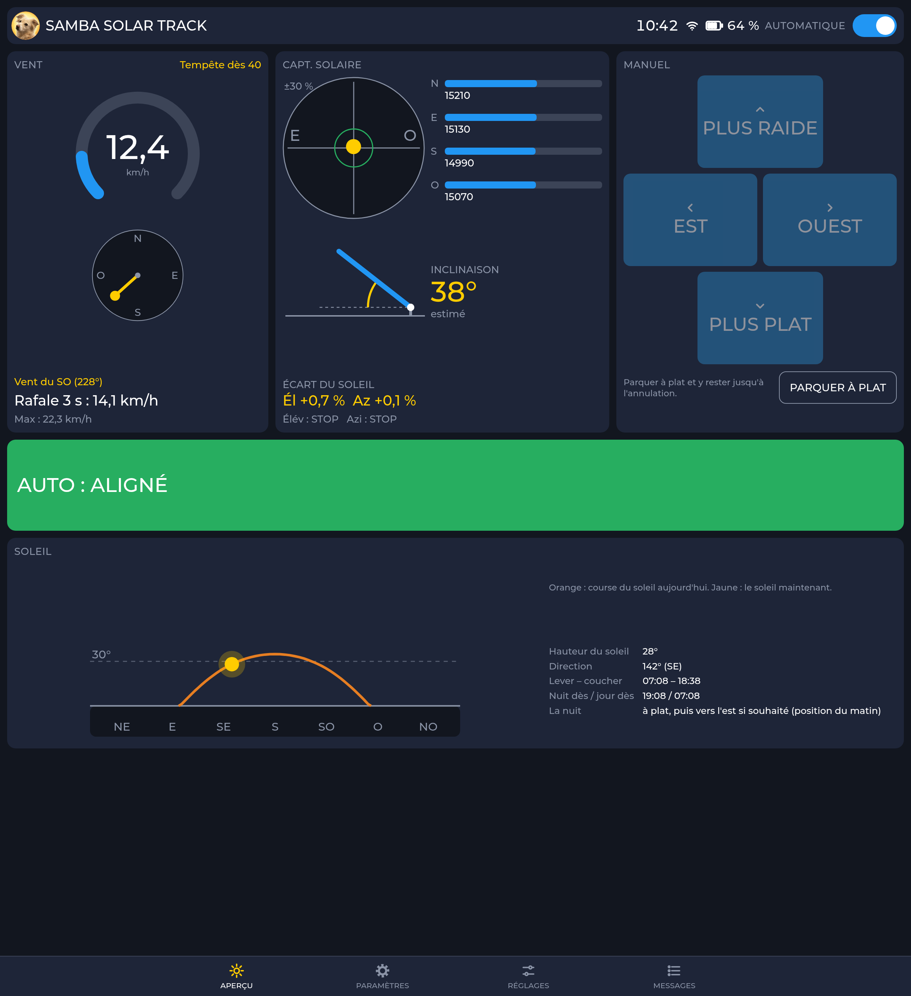
handbuch/img/web_fr/sonne_zwei_achsen.png
