ssbingo/samba-solar-track/handbuch/img/web_nl/anmelden.png

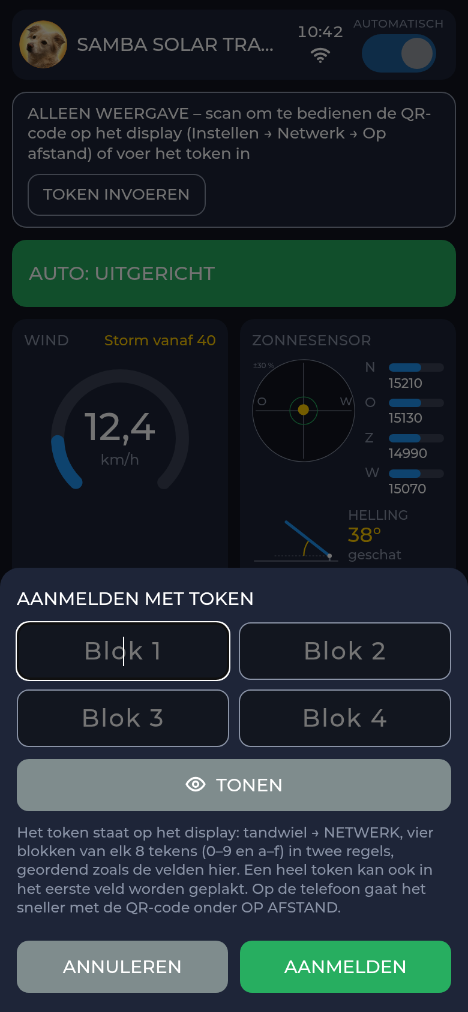
handbuch/img/web_nl/anmelden.png
