ssbingo/samba-solar-track/handbuch/img/web_nl/bericht_hell.png

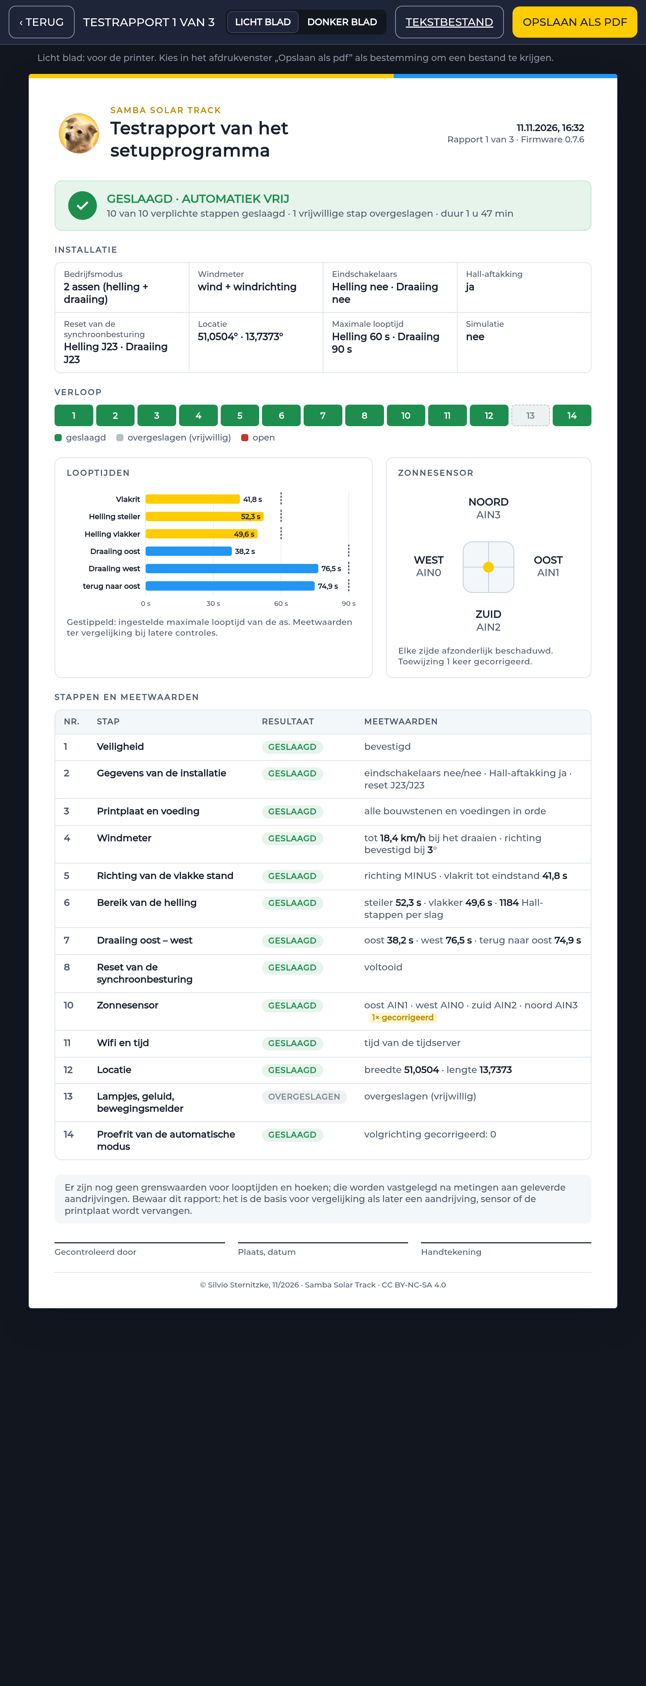
handbuch/img/web_nl/bericht_hell.png
