ssbingo/samba-solar-track/handbuch/img/web_nl/einrichtung_ausrichtung.png

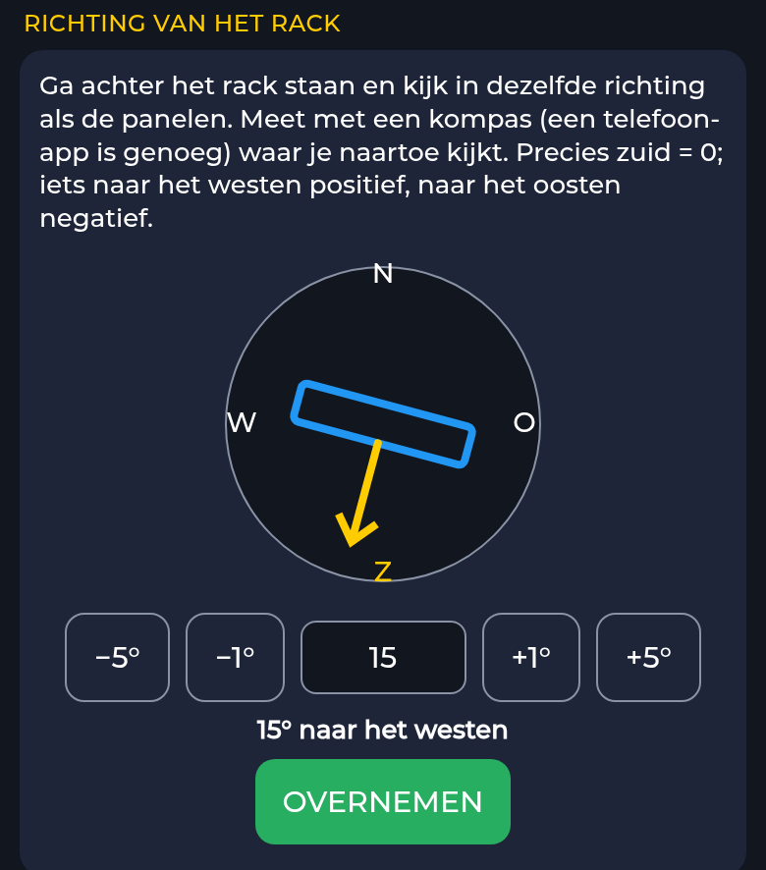
handbuch/img/web_nl/einrichtung_ausrichtung.png
