ssbingo/samba-solar-track/handbuch/img/web_nl/einrichtung_karte.png

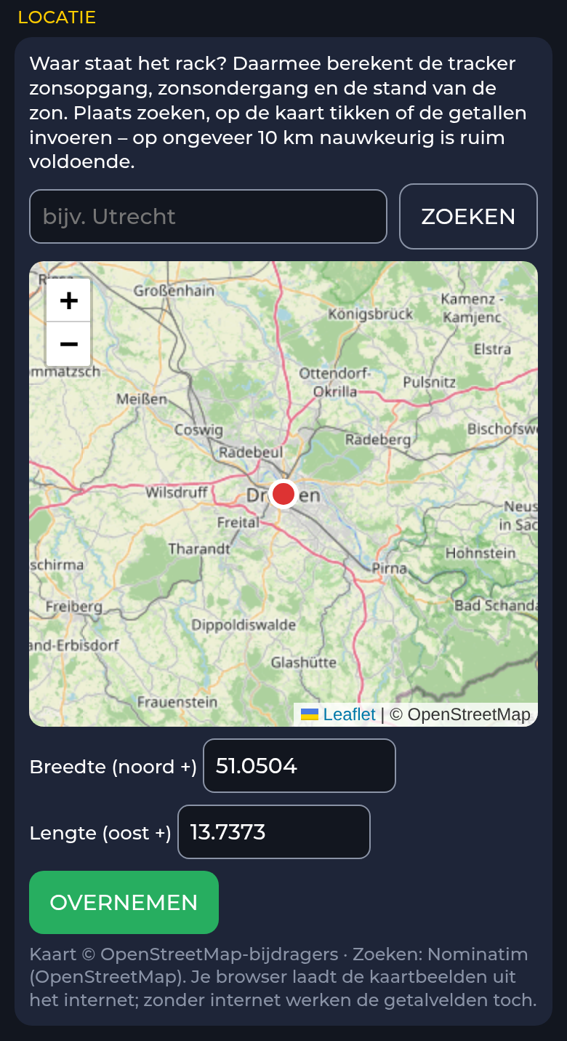
handbuch/img/web_nl/einrichtung_karte.png
