ssbingo/samba-solar-track/handbuch/img/web_nl/sonne_eine_achse.png

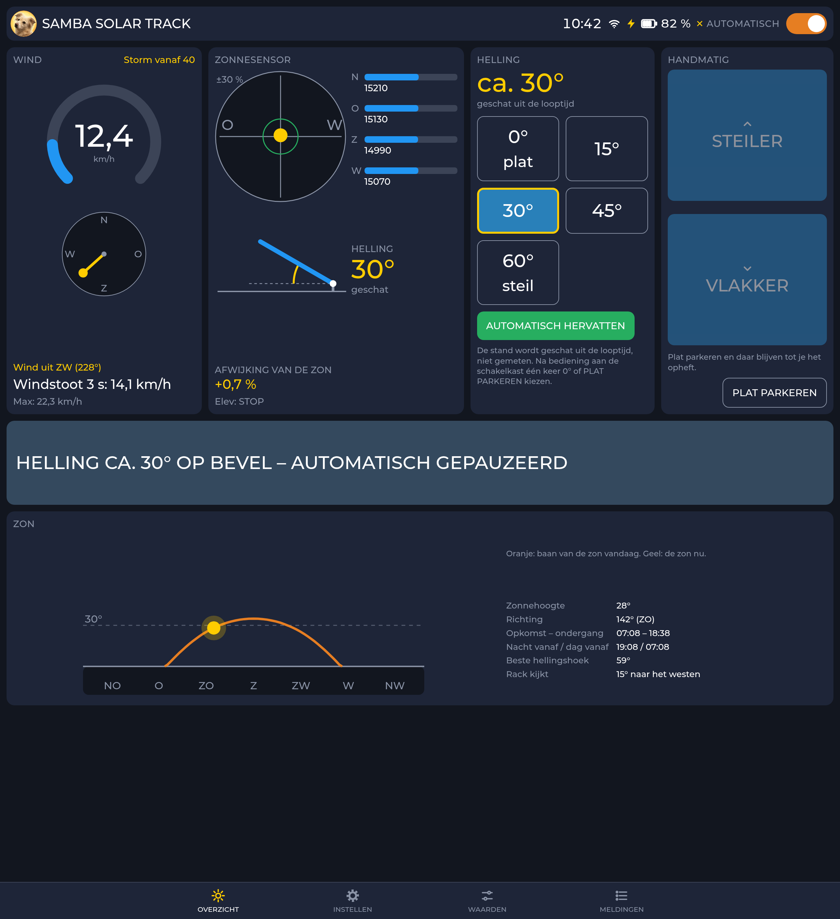
handbuch/img/web_nl/sonne_eine_achse.png
