ssbingo/samba-solar-track/handbuch/img/web_pl/bericht_hell.png

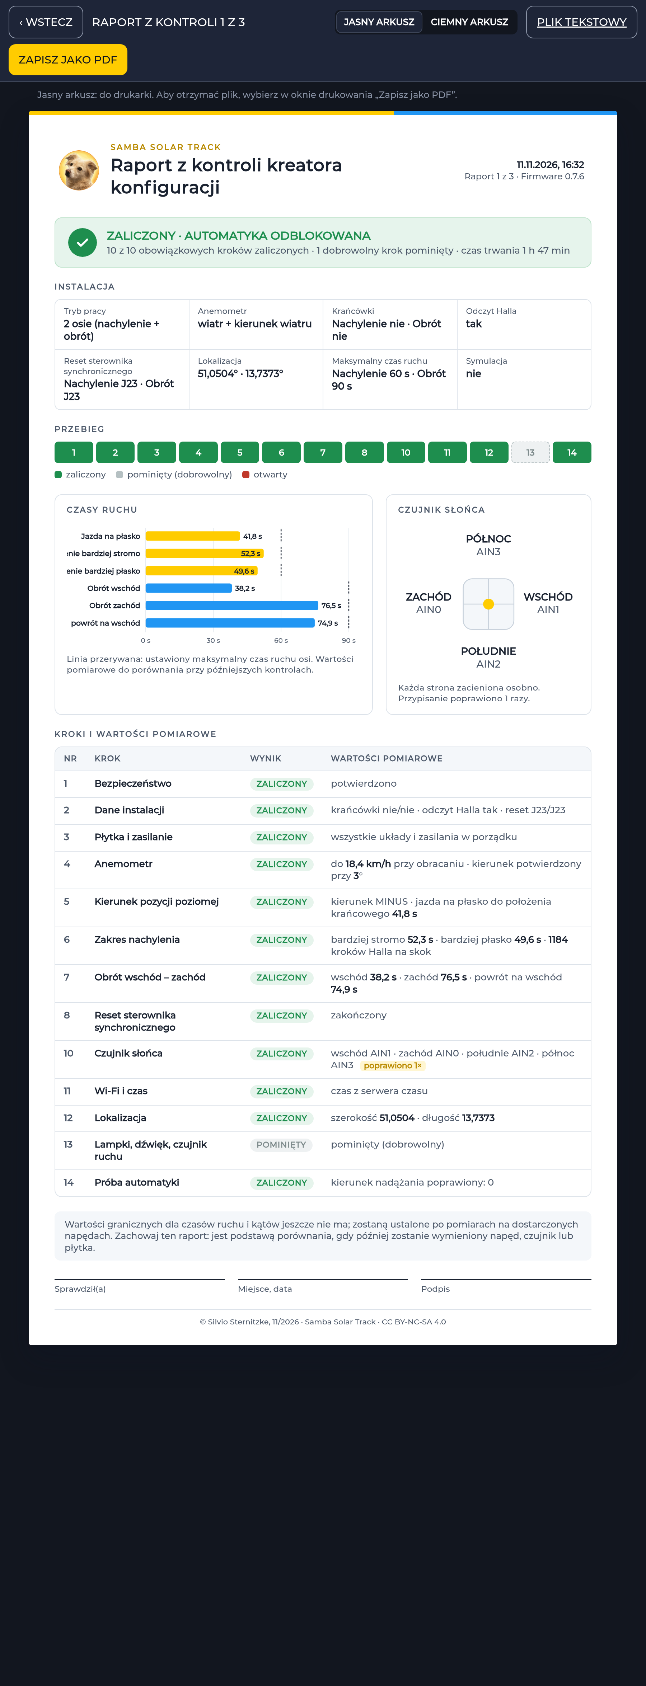
handbuch/img/web_pl/bericht_hell.png
