ssbingo/samba-solar-track/handbuch/img/web_pt/bericht_hell.png

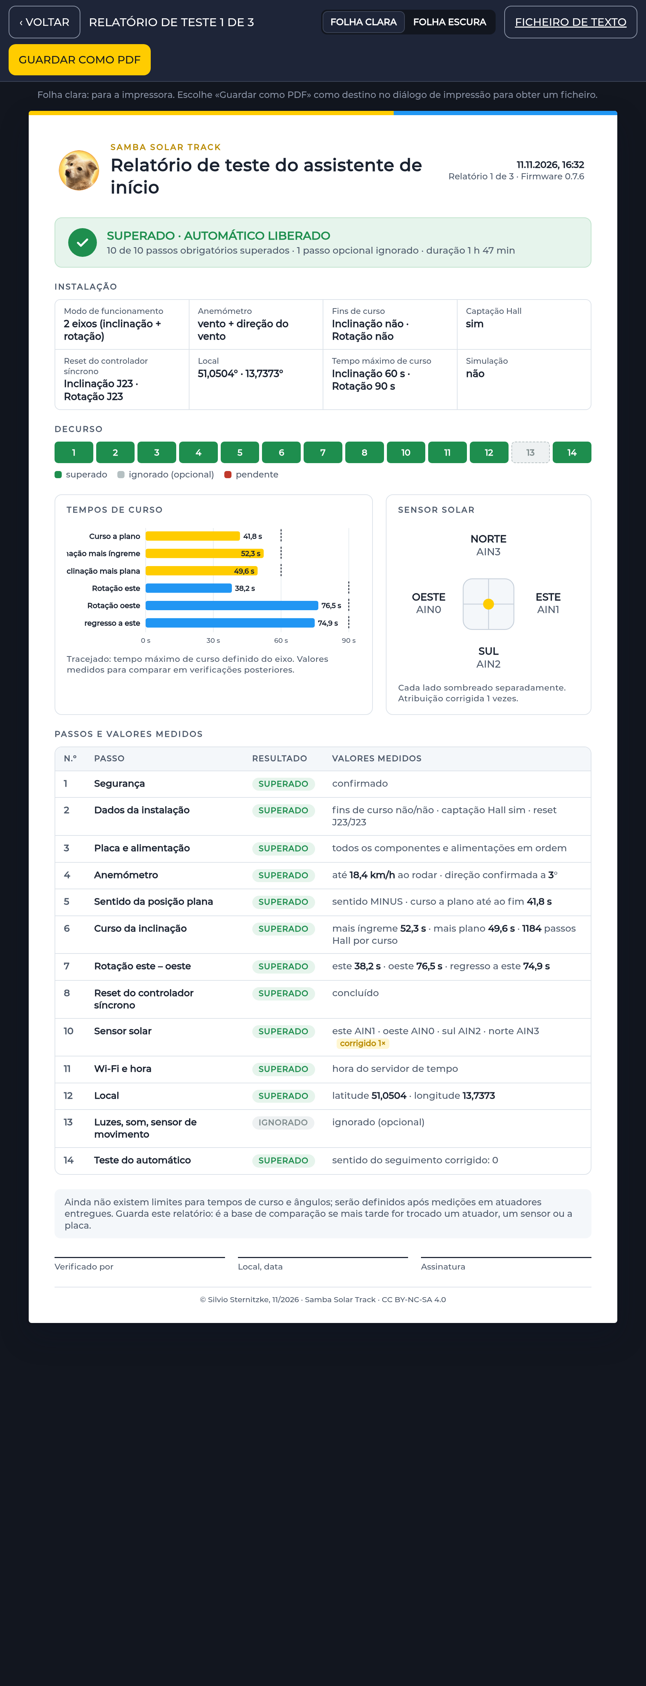
handbuch/img/web_pt/bericht_hell.png
