ssbingo/samba-solar-track/handbuch/img/web_pt/einrichtung_karte.png

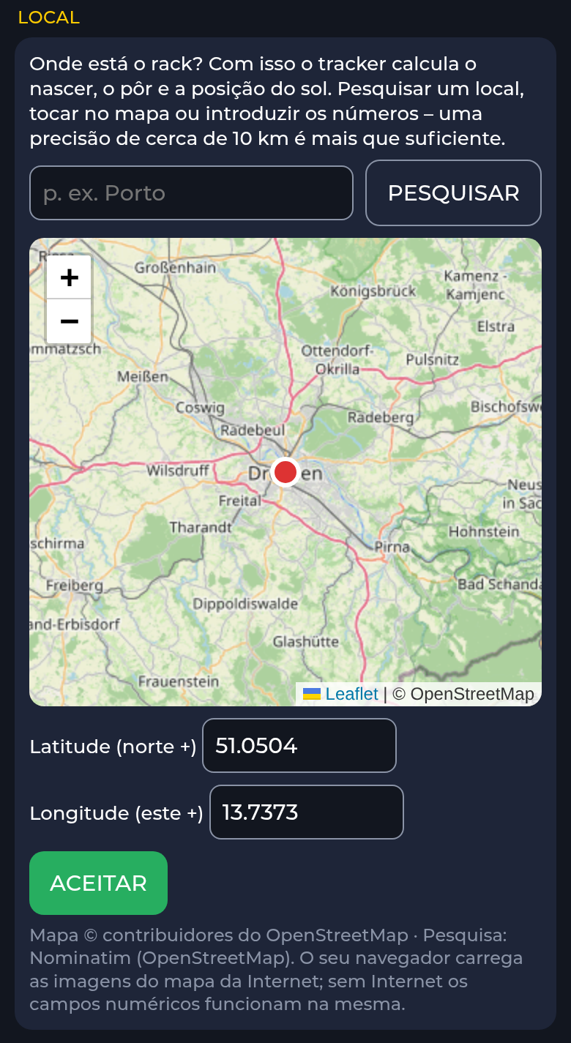
handbuch/img/web_pt/einrichtung_karte.png
