ssbingo/samba-solar-track/handbuch/img/web_pt/sonne_eine_achse.png

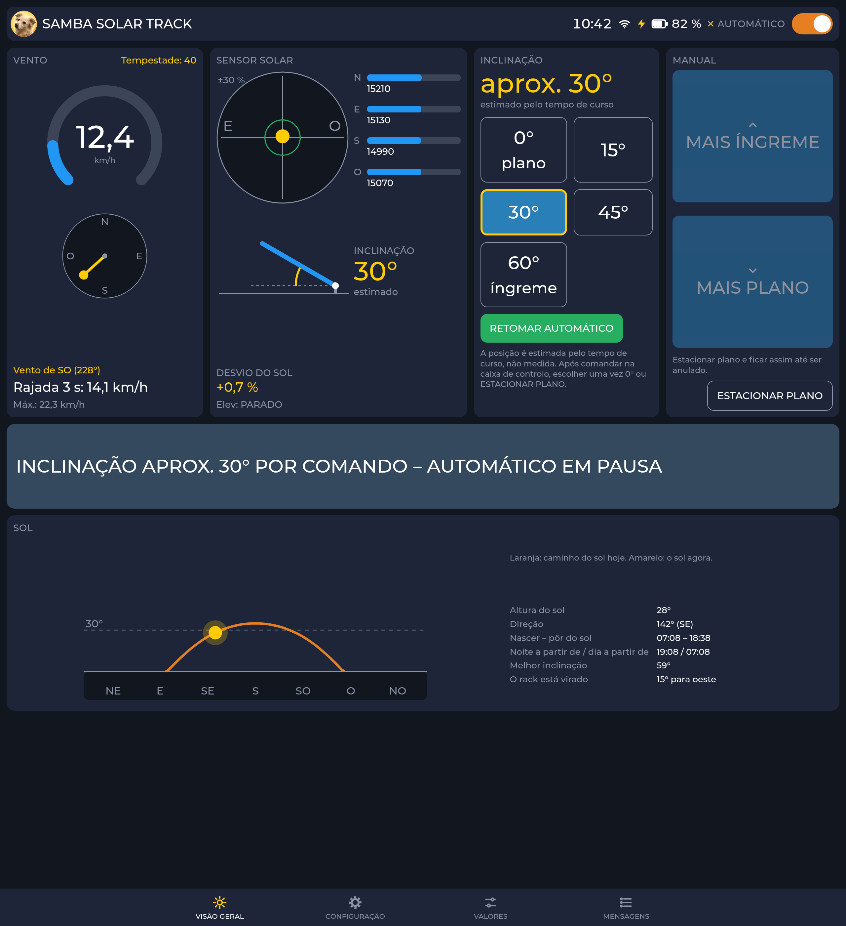
handbuch/img/web_pt/sonne_eine_achse.png
