ssbingo/samba-solar-track/handbuch/img/web_pt/zehnzoll_eine_achse.png

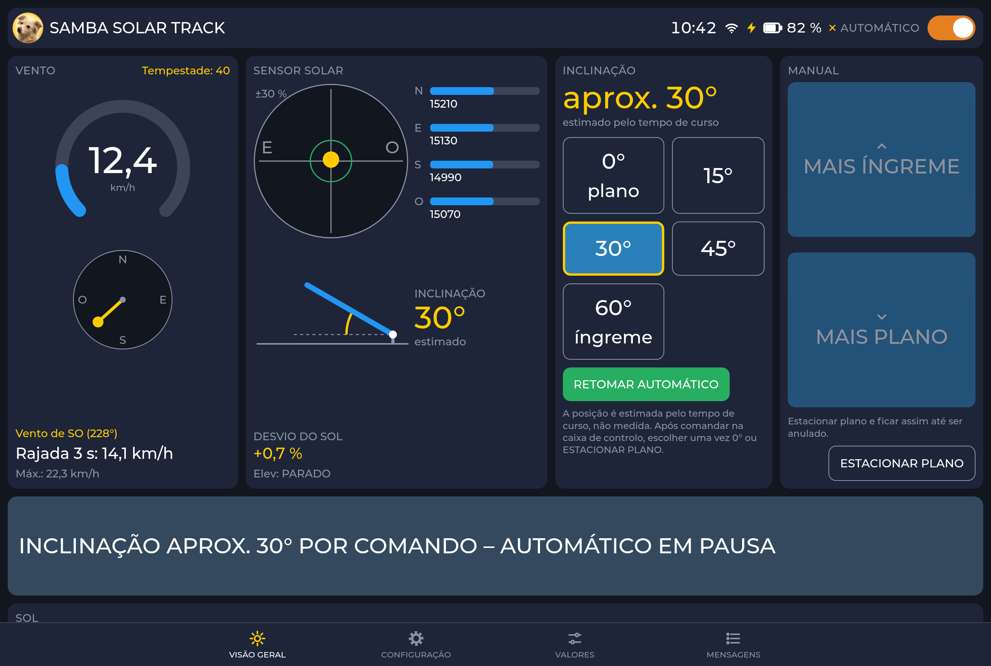
handbuch/img/web_pt/zehnzoll_eine_achse.png
