ssbingo/samba-solar-track/handbuch/img/web_pt/zehnzoll_einrichtung.png

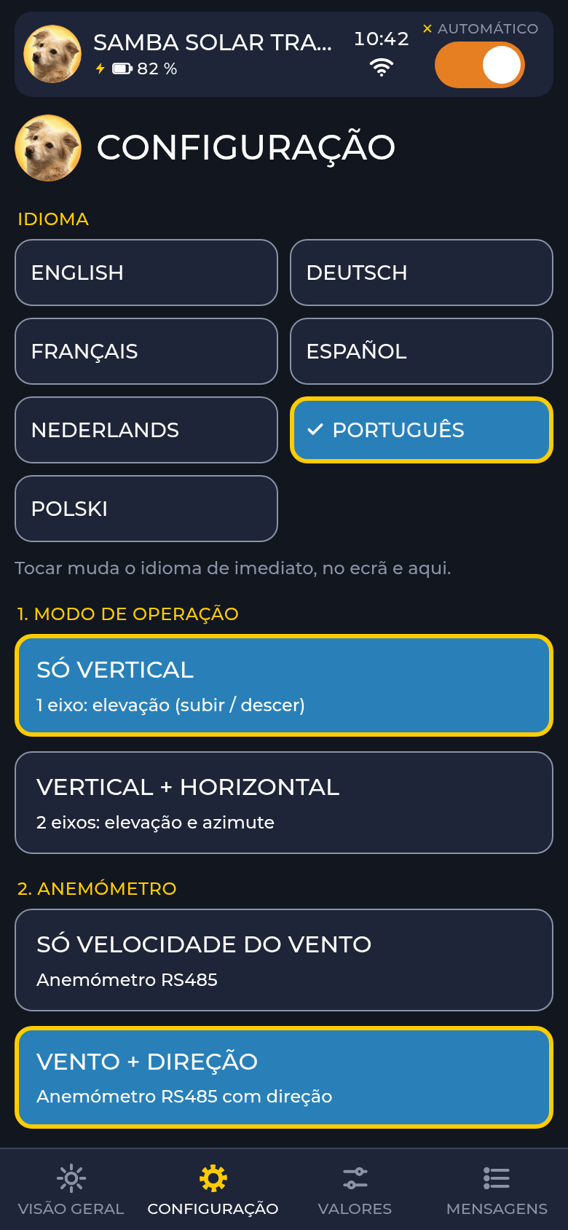
handbuch/img/web_pt/zehnzoll_einrichtung.png
