ssbingo/samba-solar-track/handbuch/img/windpendel/00_Prinzip.png

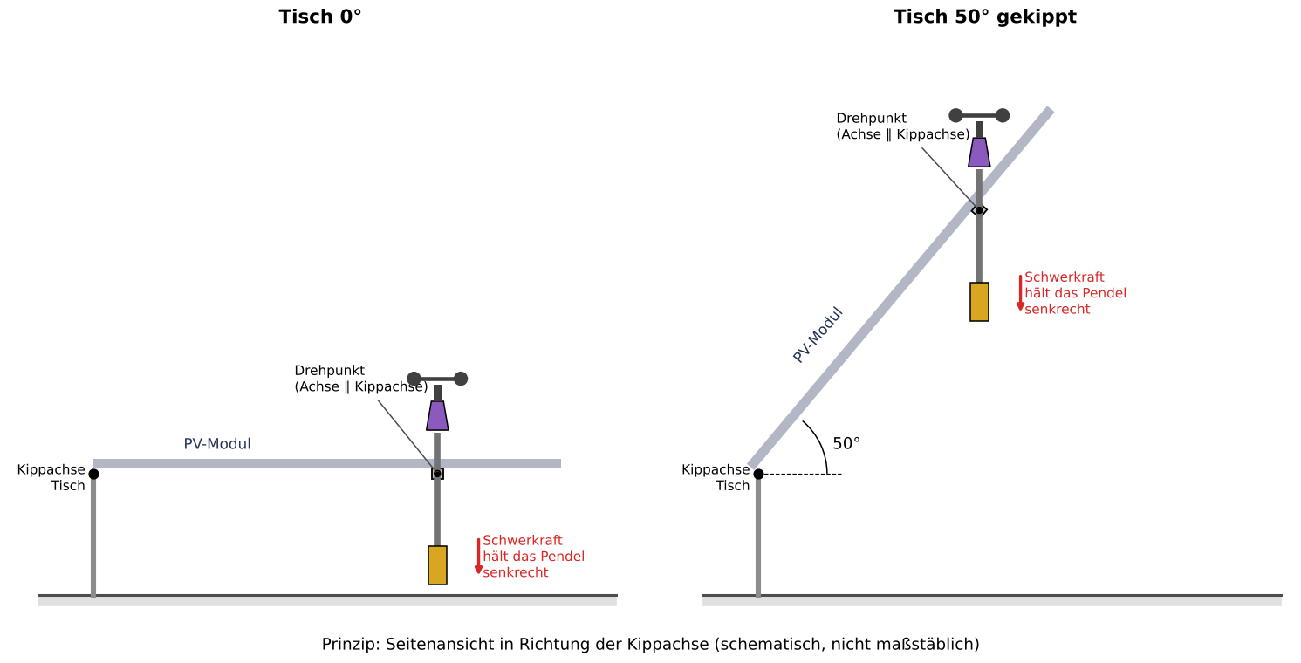
handbuch/img/windpendel/00_Prinzip.png
