ssbingo/samba-solar-track/hardware/HallTapBoard/gehaeuse/vorschau-deckel-oben.png

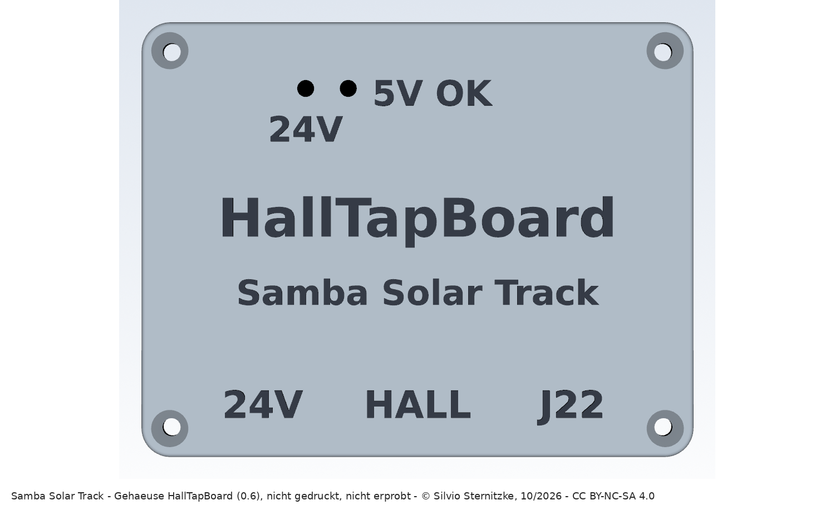
hardware/HallTapBoard/gehaeuse/vorschau-deckel-oben.png
