ssbingo/samba-solar-track/hardware/HallTapBoard/gehaeuse/vorschau-geschlossen.png

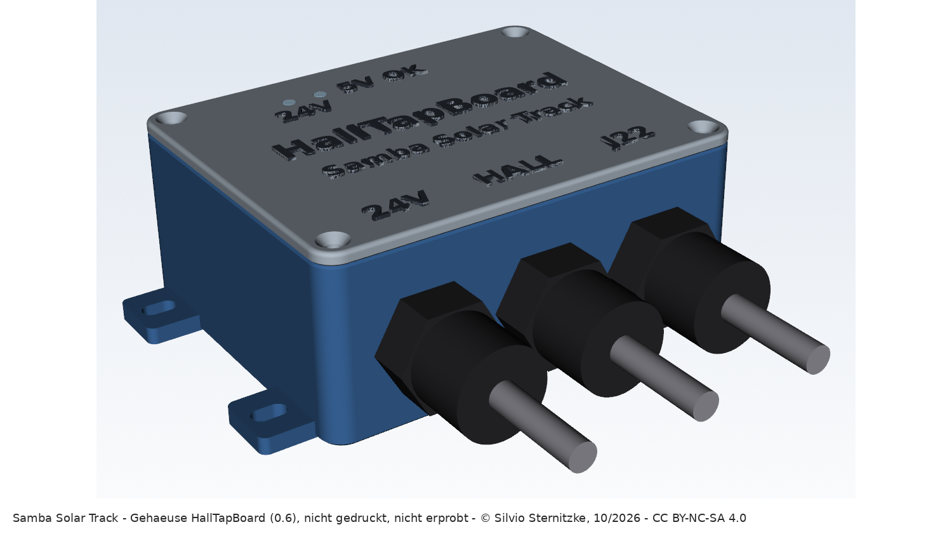
hardware/HallTapBoard/gehaeuse/vorschau-geschlossen.png
