ssbingo/samba-solar-track/hardware/HallTapBoard/gehaeuse/vorschau-offen.png

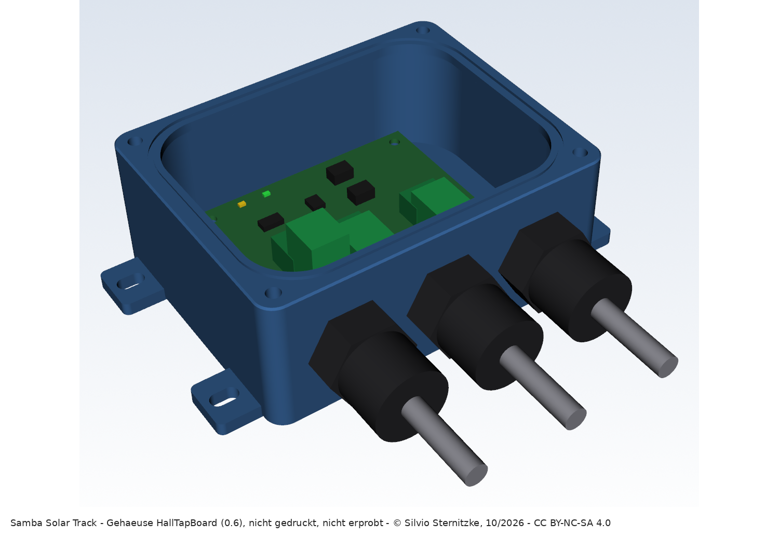
hardware/HallTapBoard/gehaeuse/vorschau-offen.png
