ssbingo/samba-solar-track/hardware/HallTapBoard/gehaeuse/vorschau-schnitt-verschraubung.png

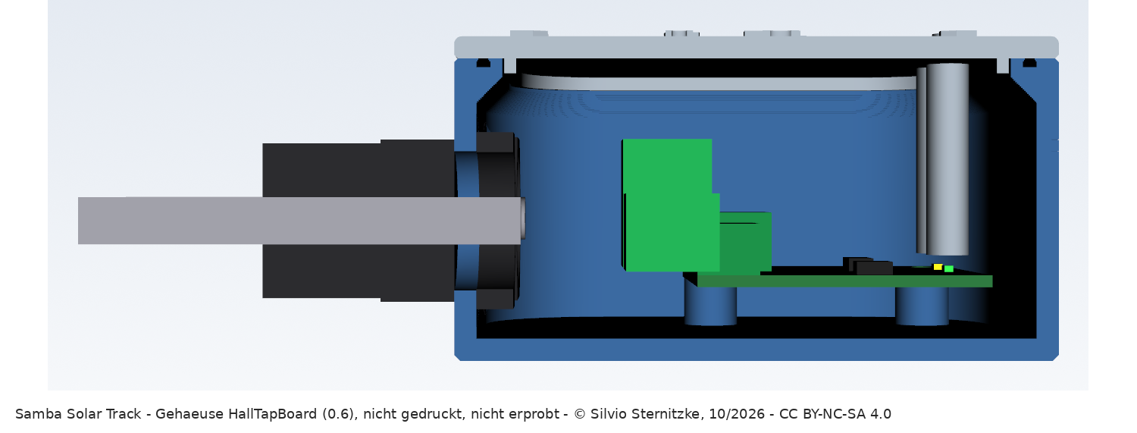
hardware/HallTapBoard/gehaeuse/vorschau-schnitt-verschraubung.png
