ssbingo/samba-solar-track/hardware/HallTapBoard/vorschau/HallTapBoard-oben.png

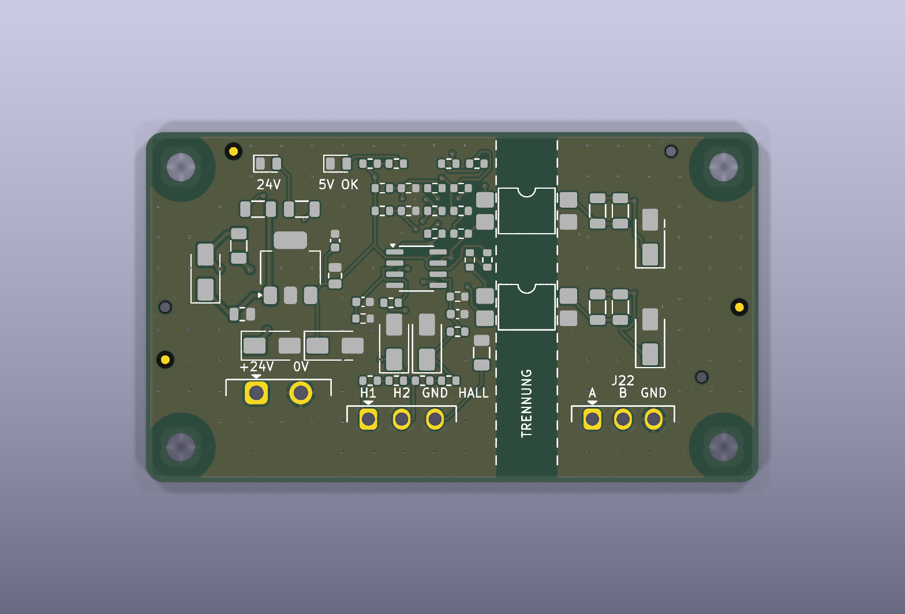
hardware/HallTapBoard/vorschau/HallTapBoard-oben.png
