ssbingo/samba-solar-track/hardware/HallTapBoard/vorschau/HallTapBoard-schaltplan.png

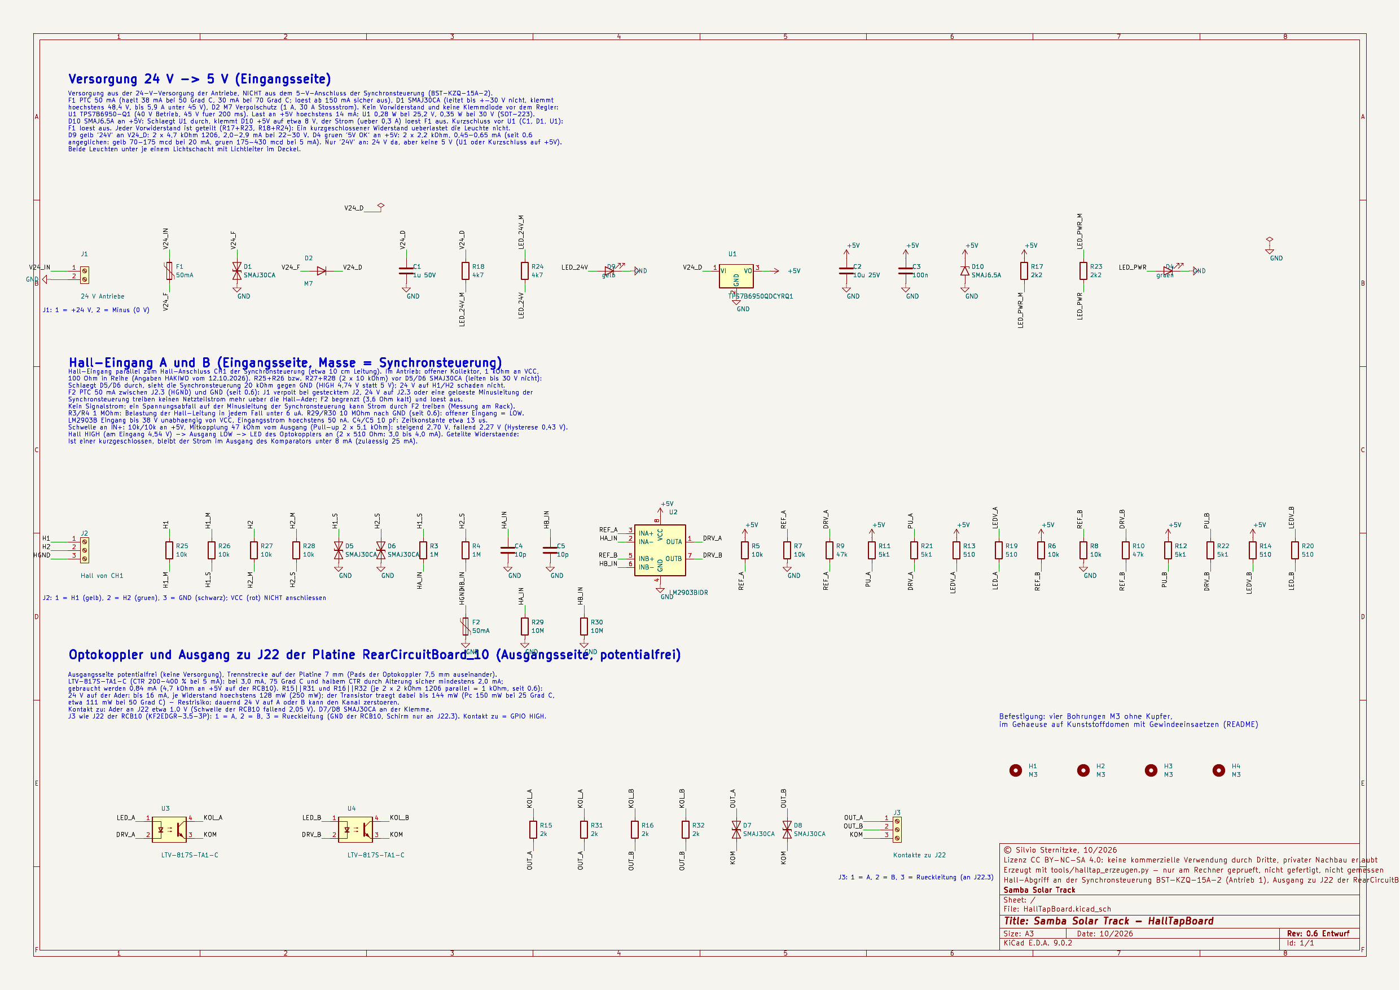
hardware/HallTapBoard/vorschau/HallTapBoard-schaltplan.png
