ssbingo/samba-solar-track/hardware/HallTapBoard/vorschau/HallTapBoard-schraeg.png

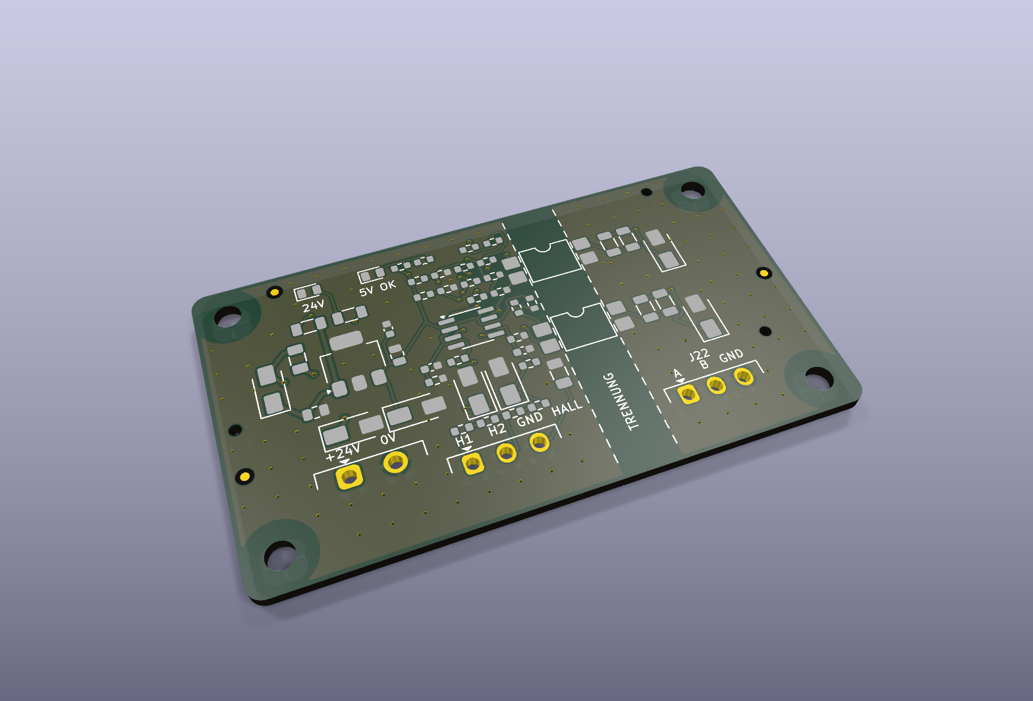
hardware/HallTapBoard/vorschau/HallTapBoard-schraeg.png
