ssbingo/samba-solar-track/hardware/HallTapBoard/vorschau/HallTapBoard-zeichnung.png

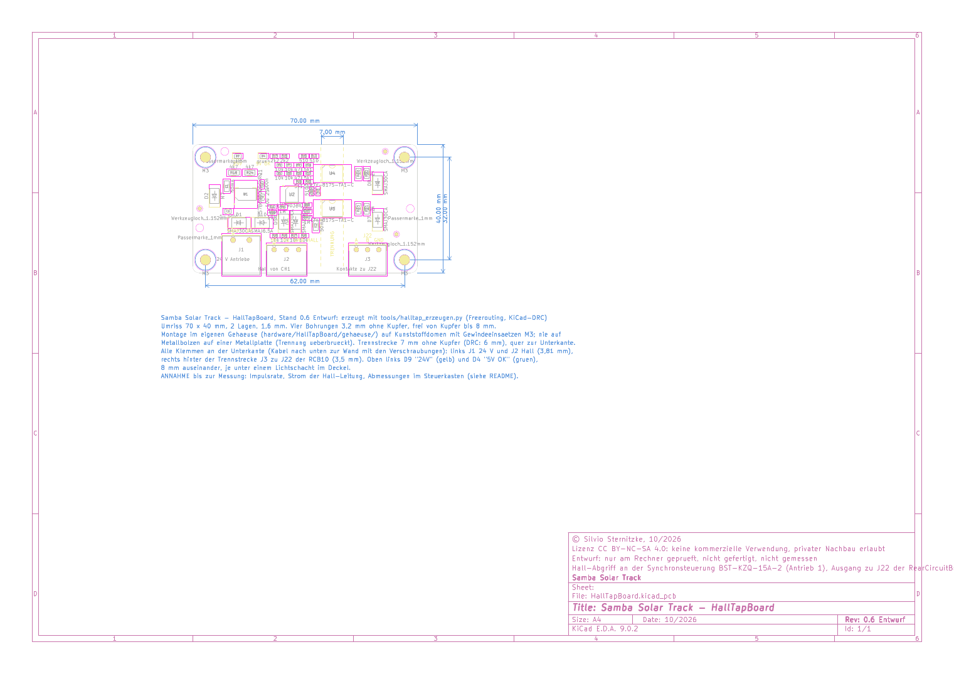
hardware/HallTapBoard/vorschau/HallTapBoard-zeichnung.png
