ssbingo/samba-solar-track/hardware/HallTapBoard/vorschau/HallTapBoard_Gehaüse_01.jpeg

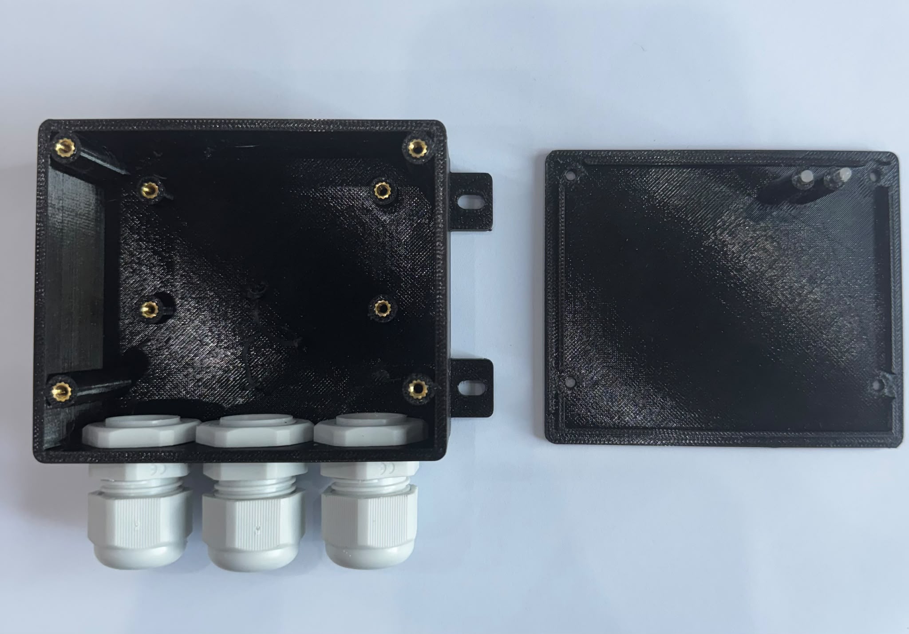
hardware/HallTapBoard/vorschau/HallTapBoard_Gehaüse_01.jpeg
