ssbingo/samba-solar-track/hardware/HallTapBoard/vorschau/HallTapBoard_Gehaüse_02.jpeg

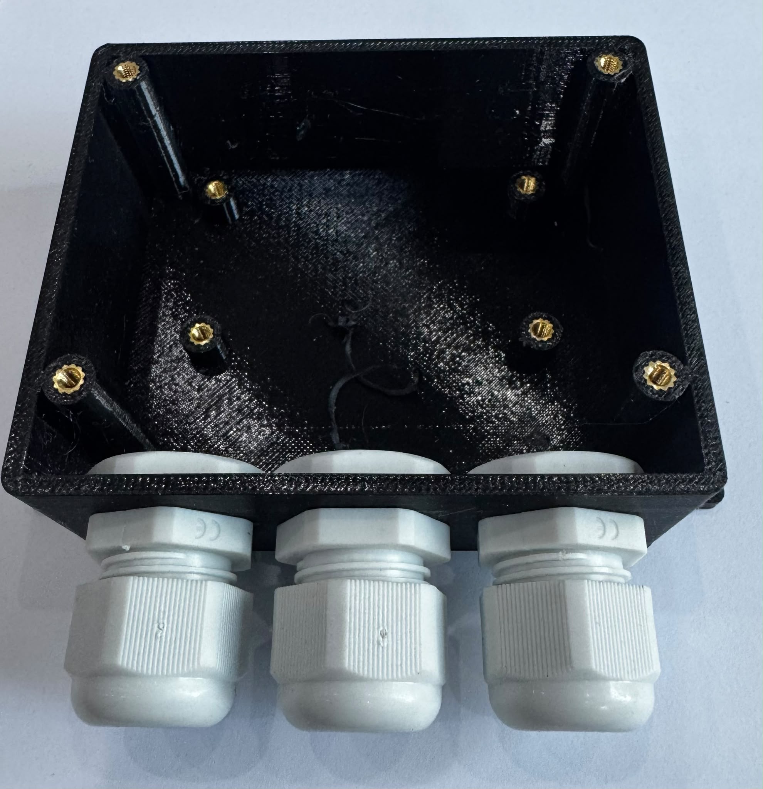
hardware/HallTapBoard/vorschau/HallTapBoard_Gehaüse_02.jpeg
