ssbingo/samba-solar-track/hardware/HallTapBoard/vorschau/HallTapBoard_Gehaüse_03.jpeg

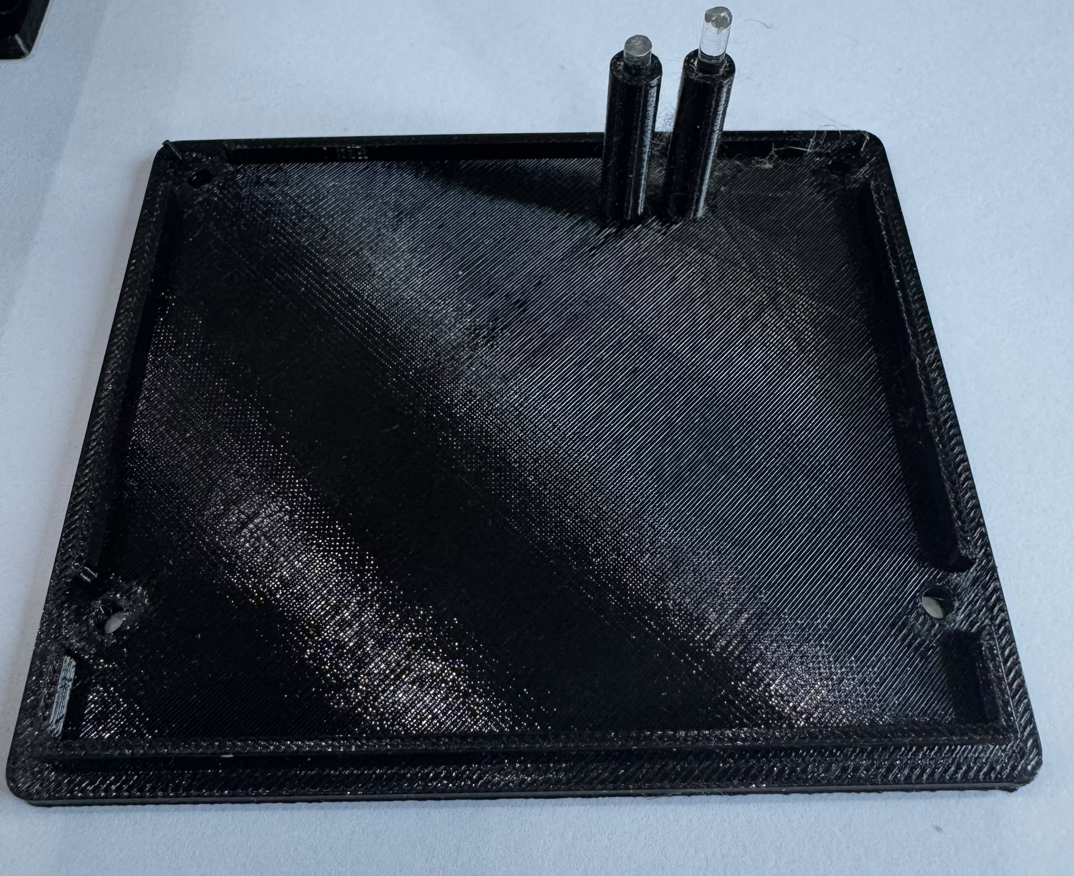
hardware/HallTapBoard/vorschau/HallTapBoard_Gehaüse_03.jpeg
