ssbingo/samba-solar-track/hardware/RearCircuitBoard_10/passprobe/passmodell.png

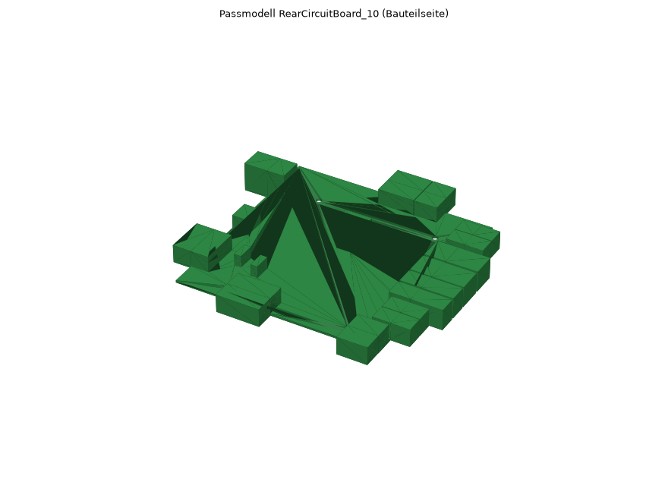
hardware/RearCircuitBoard_10/passprobe/passmodell.png
