ssbingo/samba-solar-track/hardware/RearCircuitBoard_10/passprobe/passprobe_im_gehaeuse_40mm.png

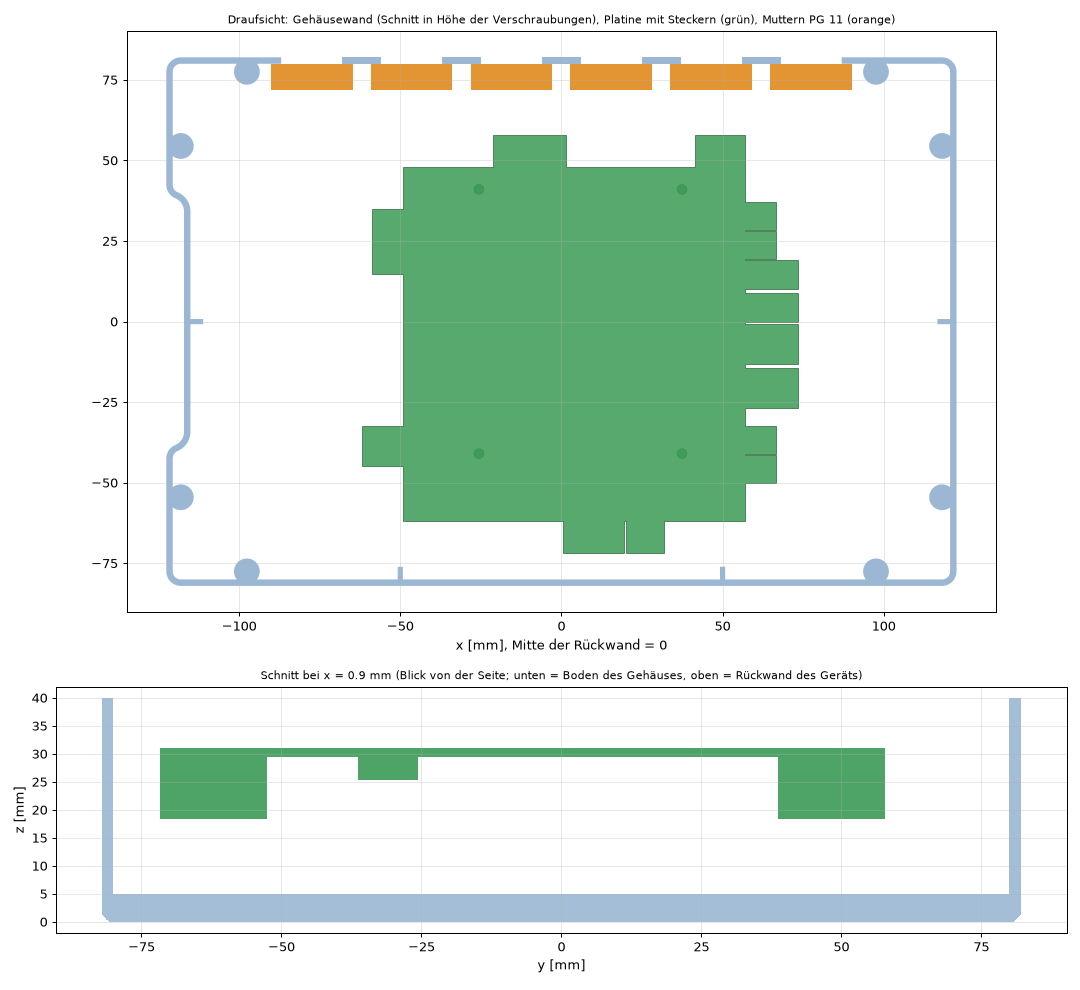
hardware/RearCircuitBoard_10/passprobe/passprobe_im_gehaeuse_40mm.png
