ssbingo/samba-solar-track/hardware/RearCircuitBoard_10/passprobe/RearCircuitBoard_10_Passprobe_J8.png

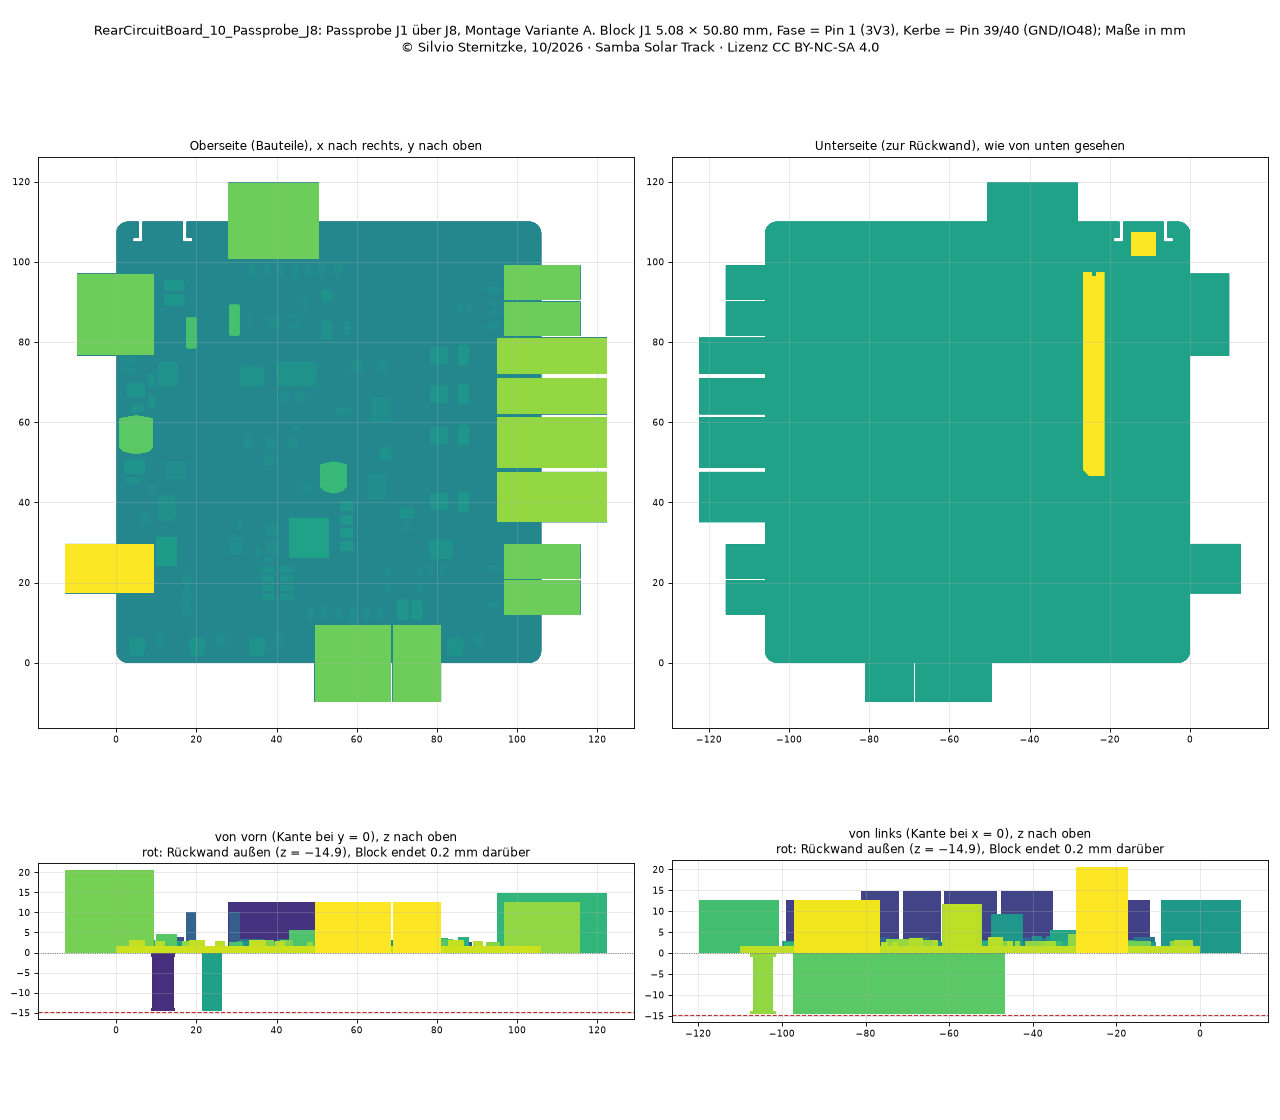
hardware/RearCircuitBoard_10/passprobe/RearCircuitBoard_10_Passprobe_J8.png
