ssbingo/samba-solar-track/hardware/RearCircuitBoard_10/vorschau/RearCircuitBoard_10-unten.png

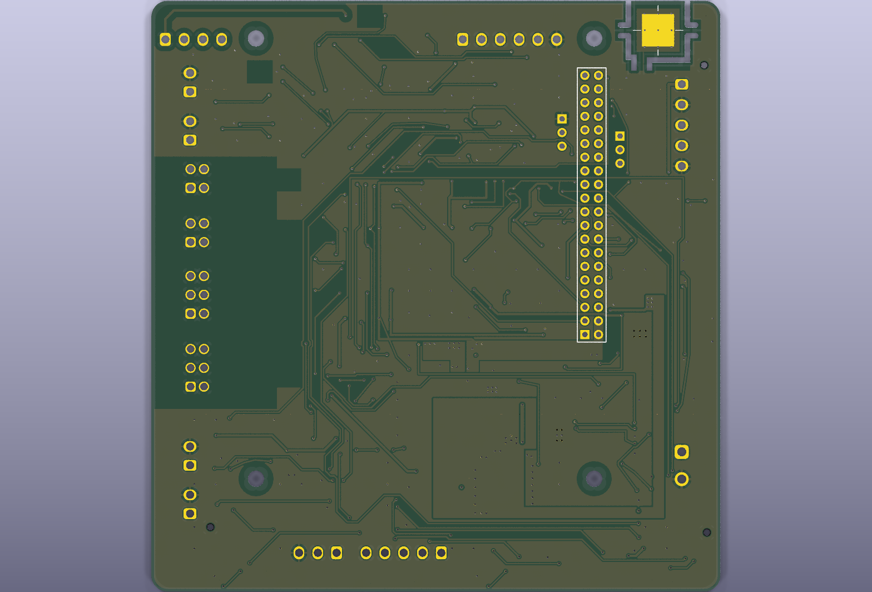
hardware/RearCircuitBoard_10/vorschau/RearCircuitBoard_10-unten.png
