ssbingo/samba-solar-track/hardware/RearCircuitBoard_10/vorschau/RearCircuitBoard_10-zeichnung.png

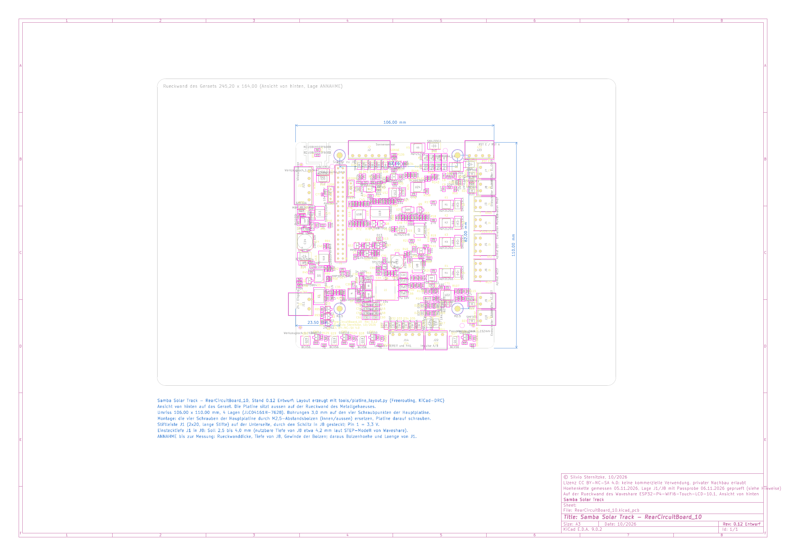
hardware/RearCircuitBoard_10/vorschau/RearCircuitBoard_10-zeichnung.png
