ssbingo/samba-solar-track/hardware/HallTapBoard/fertigung/smd/HallTapBoard-bom.csv

Comment | Designator | Footprint | JLCPCB Part #
1u 50V | C1 | C_0805_2012Metric | C28323
10u 25V | C2 | C_0805_2012Metric | C15850
100n | C3 | C_0603_1608Metric | C14663
10p | C4,C5 | C_0603_1608Metric | C1634
SMAJ30CA | D1,D5,D6,D7,D8 | D_SMA | C110043
M7 | D2 | D_SMA | C95872
gruen | D4 | LED_0805_2012Metric | C2297
gelb | D9 | LED_0805_2012Metric | C2296
SMAJ6.5A | D10 | D_SMA | C123817
50mA | F1,F2 | Fuse_1206_3216Metric | C70064
1M | R3,R4 | R_0603_1608Metric | C22935
10k | R5,R6,R7,R8,R25,R26,R27,R28 | R_0603_1608Metric | C25804
47k | R9,R10 | R_0603_1608Metric | C25819
5k1 | R11,R12,R21,R22 | R_0603_1608Metric | C23186
510 | R13,R14,R19,R20 | R_0603_1608Metric | C23193
2k | R15,R16,R31,R32 | R_1206_3216Metric | C17944
2k2 | R17,R23 | R_0603_1608Metric | C4190
4k7 | R18,R24 | R_1206_3216Metric | C17936
10M | R29,R30 | R_0603_1608Metric | C7250
TPS7B6950QDCYRQ1 | U1 | SOT-223-3_TabPin2 | C108469
LM2903BIDR | U2 | SOIC-8_3.9x4.9mm_P1.27mm | C2869804
LTV-817S-TA1-C | U3,U4 | SMDIP-4_W9.53mm | C109227
