ssbingo/samba-solar-track/hardware/RearCircuitBoard_10/fertigung/smd/RearCircuitBoard_10-bom.csv

Comment | Designator | Footprint | JLCPCB Part #
10u | C1,C13,C26,C27 | C_0603_1608Metric | C19702
100n | C2,C3,C12,C18,C24,C25,C29,C30,C32,C42,C43,C44,C45,C46,C48,C49,C50,C51,C52,C53,C71,C78 | C_0603_1608Metric | C14663
4n7 | C4,C5,C6,C7,C8,C9,C10,C11 | C_0603_1608Metric | C53987
100u 63V | C14 | CP_Elec_8x10 | C487384
2u2 100V | C15,C16,C56,C57,C58,C59,C60,C61,C72 | C_1206_3216Metric | C16195971
100n 100V | C17,C39,C41 | C_0805_2012Metric | C3011698
47u 10V | C20,C21,C65,C66 | C_1210_3225Metric | C7198516
220u 16V | C22 | CP_Elec_6.3x7.7 | C709481
22u 25V | C28,C75,C76 | C_1206_3216Metric | C12891
10u | C31 | C_0603_1608Metric | C2959727
47n | C33,C40 | C_0603_1608Metric | C1622
2u2 25V | C34 | C_0805_2012Metric | C19110
22n | C35 | C_0603_1608Metric | C21122
22p | C36 | C_0603_1608Metric | C1653
1n | C37,C63,C69,C70 | C_0603_1608Metric | C1588
220n | C47,C67 | C_0603_1608Metric | C21120
10n | C54,C62,C64 | C_0603_1608Metric | C57112
2n2 | C55 | C_0603_1608Metric | C1604
1u | C68,C74 | C_0603_1608Metric | C15849
100n 100V | C73 | C_0402_ohne_Druck | C3869216
10n 100V | C77 | C_0402_ohne_Druck | C527014
SMAJ33CA | D1,D2,D3,D4,D11,D12,D16,D17,D49,D50 | D_SMA | C115251
SS10P6 | D5 | TO-277A | C2927414
SMBJ30A | D6 | D_SMB | C113998
gruen (BEREIT) | D9 | LED_0805_2012Metric | C2297
RGB (FAIL) | D10 | LED_RGB_PLCC4_S4-3528RGBTA | C2827321
1N4148WS | D13,D24,D25,D26,D27,D28,D29,D30,D31,D43,D44,D45,D46 | D_SOD-323 | C2128
BZT52C5V1 | D14 | D_SOD-123 | C173407
BZT52C5V6 | D15 | D_SOD-123 | C19077402
MBR1H100SF | D18,D37 | D_SOD-123F | C235757
SMF30A | D19,D20,D21,D22,D23,D32,D33,D34,D35,D36,D38,D39,D40,D41,D42 | D_SOD-123F | C364281
BZT52C12S | D47,D48 | D_SOD-323 | C19077447
BSMD2920-200-60V | F1 | Fuse_2920_7451Metric | C49233174
AQY212GS | K1,K2,K3,K4,K5,K6 | SOP-4_4.4x4.3mm_P2.54mm_Panasonic | C415471
10u | L1 | L_Wuerth_WE-LHMI_1040 | C1519857
MMBT3904 | Q1,Q11,Q12 | SOT-23 | C20526
CSD18543Q3A | Q2,Q3 | TI_DNH0008A_CSD18543Q3A | C840100
2N7002 | Q4,Q5,Q6,Q7,Q8,Q9 | SOT-23 | C8545
SS8550 | Q10,Q13,Q14,Q15,Q16,Q22 | SOT-23 | C8542
BCX56 | Q17,Q18,Q19,Q20 | SOT-89-3 | C24280
SSM3J351R | Q21 | SOT-23 | C150147
100 | R1,R2,R3,R4,R130,R131,R132,R133 | R_1210_3225Metric | C620661
22k | R5,R6,R7,R8,R13,R14,R15,R16,R100,R136 | R_0603_1608Metric | C31850
2k2 | R9,R10,R11,R12,R27,R29,R137,R138,R139,R140 | R_0603_1608Metric | C4190
270 | R17,R18,R19,R20,R142,R143 | R_0603_1608Metric | C22966
10k | R21,R31,R32,R33,R34,R35,R36,R40,R42,R48,R66,R83,R99,R104,R105,R108,R109,R112,R113,R144,R145,R146,R147,R148,R149,R150 | R_0603_1608Metric | C25804
200k | R22,R26 | R_0603_1608Metric | C25811
79k6 0,1% | R24 | R_0603_1608Metric | C861560
15k 0,1% | R25 | R_0603_1608Metric | C326733
1k | R28,R30,R41,R55 | R_0603_1608Metric | C21190
120 | R39 | R_0805_2012Metric | C17437
680 | R43,R52 | R_0603_1608Metric | C23228
100k | R45,R46,R50,R76,R77,R82,R87,R88,R89,R90,R91,R116,R118,R119,R120,R121,R134 | R_0603_1608Metric | C25803
12k | R47,R106,R107 | R_0603_1608Metric | C22790
47k | R49,R73,R74,R98,R110,R111 | R_0603_1608Metric | C25819
33k | R51,R68,R86,R95 | R_0603_1608Metric | C4216
10m | R53 | R_1206_3216Metric | C2076185
9k1 | R54,R117 | R_0603_1608Metric | C23260
0 | R58 | R_0603_1608Metric | C21189
150k | R59 | R_0603_1608Metric | C22807
15k | R60,R85,R93,R94 | R_0603_1608Metric | C22809
324k 0,1% | R61 | R_0603_1608Metric | C3999394
64k9 0,1% | R62 | R_0603_1608Metric | C861510
100k 0,1% | R63 | R_0603_1608Metric | C122538
6k8 | R64,R97 | R_0603_1608Metric | C23212
300k | R65 | R_0603_1608Metric | C23024
332k | R67 | R_0603_1608Metric | C23139
56k | R69 | R_0603_1608Metric | C23206
20k | R70 | R_0603_1608Metric | C4184
13k | R71,R72 | R_0603_1608Metric | C22797
3k | R75 | R_0603_1608Metric | C4211
2M | R78,R79 | R_0603_1608Metric | C22976
470k | R80,R135 | R_0603_1608Metric | C23178
1M | R81,R84 | R_0603_1608Metric | C22935
8k2 | R96 | R_0603_1608Metric | C25981
100 | R101,R114,R115 | R_0603_1608Metric | C22775
4k7 | R102,R103 | R_1206_3216Metric | C17936
1k5 | R122,R123,R124,R125 | R_0603_1608Metric | C22843
75 | R126,R127,R128,R129 | R_0603_1608Metric | C4275
4k7 | R141 | R_0603_1608Metric | C23162
NCU18XH103F60RB | RT1,RT2 | R_0603_1608Metric | C440252
ADS1115IDGS | U1,U20 | VSSOP-10_3x3mm_P0.5mm | C37593
PCA9538PW | U2,U8,U24 | TSSOP-16_4.4x5mm_P0.65mm | C201530
TPS2553DBV | U5,U9 | SOT-23-6 | C55266
LM5146QRGYTQ1 | U7 | TI_RGY0020B_VQFN-20_Vias | C2876733
THVD2410DR | U11 | SOIC-8_3.9x4.9mm_P1.27mm | C1849398
AP7361C-33Y5-13 | U12 | SOT-89-5 | C460397
TPS259470ARPWR | U15 | TI_RPW0010A_VQFN-HR-10 | C3662799
TPS26600PWPR | U16 | TI_PWP0016A_HTSSOP-16_Vias | C544399
TMP390A2DRLR | U17 | SOT-563 | C5219772
LM2903BIDR | U18,U22 | SOIC-8_3.9x4.9mm_P1.27mm | C2869804
74HC4060D | U19 | SOIC-16_3.9x9.9mm_P1.27mm | C5649
TLV431BIDBZR | U21 | SOT-23 | C398375
TPSM365R6RDNR | U23 | TI_RDN0011A_QFN-FCMOD-11 | C20346008
