ssbingo/samba-solar-track/gehaeuse/Rueckgehaeuse_ESP32-P4_10.1_50mm.3mf

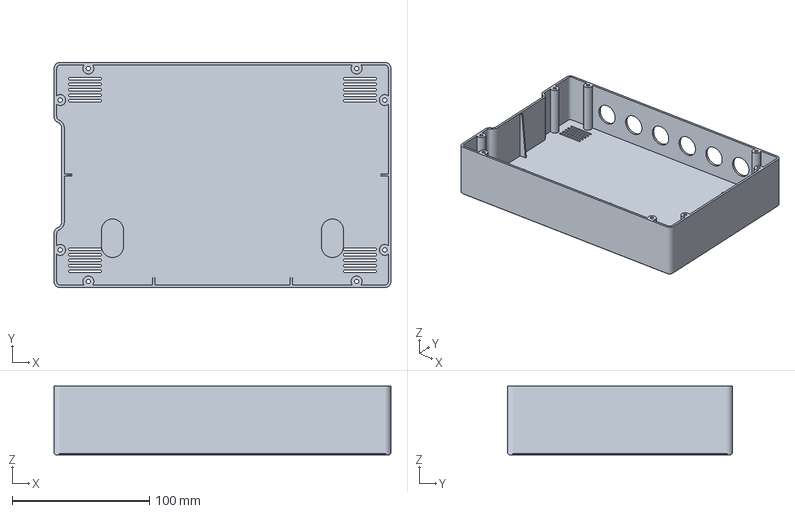
[picture p176: CAD file, 2026-10-28]
gehaeuse/Rueckgehaeuse_ESP32-P4_10.1_50mm.3mf
245.2 x 164.0 x 50.0 mm
