ssbingo/samba-solar-track/hardware/HallTapBoard/gehaeuse/HallTapBoard-gehaeuse-deckel.step

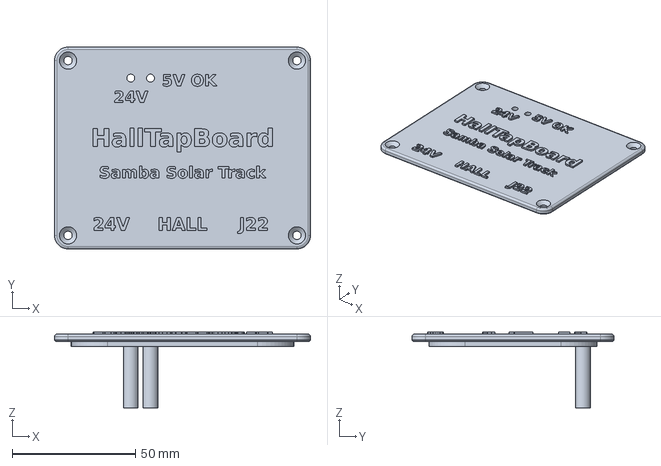
[picture p177: CAD file, 2026-11-13]
hardware/HallTapBoard/gehaeuse/HallTapBoard-gehaeuse-deckel.step
104.0 x 82.0 x 30.8 mm
