ssbingo/samba-solar-track/hardware/RearCircuitBoard_10/passprobe/RearCircuitBoard_10_Passmodell.3mf

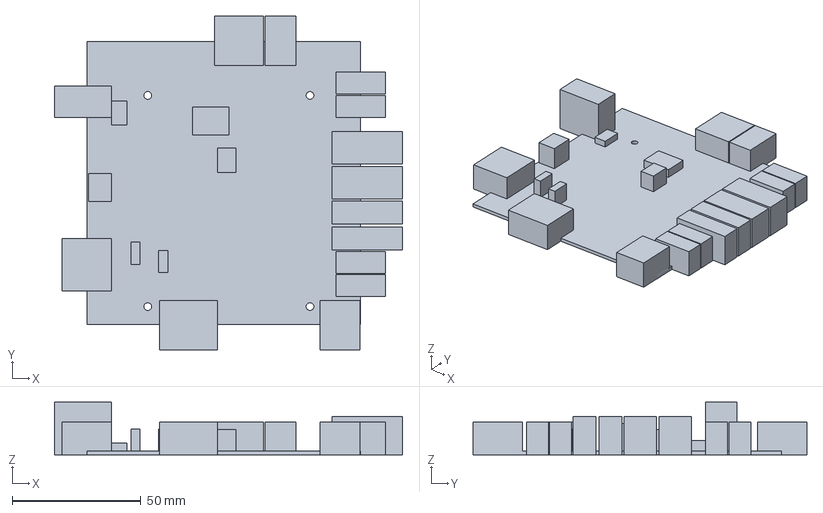
[picture p178: CAD file, 2026-11-10]
hardware/RearCircuitBoard_10/passprobe/RearCircuitBoard_10_Passmodell.3mf
135.1 x 129.6 x 20.5 mm
