ssbingo/samba-solar-track/gehaeuse/Rueckgehaeuse_ESP32-P4_10.1_40mm_K2Plus_HyperPETG-CF_0.6mm.3mf

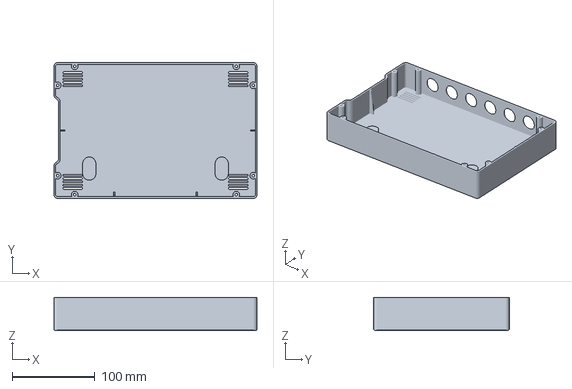
[picture p179: CAD file, 2026-10-28]
gehaeuse/Rueckgehaeuse_ESP32-P4_10.1_40mm_K2Plus_HyperPETG-CF_0.6mm.3mf
245.2 x 164.0 x 40.0 mm
