ssbingo/samba-solar-track/hardware/RearCircuitBoard_10/passprobe/RearCircuitBoard_10_Passprobe_J8.3mf

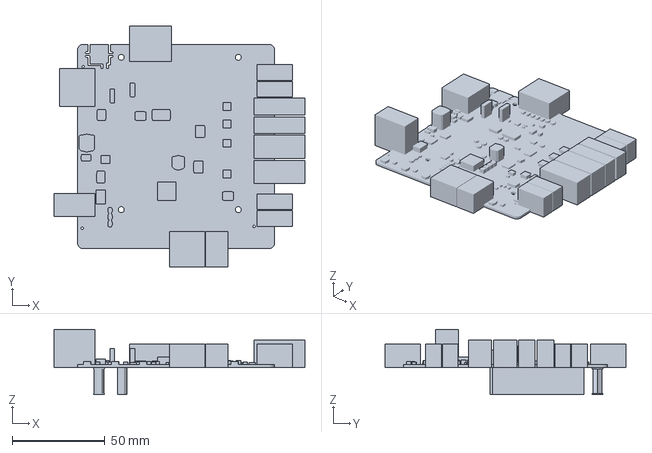
[picture p180: CAD file, 2026-11-07]
hardware/RearCircuitBoard_10/passprobe/RearCircuitBoard_10_Passprobe_J8.3mf
135.1 x 129.5 x 35.2 mm
