ssbingo/samba-solar-track/hardware/HallTapBoard/gehaeuse/HallTapBoard-gehaeuse-unterteil.step

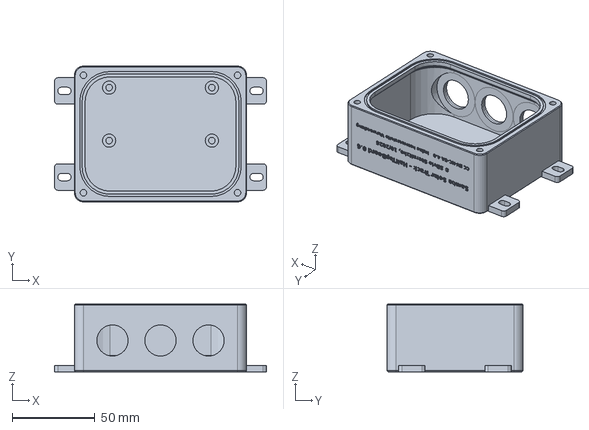
[picture p181: CAD file, 2026-11-13]
hardware/HallTapBoard/gehaeuse/HallTapBoard-gehaeuse-unterteil.step
128.0 x 82.0 x 41.0 mm
