ssbingo/samba-solar-track/hardware/HallTapBoard/gehaeuse/HallTapBoard-gehaeuse_K2Plus_HyperPETG-CF_0.4mm_Schrift-zweifarbig.3mf

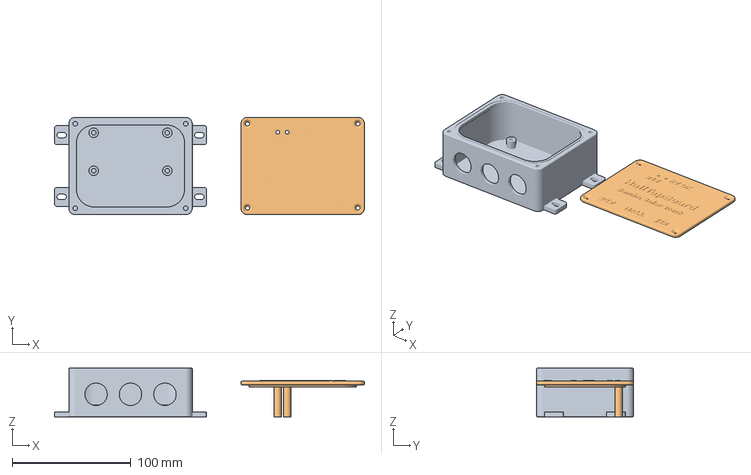
[picture p183: CAD file, 2026-11-13]
hardware/HallTapBoard/gehaeuse/HallTapBoard-gehaeuse_K2Plus_HyperPETG-CF_0.4mm_Schrift-zweifarbig.3mf
261.0 x 82.0 x 41.0 mm
HallTapBoard Unterteil
HallTapBoard Deckel (Aussenseite oben)
