ssbingo/samba-solar-track/gehaeuse/Passprobe_Kontur_ESP32-P4_10.1.3mf

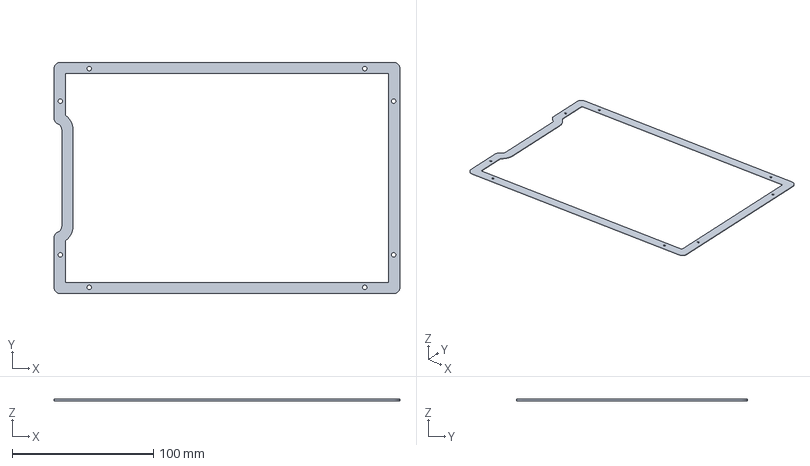
[picture p184: CAD file, 2026-10-25]
gehaeuse/Passprobe_Kontur_ESP32-P4_10.1.3mf
245.2 x 164.0 x 1.20 mm
