ssbingo/samba-solar-track/hardware/HallTapBoard/gehaeuse/HallTapBoard-gehaeuse_K2Plus_HyperPETG-CF_0.4mm.3mf

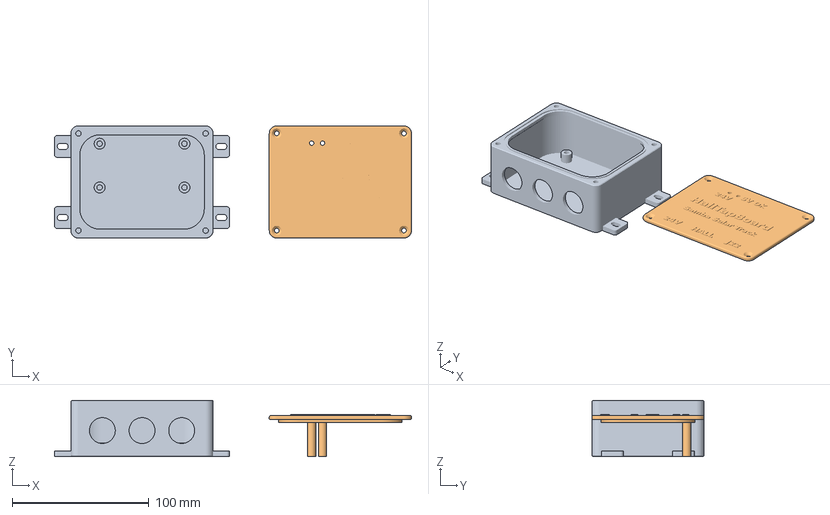
[picture p185: CAD file, 2026-11-13]
hardware/HallTapBoard/gehaeuse/HallTapBoard-gehaeuse_K2Plus_HyperPETG-CF_0.4mm.3mf
261.0 x 82.0 x 41.0 mm
HallTapBoard Unterteil
HallTapBoard Deckel (Aussenseite oben)
