ssbingo/samba-solar-track/hardware/HallTapBoard/gehaeuse/HallTapBoard-gehaeuse-deckel_K2Plus_HyperPETG-CF_0.4mm_Schrift-zweifarbig.3mf

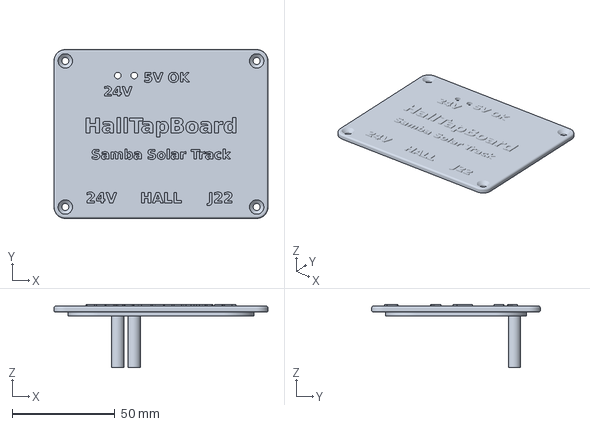
[picture p186: CAD file, 2026-11-13]
hardware/HallTapBoard/gehaeuse/HallTapBoard-gehaeuse-deckel_K2Plus_HyperPETG-CF_0.4mm_Schrift-zweifarbig.3mf
104.0 x 82.0 x 30.8 mm
