ssbingo/samba-solar-track/(list of files, cad)

Other CAD files:
hardware/HallTapBoard/gehaeuse/HallTapBoard-gehaeuse-deckel_K2Plus_HyperPETG-CF_0.4mm.3mf
gehaeuse/Rueckgehaeuse_ESP32-P4_10.1_50mm_K2Plus_HyperPETG-CF_0.6mm.3mf
gehaeuse/Rueckgehaeuse_ESP32-P4_10.1_40mm_K2Plus_HyperPETG-CF_0.4mm.3mf
hardware/HallTapBoard/gehaeuse/HallTapBoard-gehaeuse-unterteil_K2Plus_HyperPETG-CF_0.4mm.3mf
gehaeuse/Rueckgehaeuse_ESP32-P4_10.1_50mm_K2Plus_HyperPETG-CF_0.4mm.3mf
gehaeuse/Rueckgehaeuse_ESP32-P4_10.1_40mm.3mf
gehaeuse/Passprobe_Kontur_ESP32-P4_10.1.stl
gehaeuse/Rueckgehaeuse_ESP32-P4_10.1_40mm.stl
gehaeuse/Rueckgehaeuse_ESP32-P4_10.1_50mm.stl
hardware/HallTapBoard/gehaeuse/HallTapBoard-gehaeuse-deckel.stl
hardware/HallTapBoard/gehaeuse/HallTapBoard-gehaeuse-unterteil.stl
hardware/RearCircuitBoard_10/passprobe/RearCircuitBoard_10_Passmodell.stl
hardware/RearCircuitBoard_10/passprobe/RearCircuitBoard_10_Passprobe_J8.stl
