ssbingo/samba-solar-track/handbuch/img/screens10/p13_installieren.png

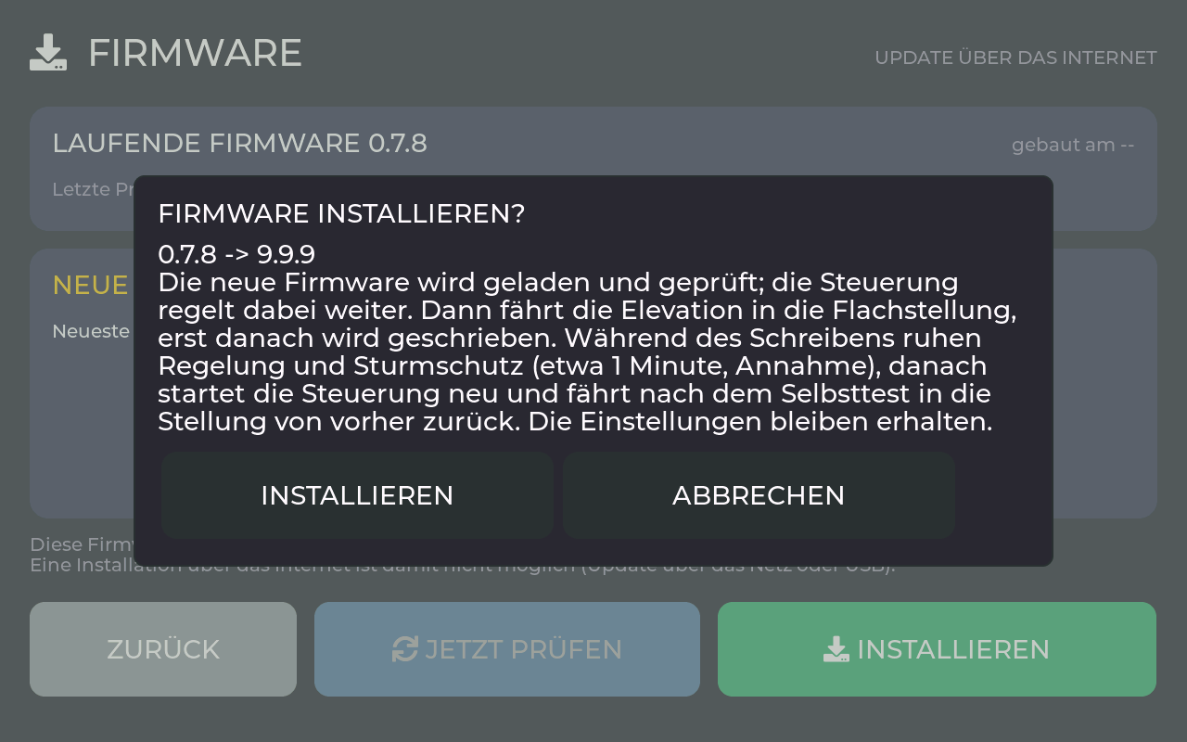
handbuch/img/screens10/p13_installieren.png
