ssbingo/samba-solar-track/handbuch/img/screens10_en/p13_installieren.png

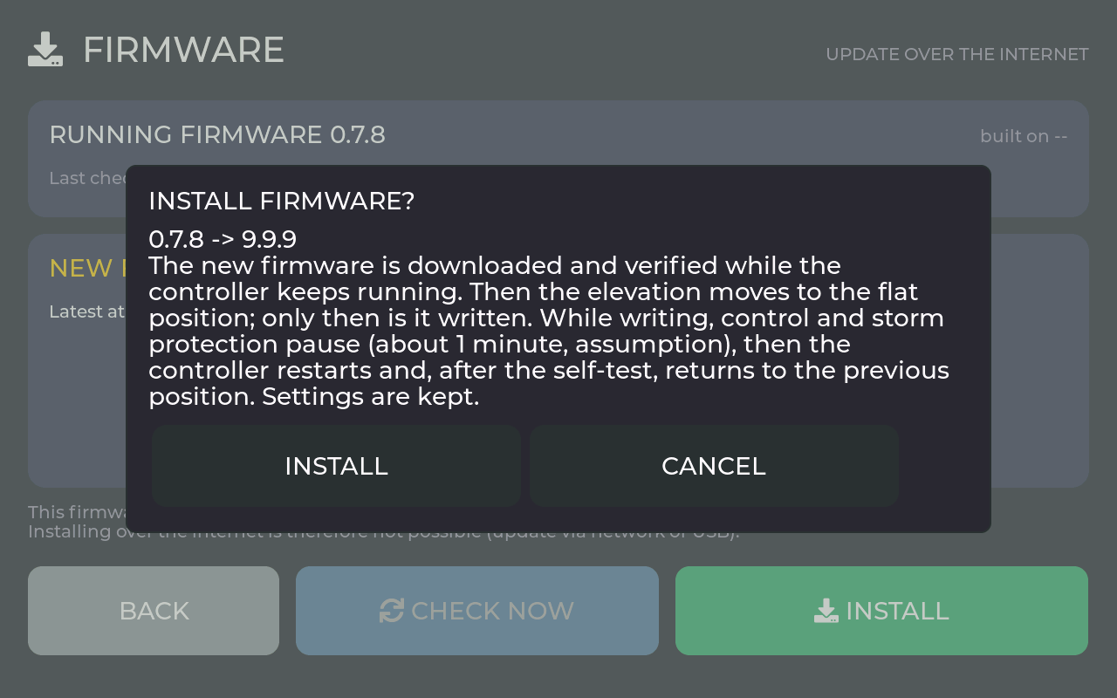
handbuch/img/screens10_en/p13_installieren.png
