ssbingo/samba-solar-track/handbuch/img/screens10_es/p13_installieren.png

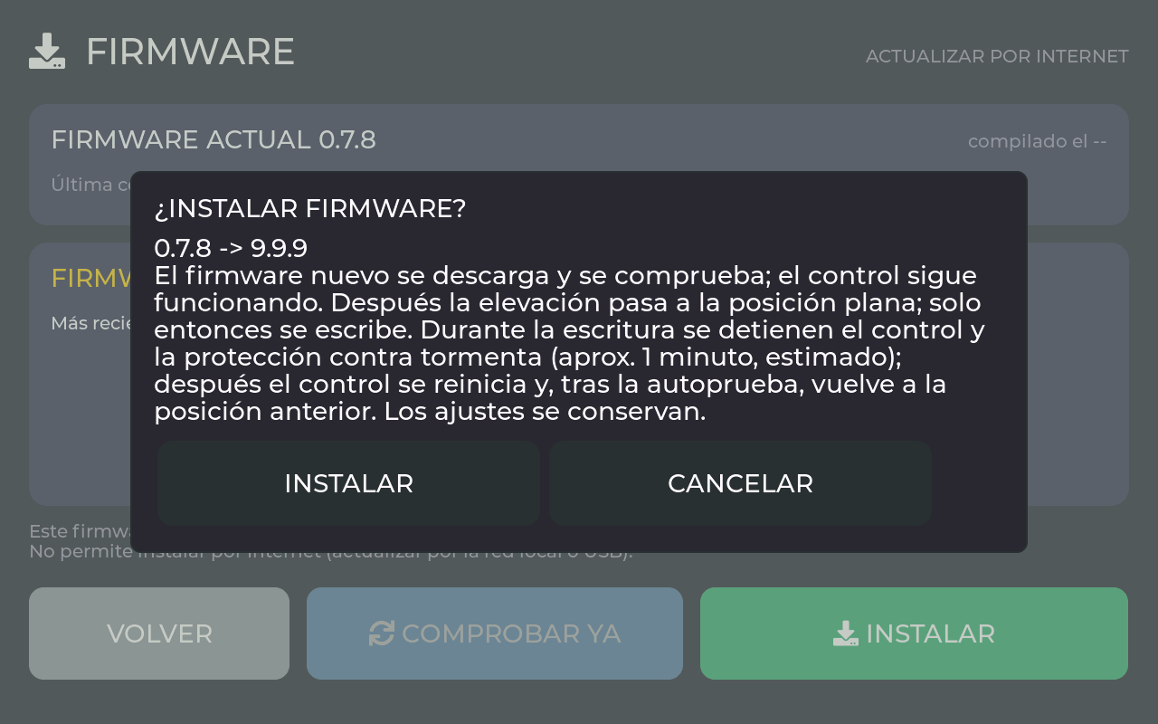
handbuch/img/screens10_es/p13_installieren.png
