ssbingo/samba-solar-track/handbuch/img/screens10_fr/p13_installieren.png

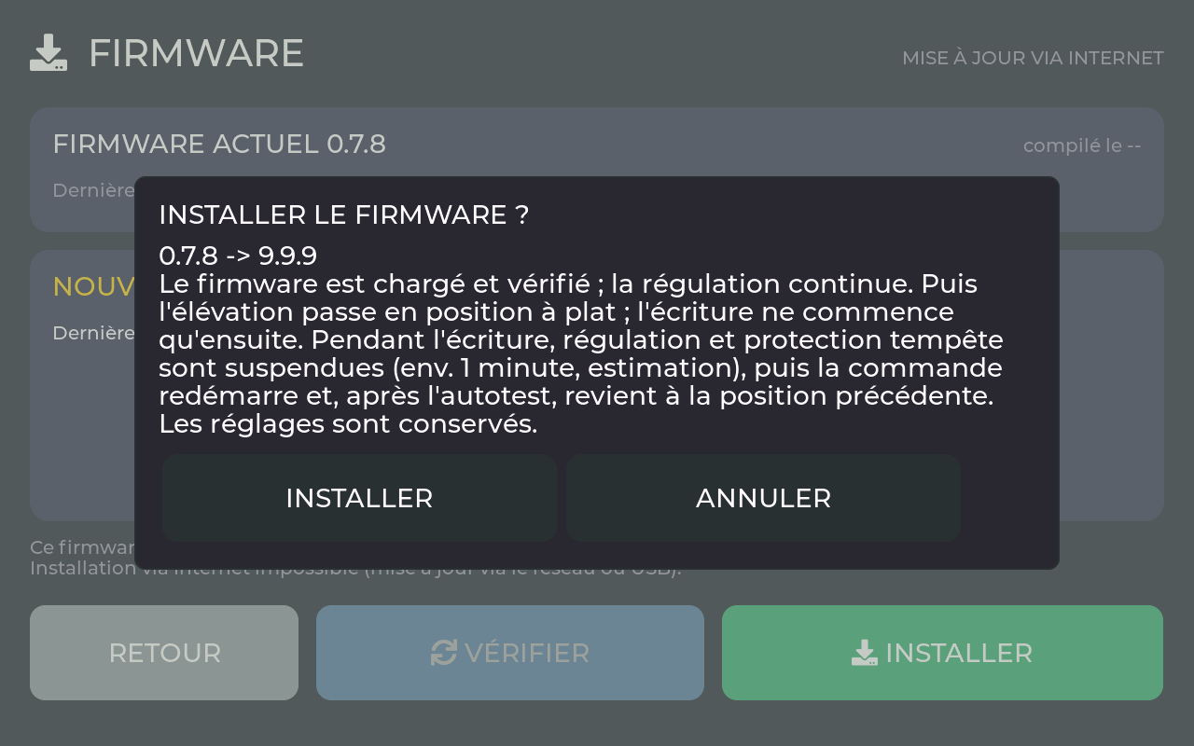
handbuch/img/screens10_fr/p13_installieren.png
