ssbingo/samba-solar-track/handbuch/img/screens10_fr/y1_27_dashboard_setup_fehlt.png

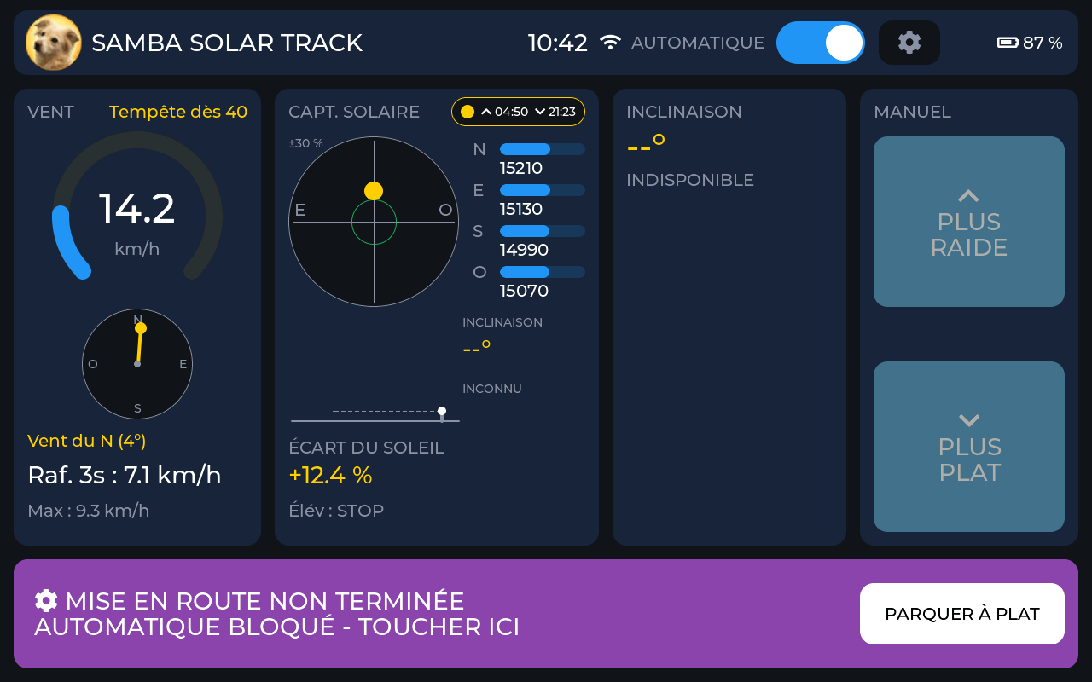
handbuch/img/screens10_fr/y1_27_dashboard_setup_fehlt.png
