ssbingo/samba-solar-track/handbuch/img/screens10_nl/p13_installieren.png

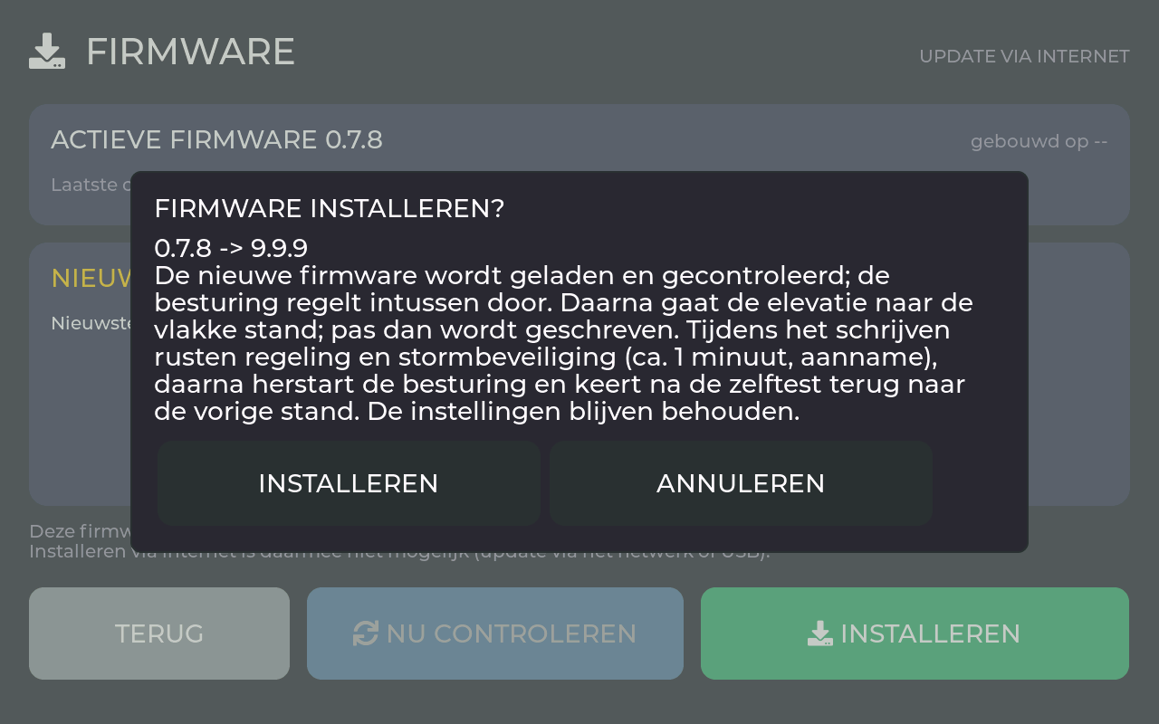
handbuch/img/screens10_nl/p13_installieren.png
