ssbingo/samba-solar-track/handbuch/img/screens10_pt/p13_installieren.png

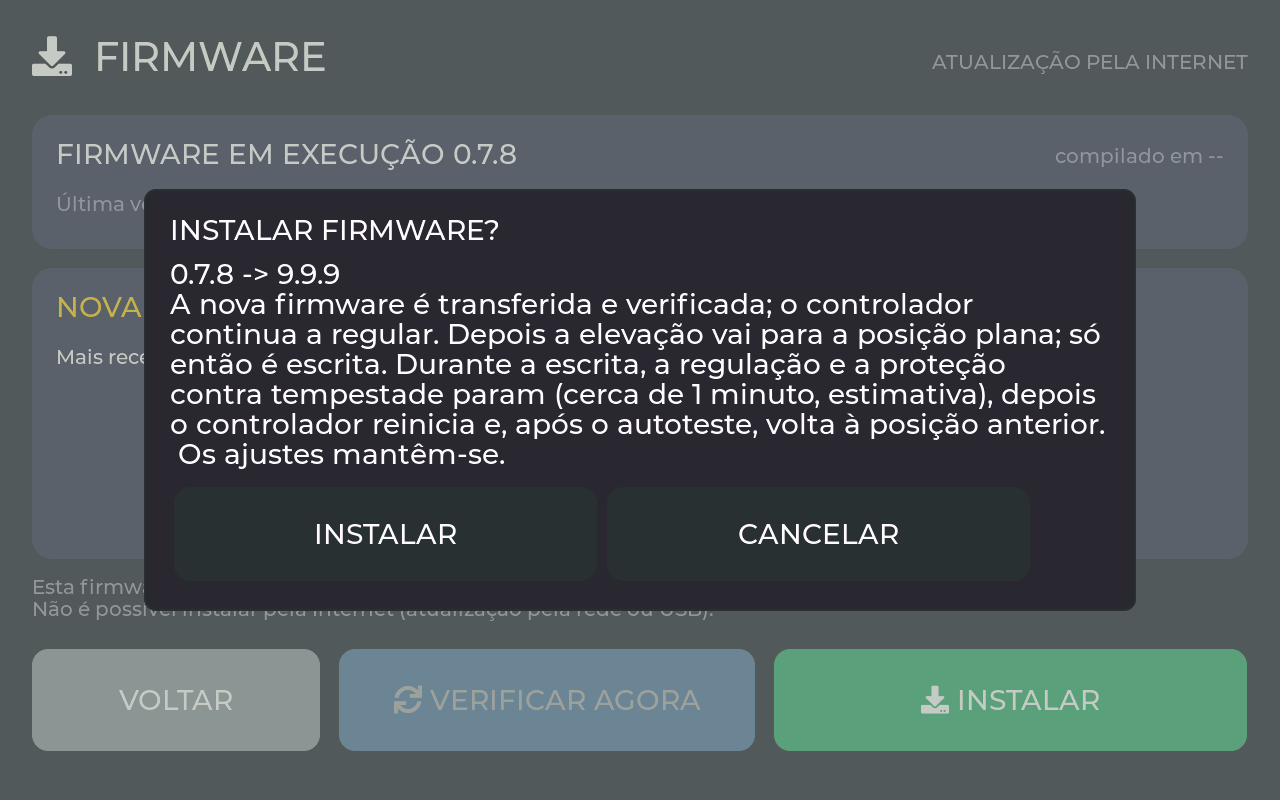
handbuch/img/screens10_pt/p13_installieren.png
