ssbingo/samba-solar-track/handbuch/img/web/einrichtung_setup.png

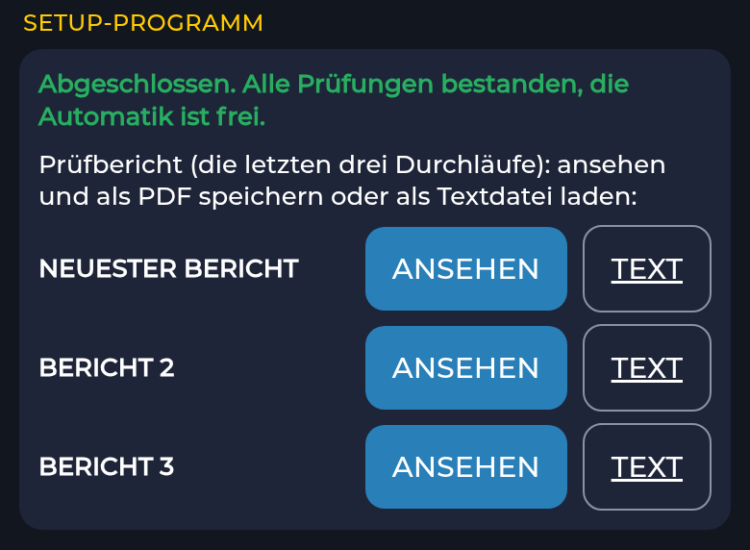
handbuch/img/web/einrichtung_setup.png
