ssbingo/samba-solar-track/handbuch/img/web/setup_offen.png

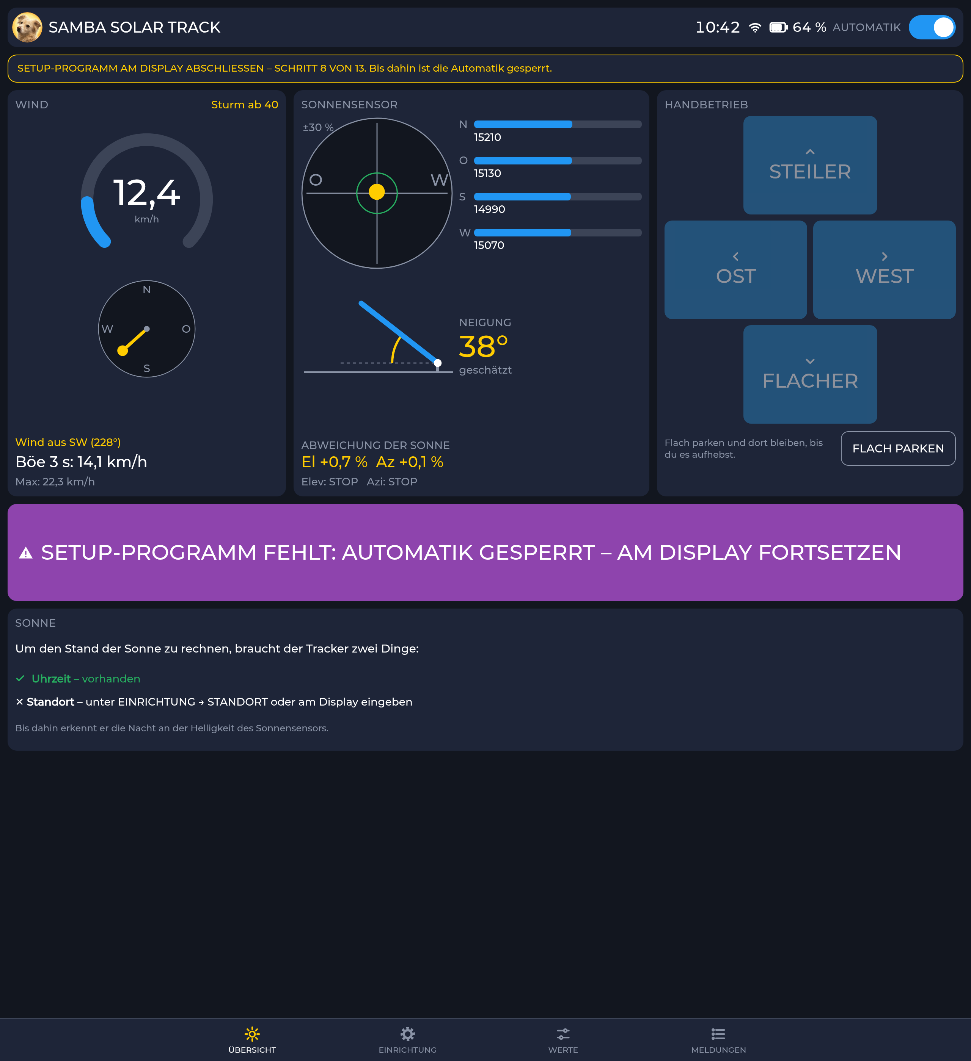
handbuch/img/web/setup_offen.png
