ssbingo/samba-solar-track/handbuch/img/web_en/einrichtung_setup.png

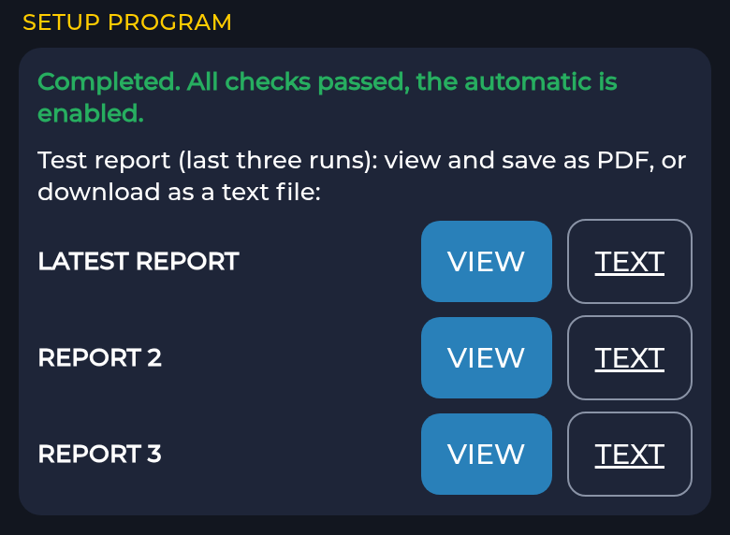
handbuch/img/web_en/einrichtung_setup.png
