ssbingo/samba-solar-track/handbuch/img/web_es/einrichtung_setup.png

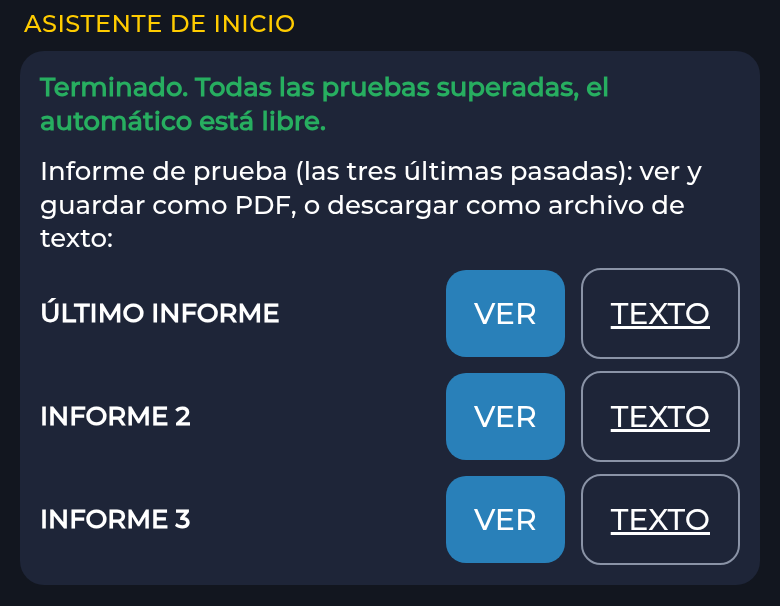
handbuch/img/web_es/einrichtung_setup.png
