ssbingo/samba-solar-track/handbuch/img/web_fr/einrichtung_setup.png

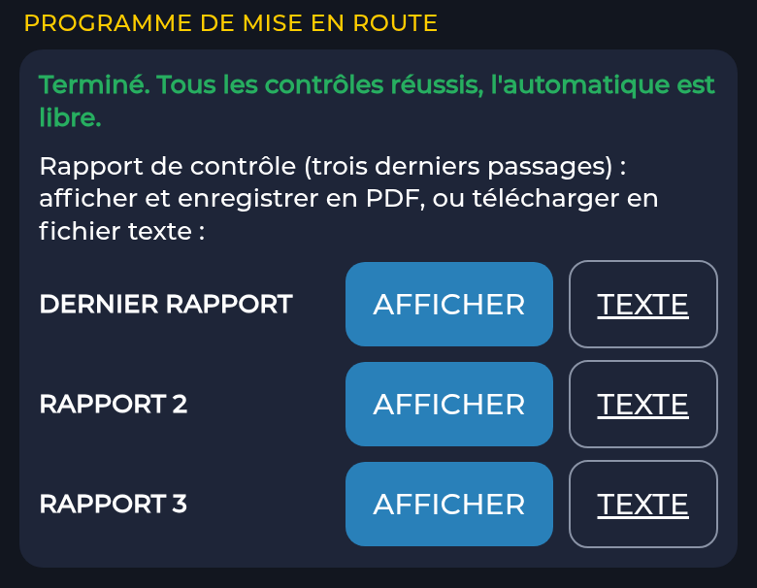
handbuch/img/web_fr/einrichtung_setup.png
