ssbingo/samba-solar-track/handbuch/img/web_nl/einrichtung_setup.png

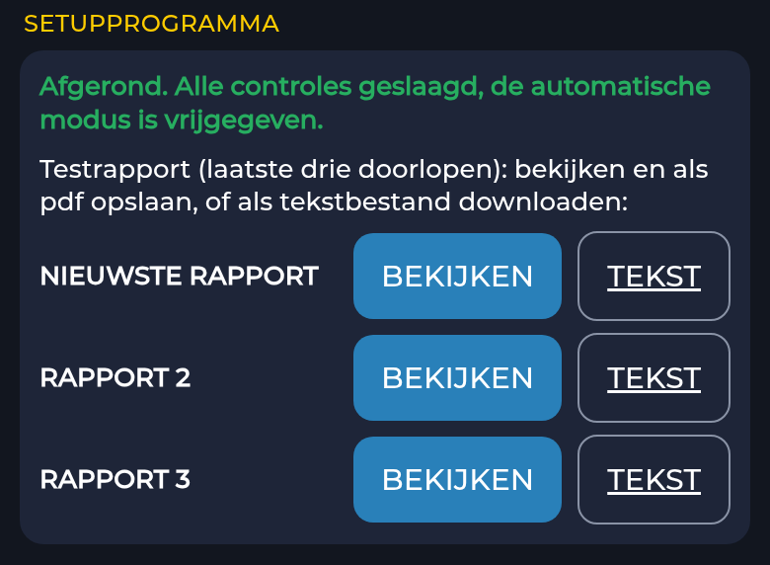
handbuch/img/web_nl/einrichtung_setup.png
