ssbingo/samba-solar-track/handbuch/img/web_pl/einrichtung_setup.png

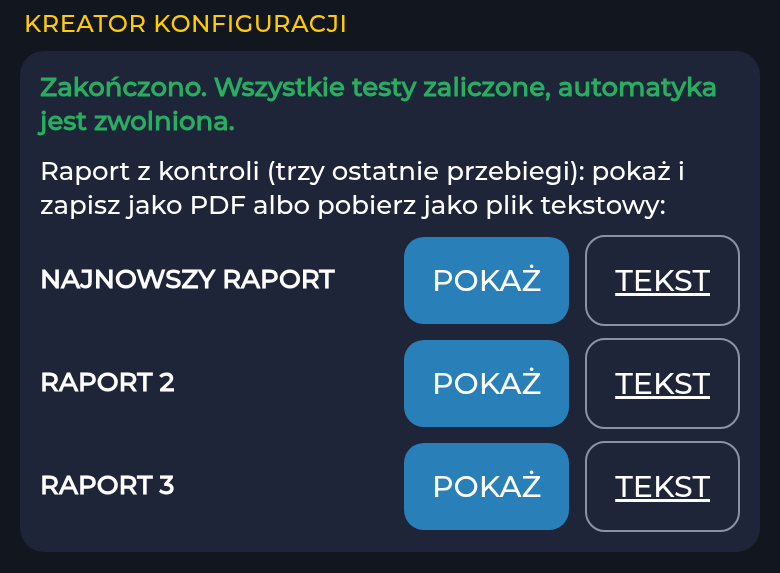
handbuch/img/web_pl/einrichtung_setup.png
