ssbingo/samba-solar-track/handbuch/img/web_pt/einrichtung_setup.png

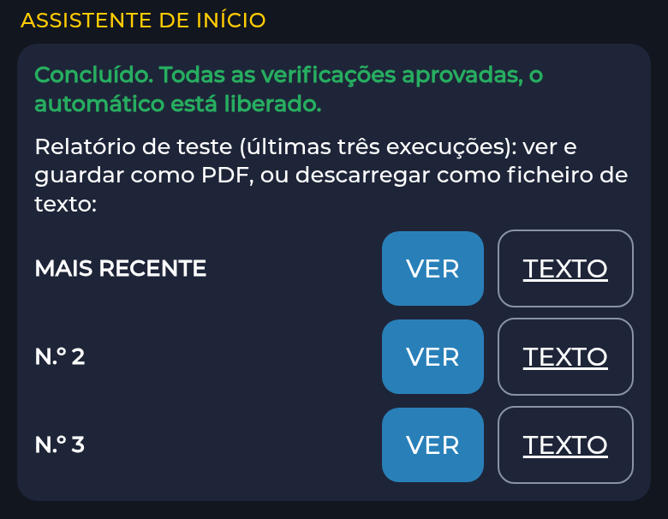
handbuch/img/web_pt/einrichtung_setup.png
