ssbingo/samba-solar-track/hardware/HallTapBoard/vorschau/HallTapBoard-schaltplan.pdf

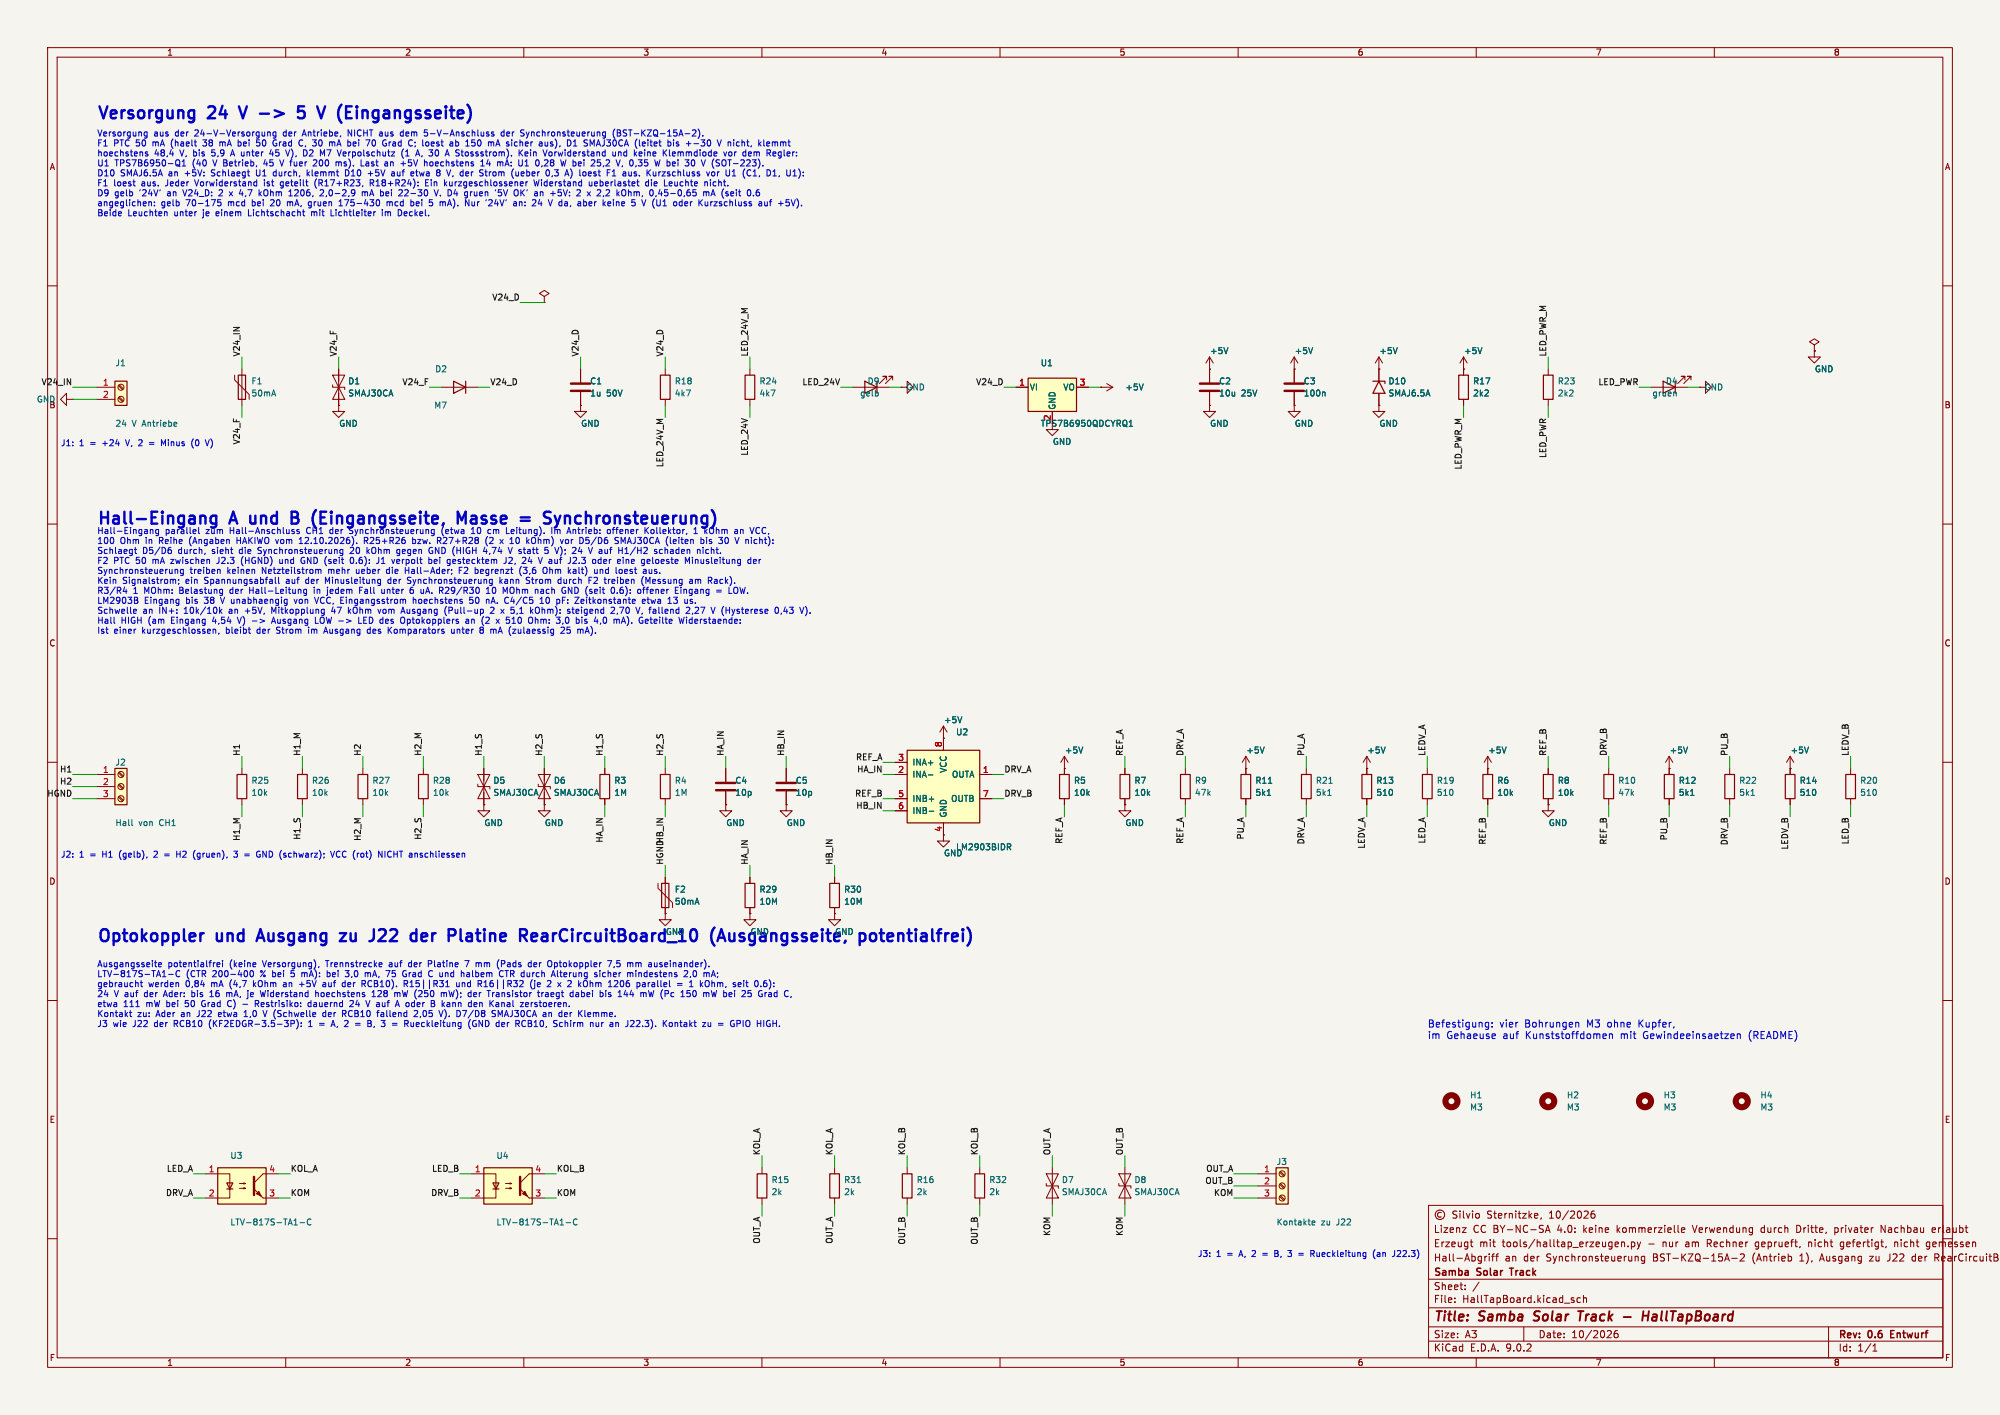
[picture p203: page 1]

Id: 1/1 Title: Samba Solar Track - HallTapBoard
