ssbingo/samba-solar-track/hardware/HallTapBoard/vorschau/HallTapBoard-zeichnung.pdf

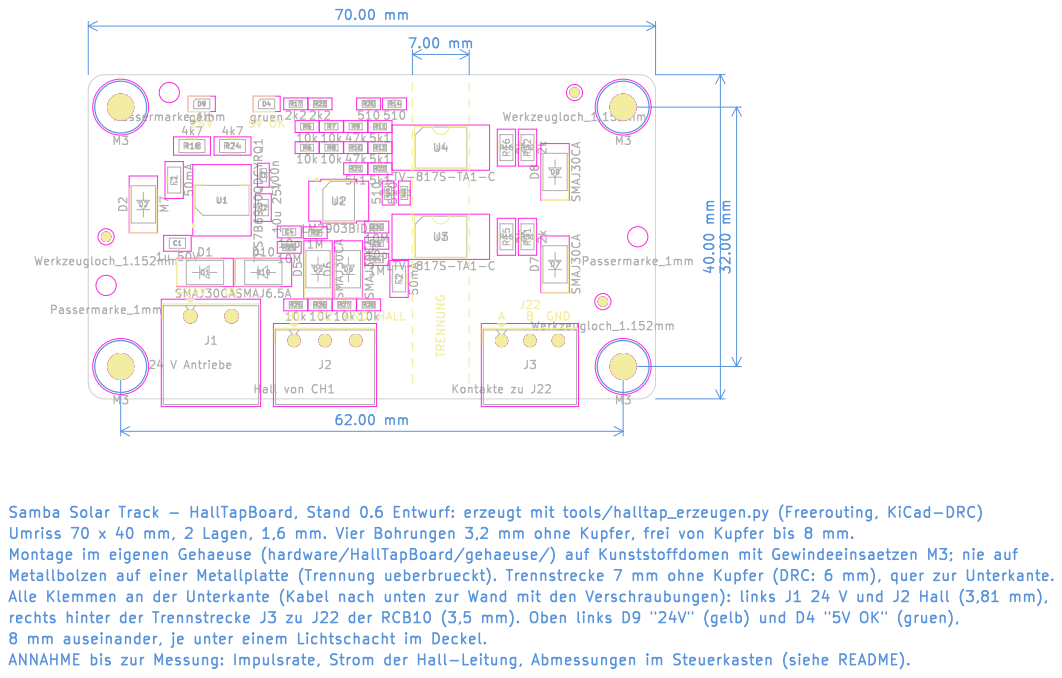
[picture p204: page 1]

Id: 1/1 Title: Samba Solar Track - HallTapBoard
