ssbingo/samba-solar-track/hardware/RearCircuitBoard_10/vorschau/RearCircuitBoard_10-schaltplan.pdf

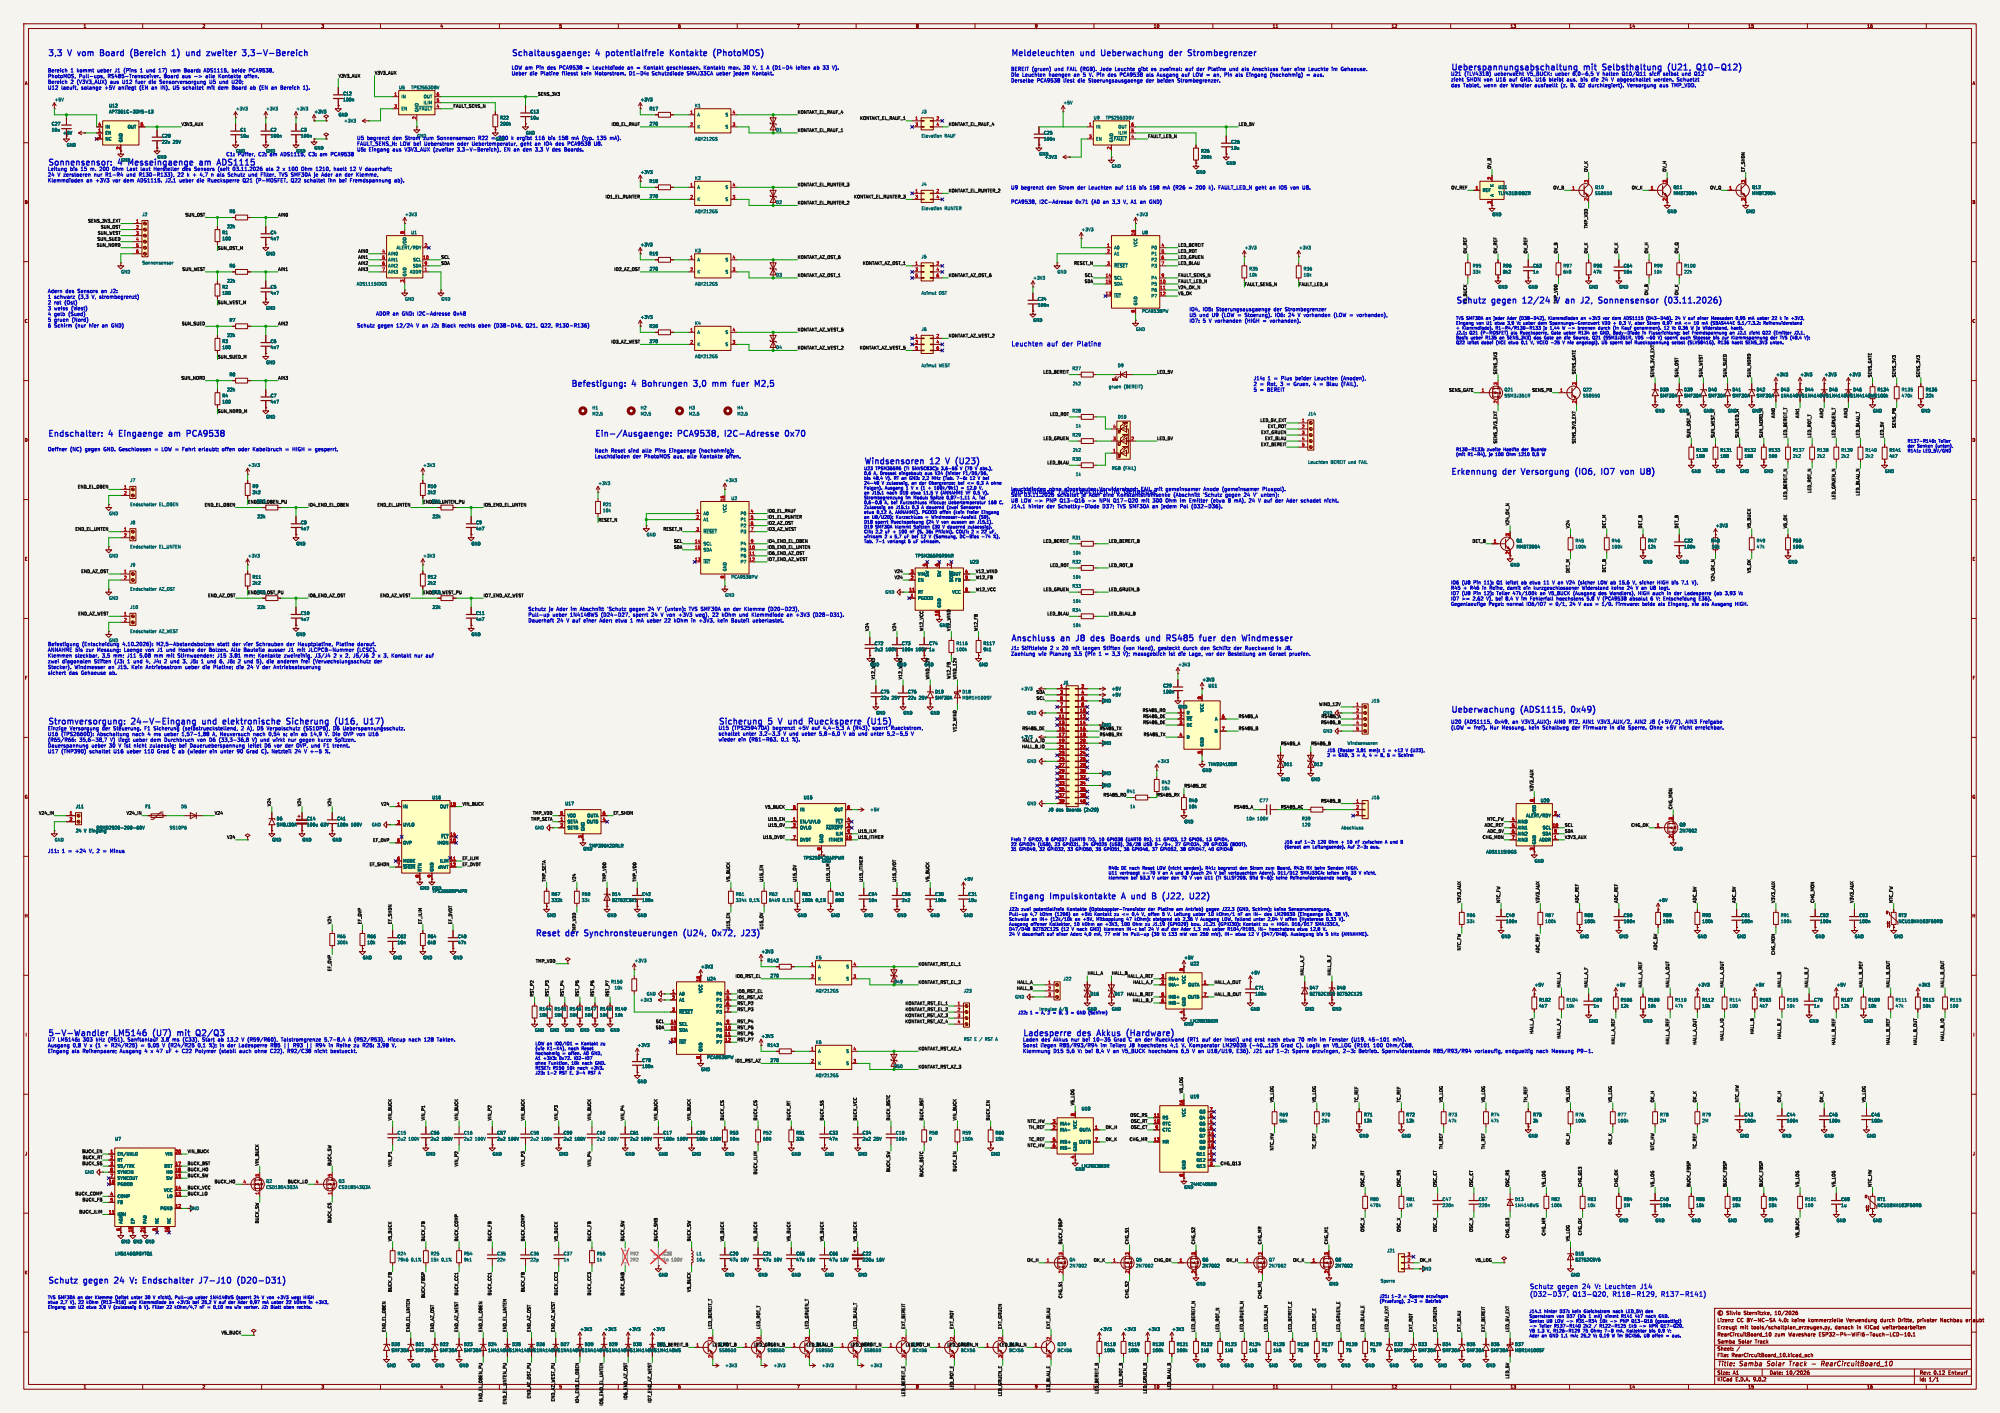
[picture p205: page 1]

3,3 V vom Board (Bereich 1) und zweiter 3,3-V-Bereich

Bereich 1 kommt ueber J1 (Pins 1 und 17) vom Board: ADS1115, beide PCA9538,

3 2 GND GND GND GND GND

3 ALERT/RDY 2 SCL 10 SDA 9 ADDR 1 U1 ADS1115IDGS

Leuchten auf der Platine

J14: 1 = Plus beider Leuchten (Anoden), 2 = Rot, 3 = Gruen, 4 = Blau (FAIL), 5 = BEREIT

Leuchten BEREIT und FAIL

Anschluesse fuer Leuchten im Gehaeuse

etwa 0,12 A, ANNAHME). PGOOD offen (kein freier Eingang

Anschluss an J8 des Boards und RS485 fuer den Windmesser

2u2 100V GND GND GND GND

LO 13 PGND 12 U7
LM5146QRGYTQ1 EN/UVLO 1 RT 2 SS/TRK 3 SYNCIN 8 SYNCOUT 7 PGOOD 10 COMP 4 FB 5

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

9 NC 16 VIN 20 BST 17 HO 18 SW 19 VCC 14

Id: 1/1 Title: Samba Solar Track - RearCircuitBoard_10
