ssbingo/samba-solar-track/hardware/RearCircuitBoard_10/vorschau/RearCircuitBoard_10-zeichnung.pdf

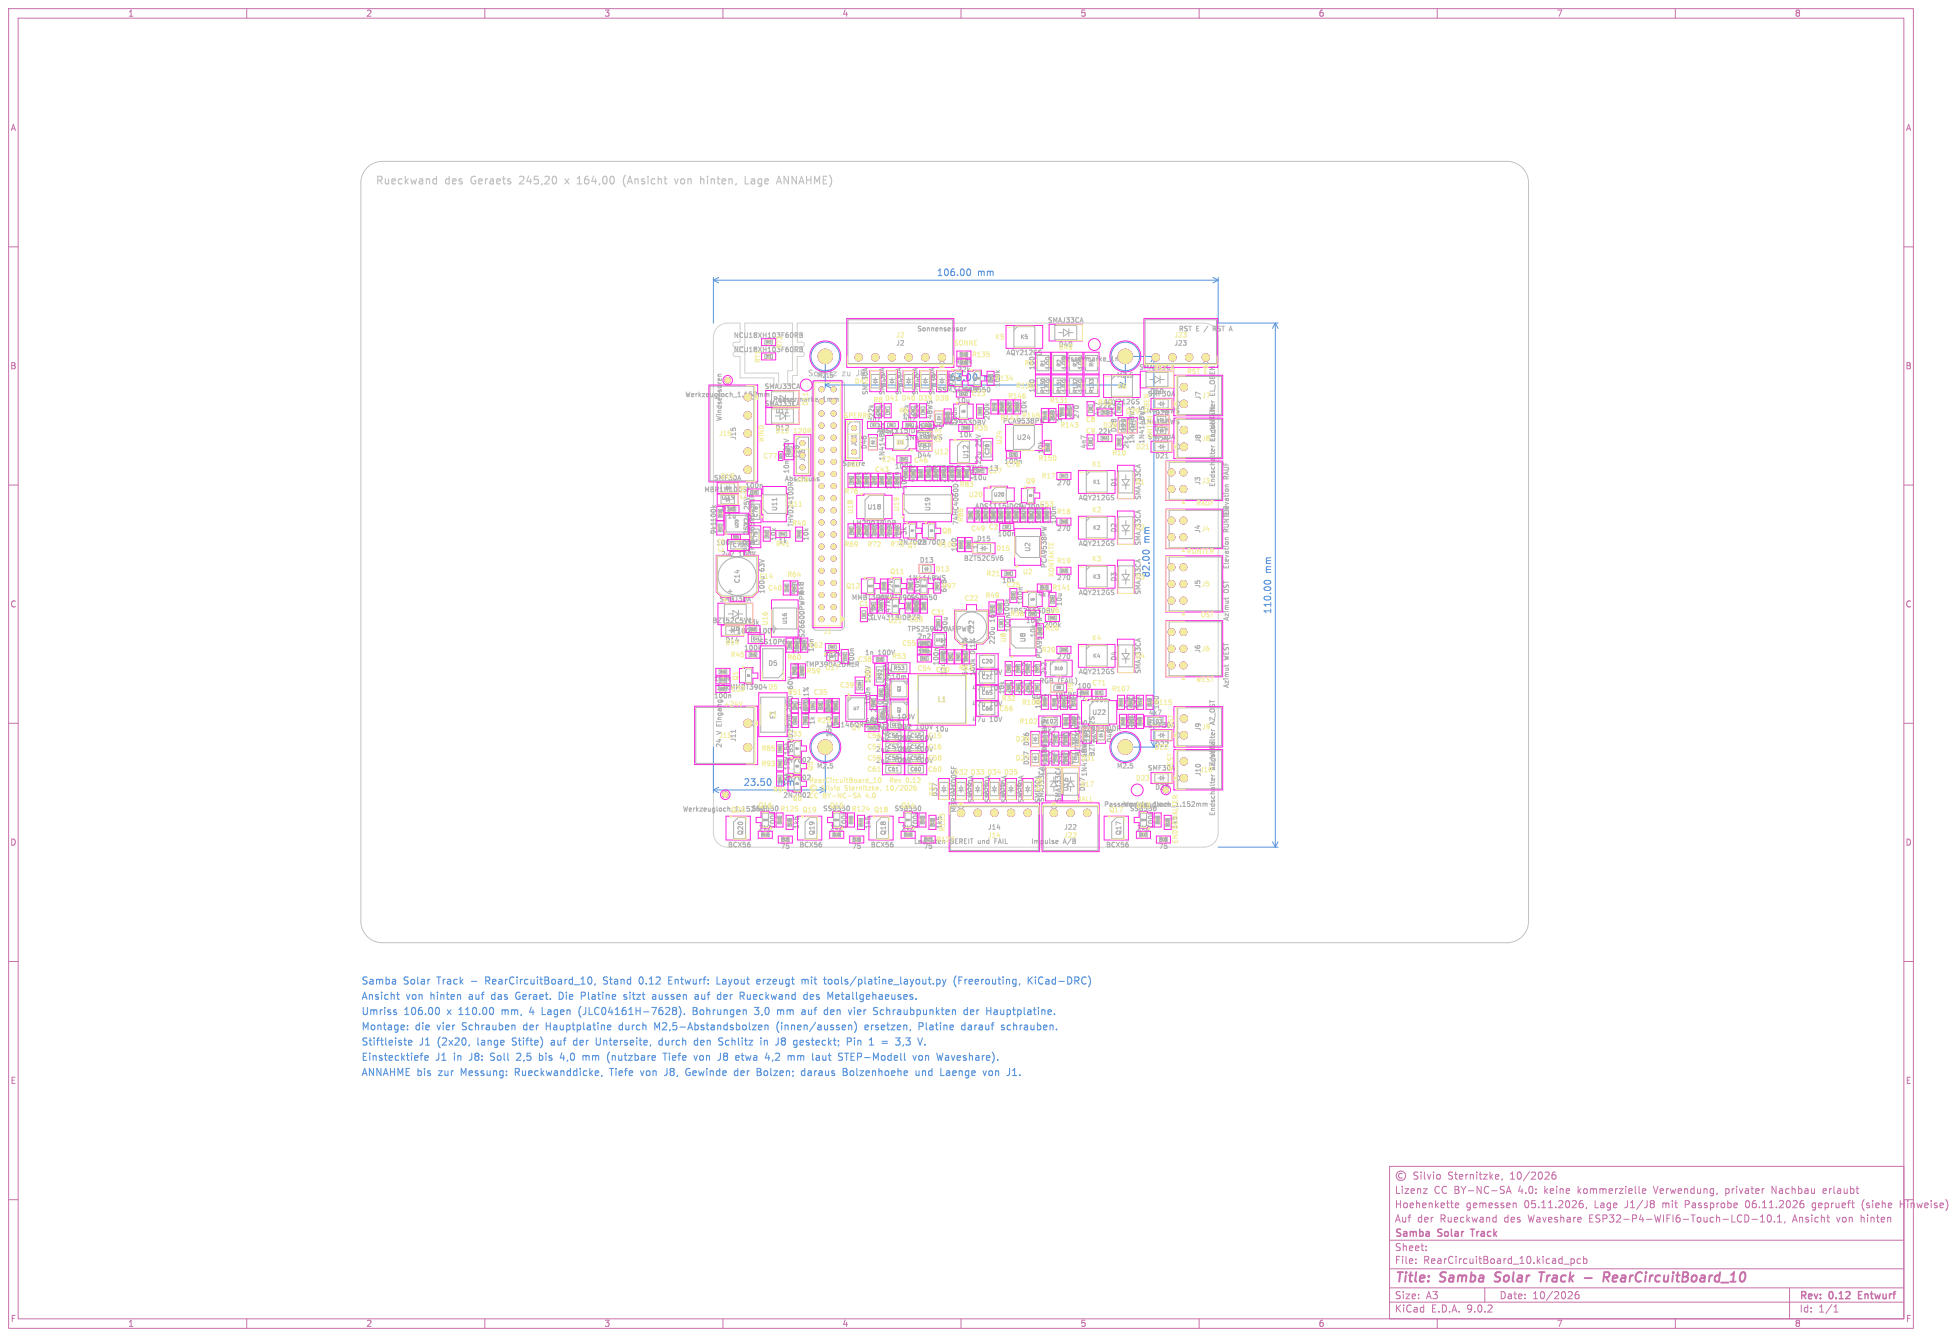
[picture p206: page 1]

Id: 1/1 Title: Samba Solar Track - RearCircuitBoard_10
