ssbingo/samba-solar-track/gehaeuse/Bohrschablone_A4quer_ESP32-P4_10.1.pdf

# Bohrschablone – Rückwandgehäuse ESP32-P4-WIFI6-Touch-LCD-10.1 ▲ OBEN

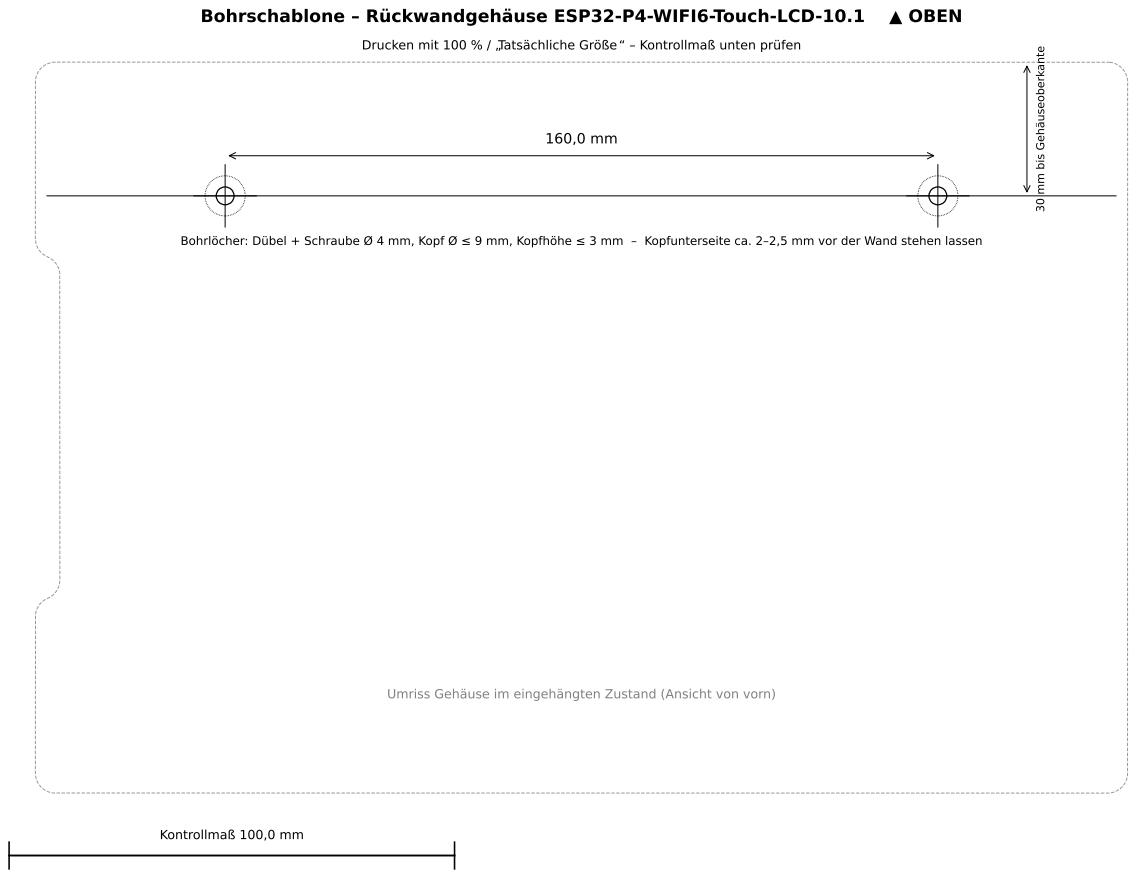
[picture p207: page 1]
Kontrollmaß 100,0 mm

Drucken mit 100 % / „Tatsächliche Größe“ – Kontrollmaß unten prüfen

30 mm bis Gehäuseoberkante

Bohrlöcher: Dübel + Schraube Ø 4 mm, Kopf Ø ≤ 9 mm, Kopfhöhe ≤ 3 mm – Kopfunterseite ca. 2–2,5 mm vor der Wand stehen lassen

Umriss Gehäuse im eingehängten Zustand (Ansicht von vorn)
