ssbingo/samba-solar-track/hardware/HallTapBoard/HallTapBoard.kicad_pcb

## KiCad design hardware/HallTapBoard/HallTapBoard.kicad_pcb (2026-11-13)

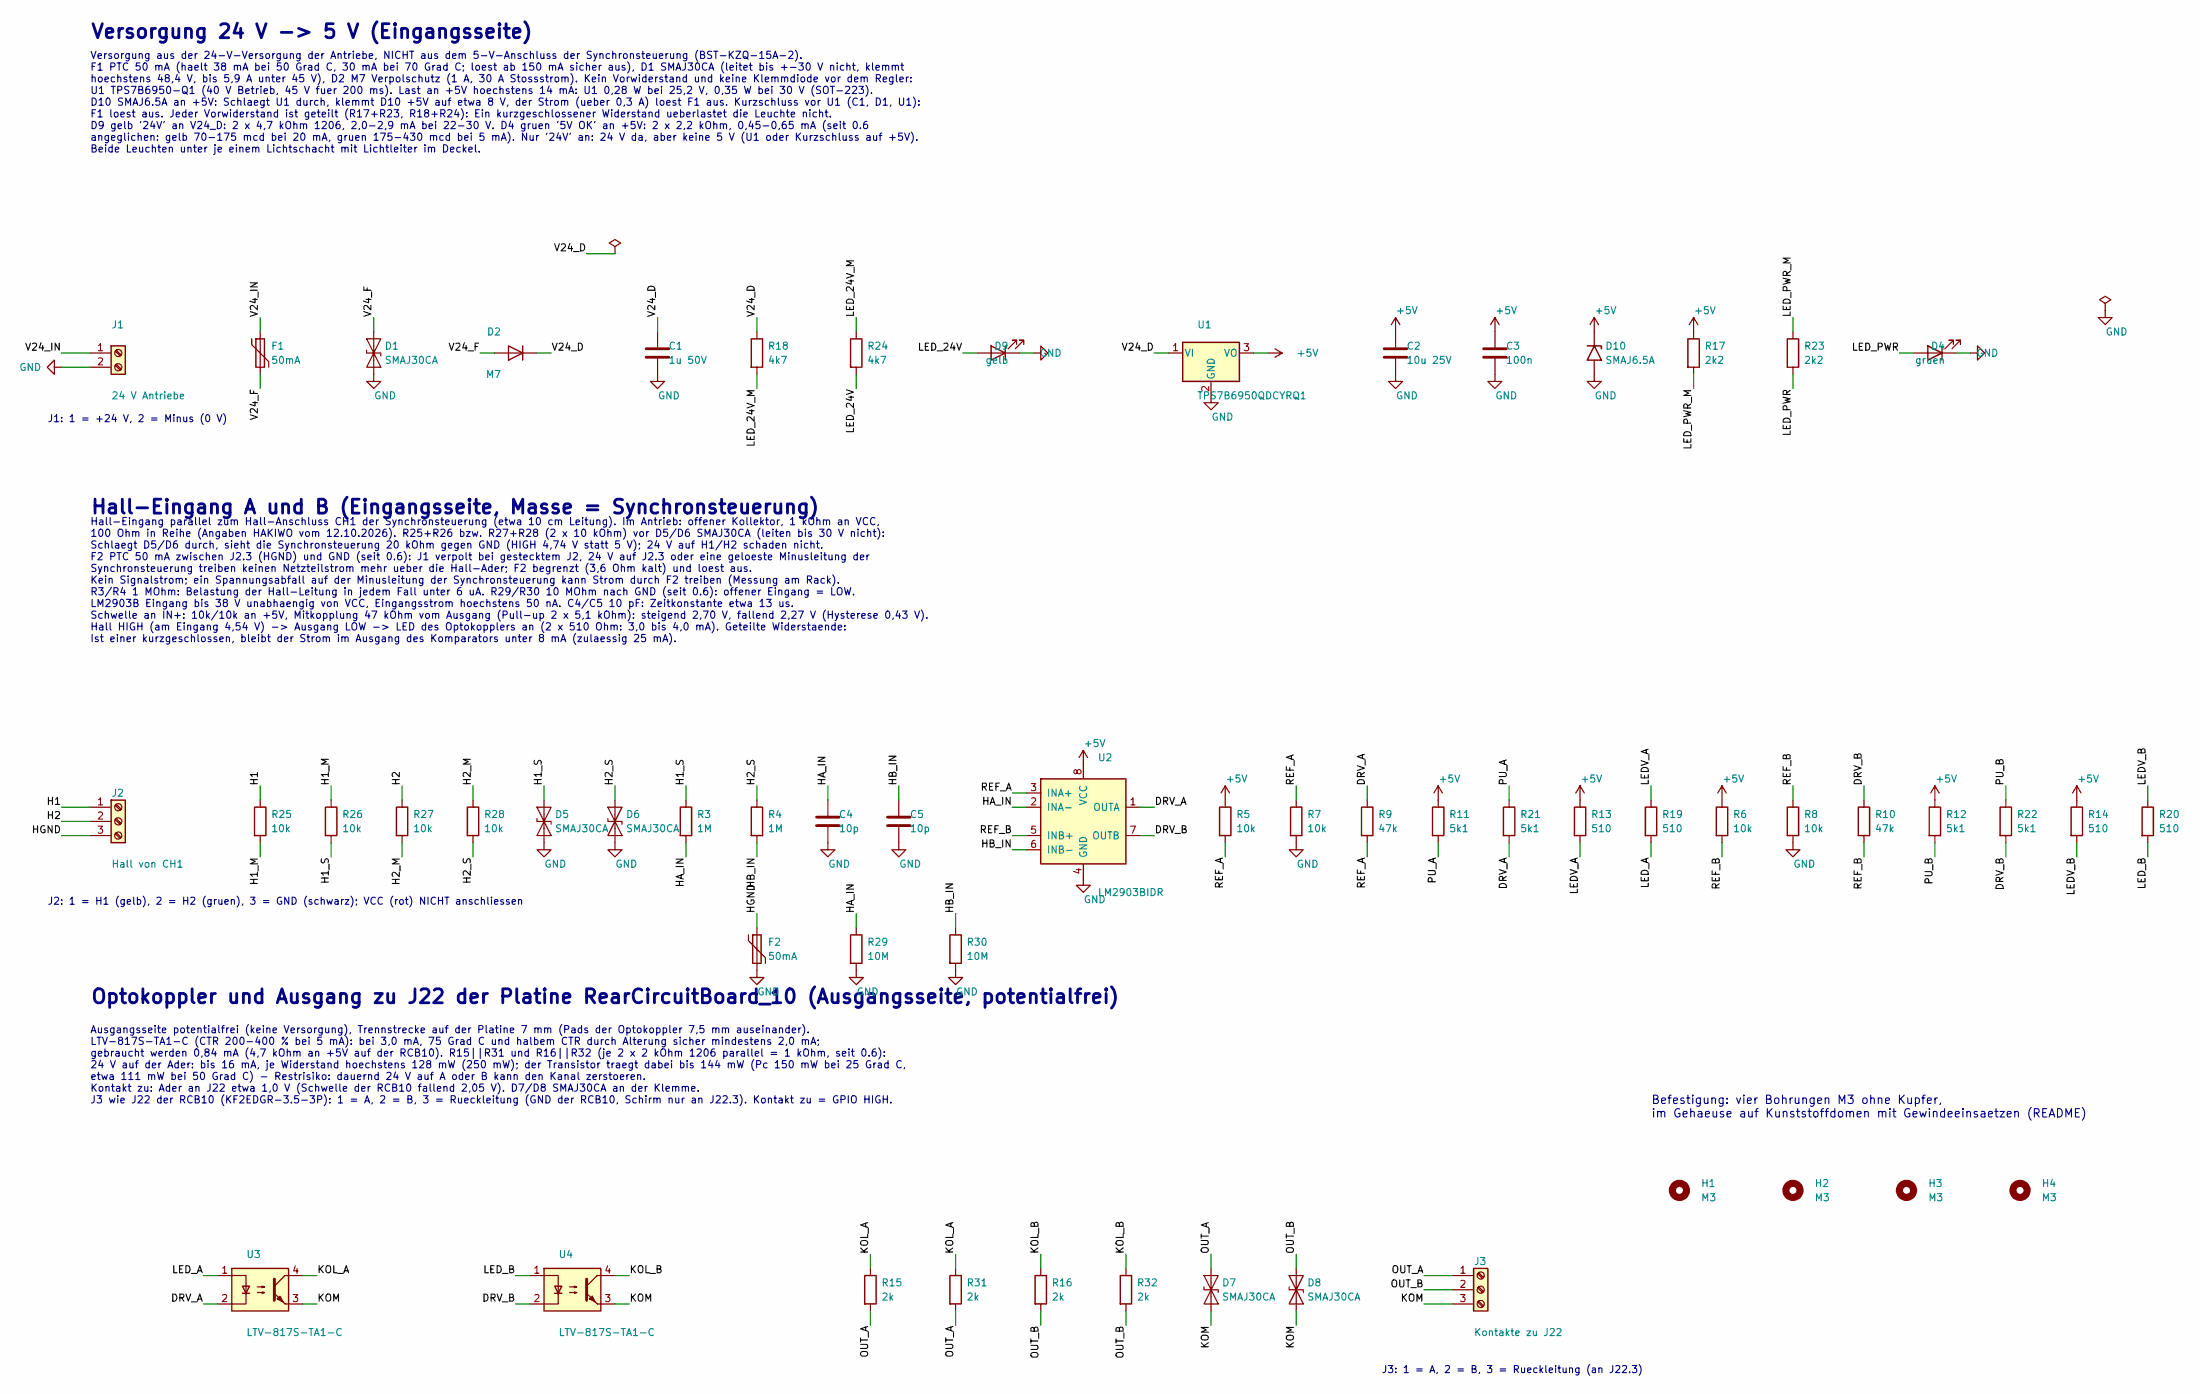
[picture p208: schematic HallTapBoard.kicad_sch, Samba Solar Track - HallTapBoard]

Parts:
C1: 1u 50V; C_0805_2012Metric; LCSC C28323
C2: 10u 25V; C_0805_2012Metric; LCSC C15850
C3: 100n; C_0603_1608Metric; LCSC C14663
C4, C5: 10p; C_0603_1608Metric; LCSC C1634
D1, D5, D6, D7, D8: SMAJ30CA; D_SMA; LCSC C110043
D2: M7; D_SMA; LCSC C95872
D4: gruen; LED_0805_2012Metric; LCSC C2297
D9: gelb; LED_0805_2012Metric; LCSC C2296
D10: SMAJ6.5A; D_SMA; LCSC C123817
F1, F2: 50mA; Fuse_1206_3216Metric; LCSC C70064
H1, H2, H3, H4: M3; MountingHole_3.2mm_M3
J1: 24 V Antriebe; Klemme_5.08_2P_KF2EDGRC; LCSC C441236
J2: Hall von CH1; Klemme_3.81_3P_KF2EDGR; LCSC C441183
J3: Kontakte zu J22; Klemme_3.5_3P_KF2EDGR; LCSC C441172
R3, R4: 1M; R_0603_1608Metric; LCSC C22935
R5, R6, R7, R8, R25, R26, R27, R28: 10k; R_0603_1608Metric; LCSC C25804
R9, R10: 47k; R_0603_1608Metric; LCSC C25819
R11, R12, R21, R22: 5k1; R_0603_1608Metric; LCSC C23186
R13, R14, R19, R20: 510; R_0603_1608Metric; LCSC C23193
R15, R16, R31, R32: 2k; R_1206_3216Metric; LCSC C17944
R17, R23: 2k2; R_0603_1608Metric; LCSC C4190
R18, R24: 4k7; R_1206_3216Metric; LCSC C17936
R29, R30: 10M; R_0603_1608Metric; LCSC C7250
U1: TPS7B6950QDCYRQ1; SOT-223-3_TabPin2; LCSC C108469
U2: LM2903BIDR; SOIC-8_3.9x4.9mm_P1.27mm; LCSC C2869804
U3, U4: LTV-817S-TA1-C; SMDIP-4_W9.53mm; LCSC C109227

Connections:
+5V: C2.1, C3.1, D10.1 (A1), R5.1, R6.1, R11.1, R12.1, R13.1, R14.1, R17.1, U1.3 (VO), U2.8 (VCC)
/DRV_A: R9.1, R21.2, U2.1 (OUTA), U3.2
/DRV_B: R10.1, R22.2, U2.7 (OUTB), U4.2
/H1: J2.1, R25.1
/H1_M: R25.2, R26.1
/H1_S: D5.1 (A1), R3.1, R26.2
/H2: J2.2, R27.1
/H2_M: R27.2, R28.1
/H2_S: D6.1 (A1), R4.1, R28.2
/HA_IN: C4.1, R3.2, R29.1, U2.2 (INA-)
/HB_IN: C5.1, R4.2, R30.1, U2.6 (INB-)
/HGND: F2.1, J2.3
/KOL_A: R15.1, R31.1, U3.4
/KOL_B: R16.1, R32.1, U4.4
/KOM: D7.2 (A2), D8.2 (A2), J3.3, U3.3, U4.3
/LEDV_A: R13.2, R19.1
/LEDV_B: R14.2, R20.1
/LED_24V: D9.2 (A), R24.2
/LED_24V_M: R18.2, R24.1
/LED_A: R19.2, U3.1
/LED_B: R20.2, U4.1
/LED_PWR: D4.2 (A), R23.2
/LED_PWR_M: R17.2, R23.1
/OUT_A: D7.1 (A1), J3.1, R15.2, R31.2
/OUT_B: D8.1 (A1), J3.2, R16.2, R32.2
/PU_A: R11.2, R21.1
/PU_B: R12.2, R22.1
/REF_A: R5.2, R7.1, R9.2, U2.3 (INA+)
/REF_B: R6.2, R8.1, R10.2, U2.5 (INB+)
/V24_D: C1.1, D2.1 (K), R18.1, U1.1 (VI)
/V24_F: D1.1 (A1), D2.2 (A), F1.2
/V24_IN: F1.1, J1.1
GND: C1.2, C2.2, C3.2, C4.2, C5.2, D1.2 (A2), D4.1 (K), D5.2 (A2), D6.2 (A2), D9.1 (K), D10.2 (A2), F2.2, J1.2, R7.2, R8.2, R29.2, R30.2, U1.2 (GND), U2.4 (GND)

Notes on the sheet:
Versorgung 24 V -> 5 V (Eingangsseite)
Versorgung aus der 24-V-Versorgung der Antriebe, NICHT aus dem 5-V-Anschluss der Synchronsteuerung (BST-KZQ-15A-2). F1 PTC 50 mA (haelt 38 mA bei 50 Grad C, 30 mA bei 70 Grad C; loest ab 150 mA sicher aus), D1 SMAJ30CA (leitet bis +-30 V nicht, klemmt hoechstens 48,4 V, bis 5,9 A unter 45 V), D2 M7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
J1: 1 = +24 V, 2 = Minus (0 V)
Hall-Eingang A und B (Eingangsseite, Masse = Synchronsteuerung)
Hall-Eingang parallel zum Hall-Anschluss CH1 der Synchronsteuerung (etwa 10 cm Leitung). Im Antrieb: offener Kollektor, 1 kOhm an VCC, 100 Ohm in Reihe (Angaben HAKIWO vom 12.10.2026). R25+R26 bzw. R27+R28 (2 x 10 kOhm) vor D5/D6 SMAJ30CA (leiten bis 30 V nicht): Schlaegt D5/D6 durch, sieht die Syn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
J2: 1 = H1 (gelb), 2 = H2 (gruen), 3 = GND (schwarz); VCC (rot) NICHT anschliessen
Optokoppler und Ausgang zu J22 der Platine RearCircuitBoard_10 (Ausgangsseite, potentialfrei)
Ausgangsseite potentialfrei (keine Versorgung), Trennstrecke auf der Platine 7 mm (Pads der Optokoppler 7,5 mm auseinander). LTV-817S-TA1-C (CTR 200-400 % bei 5 mA): bei 3,0 mA, 75 Grad C und halbem CTR durch Alterung sicher mindestens 2,0 mA; gebraucht werden 0,84 mA (4,7 kOhm an +5V auf der RCB10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
J3: 1 = A, 2 = B, 3 = Rueckleitung (an J22.3)
Befestigung: vier Bohrungen M3 ohne Kupfer, im Gehaeuse auf Kunststoffdomen mit Gewindeeinsaetzen (README)

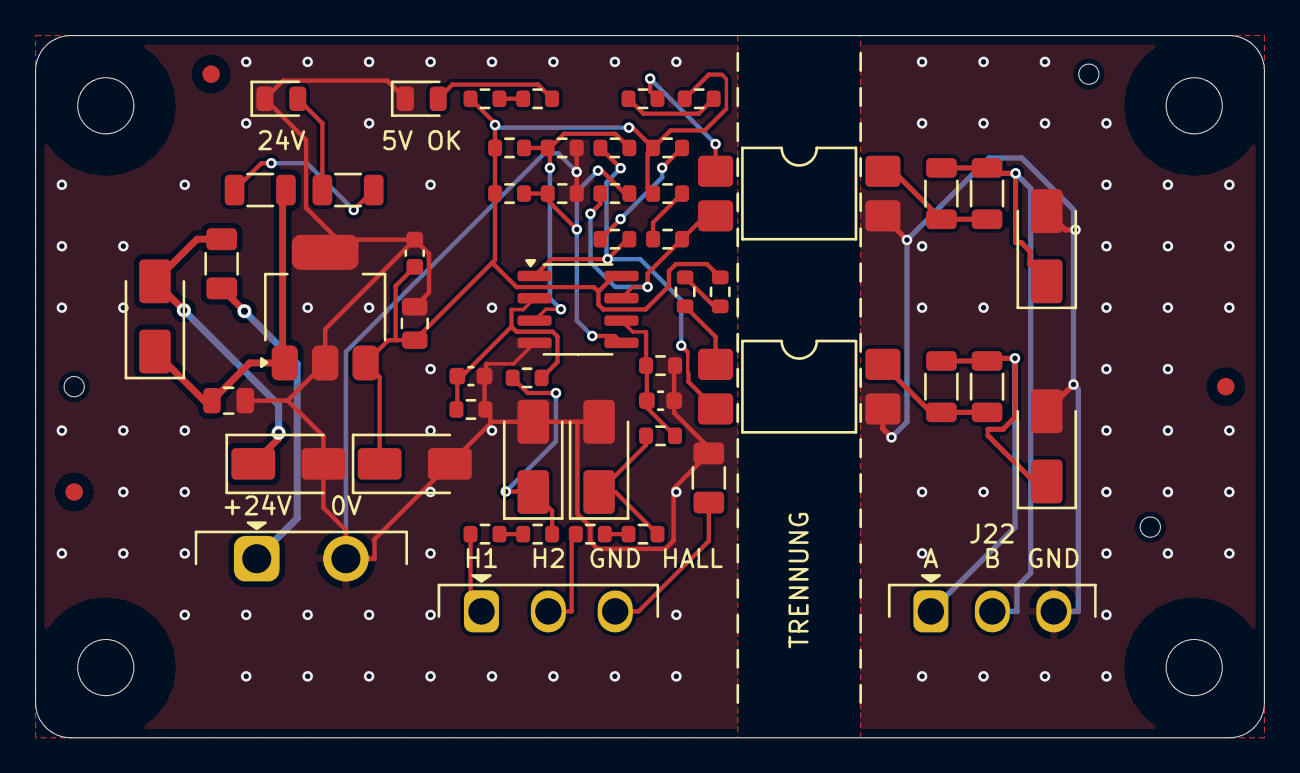
[picture p209: board HallTapBoard.kicad_pcb from above]

Board: 2 copper layers, 70.0 x 40.0 mm, 63 parts (0 on the bottom side), 33 nets.

Other parts of the board:
FID1, FID2, FID3: Passermarke_1mm
TH1, TH2, TH3: Werkzeugloch_1.152mm
