ssbingo/samba-solar-track/hardware/RearCircuitBoard_10/RearCircuitBoard_10.kicad_pcb

## KiCad design hardware/RearCircuitBoard_10/RearCircuitBoard_10.kicad_pcb (2026-11-10)

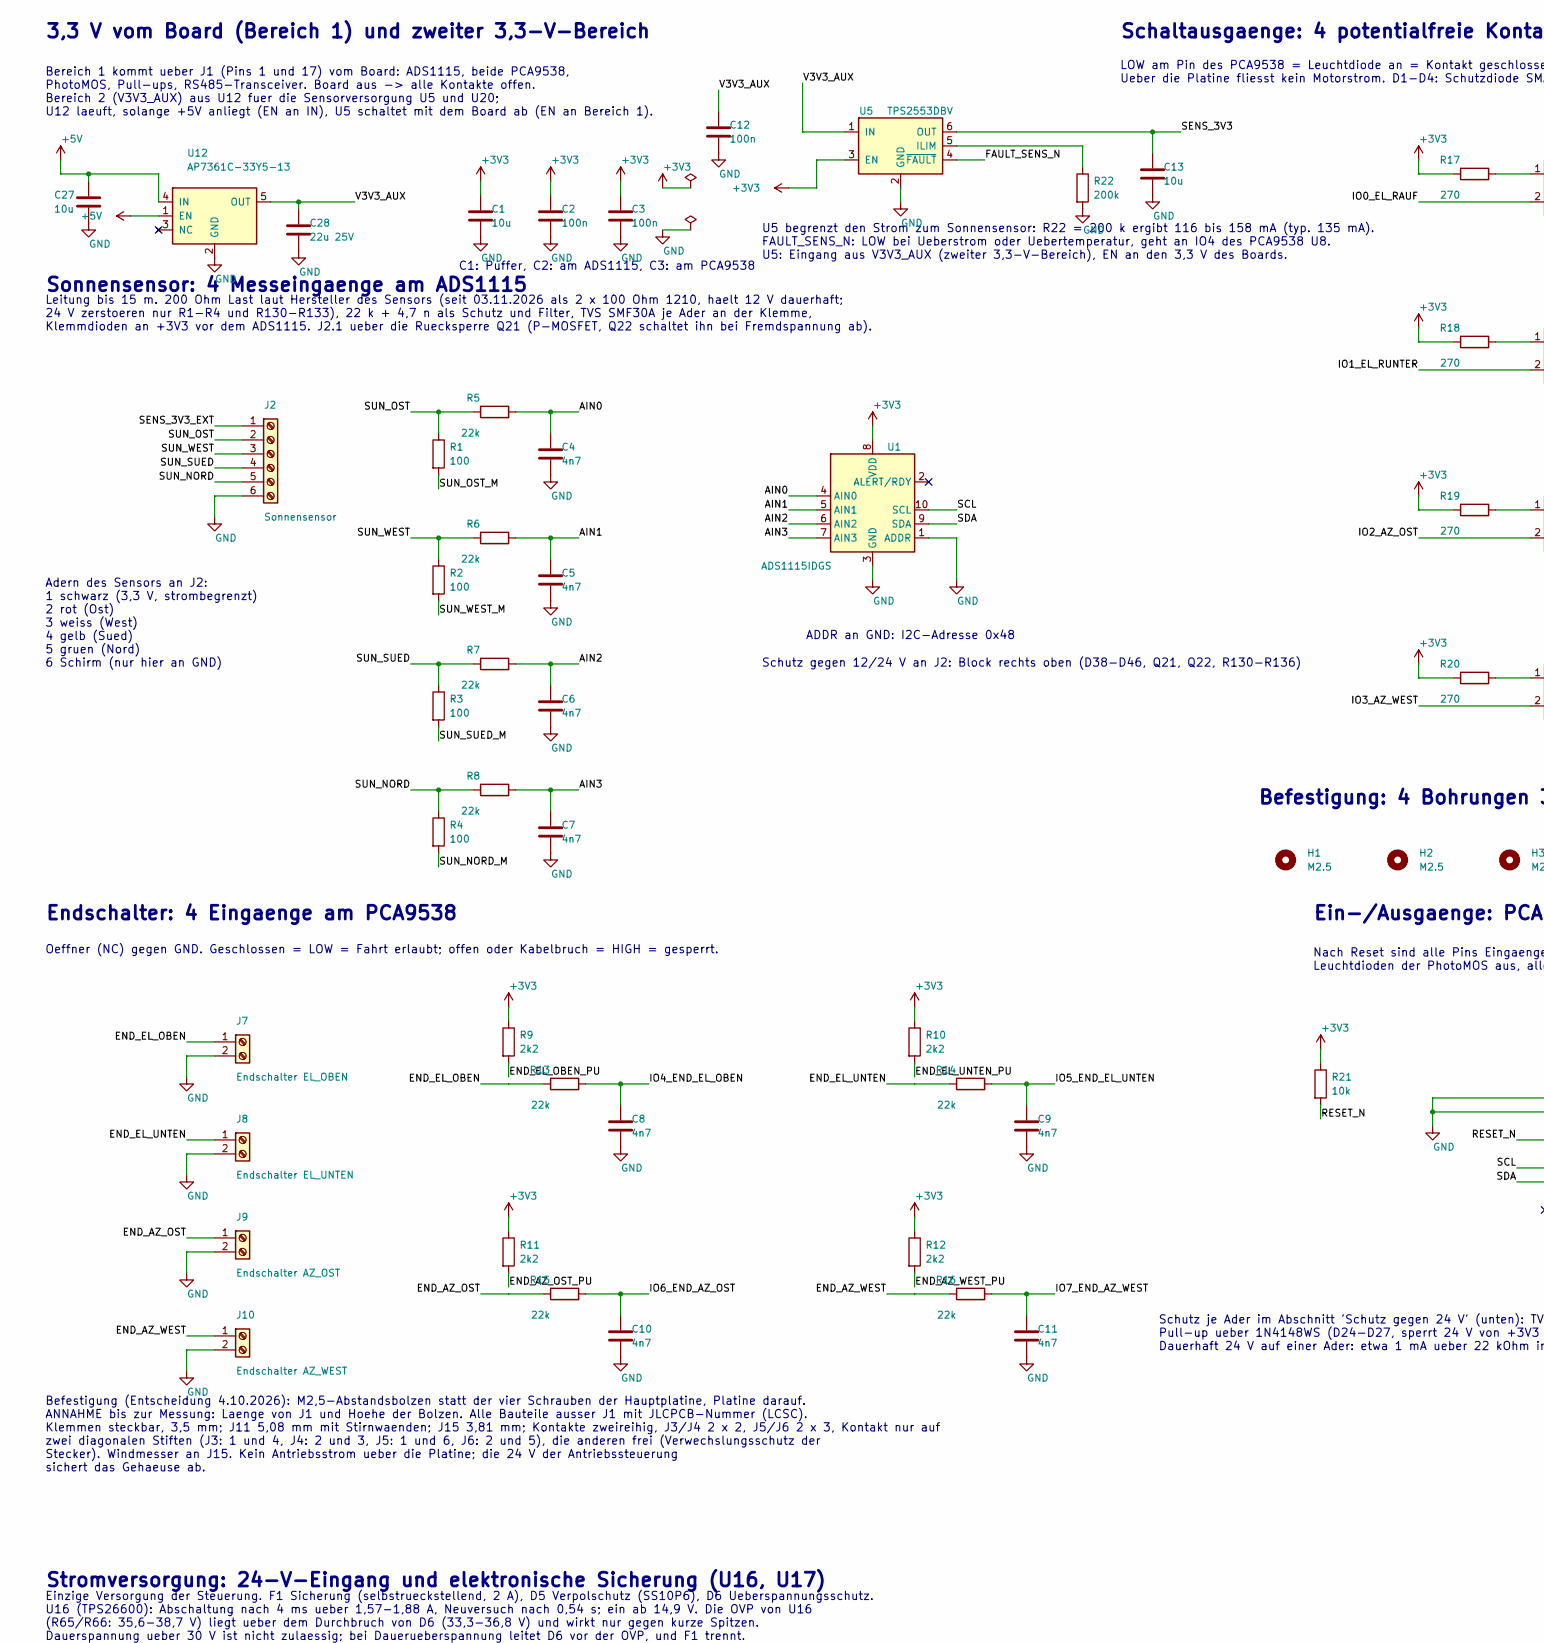
[picture p210: schematic RearCircuitBoard_10.kicad_sch, Samba Solar Track - RearCircuitBoard_10, part in row 1, column 1]

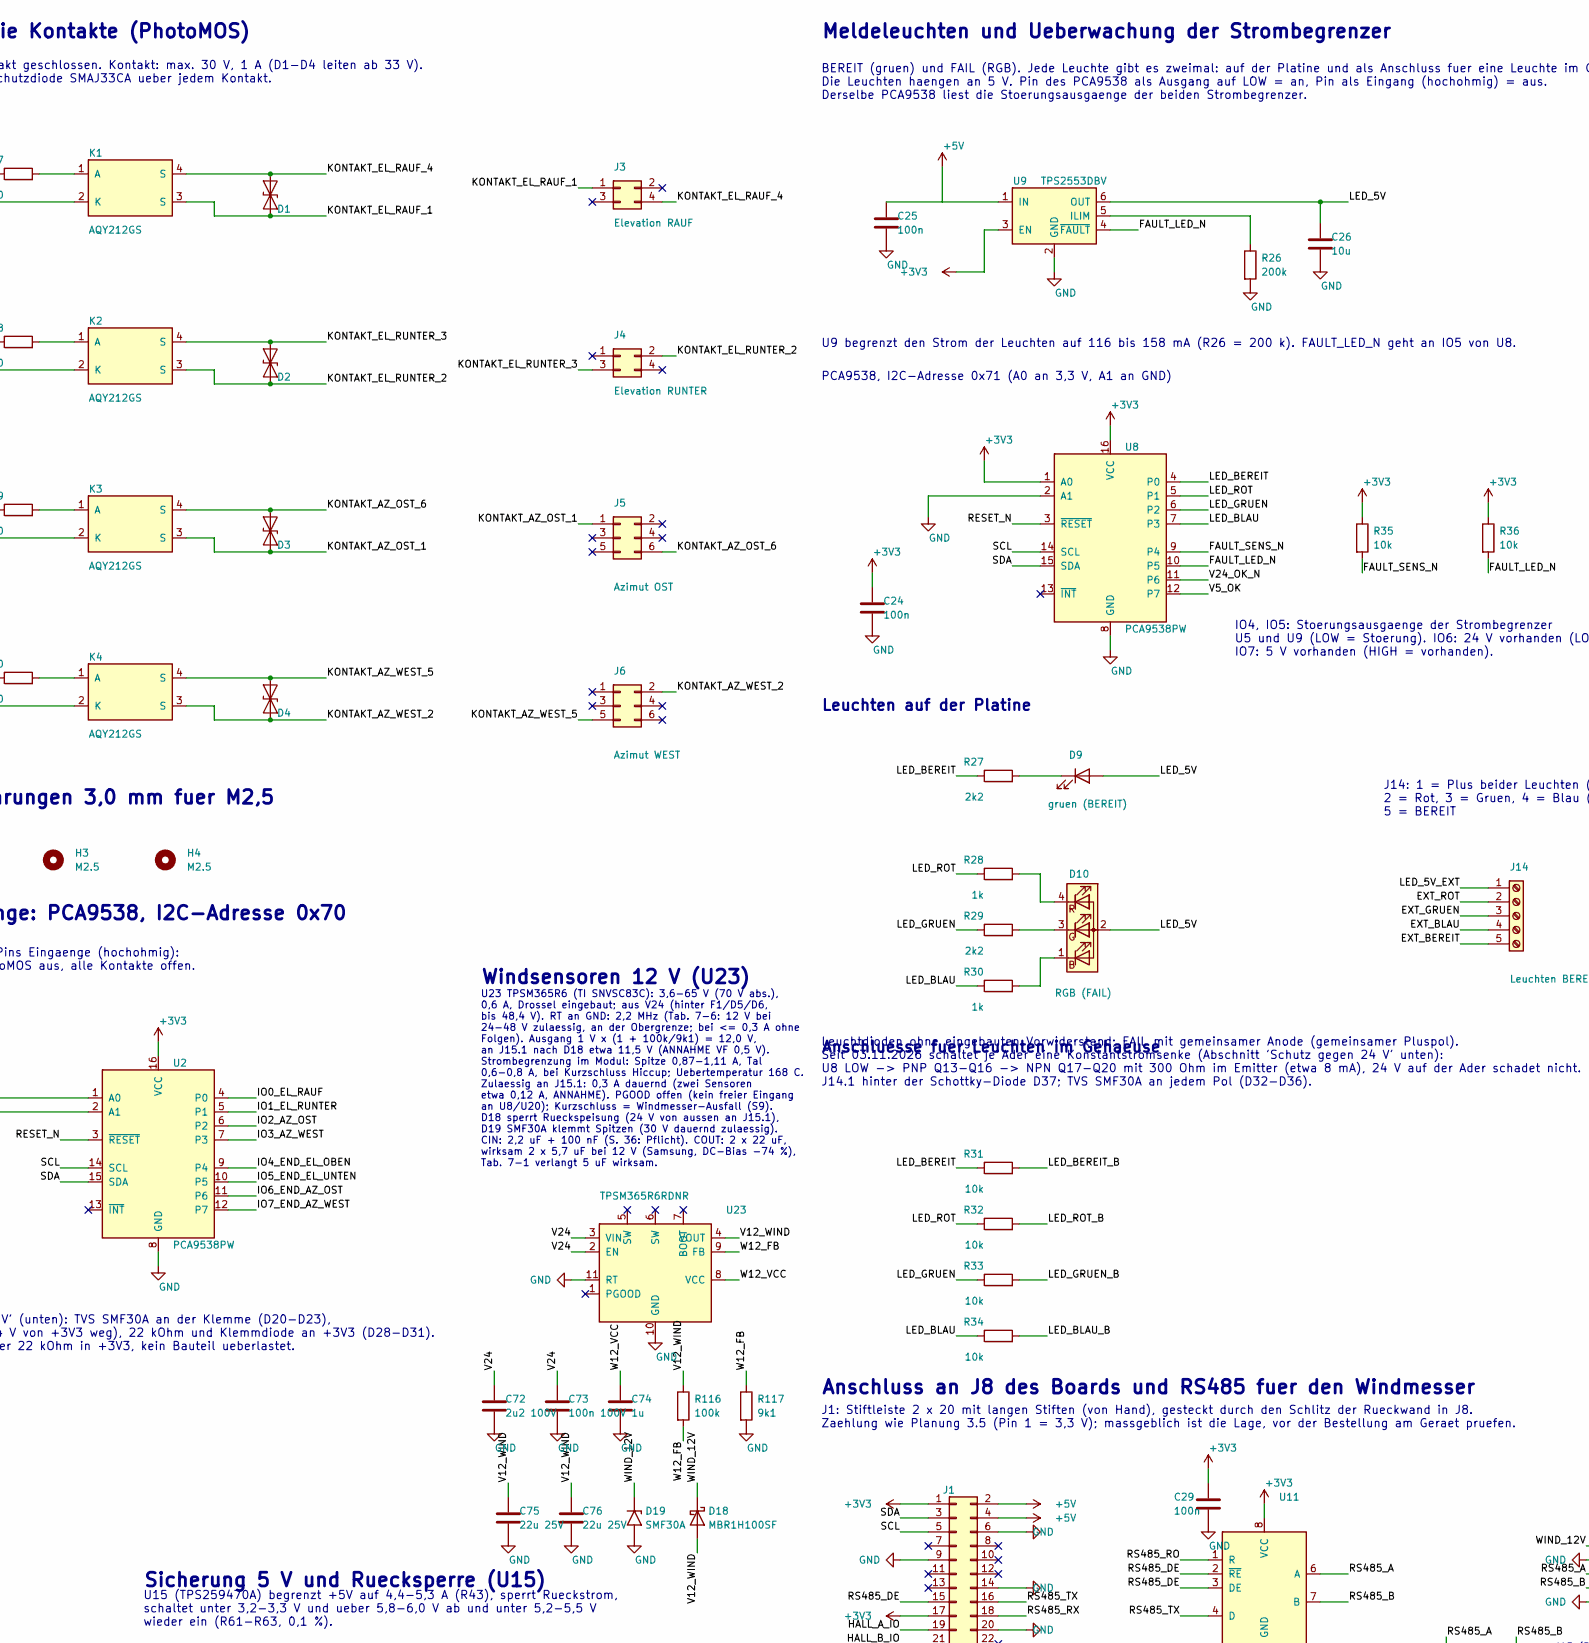
[picture p211: schematic RearCircuitBoard_10.kicad_sch, Samba Solar Track - RearCircuitBoard_10, part in row 1, column 2]

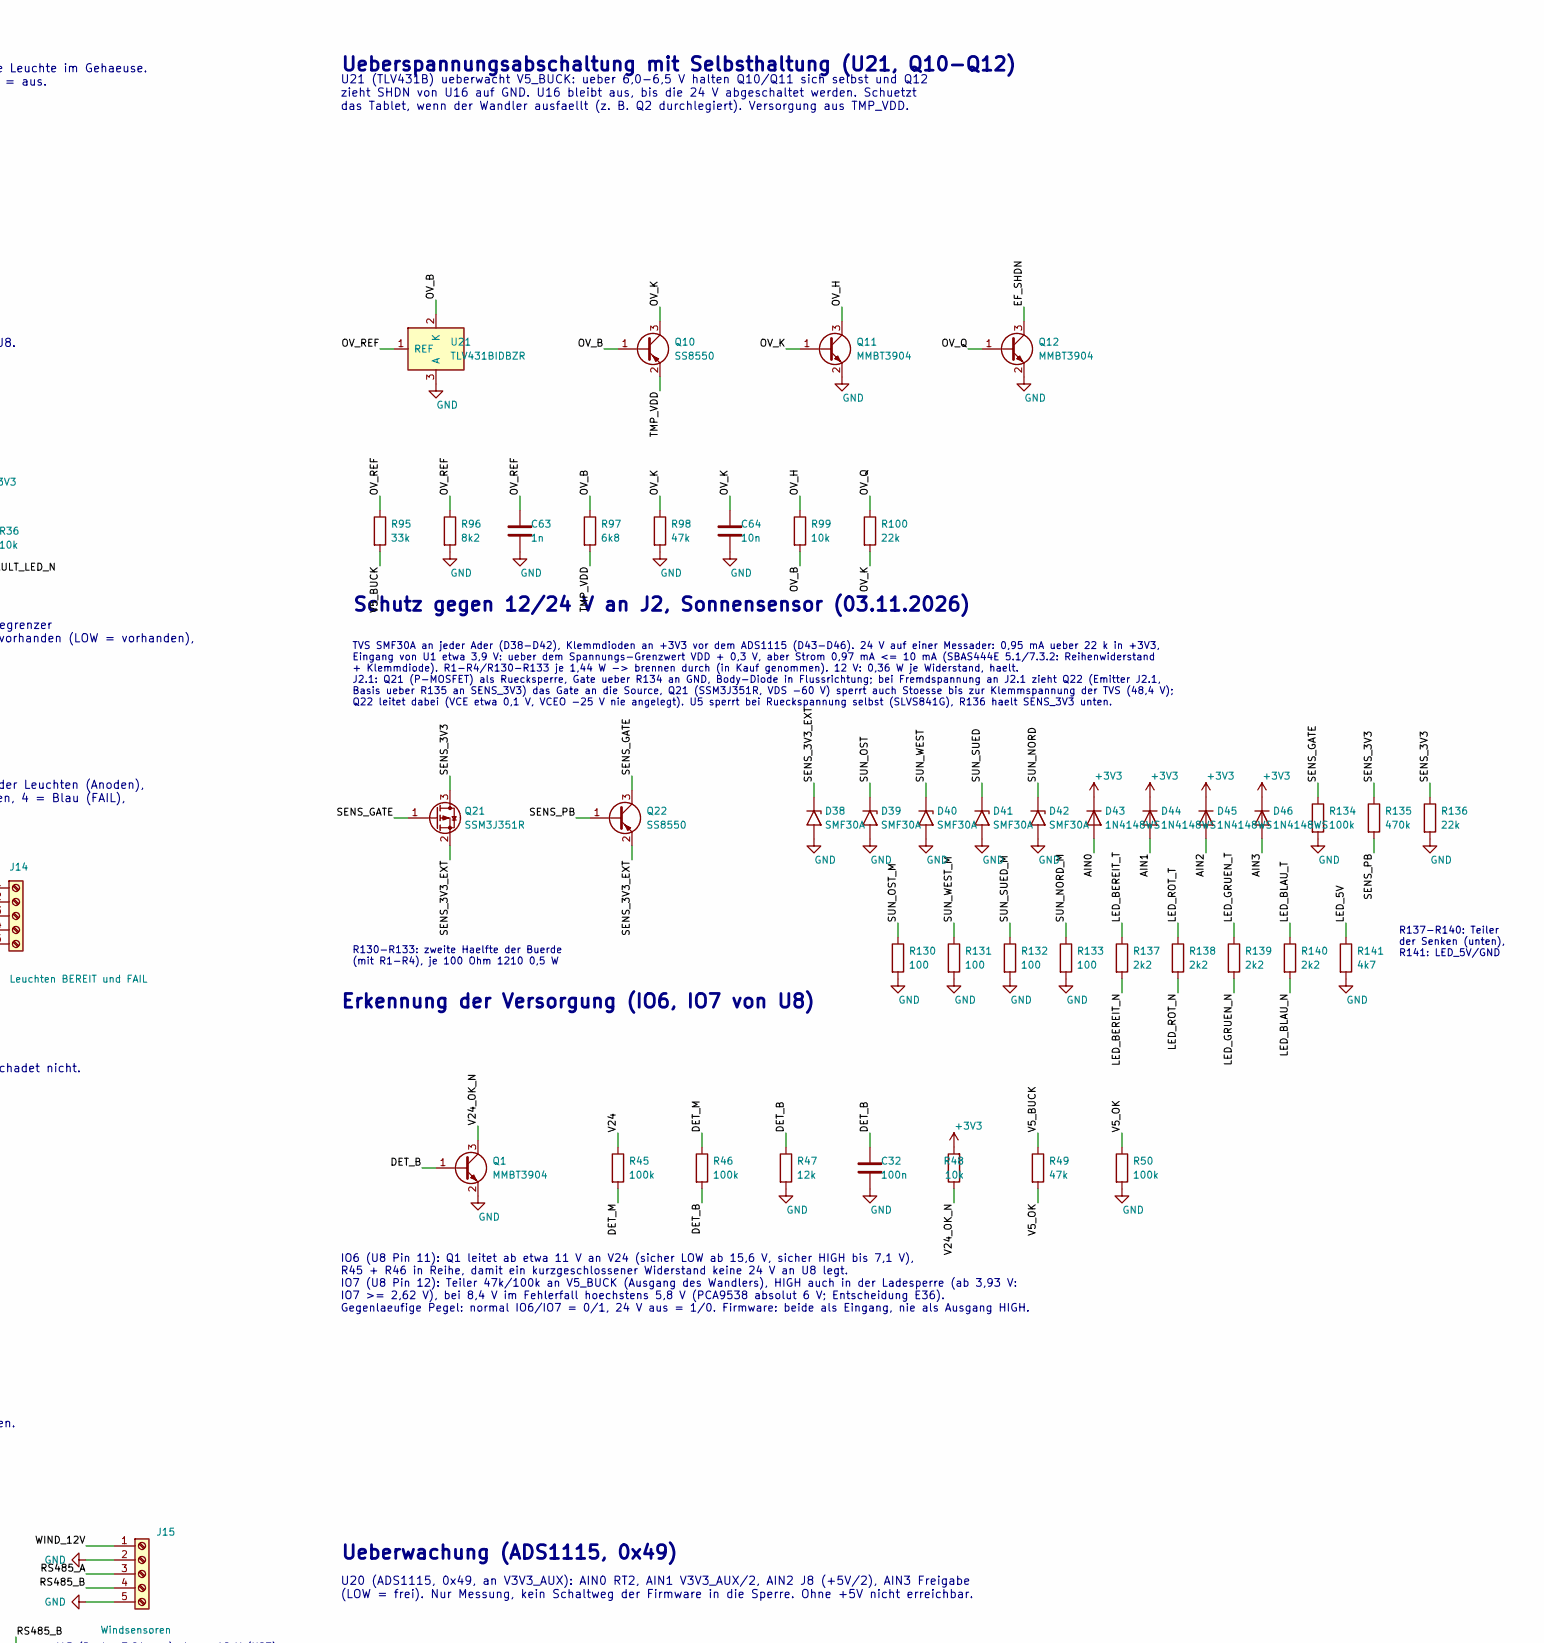
[picture p212: schematic RearCircuitBoard_10.kicad_sch, Samba Solar Track - RearCircuitBoard_10, part in row 1, column 3]

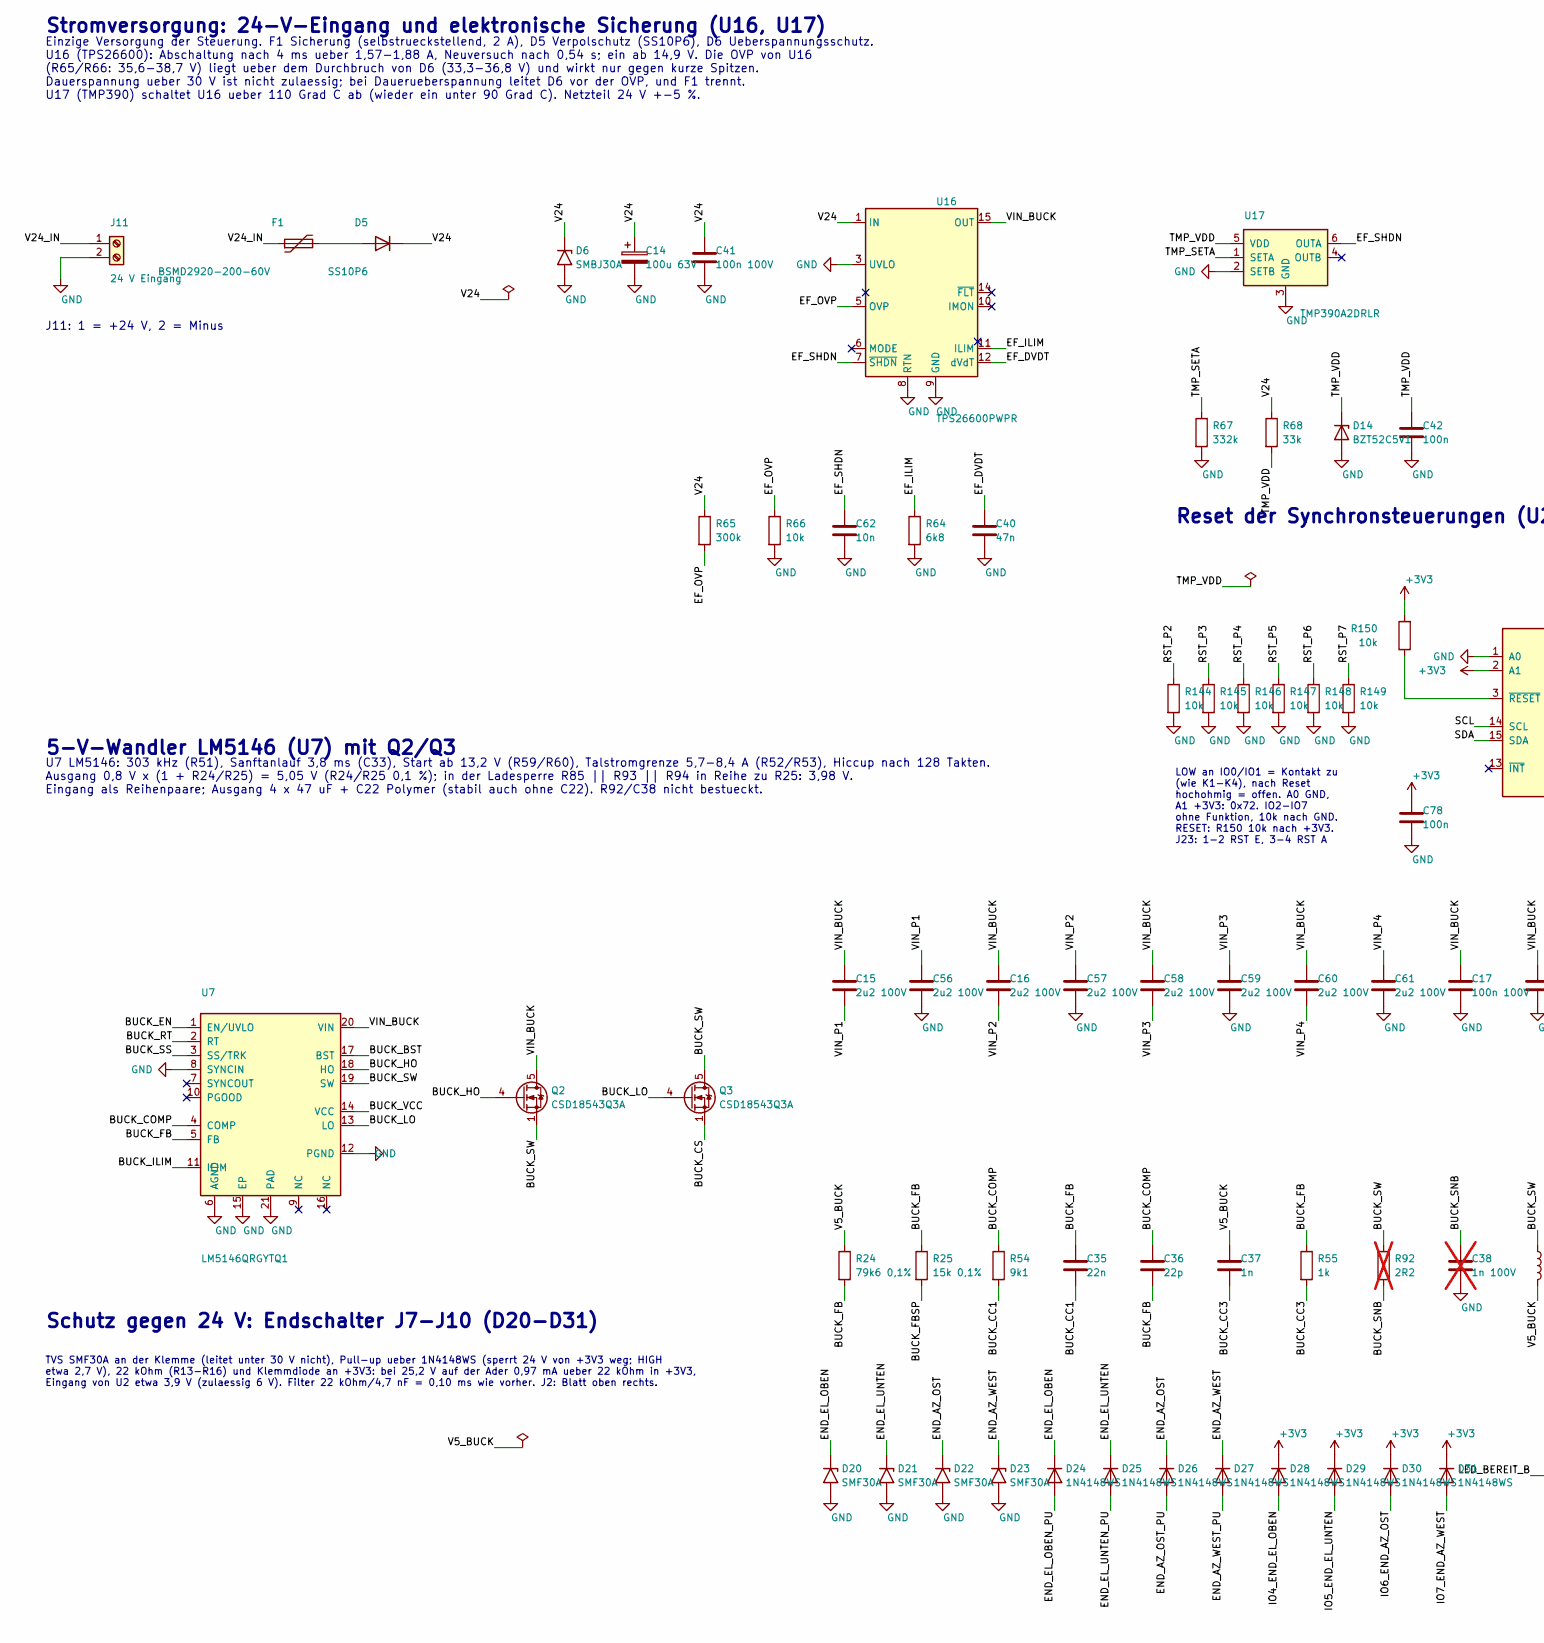
[picture p213: schematic RearCircuitBoard_10.kicad_sch, Samba Solar Track - RearCircuitBoard_10, part in row 2, column 1]

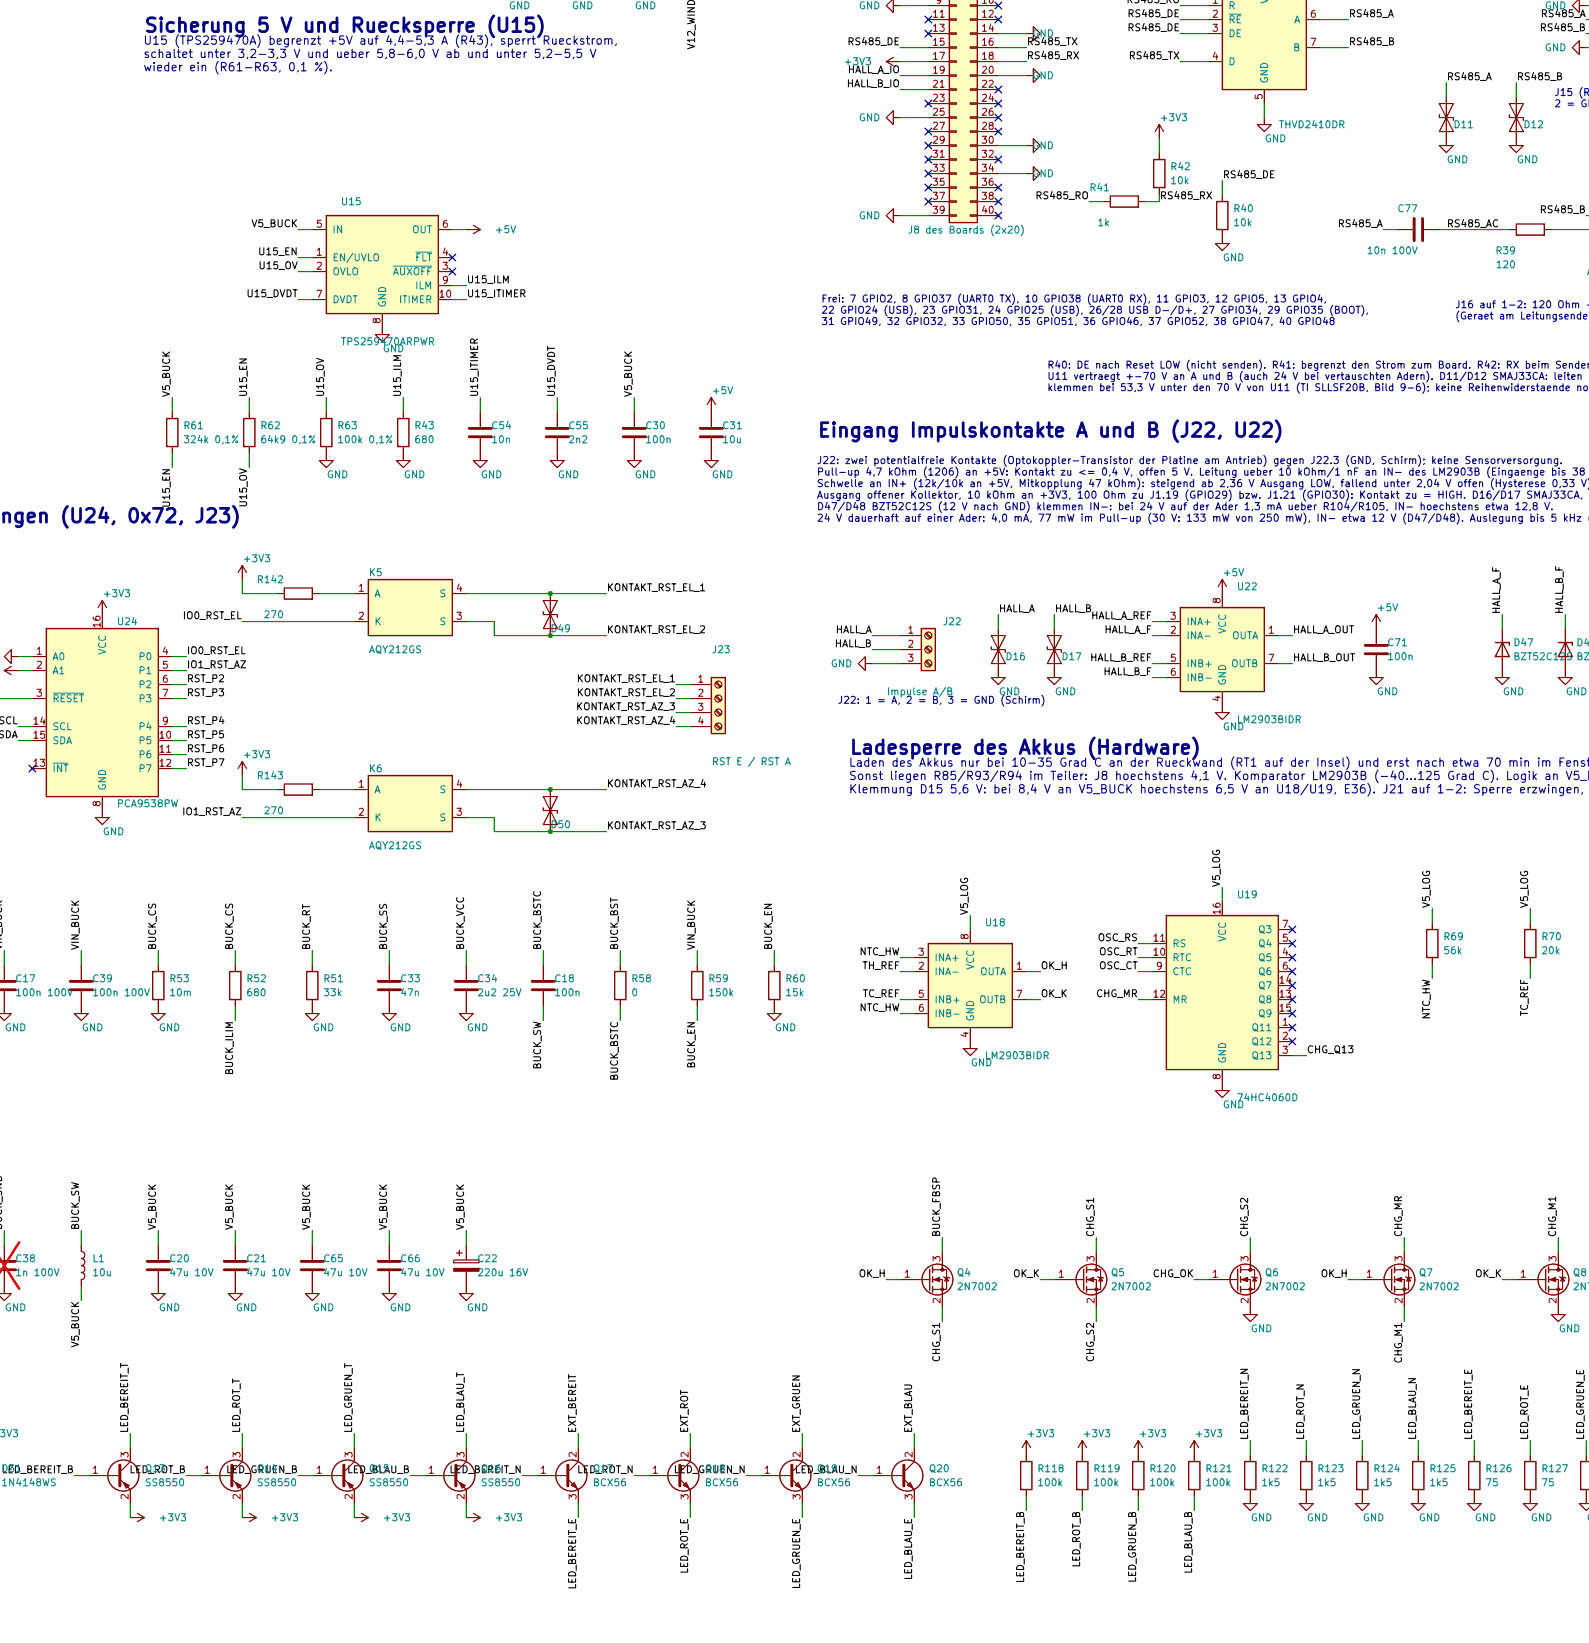
[picture p214: schematic RearCircuitBoard_10.kicad_sch, Samba Solar Track - RearCircuitBoard_10, part in row 2, column 2]

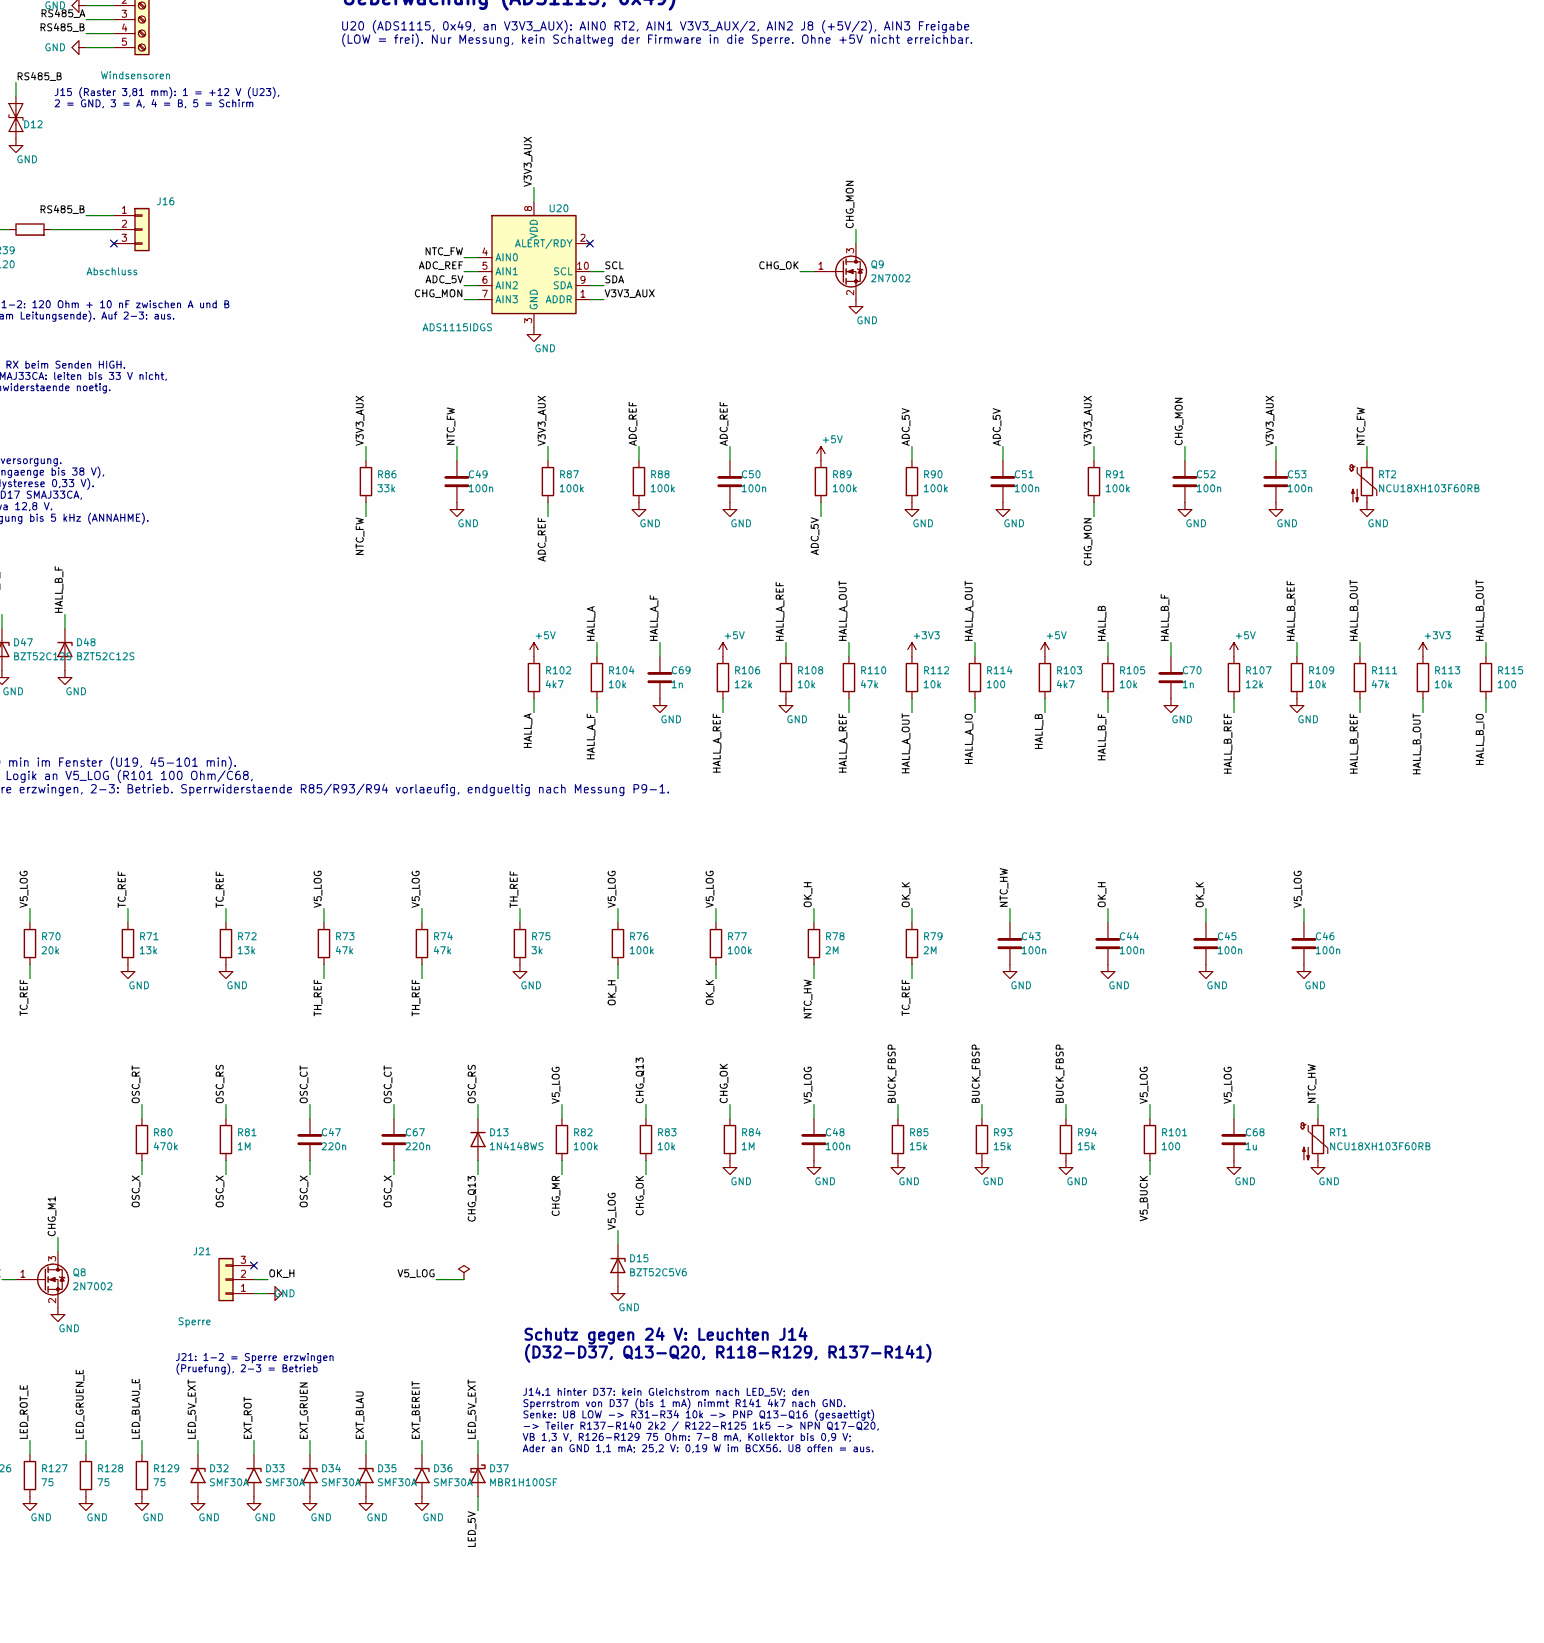
[picture p215: schematic RearCircuitBoard_10.kicad_sch, Samba Solar Track - RearCircuitBoard_10, part in row 2, column 3]

Parts:
C1, C13, C26, C27: 10u; C_0603_1608Metric; LCSC C19702
C2, C3, C12, C18, C24, C25, C29, C30, C32, C42, C43, C44, C45, C46, C48, C49, C50, C51, C52, C53, C71, C78: 100n; C_0603_1608Metric; LCSC C14663
C4, C5, C6, C7, C8, C9, C10, C11: 4n7; C_0603_1608Metric; LCSC C53987
C14: 100u 63V; CP_Elec_8x10; LCSC C487384
C15, C16, C56, C57, C58, C59, C60, C61, C72: 2u2 100V; C_1206_3216Metric; LCSC C16195971
C17, C39, C41: 100n 100V; C_0805_2012Metric; LCSC C3011698
C20, C21, C65, C66: 47u 10V; C_1210_3225Metric; LCSC C7198516
C22: 220u 16V; CP_Elec_6.3x7.7; LCSC C709481
C28, C75, C76: 22u 25V; C_1206_3216Metric; LCSC C12891
C31: 10u; C_0603_1608Metric; LCSC C2959727
C33, C40: 47n; C_0603_1608Metric; LCSC C1622
C34: 2u2 25V; C_0805_2012Metric; LCSC C19110
C35: 22n; C_0603_1608Metric; LCSC C21122
C36: 22p; C_0603_1608Metric; LCSC C1653
C37, C63, C69, C70: 1n; C_0603_1608Metric; LCSC C1588
C38: 1n 100V; C_0603_1608Metric; LCSC C43847; not fitted
C47, C67: 220n; C_0603_1608Metric; LCSC C21120
C54, C62, C64: 10n; C_0603_1608Metric; LCSC C57112
C55: 2n2; C_0603_1608Metric; LCSC C1604
C68, C74: 1u; C_0603_1608Metric; LCSC C15849
C73: 100n 100V; C_0402_ohne_Druck; LCSC C3869216
C77: 10n 100V; C_0402_ohne_Druck; LCSC C527014
D1, D2, D3, D4, D11, D12, D16, D17, D49, D50: SMAJ33CA; D_SMA; LCSC C115251
D5: SS10P6; TO-277A; LCSC C2927414
D6: SMBJ30A; D_SMB; LCSC C113998
D9: gruen (BEREIT); LED_0805_2012Metric; LCSC C2297
D10: RGB (FAIL); LED_RGB_PLCC4_S4-3528RGBTA; LCSC C2827321
D13, D24, D25, D26, D27, D28, D29, D30, D31, D43, D44, D45, D46: 1N4148WS; D_SOD-323; LCSC C2128
D14: BZT52C5V1; D_SOD-123; LCSC C173407
D15: BZT52C5V6; D_SOD-123; LCSC C19077402
D18, D37: MBR1H100SF; D_SOD-123F; LCSC C235757
D19, D20, D21, D22, D23, D32, D33, D34, D35, D36, D38, D39, D40, D41, D42: SMF30A; D_SOD-123F; LCSC C364281
D47, D48: BZT52C12S; D_SOD-323; LCSC C19077447
F1: BSMD2920-200-60V; Fuse_2920_7451Metric; LCSC C49233174
H1, H2, H3, H4: M2.5; MountingHole_3mm
J1: J8 des Boards (2x20); PinHeader_2x20_P2.54mm_Unterseite
J2: Sonnensensor; Klemme_3.5_6P_KF2EDGR; LCSC C441175
J3: Elevation RAUF; Klemme_3.5_2x2P_KF2EDGSR; LCSC C2923260
J4: Elevation RUNTER; Klemme_3.5_2x2P_KF2EDGSR; LCSC C2923260
J5: Azimut OST; Klemme_3.5_2x3P_KF2EDGSR; LCSC C2923261
J6: Azimut WEST; Klemme_3.5_2x3P_KF2EDGSR; LCSC C2923261
J7: Endschalter EL_OBEN; Klemme_3.5_2P_KF2EDGR; LCSC C441171
J8: Endschalter EL_UNTEN; Klemme_3.5_2P_KF2EDGR; LCSC C441171
J9: Endschalter AZ_OST; Klemme_3.5_2P_KF2EDGR; LCSC C441171
J10: Endschalter AZ_WEST; Klemme_3.5_2P_KF2EDGR; LCSC C441171
J11: 24 V Eingang; Klemme_5.08_2P_KF2EDGRC; LCSC C441236
J14: Leuchten BEREIT und FAIL; Klemme_3.5_5P_KF2EDGR; LCSC C441174
J15: Windsensoren; Klemme_3.81_5P_KF2EDGR; LCSC C441185
J16: Abschluss; PinHeader_1x03_P2.54mm_Vertical; LCSC C2937625
J21: Sperre; PinHeader_1x03_P2.54mm_Vertical; LCSC C2937625
J22: Impulse A/B; Klemme_3.5_3P_KF2EDGR; LCSC C441172
J23: RST E / RST A; Klemme_3.5_4P_KF2EDGR; LCSC C441173
K1, K2, K3, K4, K5, K6: AQY212GS; SOP-4_4.4x4.3mm_P2.54mm_Panasonic; LCSC C415471
L1: 10u; L_Wuerth_WE-LHMI_1040; LCSC C1519857
Q1, Q11, Q12: MMBT3904; SOT-23; LCSC C20526
Q2, Q3: CSD18543Q3A; TI_DNH0008A_CSD18543Q3A; LCSC C840100
Q4, Q5, Q6, Q7, Q8, Q9: 2N7002; SOT-23; LCSC C8545
Q10, Q13, Q14, Q15, Q16, Q22: SS8550; SOT-23; LCSC C8542
Q17, Q18, Q19, Q20: BCX56; SOT-89-3; LCSC C24280
Q21: SSM3J351R; SOT-23; LCSC C150147
R1, R2, R3, R4, R130, R131, R132, R133: 100; R_1210_3225Metric; LCSC C620661
R5, R6, R7, R8, R13, R14, R15, R16, R100, R136: 22k; R_0603_1608Metric; LCSC C31850
R9, R10, R11, R12, R27, R29, R137, R138, R139, R140: 2k2; R_0603_1608Metric; LCSC C4190
R17, R18, R19, R20, R142, R143: 270; R_0603_1608Metric; LCSC C22966
R21, R31, R32, R33, R34, R35, R36, R40, R42, R48, R66, R83, R99, R104, R105, R108, R109, R112, R113, R144, R145, R146, R147, R148, R149, R150: 10k; R_0603_1608Metric; LCSC C25804
R22, R26: 200k; R_0603_1608Metric; LCSC C25811
R24: 79k6 0,1%; R_0603_1608Metric; LCSC C861560
R25: 15k 0,1%; R_0603_1608Metric; LCSC C326733
R28, R30, R41, R55: 1k; R_0603_1608Metric; LCSC C21190
R39: 120; R_0805_2012Metric; LCSC C17437
R43, R52: 680; R_0603_1608Metric; LCSC C23228
R45, R46, R50, R76, R77, R82, R87, R88, R89, R90, R91, R116, R118, R119, R120, R121, R134: 100k; R_0603_1608Metric; LCSC C25803
R47, R106, R107: 12k; R_0603_1608Metric; LCSC C22790
R49, R73, R74, R98, R110, R111: 47k; R_0603_1608Metric; LCSC C25819
R51, R68, R86, R95: 33k; R_0603_1608Metric; LCSC C4216
R53: 10m; R_1206_3216Metric; LCSC C2076185
R54, R117: 9k1; R_0603_1608Metric; LCSC C23260
R58: 0; R_0603_1608Metric; LCSC C21189
R59: 150k; R_0603_1608Metric; LCSC C22807
R60, R85, R93, R94: 15k; R_0603_1608Metric; LCSC C22809
R61: 324k 0,1%; R_0603_1608Metric; LCSC C3999394
R62: 64k9 0,1%; R_0603_1608Metric; LCSC C861510
R63: 100k 0,1%; R_0603_1608Metric; LCSC C122538
R64, R97: 6k8; R_0603_1608Metric; LCSC C23212
R65: 300k; R_0603_1608Metric; LCSC C23024
R67: 332k; R_0603_1608Metric; LCSC C23139
R69: 56k; R_0603_1608Metric; LCSC C23206
R70: 20k; R_0603_1608Metric; LCSC C4184
R71, R72: 13k; R_0603_1608Metric; LCSC C22797
R75: 3k; R_0603_1608Metric; LCSC C4211
R78, R79: 2M; R_0603_1608Metric; LCSC C22976
R80, R135: 470k; R_0603_1608Metric; LCSC C23178
R81, R84: 1M; R_0603_1608Metric; LCSC C22935
R92: 2R2; R_1206_3216Metric; LCSC C25369; not fitted
R96: 8k2; R_0603_1608Metric; LCSC C25981
R101, R114, R115: 100; R_0603_1608Metric; LCSC C22775
R102, R103: 4k7; R_1206_3216Metric; LCSC C17936
R122, R123, R124, R125: 1k5; R_0603_1608Metric; LCSC C22843
R126, R127, R128, R129: 75; R_0603_1608Metric; LCSC C4275
R141: 4k7; R_0603_1608Metric; LCSC C23162
RT1, RT2: NCU18XH103F60RB; R_0603_1608Metric; LCSC C440252
U1, U20: ADS1115IDGS; VSSOP-10_3x3mm_P0.5mm; LCSC C37593
U2, U8, U24: PCA9538PW; TSSOP-16_4.4x5mm_P0.65mm; LCSC C201530
U5, U9: TPS2553DBV; SOT-23-6; LCSC C55266
U7: LM5146QRGYTQ1; TI_RGY0020B_VQFN-20_Vias; LCSC C2876733
U11: THVD2410DR; SOIC-8_3.9x4.9mm_P1.27mm; LCSC C1849398
U12: AP7361C-33Y5-13; SOT-89-5; LCSC C460397
U15: TPS259470ARPWR; TI_RPW0010A_VQFN-HR-10; LCSC C3662799
U16: TPS26600PWPR; TI_PWP0016A_HTSSOP-16_Vias; LCSC C544399
U17: TMP390A2DRLR; SOT-563; LCSC C5219772
U18, U22: LM2903BIDR; SOIC-8_3.9x4.9mm_P1.27mm; LCSC C2869804
U19: 74HC4060D; SOIC-16_3.9x9.9mm_P1.27mm; LCSC C5649
U21: TLV431BIDBZR; SOT-23; LCSC C398375
U23: TPSM365R6RDNR; TI_RDN0011A_QFN-FCMOD-11; LCSC C20346008

Connections:
+3V3: C1.1, C2.1, C3.1, C24.1, C29.1, C78.1, D28.1 (K), D29.1 (K), D30.1 (K), D31.1 (K), D43.1 (K), D44.1 (K), D45.1 (K), D46.1 (K), J1.1, J1.17, Q13.2 (E), Q14.2 (E), Q15.2 (E), Q16.2 (E), R9.1, R10.1, R11.1, R12.1, R17.1, R18.1, R19.1, R20.1, R21.1, R35.1, R36.1, R42.1, R48.2, R112.1, R113.1, R118.1, R119.1, R120.1, R121.1, R142.1, R143.1, R150.2, U1.8 (VDD), U2.16 (VCC), U5.3 (EN), U8.1 (A0), U8.16 (VCC), U9.3 (EN), U11.8 (VCC), U24.2 (A1), U24.16 (VCC)
+5V: C25.1, C27.1, C31.1, C71.1, J1.2, J1.4, R89.1, R102.1, R103.1, R106.1, R107.1, U9.1 (IN), U12.1 (EN), U12.4 (IN), U15.6 (OUT), U22.8 (VCC)
/ADC_5V: C51.1, R89.2, R90.1, U20.6 (AIN2)
/ADC_REF: C50.1, R87.2, R88.1, U20.5 (AIN1)
/AIN0: C4.1, D43.2 (A), R5.2, U1.4 (AIN0)
/AIN1: C5.1, D44.2 (A), R6.2, U1.5 (AIN1)
/AIN2: C6.1, D45.2 (A), R7.2, U1.6 (AIN2)
/AIN3: C7.1, D46.2 (A), R8.2, U1.7 (AIN3)
/BUCK_BST: R58.1, U7.17 (BST)
/BUCK_BSTC: C18.1, R58.2
/BUCK_CC1: C35.2, R54.2
/BUCK_CC3: C37.2, R55.2
/BUCK_COMP: C36.1, R54.1, U7.4 (COMP)
/BUCK_CS: Q3.1 (S), Q3.2 (S), Q3.3 (S), R52.1, R53.1
/BUCK_EN: R59.2, R60.1, U7.1 (EN/UVLO)
/BUCK_FB: C35.1, C36.2, R24.2, R25.1, R55.1, U7.5 (FB)
/BUCK_FBSP: Q4.3 (D), R25.2, R85.1, R93.1, R94.1
/BUCK_HO: Q2.4 (G), U7.18 (HO)
/BUCK_ILIM: R52.2, U7.11 (ILIM)
/BUCK_LO: Q3.4 (G), U7.13 (LO)
/BUCK_RT: R51.1, U7.2 (RT)
/BUCK_SNB: C38.1, R92.2
/BUCK_SS: C33.1, U7.3 (SS/TRK)
/BUCK_SW: C18.2, L1.1, Q2.1 (S), Q2.2 (S), Q2.3 (S), Q3.5 (D), R92.1, U7.19 (SW)
/BUCK_VCC: C34.1, U7.14 (VCC)
/CHG_M1: Q7.2 (S), Q8.3 (D)
/CHG_MON: C52.1, Q9.3 (D), R91.2, U20.7 (AIN3)
/CHG_MR: Q7.3 (D), R82.2, U19.12 (MR)
/CHG_OK: Q6.1 (G), Q9.1 (G), R83.2, R84.1
/CHG_Q13: D13.2 (A), R83.1, U19.3 (Q13)
/CHG_S1: Q4.2 (S), Q5.3 (D)
/CHG_S2: Q5.2 (S), Q6.3 (D)
/DET_B: C32.1, Q1.1 (B), R46.2, R47.1
/DET_M: R45.2, R46.1
/EF_DVDT: C40.1, U16.12 (dVdT)
/EF_ILIM: R64.1, U16.11 (ILIM)
/EF_OVP: R65.2, R66.1, U16.5 (OVP)
/EF_SHDN: C62.1, Q12.3 (C), U16.7 (~SHDN), U17.6 (OUTA)
/END_AZ_OST: D22.1 (A1), D26.1 (K), J9.1, R15.1
/END_AZ_OST_PU: D26.2 (A), R11.2
/END_AZ_WEST: D23.1 (A1), D27.1 (K), J10.1, R16.1
/END_AZ_WEST_PU: D27.2 (A), R12.2
/END_EL_OBEN: D20.1 (A1), D24.1 (K), J7.1, R13.1
/END_EL_OBEN_PU: D24.2 (A), R9.2
/END_EL_UNTEN: D21.1 (A1), D25.1 (K), J8.1, R14.1
/END_EL_UNTEN_PU: D25.2 (A), R10.2
/EXT_BEREIT: D36.1 (A1), J14.5, Q17.2 (C)
/EXT_BLAU: D35.1 (A1), J14.4, Q20.2 (C)
/EXT_GRUEN: D34.1 (A1), J14.3, Q19.2 (C)
/EXT_ROT: D33.1 (A1), J14.2, Q18.2 (C)
/FAULT_LED_N: R36.2, U8.10 (P5), U9.4 (~FAULT)
/FAULT_SENS_N: R35.2, U5.4 (~FAULT), U8.9 (P4)
/HALL_A: D16.2 (A2), J22.1, R102.2, R104.1
/HALL_A_F: C69.1, D47.1 (K), R104.2, U22.2 (INA-)
/HALL_A_IO: J1.19, R114.2
/HALL_A_OUT: R110.1, R112.2, R114.1, U22.1 (OUTA)
/HALL_A_REF: R106.2, R108.1, R110.2, U22.3 (INA+)
/HALL_B: D17.2 (A2), J22.2, R103.2, R105.1
/HALL_B_F: C70.1, D48.1 (K), R105.2, U22.6 (INB-)
/HALL_B_IO: J1.21, R115.2
/HALL_B_OUT: R111.1, R113.2, R115.1, U22.7 (OUTB)
/HALL_B_REF: R107.2, R109.1, R111.2, U22.5 (INB+)
/IO0_EL_RAUF: K1.2 (K), U2.4 (P0)
/IO0_RST_EL: K5.2 (K), U24.4 (P0)
/IO1_EL_RUNTER: K2.2 (K), U2.5 (P1)
/IO1_RST_AZ: K6.2 (K), U24.5 (P1)
/IO2_AZ_OST: K3.2 (K), U2.6 (P2)
/IO3_AZ_WEST: K4.2 (K), U2.7 (P3)
/IO4_END_EL_OBEN: C8.1, D28.2 (A), R13.2, U2.9 (P4)
/IO5_END_EL_UNTEN: C9.1, D29.2 (A), R14.2, U2.10 (P5)
/IO6_END_AZ_OST: C10.1, D30.2 (A), R15.2, U2.11 (P6)
/IO7_END_AZ_WEST: C11.1, D31.2 (A), R16.2, U2.12 (P7)
/KONTAKT_AZ_OST_1: D3.1 (A1), J5.1, K3.3 (S)
/KONTAKT_AZ_OST_6: D3.2 (A2), J5.6, K3.4 (S)
/KONTAKT_AZ_WEST_2: D4.1 (A1), J6.2, K4.3 (S)
/KONTAKT_AZ_WEST_5: D4.2 (A2), J6.5, K4.4 (S)
/KONTAKT_EL_RAUF_1: D1.1 (A1), J3.1, K1.3 (S)
/KONTAKT_EL_RAUF_4: D1.2 (A2), J3.4, K1.4 (S)
/KONTAKT_EL_RUNTER_2: D2.1 (A1), J4.2, K2.3 (S)
/KONTAKT_EL_RUNTER_3: D2.2 (A2), J4.3, K2.4 (S)
/KONTAKT_RST_AZ_3: D50.1 (A1), J23.3, K6.3 (S)
/KONTAKT_RST_AZ_4: D50.2 (A2), J23.4, K6.4 (S)
/KONTAKT_RST_EL_1: D49.2 (A2), J23.1, K5.4 (S)
/KONTAKT_RST_EL_2: D49.1 (A1), J23.2, K5.3 (S)
/LED_5V: C26.1, D9.2 (A), D10.2 (A), D37.2 (A), R141.1, U9.6 (OUT)
/LED_5V_EXT: D32.1 (A1), D37.1 (K), J14.1
/LED_BEREIT: R27.1, R31.1, U8.4 (P0)
/LED_BEREIT_B: Q13.1 (B), R31.2, R118.2
/LED_BEREIT_E: Q17.3 (E), R126.1
/LED_BEREIT_N: Q17.1 (B), R122.1, R137.2
/LED_BEREIT_T: Q13.3 (C), R137.1
/LED_BLAU: R30.1, R34.1, U8.7 (P3)
/LED_BLAU_B: Q16.1 (B), R34.2, R121.2
/LED_BLAU_E: Q20.3 (E), R129.1
/LED_BLAU_N: Q20.1 (B), R125.1, R140.2
/LED_BLAU_T: Q16.3 (C), R140.1
/LED_GRUEN: R29.1, R33.1, U8.6 (P2)
/LED_GRUEN_B: Q15.1 (B), R33.2, R120.2
/LED_GRUEN_E: Q19.3 (E), R128.1
/LED_GRUEN_N: Q19.1 (B), R124.1, R139.2
/LED_GRUEN_T: Q15.3 (C), R139.1
/LED_ROT: R28.1, R32.1, U8.5 (P1)
/LED_ROT_B: Q14.1 (B), R32.2, R119.2
/LED_ROT_E: Q18.3 (E), R127.1
/LED_ROT_N: Q18.1 (B), R123.1, R138.2
/LED_ROT_T: Q14.3 (C), R138.1
/NTC_FW: C49.1, R86.2, RT2.1, U20.4 (AIN0)
/NTC_HW: C43.1, R69.2, R78.2, RT1.1, U18.3 (INA+), U18.6 (INB-)
/OK_H: C44.1, J21.2, Q4.1 (G), Q7.1 (G), R76.2, R78.1, U18.1 (OUTA)
/OK_K: C45.1, Q5.1 (G), Q8.1 (G), R77.2, R79.1, U18.7 (OUTB)
/OSC_CT: C47.1, C67.1, U19.9 (CTC)
/OSC_RS: D13.1 (K), R81.1, U19.11 (RS)
/OSC_RT: R80.1, U19.10 (RTC)
/OSC_X: C47.2, C67.2, R80.2, R81.2
/OV_B: Q10.1 (B), R97.1, R99.2, U21.2 (K)
/OV_H: Q11.3 (C), R99.1
/OV_K: C64.1, Q10.3 (C), Q11.1 (B), R98.1, R100.2
/OV_Q: Q12.1 (B), R100.1
/OV_REF: C63.1, R95.1, R96.1, U21.1 (REF)
/RESET_N: R21.2, U2.3 (~RESET), U8.3 (~RESET)
/RS485_A: C77.1, D11.2 (A2), J15.3, U11.6 (A)
/RS485_AC: C77.2, R39.1
/RS485_B: D12.2 (A2), J15.4, J16.1, U11.7 (B)
/RS485_DE: J1.15, R40.1, U11.2 (~RE), U11.3 (DE)
/RS485_RO: R41.1, U11.1 (R)
/RS485_RX: J1.18, R41.2, R42.2
/RS485_TX: J1.16, U11.4 (D)
/RST_P2: R144.1, U24.6 (P2)
/RST_P3: R145.1, U24.7 (P3)
/RST_P4: R146.1, U24.9 (P4)
/RST_P5: R147.1, U24.10 (P5)
/RST_P6: R148.1, U24.11 (P6)
/RST_P7: R149.1, U24.12 (P7)
/SCL: J1.5, U1.10 (SCL), U2.14 (SCL), U8.14 (SCL), U20.10 (SCL), U24.14 (SCL)
/SDA: J1.3, U1.9 (SDA), U2.15 (SDA), U8.15 (SDA), U20.9 (SDA), U24.15 (SDA)
/SENS_3V3: C13.1, Q21.3 (D), R135.1, R136.1, U5.6 (OUT)
/SENS_3V3_EXT: D38.1 (A1), J2.1, Q21.2 (S), Q22.2 (E)
/SENS_GATE: Q21.1 (G), Q22.3 (C), R134.1
/SENS_PB: Q22.1 (B), R135.2
/SUN_NORD: D42.1 (A1), J2.5, R4.1, R8.1
/SUN_NORD_M: R4.2, R133.1
/SUN_OST: D39.1 (A1), J2.2, R1.1, R5.1
/SUN_OST_M: R1.2, R130.1
/SUN_SUED: D41.1 (A1), J2.4, R3.1, R7.1
/SUN_SUED_M: R3.2, R132.1
/SUN_WEST: D40.1 (A1), J2.3, R2.1, R6.1
/SUN_WEST_M: R2.2, R131.1
/TC_REF: R70.2, R71.1, R72.1, R79.2, U18.5 (INB+)
/TH_REF: R73.2, R74.2, R75.1, U18.2 (INA-)
/TMP_SETA: R67.1, U17.1 (SETA)
/TMP_VDD: C42.1, D14.1 (K), Q10.2 (E), R68.2, R97.2, U17.5 (VDD)
/U15_DVDT: C55.1, U15.7 (DVDT)
/U15_EN: R61.2, R62.1, U15.1 (EN/UVLO)
/U15_ILM: R43.1, U15.9 (ILM)
/U15_ITIMER: C54.1, U15.10 (ITIMER)
/U15_OV: R62.2, R63.1, U15.2 (OVLO)
/V3V3_AUX: C12.1, C28.1, C53.1, R86.1, R87.1, R91.1, U5.1 (IN), U12.5 (OUT), U20.1 (ADDR), U20.8 (VDD)
/V5_BUCK: C20.1, C21.1, C22.1, C30.1, C37.1, C65.1, C66.1, L1.2, R24.1, R49.1, R61.1, R95.2, R101.2, U15.5 (IN)
/V5_LOG: C46.1, C48.1, C68.1, D15.1 (K), R69.1, R70.1, R73.1, R74.1, R76.1, R77.1, R82.1, R101.1, U18.8 (VCC), U19.16 (VCC)
/V5_OK: R49.2, R50.1, U8.12 (P7)
/V12_WIND: C75.1, C76.1, D18.2 (A), R116.1, U23.4 (VOUT)
/V24: C14.1, C41.1, C72.1, C73.1, D5.3 (K), D6.1 (A1), R45.1, R65.1, R68.1, U16.1 (IN), U16.2 (IN), U23.2 (EN), U23.3 (VIN)
/V24_IN: F1.1, J11.1
/V24_OK_N: Q1.3 (C), R48.1, U8.11 (P6)
/VIN_BUCK: C15.1, C16.1, C17.1, C39.1, C58.1, C60.1, Q2.5 (D), R59.1, U7.20 (VIN), U16.15 (OUT), U16.16 (OUT)
/VIN_P1: C15.2, C56.1
/VIN_P2: C16.2, C57.1
/VIN_P3: C58.2, C59.1
/VIN_P4: C60.2, C61.1
/W12_FB: R116.2, R117.1, U23.9 (FB)
/W12_VCC: C74.1, U23.8 (VCC)
/WIND_12V: D18.1 (K), D19.1 (A1), J15.1
GND: C1.2, C2.2, C3.2, C4.2, C5.2, C6.2, C7.2, C8.2, C9.2, C10.2, C11.2, C12.2, C13.2, C14.2, C17.2, C20.2, C21.2, C22.2, C24.2, C25.2, C26.2, C27.2, C28.2, C29.2, C30.2, C31.2, C32.2, C33.2, C34.2, C38.2, C39.2, C40.2, C41.2, C42.2, C43.2, C44.2, C45.2, C46.2, C48.2, C49.2, C50.2, C51.2, C52.2, C53.2, C54.2, C55.2, C56.2, C57.2, C59.2, C61.2, C62.2, C63.2, C64.2, C65.2, C66.2, C68.2, C69.2, C70.2, C71.2, C72.2, C73.2, C74.2, C75.2, C76.2, C78.2, D6.2 (A2), D11.1 (A1), D12.1 (A1), D14.2 (A), D15.2 (A), D16.1 (A1), D17.1 (A1), D19.2 (A2), D20.2 (A2), D21.2 (A2), D22.2 (A2), D23.2 (A2), D32.2 (A2), D33.2 (A2), D34.2 (A2), D35.2 (A2), D36.2 (A2), D38.2 (A2), D39.2 (A2), D40.2 (A2), D41.2 (A2), D42.2 (A2), D47.2 (A), D48.2 (A), J1.6, J1.9, J1.14, J1.20, J1.25, J1.30, J1.34, J1.39, J2.6, J7.2, J8.2, J9.2, J10.2, J11.2, J15.2, J15.5, J21.1, J22.3, Q1.2 (E), Q6.2 (S), Q8.2 (S), Q9.2 (S), Q11.2 (E), Q12.2 (E), R22.2, R26.2, R40.2, R43.2, R47.2, R50.2, R51.2, R53.2, R60.2, R63.2, R64.2, R66.2, R67.2, R71.2, R72.2, R75.2, R84.2, R85.2, R88.2, R90.2, R93.2, R94.2, R96.2, R98.2, R108.2, R109.2, R117.2, R122.2, R123.2, R124.2, R125.2, R126.2, R127.2, R128.2, R129.2, R130.2, R131.2, R132.2, R133.2, R134.2, R136.2, R141.2, R144.2, R145.2, R146.2, R147.2, R148.2, R149.2, RT1.2, RT2.2, U1.1 (ADDR), U1.3 (GND), U2.1 (A0), U2.2 (A1), U2.8 (GND), U5.2 (GND), U7.6 (AGND), U7.8 (SYNCIN), U7.12 (PGND), U7.15 (EP), U7.21 (PAD), U8.2 (A1), U8.8 (GND), U9.2 (GND), U11.5 (GND), U12.2 (GND), U15.8 (GND), U16.3 (UVLO), U16.8 (RTN), U16.9 (GND), U16.17 (RTN), U17.2 (SETB), U17.3 (GND), U18.4 (GND), U19.8 (GND), U20.3 (GND), U21.3 (A), U22.4 (GND), U23.10 (GND), U23.11 (RT), U24.1 (A0), U24.8 (GND)
unnamed: D5.1 (A), D5.2 (A), F1.2
unnamed: D9.1 (K), R27.2
unnamed: D10.1 (BK), R30.2
unnamed: D10.3 (GK), R29.2
unnamed: D10.4 (RK), R28.2
unnamed: J16.2, R39.2
unnamed: K1.1 (A), R17.2
unnamed: K2.1 (A), R18.2
unnamed: K3.1 (A), R19.2
unnamed: K4.1 (A), R20.2
unnamed: K5.1 (A), R142.2
unnamed: K6.1 (A), R143.2
unnamed: R22.1, U5.5 (ILIM)
unnamed: R26.1, U9.5 (ILIM)
unnamed: R150.1, U24.3 (~RESET)

Notes on the sheet:
3,3 V vom Board (Bereich 1) und zweiter 3,3-V-Bereich
Bereich 1 kommt ueber J1 (Pins 1 und 17) vom Board: ADS1115, beide PCA9538, PhotoMOS, Pull-ups, RS485-Transceiver. Board aus -> alle Kontakte offen. Bereich 2 (V3V3_AUX) aus U12 fuer die Sensorversorgung U5 und U20; U12 laeuft, solange +5V anliegt (EN an IN), U5 schaltet mit dem Board ab (EN an Ber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
C1: Puffer, C2: am ADS1115, C3: am PCA9538
U5 begrenzt den Strom zum Sonnensensor: R22 = 200 k ergibt 116 bis 158 mA (typ. 135 mA). FAULT_SENS_N: LOW bei Ueberstrom oder Uebertemperatur, geht an IO4 des PCA9538 U8. U5: Eingang aus V3V3_AUX (zweiter 3,3-V-Bereich), EN an den 3,3 V des Boards.
Sonnensensor: 4 Messeingaenge am ADS1115
Leitung bis 15 m. 200 Ohm Last laut Hersteller des Sensors (seit 03.11.2026 als 2 x 100 Ohm 1210, haelt 12 V dauerhaft; 24 V zerstoeren nur R1-R4 und R130-R133), 22 k + 4,7 n als Schutz und Filter, TVS SMF30A je Ader an der Klemme, Klemmdioden an +3V3 vor dem ADS1115. J2.1 ueber die Ruecksperre Q21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
Adern des Sensors an J2: 1 schwarz (3,3 V, strombegrenzt) 2 rot (Ost) 3 weiss (West) 4 gelb (Sued) 5 gruen (Nord) 6 Schirm (nur hier an GND)
ADDR an GND: I2C-Adresse 0x48
Schutz gegen 12/24 V an J2: Block rechts oben (D38-D46, Q21, Q22, R130-R136)
Schutz gegen 12/24 V an J2, Sonnensensor (03.11.2026)
TVS SMF30A an jeder Ader (D38-D42), Klemmdioden an +3V3 vor dem ADS1115 (D43-D46). 24 V auf einer Messader: 0,95 mA ueber 22 k in +3V3, Eingang von U1 etwa 3,9 V: ueber dem Spannungs-Grenzwert VDD + 0,3 V, aber Strom 0,97 mA <= 10 mA (SBAS444E 5.1/7.3.2: Reihenwiderstand + Klemmdiode). R1-R4/R130-R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
R130-R133: zweite Haelfte der Buerde (mit R1-R4), je 100 Ohm 1210 0,5 W
R137-R140: Teiler der Senken (unten), R141: LED_5V/GND
Endschalter: 4 Eingaenge am PCA9538
Oeffner (NC) gegen GND. Geschlossen = LOW = Fahrt erlaubt; offen oder Kabelbruch = HIGH = gesperrt.
Schutz je Ader im Abschnitt 'Schutz gegen 24 V' (unten): TVS SMF30A an der Klemme (D20-D23), Pull-up ueber 1N4148WS (D24-D27, sperrt 24 V von +3V3 weg), 22 kOhm und Klemmdiode an +3V3 (D28-D31). Dauerhaft 24 V auf einer Ader: etwa 1 mA ueber 22 kOhm in +3V3, kein Bauteil ueberlastet.
Ein-/Ausgaenge: PCA9538, I2C-Adresse 0x70
Nach Reset sind alle Pins Eingaenge (hochohmig): Leuchtdioden der PhotoMOS aus, alle Kontakte offen.
Schaltausgaenge: 4 potentialfreie Kontakte (PhotoMOS)
LOW am Pin des PCA9538 = Leuchtdiode an = Kontakt geschlossen. Kontakt: max. 30 V, 1 A (D1-D4 leiten ab 33 V). Ueber die Platine fliesst kein Motorstrom. D1-D4: Schutzdiode SMAJ33CA ueber jedem Kontakt.
Befestigung: 4 Bohrungen 3,0 mm fuer M2,5
Befestigung (Entscheidung 4.10.2026): M2,5-Abstandsbolzen statt der vier Schrauben der Hauptplatine, Platine darauf. ANNAHME bis zur Messung: Laenge von J1 und Hoehe der Bolzen. Alle Bauteile ausser J1 mit JLCPCB-Nummer (LCSC). Klemmen steckbar, 3,5 mm; J11 5,08 mm mit Stirnwaenden; J15 3,81 mm; Ko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
Stromversorgung: 24-V-Eingang und elektronische Sicherung (U16, U17)
Einzige Versorgung der Steuerung. F1 Sicherung (selbstrueckstellend, 2 A), D5 Verpolschutz (SS10P6), D6 Ueberspannungsschutz. U16 (TPS26600): Abschaltung nach 4 ms ueber 1,57-1,88 A, Neuversuch nach 0,54 s; ein ab 14,9 V. Die OVP von U16 (R65/R66: 35,6-38,7 V) liegt ueber dem Durchbruch von D6 (33,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
J11: 1 = +24 V, 2 = Minus
Sicherung 5 V und Ruecksperre (U15)
U15 (TPS259470A) begrenzt +5V auf 4,4-5,3 A (R43), sperrt Rueckstrom, schaltet unter 3,2-3,3 V und ueber 5,8-6,0 V ab und unter 5,2-5,5 V wieder ein (R61-R63, 0,1 %).
5-V-Wandler LM5146 (U7) mit Q2/Q3
U7 LM5146: 303 kHz (R51), Sanftanlauf 3,8 ms (C33), Start ab 13,2 V (R59/R60), Talstromgrenze 5,7-8,4 A (R52/R53), Hiccup nach 128 Takten. Ausgang 0,8 V x (1 + R24/R25) = 5,05 V (R24/R25 0,1 %); in der Ladesperre R85 || R93 || R94 in Reihe zu R25: 3,98 V. Eingang als Reihenpaare; Ausgang 4 x 47 uF 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
Meldeleuchten und Ueberwachung der Strombegrenzer
BEREIT (gruen) und FAIL (RGB). Jede Leuchte gibt es zweimal: auf der Platine und als Anschluss fuer eine Leuchte im Gehaeuse. Die Leuchten haengen an 5 V. Pin des PCA9538 als Ausgang auf LOW = an, Pin als Eingang (hochohmig) = aus. Derselbe PCA9538 liest die Stoerungsausgaenge der beiden Strombegre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
U9 begrenzt den Strom der Leuchten auf 116 bis 158 mA (R26 = 200 k). FAULT_LED_N geht an IO5 von U8.
PCA9538, I2C-Adresse 0x71 (A0 an 3,3 V, A1 an GND)
IO4, IO5: Stoerungsausgaenge der Strombegrenzer U5 und U9 (LOW = Stoerung). IO6: 24 V vorhanden (LOW = vorhanden), IO7: 5 V vorhanden (HIGH = vorhanden).
Leuchten auf der Platine
Anschluesse fuer Leuchten im Gehaeuse
Leuchtdioden ohne eingebauten Vorwiderstand; FAIL mit gemeinsamer Anode (gemeinsamer Pluspol). Seit 03.11.2026 schaltet je Ader eine Konstantstromsenke (Abschnitt 'Schutz gegen 24 V' unten): U8 LOW -> PNP Q13-Q16 -> NPN Q17-Q20 mit 300 Ohm im Emitter (etwa 8 mA), 24 V auf der Ader schadet nicht. J1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
J14: 1 = Plus beider Leuchten (Anoden), 2 = Rot, 3 = Gruen, 4 = Blau (FAIL), 5 = BEREIT
Schutz gegen 24 V: Endschalter J7-J10 (D20-D31)
TVS SMF30A an der Klemme (leitet unter 30 V nicht), Pull-up ueber 1N4148WS (sperrt 24 V von +3V3 weg; HIGH etwa 2,7 V), 22 kOhm (R13-R16) und Klemmdiode an +3V3: bei 25,2 V auf der Ader 0,97 mA ueber 22 kOhm in +3V3, Eingang von U2 etwa 3,9 V (zulaessig 6 V). Filter 22 kOhm/4,7 nF = 0,10 ms wie vor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
Schutz gegen 24 V: Leuchten J14 (D32-D37, Q13-Q20, R118-R129, R137-R141)
J14.1 hinter D37: kein Gleichstrom nach LED_5V; den Sperrstrom von D37 (bis 1 mA) nimmt R141 4k7 nach GND. Senke: U8 LOW -> R31-R34 10k -> PNP Q13-Q16 (gesaettigt) -> Teiler R137-R140 2k2 / R122-R125 1k5 -> NPN Q17-Q20, VB 1,3 V, R126-R129 75 Ohm: 7-8 mA, Kollektor bis 0,9 V; Ader an GND 1,1 mA; 25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
Anschluss an J8 des Boards und RS485 fuer den Windmesser
J1: Stiftleiste 2 x 20 mit langen Stiften (von Hand), gesteckt durch den Schlitz der Rueckwand in J8. Zaehlung wie Planung 3.5 (Pin 1 = 3,3 V); massgeblich ist die Lage, vor der Bestellung am Geraet pruefen.
Frei: 7 GPIO2, 8 GPIO37 (UART0 TX), 10 GPIO38 (UART0 RX), 11 GPIO3, 12 GPIO5, 13 GPIO4, 22 GPIO24 (USB), 23 GPIO31, 24 GPIO25 (USB), 26/28 USB D-/D+, 27 GPIO34, 29 GPIO35 (BOOT), 31 GPIO49, 32 GPIO32, 33 GPIO50, 35 GPIO51, 36 GPIO46, 37 GPIO52, 38 GPIO47, 40 GPIO48
J16 auf 1-2: 120 Ohm + 10 nF zwischen A und B (Geraet am Leitungsende). Auf 2-3: aus.
J15 (Raster 3,81 mm): 1 = +12 V (U23), 2 = GND, 3 = A, 4 = B, 5 = Schirm
R40: DE nach Reset LOW (nicht senden). R41: begrenzt den Strom zum Board. R42: RX beim Senden HIGH. U11 vertraegt +-70 V an A und B (auch 24 V bei vertauschten Adern). D11/D12 SMAJ33CA: leiten bis 33 V nicht, klemmen bei 53,3 V unter den 70 V von U11 (TI SLLSF20B, Bild 9-6); keine Reihenwiderstaend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
Ueberspannungsabschaltung mit Selbsthaltung (U21, Q10-Q12)
U21 (TLV431B) ueberwacht V5_BUCK: ueber 6,0-6,5 V halten Q10/Q11 sich selbst und Q12 zieht SHDN von U16 auf GND. U16 bleibt aus, bis die 24 V abgeschaltet werden. Schuetzt das Tablet, wenn der Wandler ausfaellt (z. B. Q2 durchlegiert). Versorgung aus TMP_VDD.
Ladesperre des Akkus (Hardware)
Laden des Akkus nur bei 10-35 Grad C an der Rueckwand (RT1 auf der Insel) und erst nach etwa 70 min im Fenster (U19, 45-101 min). Sonst liegen R85/R93/R94 im Teiler: J8 hoechstens 4,1 V. Komparator LM2903B (-40...125 Grad C). Logik an V5_LOG (R101 100 Ohm/C68, Klemmung D15 5,6 V: bei 8,4 V an V5_BU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
J21: 1-2 = Sperre erzwingen (Pruefung), 2-3 = Betrieb
Ueberwachung (ADS1115, 0x49)
U20 (ADS1115, 0x49, an V3V3_AUX): AIN0 RT2, AIN1 V3V3_AUX/2, AIN2 J8 (+5V/2), AIN3 Freigabe (LOW = frei). Nur Messung, kein Schaltweg der Firmware in die Sperre. Ohne +5V nicht erreichbar.
Erkennung der Versorgung (IO6, IO7 von U8)
IO6 (U8 Pin 11): Q1 leitet ab etwa 11 V an V24 (sicher LOW ab 15,6 V, sicher HIGH bis 7,1 V), R45 + R46 in Reihe, damit ein kurzgeschlossener Widerstand keine 24 V an U8 legt. IO7 (U8 Pin 12): Teiler 47k/100k an V5_BUCK (Ausgang des Wandlers), HIGH auch in der Ladesperre (ab 3,93 V: IO7 >= 2,62 V),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
Eingang Impulskontakte A und B (J22, U22)
J22: zwei potentialfreie Kontakte (Optokoppler-Transistor der Platine am Antrieb) gegen J22.3 (GND, Schirm); keine Sensorversorgung. Pull-up 4,7 kOhm (1206) an +5V: Kontakt zu <= 0,4 V, offen 5 V. Leitung ueber 10 kOhm/1 nF an IN- des LM2903B (Eingaenge bis 38 V), Schwelle an IN+ (12k/10k an +5V, M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
J22: 1 = A, 2 = B, 3 = GND (Schirm)
Windsensoren 12 V (U23)
U23 TPSM365R6 (TI SNVSC83C): 3,6-65 V (70 V abs.), 0,6 A, Drossel eingebaut; aus V24 (hinter F1/D5/D6, bis 48,4 V). RT an GND: 2,2 MHz (Tab. 7-6: 12 V bei 24-48 V zulaessig, an der Obergrenze; bei <= 0,3 A ohne Folgen). Ausgang 1 V x (1 + 100k/9k1) = 12,0 V, an J15.1 nach D18 etwa 11,5 V (ANNAHME V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
Reset der Synchronsteuerungen (U24, 0x72, J23)
LOW an IO0/IO1 = Kontakt zu (wie K1-K4), nach Reset hochohmig = offen. A0 GND, A1 +3V3: 0x72. IO2-IO7 ohne Funktion, 10k nach GND. RESET: R150 10k nach +3V3. J23: 1-2 RST E, 3-4 RST A
