ssbingo/samba-solar-track/hardware/RearCircuitBoard_10/RearCircuitBoard_10.kicad_pcb

## KiCad design hardware/RearCircuitBoard_10/RearCircuitBoard_10.kicad_pcb (continued)

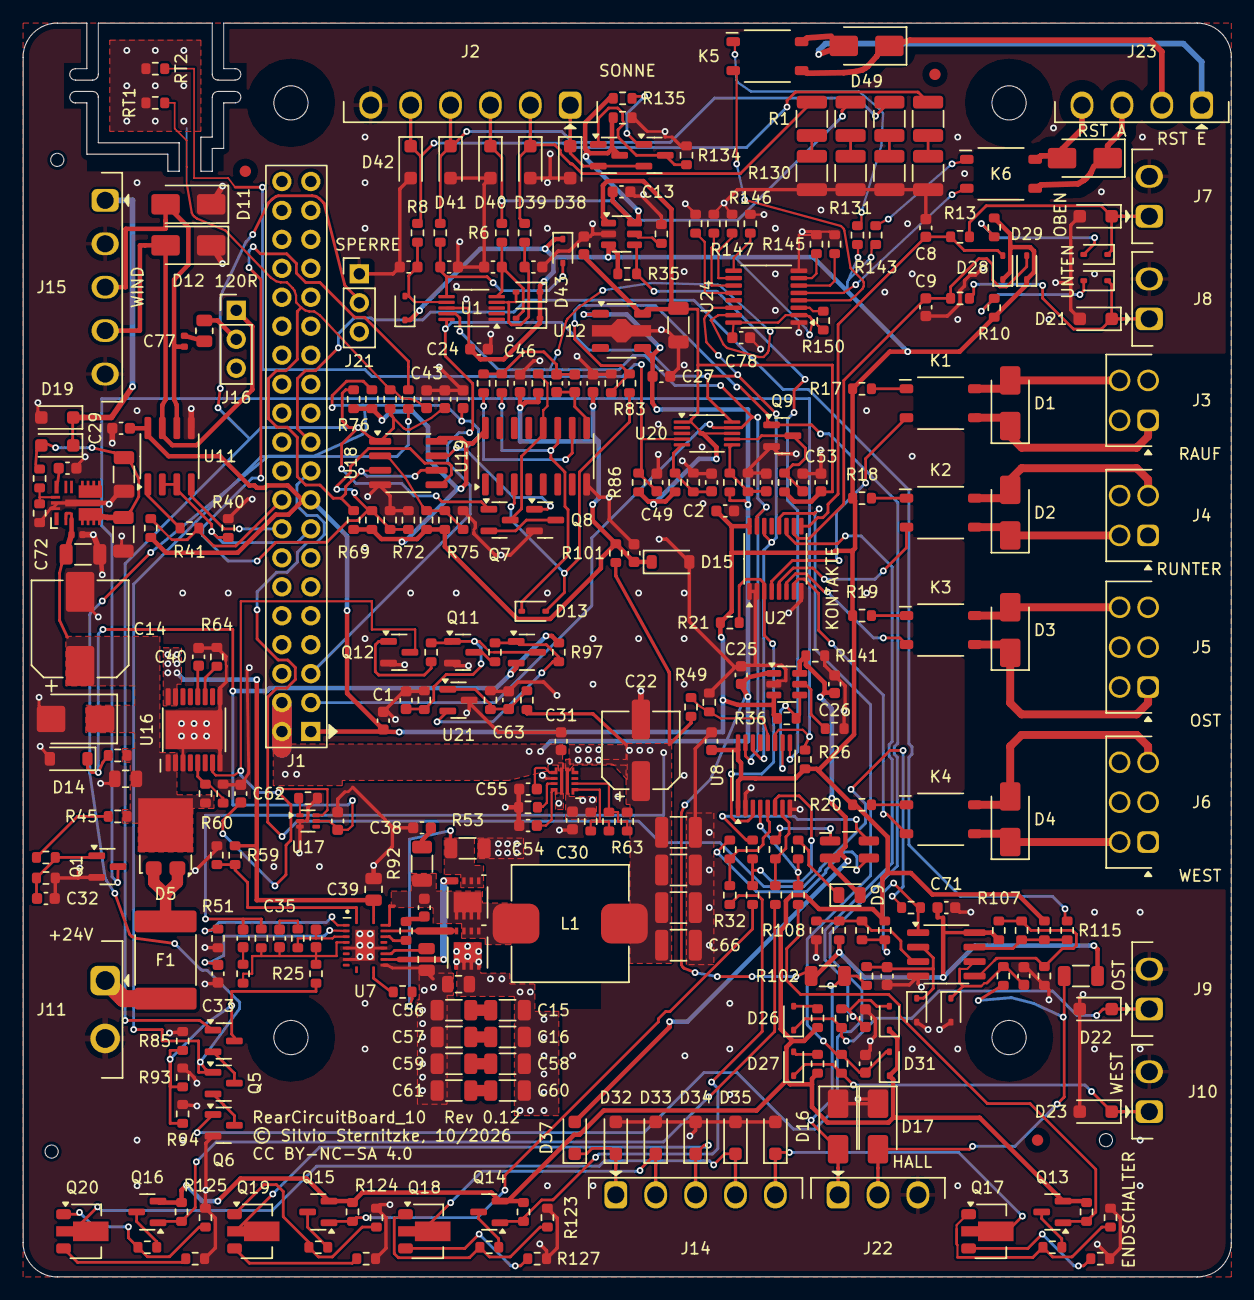
[picture p216: board RearCircuitBoard_10.kicad_pcb from above]

Board: 4 copper layers, 106.0 x 110.0 mm, 345 parts (1 on the bottom side), 188 nets.

Other parts of the board:
FID1, FID2, FID3: Passermarke_1mm
TH1, TH2, TH3: Werkzeugloch_1.152mm
