ssbingo/samba-solar-track/(commit log)

2026-10-22 Samba Solar Track: Nachbau der Steuerung (10,1-Zoll-Version), Stand Firmware 0.4.8
    [HallTapBoard-bom.csv, HallTapBoard-gehaeuse-deckel.step, HallTapBoard-gehaeuse-deckel.stl, HallTapBoard-gehaeuse-unterteil.step, HallTapBoard-gehaeuse-unterteil.stl, HallTapBoard.kicad_pcb, HallTapBoard.kicad_sch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]
2026-10-23 Rückgehäuse: 40 mm tief, Eckradius 4,5 mm, Bohrungen M2,5 3,2 mm, 6 × PG 11 unten
    [Passprobe_Kontur_ESP32-P4_10.1.3mf, Passprobe_Kontur_ESP32-P4_10.1.stl, Rueckgehaeuse_ESP32-P4_10.1.3mf, Rueckgehaeuse_ESP32-P4_10.1.stl]
2026-10-25 Passmodell der Platine RearCircuitBoard_10, Rundungen der Aussparung am Rückgehäuse
    - hardware/RearCircuitBoard_10/passprobe/: druckbares Passmodell der Platine samt Steckern
    - Rückgehäuse: Übergänge der seitlichen Aussparung als zwei Bögen R 4,5 mm
    - Handbuch (Anhang F) mit Hinweis auf das Passmodell
    [Passprobe_Kontur_ESP32-P4_10.1.3mf, Passprobe_Kontur_ESP32-P4_10.1.stl, RearCircuitBoard_10_Passmodell.3mf, RearCircuitBoard_10_Passmodell.stl, Rueckgehaeuse_ESP32-P4_10.1.3mf, Rueckgehaeuse_ESP32-P4_10.1.stl]
2026-10-26 Rückgehäuse: Druckprojekte für Creality Print (K2 Plus 0,4/0,6 mm, Hyper PETG-CF), Schlüssellöcher ohne Stützen
    - gehaeuse/: je eine 3MF für Düse 0,4 und 0,6 mm mit allen Einstellungen (5 Wände, 6/6 Schichten, Gyroid,
    Stützen nur vom Bett, Stützblocker in Senkungen und Schlüssellöchern)
    - Kopfkanal der Schlüssellöcher mit Dach 45°, druckt ohne Stützen
    - Handbuch nachgeführt
    [Rueckgehaeuse_ESP32-P4_10.1.3mf, Rueckgehaeuse_ESP32-P4_10.1.stl, Rueckgehaeuse_ESP32-P4_10.1_K2Plus_HyperPETG-CF_0.4mm.3mf, Rueckgehaeuse_ESP32-P4_10.1_K2Plus_HyperPETG-CF_0.6mm.3mf]
2026-10-28 Stand Release 0.5.0: Handbuch in sieben Sprachen, Rückgehäuse 40/50 mm, Abstandsbolzen
    - Handbuch zusätzlich auf Englisch, Französisch, Spanisch, Niederländisch, Portugiesisch und Polnisch
    (HTML und PDF, maschinell übersetzt, nicht von Muttersprachlern geprüft)
    - Rückgehäuse in 40 und 50 mm Tiefe samt Druckprojekten, Passproben je Tiefe
    - Stückliste: Abstandsbolzen M2,5 × 12 + 6 Messing (C50377852)
    [Rueckgehaeuse_ESP32-P4_10.1.3mf, Rueckgehaeuse_ESP32-P4_10.1.stl, Rueckgehaeuse_ESP32-P4_10.1_40mm.3mf, Rueckgehaeuse_ESP32-P4_10.1_40mm.stl, Rueckgehaeuse_ESP32-P4_10.1_40mm_K2Plus_HyperPETG-CF_0.4mm.3mf, Rueckgehaeuse_ESP32-P4_10.1_40mm_K2Plus_HyperPETG-CF_0.6mm.3mf, Rueckgehaeuse_ESP32-P4_10.1_50mm.3mf, Rueckgehaeuse_ESP32-P4_10.1_50mm.stl]
2026-10-28 Stand Release 0.5.2: Handbuch (Flachstellung vor dem Firmware-Update), Weboberfläche mit Sprachwahl und Akku, Rückgehäuse ohne Non-Manifold-Kanten
    [Rueckgehaeuse_ESP32-P4_10.1_40mm.3mf, Rueckgehaeuse_ESP32-P4_10.1_40mm.stl, Rueckgehaeuse_ESP32-P4_10.1_40mm_K2Plus_HyperPETG-CF_0.4mm.3mf, Rueckgehaeuse_ESP32-P4_10.1_40mm_K2Plus_HyperPETG-CF_0.6mm.3mf, Rueckgehaeuse_ESP32-P4_10.1_50mm.3mf, Rueckgehaeuse_ESP32-P4_10.1_50mm.stl, Rueckgehaeuse_ESP32-P4_10.1_50mm_K2Plus_HyperPETG-CF_0.4mm.3mf, Rueckgehaeuse_ESP32-P4_10.1_50mm_K2Plus_HyperPETG-CF_0.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]
2026-11-07 Stand Release 0.5.3 und Doku nach der Passprobe J8: RearCircuitBoard_10 Entwurf 0.11, Windsensoren an J15, Verkabelungshandbuch, Prüfung beim ersten Aufbau
    [RearCircuitBoard_10-bom.csv, RearCircuitBoard_10-selbst-bestellen-lcsc-2-platinen.csv, RearCircuitBoard_10-selbst-bestellen-lcsc-5-platinen.csv, RearCircuitBoard_10-selbst-bestellen.csv, RearCircuitBoard_10.kicad_pcb, RearCircuitBoard_10.kicad_sch, RearCircuitBoard_10_Passmodell.3mf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]
2026-11-10 Stand RearCircuitBoard_10 Entwurf 0.12 und Firmware 0.5.7: Reset-Ausgänge J23 für die Synchronsteuerung BST-KZQ-15A-2, Handbücher und Verkabelungshandbuch nachgeführt
    [RearCircuitBoard_10-bom.csv, RearCircuitBoard_10-selbst-bestellen-lcsc-2-platinen.csv, RearCircuitBoard_10-selbst-bestellen-lcsc-5-platinen.csv, RearCircuitBoard_10-selbst-bestellen.csv, RearCircuitBoard_10.kicad_pcb, RearCircuitBoard_10.kicad_sch, RearCircuitBoard_10_Passmodell.3mf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]
2026-11-10 Stand Firmware 0.5.9: Handbuch und Verkabelungshandbuch mit STEILER/FLACHER statt RAUF/RUNTER, Absatz Handbetrieb, Änderungsverlauf, Screenshots und PDFs neu
2026-11-10 Stand bf83fb9 (Firmware 0.6.0): Karte SONNENSENSOR erklaert, Skizze der Neigung, Winkel in der Karte NEIGUNG; Handbuch in 7 Sprachen, Screenshots, PDFs
2026-11-13 Stand doku-2026-11-13 (Firmware 0.7.8): Abgleich mit Montagehandbuch Rack 2-E Plus V3.1.2
    L2 zum HallTapBoard mit Sicherungsklemme UK 6-FSI/C-LED24 und Flachsicherung 1 A, Kasten 2 (E1b),
    Leitungsweg L6/L7 rechts, Erdung nach Kapitel 14; Handbuch in 7 Sprachen, Einstellungshandbuch,
    Verkabelungshandbuch, HallTapBoard 0.6 mit Gehäuse, Screenshots und PDFs.
    [HallTapBoard-bom.csv, HallTapBoard-gehaeuse-deckel.step, HallTapBoard-gehaeuse-deckel.stl, HallTapBoard-gehaeuse-deckel_K2Plus_HyperPETG-CF_0.4mm.3mf, HallTapBoard-gehaeuse-deckel_K2Plus_HyperPETG-CF_0.4mm_Schrift-zweifarbig.3mf, HallTapBoard-gehaeuse-unterteil.step, HallTapBoard-gehaeuse-unterteil.stl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]
