ssbingo/samba-solar-track/(notices)

Notices in the files:
handbuch/Samba-Solar-Track-Handbuch-10Zoll-FR.pdf:
12 Licence et copyright:
Vous pouvez reproduire Samba Solar Track pour vous-même. Personne ne peut gagner d'argent avec sans autorisation.
© Silvio Sternitzke, 10/2026. L'ensemble du projet – firmware, schéma, carte, dessins, logo et ce manuel – est placé sous la licence Creative Commons Attribution – Pas d'utilisation commerciale – Partage dans les mêmes conditions 4.0 International, en abrégé CC BY-NC-SA 4.0.
Permis
Reproduction à des
fins privées. Copier,
partager et modifier,
tant que ce n'est pas
commercial.
Conditions
Citer l'auteur et la
licence. Ne partager
les versions modifiées
que sous la même
GeoNames (geonames.org) | CC BY 4.0, mention «
On y trouve aussi ce qui ne relève pas de cette licence : les documents de Waveshare, les logiciels tiers chargés lors de la compilation, et, dans le firmware de la carte 10,1 pouces, la table d'initialisation de l'écran reprise de Waveshare (licence Apache 2.0, texte de licence dans LICENSES/Apach
handbuch/Samba-Solar-Track-Handbuch-10Zoll-NL.pdf:
© Silvio Sternitzke, 10/2026 · Licentie CC BY-NC-SA 4.0 · geen commercieel gebruik door derden
delbouwwinkel; (per meter); niet opgezocht (open); WAT; BRON; LICENTIE; WAAR; Natural Earth (naturalearthdata.com); LOCATIE; GeoNames (geonames.org); CC BY 4.0, naamsvermelding; „GeoNames“; Leaflet 1.9.4 (leafletjs.com); BSD-2-Clause; in de firmware, door; OpenStreetMap (openstreetmap.org), „© OpenS
publiek domein (public domain) in de firmware, pagina
© Silvio Sternitzke, 10/2026. Het hele project – firmware, schema, printplaat, tekeningen, logo en
deze handleiding – valt onder de licentie Creative Commons Naamsvermelding – Niet-
Commercieel – Gelijk Delen 4.0 Internationaal, kort CC BY-NC-SA 4.0.
Sinds firmware 0.7.0 bevat de firmware bovendien kaartgegevens van Natural Earth (publiek domein), plaatsnamen van GeoNames (CC BY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
© Silvio Sternitzke, 10/2026 · Licentie CC BY-NC-SA 4.0: geen commercieel gebruik door derden, nabouw voor privédoeleinden toegestaan (hoofdstuk 12).
hardware/RearCircuitBoard_10/RearCircuitBoard_10.kicad_pcb:
Lizenz CC BY-NC-SA 4.0: keine kommerzielle Verwendung, privater Nachbau erlaubt
